juppy10/HV_BMS/Documents/Testing.txt

HV BMS Testing
- Thermals:
    - Power supply
    - Balance circuit

- isoSPI performance:
   - Measure trace impedance

- thermistor measurement calibration
