juppy10/HV_BMS/Hardware/BMS_Slave/Project Outputs for BMS Slave V0.1/W339323ASF8 working gerber file/W339323ASF8 working gerber file/Transcode Report.txt

   ---- Transcoding 'D:\Will\Documents\GitHub\HV_BMS\Hardware\BMS_Slave\Project Outputs for BMS Slave V0.1\W339323ASF8 working gerber file\W339323ASF8 working gerber file\bl' ----   Thu Apr  7 17:14:59 2022

D10   --> D100
D11   --> D101
D12   --> D102
-----------------------------------------------------------------

   ---- Transcoding 'D:\Will\Documents\GitHub\HV_BMS\Hardware\BMS_Slave\Project Outputs for BMS Slave V0.1\W339323ASF8 working gerber file\W339323ASF8 working gerber file\bs' ----   Thu Apr  7 17:14:59 2022

D10   --> D103
D11   --> D104
D12   --> D105
D13   --> D106
D14   --> D107
D15   --> D108
D16   --> D109
D17   --> D110
-----------------------------------------------------------------

   ---- Transcoding 'D:\Will\Documents\GitHub\HV_BMS\Hardware\BMS_Slave\Project Outputs for BMS Slave V0.1\W339323ASF8 working gerber file\W339323ASF8 working gerber file\drl' ----   Thu Apr  7 17:14:59 2022

D10   --> D111
D11   --> D112
-----------------------------------------------------------------

   ---- Transcoding 'D:\Will\Documents\GitHub\HV_BMS\Hardware\BMS_Slave\Project Outputs for BMS Slave V0.1\W339323ASF8 working gerber file\W339323ASF8 working gerber file\ko' ----   Thu Apr  7 17:14:59 2022

D10   --> D113
D11   --> D114
-----------------------------------------------------------------

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
D29   --> D189
D30   --> D190
D31   --> D191
D32   --> D192
D33   --> D193
D34   --> D194
D35   --> D195
D36   --> D196
D37   --> D197
D38   --> D198
D39   --> D199
D40   --> D200
D41   --> D201
D42   --> D202
D43   --> D203
-----------------------------------------------------------------
