juppy10/HV_BMS/Documents/8S BMS LHS.png

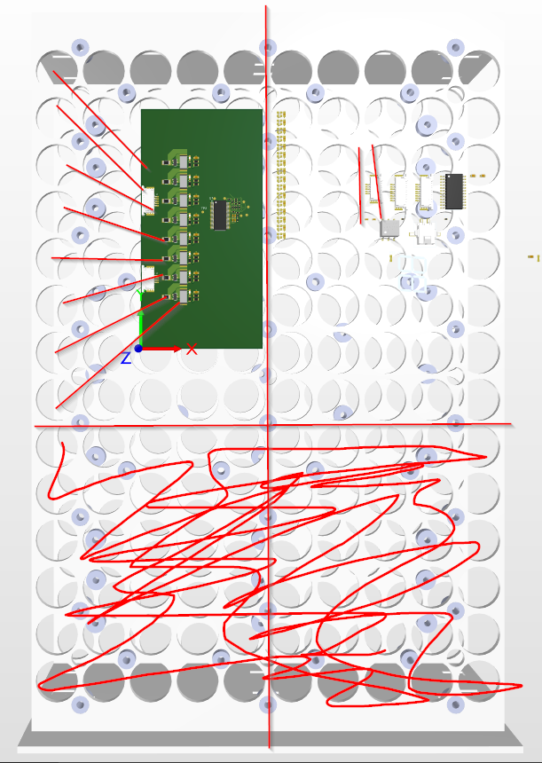
Documents/8S BMS LHS.png
