juppy10/HV_BMS/Documents/12S BMS.png

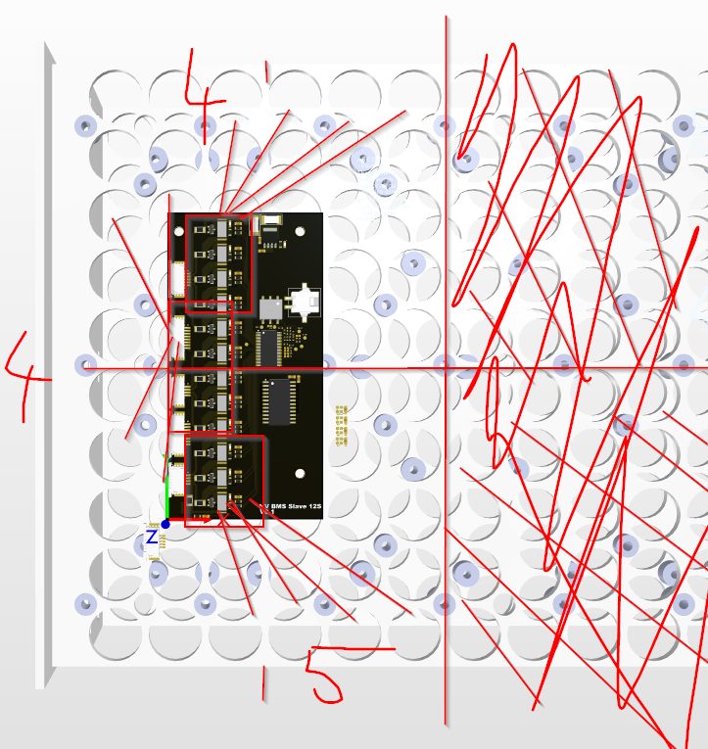
Documents/12S BMS.png
