juppy10/HV_BMS/Logging/2022-03-11 11_49_47-Logging – main.py.png

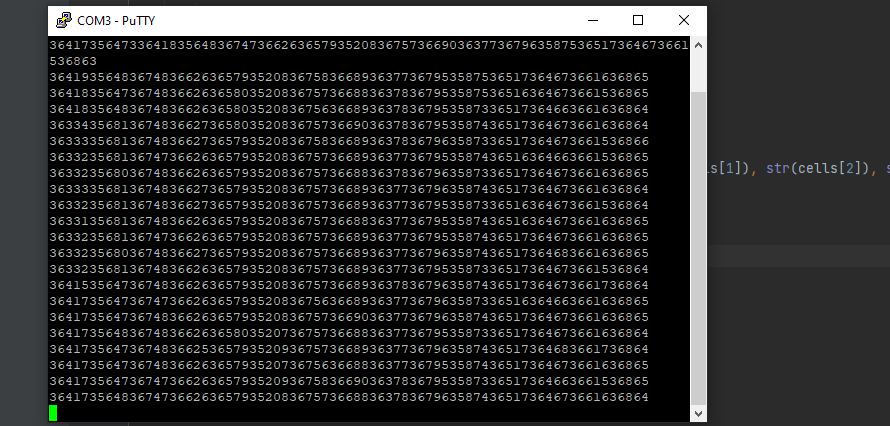
Logging/2022-03-11 11_49_47-Logging – main.py.png
