juppy10/HV_BMS/Bill of Materials - BMS Slave V0.1(Manufacture) - For AT&M.xlsx

Designator | Description | Footprint | Quantity | Value | Fitted | Mouser No | Mfr. No
C1, C11_Temperature Sensing 8S LHS, C11_Temperature Sensing 8S RHS, C14, C21, C28 | Multilayer Ceramic Capacitors MLCC - SMD/SMT .1UF 100V 10% 0402 | C_0402 | 6 | 100nF | Fitted | 81-GRM155R62A104KE4D | GRM155R62A104KE14D
C2, C5, C6, C12_Temperature Sensing 8S LHS, C12_Temperature Sensing 8S RHS, C15, C18, C19, C22, C25, C26, C29 | Multilayer Ceramic Capacitors MLCC - SMD/SMT 0402 16VDC 1uF 10% X5R | C_0402 | 12 | 1uF | Fitted | 963-EMK105BJ105KV-F | EMK105BJ105KV-F
C3, C4, C16, C17, C23, C24 | Multilayer Ceramic Capacitors MLCC - SMD/SMT .1UF 100V 10% 0402 | C_0402 | 0 | 100nF | Not Fitted | 81-GRM155R62A104KE4D | GRM155R62A104KE14D
C7, C8_Balance Circuit 8L1, C8_Balance Circuit 8L2, C8_Balance Circuit 8L3, C8_Balance Circuit 8L4, C8_Balance Circuit 8L5, C8_Balance Circuit 8L6, C8_Balance Circuit 8L7, C8_Balance Circuit 8L8, C8_Balance Circuit 8R1, C8_Balance Circuit 8R2, C8_Balance Circuit 8R3, C8_Balance Circuit 8R4, C8_Balance Circuit 8R5, C8_Balance Circuit 8R6, C8_Balance Circuit 8R7, C8_Balance Circuit 8R8, C8_Balance Circuit 121, C8_Balance Circuit 122, C8_Balance Circuit 123, C8_Balance Circuit 124, C8_Balance Circuit 125, C8_Balance Circuit 126, C8_Balance Circuit 127, C8_Balance Circuit 128, C8_Balance Circuit 129, C8_Balance Circuit 1210, C8_Balance Circuit 1211, C8_Balance Circuit 1212, C10_IsoSPI 8S LHS, C10_IsoSPI 8S RHS, C10_IsoSPI 12S, C13_NTC Sense 8S1, C13_NTC Sense 8S2, C13_NTC Sense 8S3, C13_NTC Sense 8S4, C13_NTC Sense 8S5, C13_NTC Sense 8S6, C13_NTC Sense 8S7, C13_NTC Sense 8S8, C13_NTC Sense 8S9, C13_NTC Sense 8S10, C13_NTC Sense 8S11, C13_NTC Sense 8S12, C13_NTC Sense 8S13, C13_NTC Sense 8S14, C13_NTC Sense 8S15, C13_NTC Sense 8S16, C13_NTC Sense 8S17, C13_NTC Sense 8S18, C13_NTC Sense 8S19, C13_NTC Sense 8S20, C13_NTC Sense 8S21, C13_NTC Sense 8S22, C13_NTC Sense 8S23, C13_NTC Sense 8S24, C13_NTC Sense 8S25, C13_NTC Sense 8S26, C13_NTC Sense 8S27, C13_NTC Sense 8S28, C13_NTC Sense 8S29, C13_NTC Sense 8S30, C13_NTC Sense 8S31, C13_NTC Sense 8S32, C13_NTC Sense 12S1, C13_NTC Sense 12S2, C13_NTC Sense 12S3, C13_NTC Sense 12S4, C13_NTC Sense 12S5, C13_NTC Sense 12S6, C13_NTC Sense 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 | Multilayer Ceramic Capacitors MLCC - SMD/SMT 0402 100V 0.01uF X7S 10% T: 0.5mm | C_0402 | 78 | 10nF | Fitted | 810-C1005X7S2A103K | C1005X7S2A103K050BB
C9_IsoSPI 8S LHS, C9_IsoSPI 8S RHS, C9_IsoSPI 12S | Multilayer Ceramic Capacitors MLCC - SMD/SMT WCAP-CSGP 15pF 0402 5% 16V MLCC | C_0402 | 3 | 15pF | Fitted | 710-885012005026 | 885012005026
D1, D3, D4 | Standard LEDs - SMD WL-SMCD SMD MonoChip 0603 Super Red 645nm | LED (0603) | 3 |  | Fitted | 710-150060SS55040 | 150060SS55040
D2_Balance Circuit 8L1, D2_Balance Circuit 8L2, D2_Balance Circuit 8L3, D2_Balance Circuit 8L4, D2_Balance Circuit 8L5, D2_Balance Circuit 8L6, D2_Balance Circuit 8L7, D2_Balance Circuit 8L8, D2_Balance Circuit 8R1, D2_Balance Circuit 8R2, D2_Balance Circuit 8R3, D2_Balance Circuit 8R4, D2_Balance Circuit 8R5, D2_Balance Circuit 8R6, D2_Balance Circuit 8R7, D2_Balance Circuit 8R8, D2_Balance Circuit 121, D2_Balance Circuit 122, D2_Balance Circuit 123, D2_Balance Circuit 124, D2_Balance Circuit 125, D2_Balance Circuit 126, D2_Balance Circuit 127, D2_Balance Circuit 128, D2_Balance Circuit 129, D2_Balance Circuit 1210, D2_Balance Circuit 1211, D2_Balance Circuit 1212 | Standard LEDs - SMD WL-SMCD SMD Mono SMD 0603 Blue 465nm | LED (0603) | 28 |  | Fitted | 710-150060BS55040 | 150060BS55040
F1, F2_Balance Circuit 8L1, F2_Balance Circuit 8L2, F2_Balance Circuit 8L3, F2_Balance Circuit 8L4, F2_Balance Circuit 8L5, F2_Balance Circuit 8L6, F2_Balance Circuit 8L7, F2_Balance Circuit 8L8, F2_Balance Circuit 8R1, F2_Balance Circuit 8R2, F2_Balance Circuit 8R3, F2_Balance Circuit 8R4, F2_Balance Circuit 8R5, F2_Balance Circuit 8R6, F2_Balance Circuit 8R7, F2_Balance Circuit 8R8, F2_Balance Circuit 121, F2_Balance Circuit 122, F2_Balance Circuit 123, F2_Balance Circuit 124, F2_Balance Circuit 125, F2_Balance Circuit 126, F2_Balance Circuit 127, F2_Balance Circuit 128, F2_Balance Circuit 129, F2_Balance Circuit 1210, F2_Balance Circuit 1211, F2_Balance Circuit 1212, F3, F4 | Surface Mount Fuses 63V .5A VFA Slimline | 0466.500NR | 31 |  | Fitted | 576-0466.500NR | 0466.500NR
J1, J2, J7, J8, J9, J10, J11, J12 | FFC & FPC Connectors 7P 1MM FPC Horz Top Cont. Assy | 84953-7 | 8 |  | Fitted | 571-84953-7 | 84953-7
J3 | Pin & Socket Connectors HDR ASSY 2 POS R/A SINGLE ROW TIN | TE_2-1445057-2 | 1 |  | Fitted | 571-2-1445057-2 | 2-1445057-2
J4_Temperature Sensing 8S LHS, J4_Temperature Sensing 8S RHS | FFC & FPC Connectors 1MM CONT ASSY 10P | 1-84953-0 | 2 |  | Fitted | 571-1-84953-0 | 1-84953-0
J5_Temperature Sensing 8S LHS, J5_Temperature Sensing 8S RHS | FFC & FPC Connectors 1MM CONT ASSY 8P HORIZONTAL TOP FPC | 84953-8 | 2 |  | Fitted | 571-84953-8 | 84953-8
Q1, Q3, Q4 | Bipolar Transistors - BJT NPN High Power BipolarTransistor | LFPAK56 (SOT669) | 3 |  | Fitted | 771-PHPT60603NY | PHPT60603NYX
Q2_Balance Circuit 8L1, Q2_Balance Circuit 8L2, Q2_Balance Circuit 8L3, Q2_Balance Circuit 8L4, Q2_Balance Circuit 8L5, Q2_Balance Circuit 8L6, Q2_Balance Circuit 8L7, Q2_Balance Circuit 8L8, Q2_Balance Circuit 8R1, Q2_Balance Circuit 8R2, Q2_Balance Circuit 8R3, Q2_Balance Circuit 8R4, Q2_Balance Circuit 8R5, Q2_Balance Circuit 8R6, Q2_Balance Circuit 8R7, Q2_Balance Circuit 8R8, Q2_Balance Circuit 121, Q2_Balance Circuit 122, Q2_Balance Circuit 123, Q2_Balance Circuit 124, Q2_Balance Circuit 125, Q2_Balance Circuit 126, Q2_Balance Circuit 127, Q2_Balance Circuit 128, Q2_Balance Circuit 129, Q2_Balance Circuit 1210, Q2_Balance Circuit 1211, Q2_Balance Circuit 1212 | MOSFET 20V P-channel Trench MOSFET | SOT95P230X110-3N | 28 |  | Fitted | 771-PMV65XPER | PMV65XPER
R1, R3, R27, R29, R45, R47 | Current Sense Resistors - SMD CHIP RESISTOR Low Value | R_2010 | 6 | 100 | Fitted | 652-CRM2010FX1000ELF | CRM2010-FX-1000ELF
R2, R28, R46 | Thick Film Resistors - SMD 1 MOhms 62.5mW 0402 5% | R_0402 | 3 | 1M | Fitted | 603-RC0402JR-071ML | RC0402JR-071ML
R4, R22_Balance Circuit 8L1, R22_Balance Circuit 8L2, R22_Balance Circuit 8L3, R22_Balance Circuit 8L4, R22_Balance Circuit 8L5, R22_Balance Circuit 8L6, R22_Balance Circuit 8L7, R22_Balance Circuit 8L8, R22_Balance Circuit 8R1, R22_Balance Circuit 8R2, R22_Balance Circuit 8R3, R22_Balance Circuit 8R4, R22_Balance Circuit 8R5, R22_Balance Circuit 8R6, R22_Balance Circuit 8R7, R22_Balance Circuit 8R8, R22_Balance Circuit 121, R22_Balance Circuit 122, R22_Balance Circuit 123, R22_Balance Circuit 124, R22_Balance Circuit 125, R22_Balance Circuit 126, R22_Balance Circuit 127, R22_Balance Circuit 128, R22_Balance Circuit 129, R22_Balance Circuit 1210, R22_Balance Circuit 1211, R22_Balance Circuit 1212, R30, R48 | Thick Film Resistors - SMD 1 kOhms 62.5mW 0402 1% | R_0402 | 31 | 1k | Fitted | 603-RC0402FR-071KL | RC0402FR-071KL
R5, R18, R31, R44, R49, R62 | Thick Film Resistors - SMD Zero Ohm 5% | R_0402 | 6 | 0 | Fitted | 652-CR0402-J/-000GLF | CR0402-J/-000GLF
R6, R10, R11, R12, R13, R14, R15, R16, R17, R32, R36, R37, R38, R39, R40, R41, R42, R43, R50, R54, R55, R56, R57, R58, R59, R60, R61 | Thick Film Resistors - SMD Zero Ohm 5% | R_0402 | 0 | 0 | Not Fitted | 652-CR0402-J/-000GLF | CR0402-J/-000GLF
R7, R33, R51 | Thick Film Resistors - SMD 1.21K OHM 1% | R_0402 | 3 | 1.21k | Fitted | 652-CR0402FX-1211GLF | CR0402-FX-1211GLF
R8, R34, R52 | Thick Film Resistors - SMD 2.8 kOhms 100 mW 0603 1% | R_0402 | 3 | 2.8k | Fitted | 603-RC0603FR-072K8L | RC0603FR-072K8L
R9, R19_Balance Circuit 8L1, R19_Balance Circuit 8L2, R19_Balance Circuit 8L3, R19_Balance Circuit 8L4, R19_Balance Circuit 8L5, R19_Balance Circuit 8L6, R19_Balance Circuit 8L7, R19_Balance Circuit 8L8, R19_Balance Circuit 8R1, R19_Balance Circuit 8R2, R19_Balance Circuit 8R3, R19_Balance Circuit 8R4, R19_Balance Circuit 8R5, R19_Balance Circuit 8R6, R19_Balance Circuit 8R7, R19_Balance Circuit 8R8, R19_Balance Circuit 121, R19_Balance Circuit 122, R19_Balance Circuit 123, R19_Balance Circuit 124, R19_Balance Circuit 125, R19_Balance Circuit 126, R19_Balance Circuit 127, R19_Balance Circuit 128, R19_Balance Circuit 129, R19_Balance Circuit 1210, R19_Balance Circuit 1211, R19_Balance Circuit 1212, R26_NTC Sense 8S1, R26_NTC Sense 8S2, R26_NTC Sense 8S3, R26_NTC Sense 8S4, R26_NTC Sense 8S5, R26_NTC Sense 8S6, R26_NTC Sense 8S7, R26_NTC Sense 8S8, R26_NTC Sense 8S9, R26_NTC Sense 8S10, R26_NTC Sense 8S11, R26_NTC Sense 8S12, R26_NTC Sense 8S13, R26_NTC Sense 8S14, R26_NTC Sense 8S15, R26_NTC Sense 8S16, R26_NTC Sense 8S17, R26_NTC Sense 8S18, R26_NTC Sense 8S19, R26_NTC Sense 8S20, R26_NTC Sense 8S21, R26_NTC Sense 8S22, R26_NTC Sense 8S23, R26_NTC Sense 8S24, R26_NTC Sense 8S25, R26_NTC Sense 8S26, R26_NTC Sense 8S27, R26_NTC Sense 8S28, R26_NTC Sense 8S29, R26_NTC Sense 8S30, R26_NTC Sense 8S31, R26_NTC Sense 8S32, R26_NTC Sense 12S1, R26_NTC Sense 12S2, R26_NTC Sense 12S3, R26_NTC Sense 12S4, R26_NTC Sense 12S5, R26_NTC Sense 12S6, R26_NTC Sense 12S7, R26_NTC Sense 12S8, 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 | Thick Film Resistors - SMD 100 Ohms 62.5mW 0402 1% | R_0402 | 76 | 100 | Fitted | 603-RC0402FR-07100RL | RC0402FR-07100RL
R20_Balance Circuit 8L1, R20_Balance Circuit 8L2, R20_Balance Circuit 8L3, R20_Balance Circuit 8L4, R20_Balance Circuit 8L5, R20_Balance Circuit 8L6, R20_Balance Circuit 8L7, R20_Balance Circuit 8L8, R20_Balance Circuit 8R1, R20_Balance Circuit 8R2, R20_Balance Circuit 8R3, R20_Balance Circuit 8R4, R20_Balance Circuit 8R5, R20_Balance Circuit 8R6, R20_Balance Circuit 8R7, R20_Balance Circuit 8R8, R20_Balance Circuit 121, R20_Balance Circuit 122, R20_Balance Circuit 123, R20_Balance Circuit 124, R20_Balance Circuit 125, R20_Balance Circuit 126, R20_Balance Circuit 127, R20_Balance Circuit 128, R20_Balance Circuit 129, R20_Balance Circuit 1210, R20_Balance Circuit 1211, R20_Balance Circuit 1212 | Thick Film Resistors - SMD 3.3 kOhms 62.5 mW 0402 1% AEC-Q200 | R_0402 | 28 | 3.3k | Fitted | 603-AC0402FR-073K3L | AC0402FR-073K3L
R21_Balance Circuit 8L1, R21_Balance Circuit 8L2, R21_Balance Circuit 8L3, R21_Balance Circuit 8L4, R21_Balance Circuit 8L5, R21_Balance Circuit 8L6, R21_Balance Circuit 8L7, R21_Balance Circuit 8L8, R21_Balance Circuit 8R1, R21_Balance Circuit 8R2, R21_Balance Circuit 8R3, R21_Balance Circuit 8R4, R21_Balance Circuit 8R5, R21_Balance Circuit 8R6, R21_Balance Circuit 8R7, R21_Balance Circuit 8R8, R21_Balance Circuit 121, R21_Balance Circuit 122, R21_Balance Circuit 123, R21_Balance Circuit 124, R21_Balance Circuit 125, R21_Balance Circuit 126, R21_Balance Circuit 127, R21_Balance Circuit 128, R21_Balance Circuit 129, R21_Balance Circuit 1210, R21_Balance Circuit 1211, R21_Balance Circuit 1212 | Current Sense Resistors - SMD 2watts 5% 22ohms 200 PPM 2512 | R_2512 | 28 | 21 | Fitted | 652-CRM2512-JW220ELF | CRM2512-JW-220ELF
R23_IsoSPI 8S LHS, R23_IsoSPI 8S RHS, R23_IsoSPI 12S, R64_IsoSPI 8S LHS, R64_IsoSPI 8S RHS, R64_IsoSPI 12S | Thick Film Resistors - SMD 22 Ohms 62.5 mW 0402 5% | R_0402 | 6 | 22 | Fitted | 603-RC0402JR-1322RL | RC0402JR-1322RL
R24_IsoSPI 8S LHS, R24_IsoSPI 8S RHS, R24_IsoSPI 12S | Thick Film Resistors - SMD 1/16watt 402ohms 1% Commercial Use | R_0402 | 3 | 402 | Fitted | 71-CRCW0402402RFKEDC | CRCW0402402RFKEDC
R25_NTC Sense 8S1, R25_NTC Sense 8S2, R25_NTC Sense 8S3, R25_NTC Sense 8S4, R25_NTC Sense 8S5, R25_NTC Sense 8S6, R25_NTC Sense 8S7, R25_NTC Sense 8S8, R25_NTC Sense 8S9, R25_NTC Sense 8S10, R25_NTC Sense 8S11, R25_NTC Sense 8S12, R25_NTC Sense 8S13, R25_NTC Sense 8S14, R25_NTC Sense 8S15, R25_NTC Sense 8S16, R25_NTC Sense 8S17, R25_NTC Sense 8S18, R25_NTC Sense 8S19, R25_NTC Sense 8S20, R25_NTC Sense 8S21, R25_NTC Sense 8S22, R25_NTC Sense 8S23, R25_NTC Sense 8S24, R25_NTC Sense 8S25, R25_NTC Sense 8S26, R25_NTC Sense 8S27, R25_NTC Sense 8S28, R25_NTC Sense 8S29, R25_NTC Sense 8S30, R25_NTC Sense 8S31, R25_NTC Sense 8S32, R25_NTC Sense 12S1, R25_NTC Sense 12S2, R25_NTC Sense 12S3, R25_NTC Sense 12S4, R25_NTC Sense 12S5, R25_NTC Sense 12S6, R25_NTC Sense 12S7, R25_NTC Sense 12S8, R25_NTC Sense 12S9, R25_NTC Sense 12S10, R25_NTC Sense 12S11, R25_NTC Sense 12S12 | Thick Film Resistors - SMD 10 kOhms 62.5 mW 0402 1% | R_0402 | 44 | 10k | Fitted | 603-RC0402FR-1310KL | RC0402FR-1310KL
R63 | Thick Film Resistors - SMD 1/10watt 51ohms 5% | R_0402 | 1 | 51 | Not Fitted | 71-CRCW060351R0JNEB | CRCW060351R0JNEB
T1_IsoSPI 8S LHS, T1_IsoSPI 8S RHS, T1_IsoSPI 12S | Audio Transformers / Signal Transformers BMS xformer 1-Ch 1000V AECQ +125 C | SM91502ALE | 3 |  | Fitted | 652-SM91502ALE | SM91502ALE
U1, U3, U4 |  | SSOP50P780X200-48N | 3 |  | Not Fitted |  | LTC6811-2
U2_Temperature Sensing 8S LHS, U2_Temperature Sensing 8S RHS, U5 | Multiplexer Switch ICs Hi-Spd CMOS 16Ch Anl Mltplxr/Demltplxr | SOIC127P1030X265-24N | 3 |  | Fitted | 595-CD74HC4067M96 | CD74HC4067M96
