juppy10/HV_BMS/Hardware/Accumulator Management System/Accumulator_MGMT_Sys-BOM.xlsx

BMS Master (AMS) V0.1 BOM
Part Number | Description | Designator | Footprint | Quantity
06035C103KAT4A | Capacitor | C1, C2 | C_0603 | 2
C0603C104K3RAC7013 | Capacitor | C3, C4, C5, C6, C7, C8, C9, C11, C13, C14, C16, C17, C28, C29, C32, C34, C35, C37, C38, C39, C40, C42_Vbat-3V31, C42_Vbat-3V32, C42_Vbat-3V33, C43_Latch Circuit1, C43_Latch Circuit2, C43_Latch Circuit3, C43_Latch Circuit4, C44_Latch Circuit1, C44_Latch Circuit2, C44_Latch Circuit3, C44_Latch Circuit4, C48 | C_0603 | 33
CL10A475KP8NNNL | Capacitor | C10 | C_0603 | 1
GCM1555C1H120FA16D | Capacitor | C12, C15 | 0402 | 2
CL10A105KP8NNNL | Capacitor | C18, C46 | C_0603 | 2
CL10A225KP8NNNC | Capacitor | C19, C36, C45, C47, C49 | C_0603 | 5
C0603C104K3RAC7013 | Capacitor | C20, C21, C22, C23, C24, C25, C26, C27, C30 | CAP0603 | 9
C0603C104K3RAC7013 | Capacitor | C31, C33 | 0402 | 2
885012206074 | Capacitor | C41_Vbat-3V31, C41_Vbat-3V32, C41_Vbat-3V33 | C_0603 | 3
150060BS55040 | LED BLUE DIFFUSED 0603 SMD | D1 | LED (0603) | 1
1N4148 | DIODE GEN PURP 100V 300MA SOD123 | D2, D7_Latch Circuit1, D7_Latch Circuit2, D7_Latch Circuit3, D7_Latch Circuit4 | 425 | 5
150060SS55040 | LED RED DIFFUSED 0603 SMD | D3, D8_Latch Circuit1, D8_Latch Circuit2, D8_Latch Circuit3, D8_Latch Circuit4 | LED (0603) | 5
SZNUP3105LT3G | TVS DIODE 32V 66V SOT23-3 | D4, D5 | FP-318-08-MFG | 2
150060GS55040 | LED GREEN DIFFUSED 0603 SMD | D6_Vbat-3V31, D6_Vbat-3V32, D6_Vbat-3V33 | LED (0603) | 3
74LVC1G373DBVRE4 | Integrated Circuit | IC1_Latch Circuit1, IC1_Latch Circuit2, IC1_Latch Circuit3, IC1_Latch Circuit4 | SN74LVC1G373 | 4
3-794632-2 | Micro MATE-N-LOK, Rectangular Power Connectors, Header, Plug, Wire-to-Board, 2 Position | J1 | 3-794632-2 | 1
UX60SC-MB-5ST(80) | Mini-B Connector, SMT Mount Receptacle Meeting Requirement of USB 2.0 Standard, 5 V, 1 A, -30 to 75 degC, 5-Pin SMD, RoHS, Tape and Reel | J2 | HIRO-UX60SC-MB-5ST(80)_V | 1
3-794632-4 | Conn Power HDR 4 POS 3mm Solder ST Thru-Hole 4 Terminal 1 Port Box/Tray | J3, J4, J5 | 3-794632-4 | 3
PCN-112D3MHZ | Relay | K1_Latch Circuit1, K1_Latch Circuit2, K1_Latch Circuit3, K1_Latch Circuit4 | PCN-112D3MHZ | 4
4-794632-0 | Connector | P3, P5 | SHDR10W82P300_2X5_1586X686X944P | 2
4-794632-4 | Micro MATE-N-LOK, Rectangular Power Connectors, Header, Plug, Wire-to-Board, 14 Position | P69 | 4-794632-4 | 1
BSS138BK,215 | N-Channel Trench MOSFET, 60 V, 0.36 A, -55 to 150 degC, 3-Pin SOT23, Tape and Reel | Q1, Q2_Latch Circuit1, Q2_Latch Circuit2, Q2_Latch Circuit3, Q2_Latch Circuit4, Q3_Latch Circuit1, Q3_Latch Circuit2, Q3_Latch Circuit3, Q3_Latch Circuit4, Q4_Latch Circuit1, Q4_Latch Circuit2, Q4_Latch Circuit3, Q4_Latch Circuit4 | NXP-SOT23_N | 13
CRCW060351R0JNEA | Resistor | R1, R2 | R-0603 | 2
RC0603FR-072K8L | Resistor | R3 | R-0603 | 1
AC0603FR-071K21L | Resistor | R4 | R-0603 | 1
AC0603JR-100RL | Resistor | R5, R6, R41 | R-0603 | 3
CR0603AFX-5101EAS | Resistor | R7, R9, R11, R13 | R-0603 | 4
CR0603AFX-1001ELF | Resistor | R8, R10, R12, R14, R18, R50_Vbat-3V31, R50_Vbat-3V32, R50_Vbat-3V33, R55_Latch Circuit1, R55_Latch Circuit2, R55_Latch Circuit3, R55_Latch Circuit4 | R-0603 | 12
RC0603FR-1310KL | Resistor | R15, R16, R29, R31, R32, R33, R34, R35, R36, R37, R38, R42, R43, R44, R49, R51_Latch Circuit1, R51_Latch Circuit2, R51_Latch Circuit3, R51_Latch Circuit4, R53_Latch Circuit1, R53_Latch Circuit2, R53_Latch Circuit3, R53_Latch Circuit4, R54_Latch Circuit1, R54_Latch Circuit2, R54_Latch Circuit3, R54_Latch Circuit4 | R-0603 | 27
RN73C1J7K15BTDF | Resistor | R19 | RESC1608X55N | 1
RC0603FR-1310KL | Resistor | R20, R21, R22, R23, R26 | RESC1608X55N | 5
CR0603AFX-5101EAS | Resistor | R24 | RESC1608X55N | 1
CRCW0603-220K-E3 | Resistor | R25 | RESC1608X55N | 1
CRCW060336K5FKEAC | Resistor | R27 | RESC1608X55N | 1
RC0603FR-071K78L | Resistor | R28 | R-0603 | 1
CR0603-FX-4220ELF | Resistor | R30 | R-0603 | 1
CRT0402-DY-1001GLF | Resistor | R39, R40 | R_0402 | 2
CRCW080560R4FKEA | Resistor | R45, R46, R47, R48 | R-0603 | 4
RC0805JR-07510RL | Resistor | R52_Latch Circuit1, R52_Latch Circuit2, R52_Latch Circuit3, R52_Latch Circuit4 | R_0805 | 4
CRCW2512649RFKEG | Resistor | R56_Latch Circuit1, R56_Latch Circuit2, R56_Latch Circuit3, R56_Latch Circuit4 | RESC6332X06N | 4
Resistor | Resistor | R57 | R-0603 | 1
SM91502ALE | BMS XFORMER 1-CH 1000V AECQ +125 | T1 | SM91502ALE | 1
LTC6820HMS#PBF | IC COMM INTERFACE ISOSPI 16MSOP | U1 | MSOP-16_MS | 1
USBLC6-2SC6 | TVS DIODE 5.25V 17V SOT23-6 | U2 | USBLC6-2SC6 | 1
STM32F446RE | 32 Bit Microcontroller, High Performance, ARM Cortex-M4, 180 MHz, 256 KB, 128 KB, 64, LQFP | U3 | QFP50P1200X1200X160-64N | 1
SN65LVDT2DBVT | IC RECEIVER 0/1 SOT23-5 | U4 | FP-DBV0005A-MFG | 1
MCP6542-I/SN | Push-Pull Output Sub-Microamp Comparator, 8-Pin SOIC, Industrial Temperature | U5 | SOIC-SN8_N | 1
SN74LVC1G08MDBVREP | Integrated Circuit | U6 | SOT95P280X145-5N | 1
NC7SZ00M5X | NAND GATE | U7 | SOT95P280X125-5N | 1
NC7S32M5X | OR GATE | U8, U17_Latch Circuit1, U17_Latch Circuit2, U17_Latch Circuit3, U17_Latch Circuit4 | SOT95P275X110-5N | 5
MAX810STRG | Integrated Circuit | U9 | SOT96P237X111-3N | 1
TLC3704QDRG4Q1 | IC VOLT COMPARATOR QUAD 14-SOIC | U10 | SOIC127P600X175-14N | 1
SN74HC7032D | Quadruple Positive-OR Gates With Schmitt-Trigger Inputs, D0014A, TUBE | U11 | D0014A_L | 1
LT1461ACS8-3 | Integrated Circuit | U12 | SO-8_S | 1
ADC122S625CIMM/NOPB | Analog to Digital Converters - ADC Dual 50kSPS-200kSPS 12B ADC | U13 | TSSOP50P490X110-10N | 1
SN65HVD233D | 3.3V CAN Transceiver with Standby Mode, Loop-back, 6 mA, -40 to 125 degC, 8-pin SOIC (D), Green (RoHS & no Sb/Br) | U14, U15 | D0008A_N | 2
ZSR330GTA | Standard Regulator Pos 3.3V 0.2A 4-Pin(3+Tab) SOT-223 T/R | U16_Vbat-3V31, U16_Vbat-3V32, U16_Vbat-3V33 | ZSR330GTA | 3
BD33C0AHFP-CTR | LDO Voltage Regulators 35V RESIS 1A LDO REGULATOR | U18 | HRP5 | 1
CX2016DB26000D0FLJCC | Resistor | Y1 | CX2016DB26000D0FLJCC | 1
