juppy10/HV_BMS/Hardware/Accumulator Management System/AMS BOM.xlsx

Sheet: Chad Mouser
Designation | Part Number | Desciption | Amount | Supplier | Notes | Link
U1 | LD2981CU50TR | 5V 100mA voltage regulator | 1 | STM |  | https://au.mouser.com/ProductDetail/STMicroelectronics/LD2981CU50TR/
U2 | ADM3054 | Isolated CAN Bus | 1 | Analog Device |  | https://au.mouser.com/ProductDetail/Analog-Devices/ADM3054WBRWZ-RL7/?qs=hpwIUhX6lWyxOIONWK5kPg%3D%3D
U3 | EC4A02HS | Isolated 12V power Supply | 1 | Cincon |  | https://au.mouser.com/ProductDetail/Cincon/EC4A02HS-E/
U4 | LDS3985M33R | 3.3V 300mA voltage regulator | 1 | STM |  | https://au.mouser.com/ProductDetail/STMicroelectronics/LDS3985M33R/?qs=DcAdhm6iCnom47SfkNYeVw%3D%3D
U5 | STM32F105R8T6 | Micro Controller Boi | 1 | STM | On Order RIP | STM32F105R8T6 STMicroelectronics | Mouser Australia (https://au.mouser.com/ProductDetail/STMicroelectronics/STM32F105R8T6/?qs=1XJIe8X6XT24MwoK4mjh%2Fg%3D%3D)
U6 | SN65HVD233D | CAN Bus | 1 | Texas Instr | Expected 8/2/21 | https://au.mouser.com/ProductDetail/Texas-Instruments/SN65HVD233D/?qs=QViXGNcIEAs7Wm0sxTzQdQ%3D%3D
U7 | SN65LVDT2 | Low Voltage Differential Signal Receiver | 1 | Texas Instr |  | https://au.mouser.com/ProductDetail/Texas-Instruments/SN65LVDT2DBVR/
U8 | MCP6542-I/SN | Op-Amp | 1 | Microchip Tech |  | https://au.mouser.com/ProductDetail/Microchip-Technology/MCP6542-I-SN/?qs=wPbeaPfwU9%2FerIyOzLws1A%3D%3D
U9 | NC7S02M5X | NOR gate | 1 | ON Semicon |  | https://au.mouser.com/ProductDetail/ON-Semiconductor-Fairchild/NC7S02M5X/
U10 | NC7SZ00M5X | NAND Gate | 1 | ON Semicon |  | https://au.mouser.com/ProductDetail/ON-Semiconductor-Fairchild/NC7SZ00M5X/
U11/U12 | NC7S32M5X | OR Gate | 2 | ON Semicon |  | https://au.mouser.com/ProductDetail/ON-Semiconductor-Fairchild/NC7S32M5X/
U13 | SN74LVC32ADR | 4 Channel 2 Input OR Gate | 1 | Texas Instr |  | https://au.mouser.com/ProductDetail/Texas-Instruments/SN74LVC32ADR/?qs=NLW4NjXEBS7KFLqI%2FYoHOA%3D%3D
U19 | SN74HC7032D | 4 Channel 2 Input OR Gate w/ Schmitt | 1 | Texas Instr |  | https://au.mouser.com/ProductDetail/Texas-Instruments/SN74HC7032D/?qs=0le1rQK8zxqllE59uuKGIA%3D%3D
U14/U15 | CD74HC75M96 | Latching Boi | 2 | Texas Instr |  | https://au.mouser.com/ProductDetail/Texas-Instruments/CD74HC75M96/?qs=xFfolx0DHx0kPXrLnxAsXQ%3D%3D
U16 | SN74HCS21QDRQ1 | 4 Channel 2 Input AND Gate | 1 | Texas Instr |  | https://au.mouser.com/ProductDetail/Texas-Instruments/SN74HCS21QDRQ1/
U17 | MAX810STRG | Voltage Supervisor | 1 | ON Semicon |  | https://au.mouser.com/ProductDetail/ON-Semiconductor/MAX810STRG/?qs=3JMERSakeboivPwVvtOnqA%3D%3D
U18 | TLC3704QDRG4Q1 | 4 Channel Comparithor | 1 | Texas Instr |  | https://au.mouser.com/ProductDetail/Texas-Instruments/TLC3704QDRG4Q1/?qs=pZC5fsuWujGhd9C3ekhqyg%3D%3D
C1 | C0603C105K3PACTU | 1uF | 2 | Kemet |  | https://au.mouser.com/ProductDetail/KEMET/C0603C105K3PACTU/?qs=STjISULpmtalQKXy67%252B4Cg%3D%3D
C2 | GRM188R61E475KE11D | 4.7uF | 3 | Murata |  | https://au.mouser.com/ProductDetail/Murata-Electronics/GRM188R61E475KE11D/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
C4 | GRM188R71E474KA12J | 0.47uF | 3 | Murata |  | https://au.mouser.com/ProductDetail/Murata-Electronics/GRM188R71E474KA12J/?qs=F8tACvfZmvjUv2vuW4F4kA%3D%3D
C7 | C0603C104K3RAC7081 | 0.1uF | 21 | Kemet |  | https://au.mouser.com/ProductDetail/KEMET/C0603C104K3RAC7081/
C12 | C0603C150K5RAC7867 | 15pF | 2 | Kemet |  | https://au.mouser.com/ProductDetail/KEMET/C0603C150K5RAC7867/?qs=u16ybLDytRYyS%252BK6zP9D6g%3D%3D
R1 | CRCW080560R4FKEA | 60.4R | 4 | Vishay |  | https://au.mouser.com/ProductDetail/Vishay-Dale/CRCW080560R4FKEA/?qs=EhwKGB4UJfmgIuuxZMLDtw%3D%3D
R3 | CRCW0805680RFKEA | 680R | 3 | Vishay |  | https://au.mouser.com/ProductDetail/Vishay-Dale/CRCW0805680RFKEA/?qs=QtIOgScU7%252BuxOLKfMWa%2F2g%3D%3D
R4 | CRCW060310K0FKEA | 10K | 8 | Vishay |  | https://au.mouser.com/ProductDetail/Vishay-Dale/CRCW060310K0FKEA/?qs=pAO1Z172M84BVnhDjtnsoQ%3D%3D
R10 | CRCW06033K24FKEA | 3.24K | 1 | Vishay |  | https://au.mouser.com/ProductDetail/Vishay-Dale/CRCW06033K24FKEA/?qs=N2XN0KY4UWXLwGUF6QHgWQ%3D%3D
R14 | CRCW0603220KFKEA | 220k | 1 | Vishay |  | https://au.mouser.com/ProductDetail/Vishay-Dale/CRCW0603220KFKEA/?qs=pVi9qluBdEGy7pbAV1jqkQ%3D%3D
R15 | CRCW060336K5FKEA | 36.5K | 2 | Vishay |  | https://au.mouser.com/ProductDetail/Vishay-Dale/CRCW060336K5FKEA/?qs=Q5Ogy3HFkM1EBinAZLgMDQ%3D%3D
R17 | CRCW06038K06FKEA | 8.06k | 2 | Vishay |  | https://au.mouser.com/ProductDetail/Vishay-Dale/CRCW06038K06FKEA/?qs=MdlGoGBrZVkh0qPQeABdqA%3D%3D
R18 | CRCW06031K91FKEA | 1.91k | 2 | Vishay |  | https://au.mouser.com/ProductDetail/Vishay-Dale/CRCW06031K91FKEA/
R23 | CRCW2512649RFKEG | 649R | 8 | Vishay |  | https://au.mouser.com/ProductDetail/Vishay-Dale/CRCW2512649RFKEG/?qs=WpL82mpZNv%2FAFRgdjHDmGQ%3D%3D
R25 | CRCW1206191RFKEA | 191R | 1 | Vishay |  | https://au.mouser.com/ProductDetail/Vishay-Dale/CRCW1206191RFKEA/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
R33 | CRCW08051K58FKEA | 1.58k | 4 | Vishay |  | https://au.mouser.com/ProductDetail/Vishay-Dale/CRCW08051K58FKEA/
P1 | 2-1445093-6 | 6 Pin Connector | 1 | TE Con |  | https://au.mouser.com/ProductDetail/TE-Connectivity-AMP/2-1445093-6/
P2 | 4-794632-0 | 10 Pin Connector | 3 | TE Con |  | https://au.mouser.com/ProductDetail/TE-Connectivity-AMP/4-794632-0/
P5 | FTSH-105-01-F-DV-K | Debug Port | 1 | SamTec |  | https://au.mouser.com/ProductDetail/Samtec/FTSH-105-01-F-DV-K/?qs=iT52DjcXudtFjikTq7rIdg%3D%3D
D1 | ESDCAN03-2BWY | ESDCAN03-2BWY | 2 | STM |  | https://au.mouser.com/ProductDetail/STMicroelectronics/ESDCAN03-2BWY/
D2 | 150080GS75000 | Green LED | 2 | Wurth |  | https://au.mouser.com/ProductDetail/Wurth-Elektronik/150080GS75000/
D3 | 150080RS75000 | Red LED | 1 | Wurth |  | https://au.mouser.com/ProductDetail/Wurth-Elektronik/150080RS75000/
D6 | 150120SS75000 | RED LED | 4 | Wurth |  | https://au.mouser.com/ProductDetail/Wurth-Elektronik/150120SS75000/
D7 | 1N4148W-7-F | Fast Switching Diode | 1 | Diodes Inc |  | 1N4148W-7-F Diodes Incorporated | Mouser Australia (https://au.mouser.com/ProductDetail/Diodes-Incorporated/1N4148W-7-F/?qs=LHX0FizJzg7Ae9ZM8LTAWw%3D%3D)
F1 | 0461.500ER | 600V 500mA Fuse | 2 | LittelFuse |  | https://au.mouser.com/ProductDetail/Littelfuse/0461500ER/?qs=vco6xy%252BeH1osMhpXurJZ9g%3D%3D
Q1 | BC848W,135 | NPN Transistor | 1 | Nexperia |  | https://au.mouser.com/ProductDetail/Nexperia/BC848W135/?qs=me8TqzrmIYUHpZxYr7f48w%3D%3D
Q4 | BSS138BK215 | N-CH Mosfet | 5 | Nexperia |  | https://au.mouser.com/ProductDetail/Nexperia/BSS138BK215/?qs=A1cBxND5mHIu7uZeHkM5Xw%3D%3D
Y1 | FA-128 16.0000MF10Z-W | Crystal Ball | 1 | Epson Timing |  | https://au.mouser.com/ProductDetail/Epson-Timing/FA-128-160000MF10Z-W?qs=f9yNj16SXrLg1f6cZ0OOTg%3D%3D

Sheet: Virgin Digikey
Designation | Part Number | Desciption | Amount | Supplier | Notes | Link
U1 | LD2981CU50TR | 5V 100mA voltage regulator | 1 | STM |  | https://www.digikey.com.au/product-detail/en/stmicroelectronics/LD2981CU50TR/497-3484-1-ND/669304
U2 | ADM3054 | Isolated CAN Bus | 1 | Analog Device |  | https://www.digikey.com.au/product-detail/en/analog-devices-inc/ADM3054WBRWZ-RL7/ADM3054WBRWZ-RL7CT-ND/5957828
U3 | EC4A02HS | Isolated 12V power Supply | 1 | Cincon |  | https://www.digikey.com.au/product-detail/en/cincon-electronics-co-ltd/EC4A02H-E/2034-1686-ND/9682939
U4 | LDS3985M33R | 3.3V 300mA voltage regulator | 1 | STM |  | https://www.digikey.com.au/product-detail/en/stmicroelectronics/LDS3985M33R/497-4257-1-ND/725540
U5 | STM32F105R8T6 | Micro Controller Boi | 1 | STM | Not in Stocc | https://www.digikey.com.au/product-detail/en/stmicroelectronics/STM32F105R8T6TR/497-18765-1-ND/9958426
U6 | SN65HVD233D | CAN Bus | 1 | Texas Instr | Not in Stocc | https://www.digikey.com.au/product-detail/en/texas-instruments/SN65HVD233DRG4/296-52700-1-ND/9860236
U7 | SN65LVDT2 | Low Voltage Differential Signal Receiver | 1 | Texas Instr |  | https://www.digikey.com.au/product-detail/en/texas-instruments/SN65LVDT2DBVR/296-6896-1-ND/371534
U8 | MCP6542-I/SN | Op-Amp | 1 | Microchip Tech |  | https://www.digikey.com.au/products/en?keywords=MCP6542-I%2FSN
U9 | NC7S02M5X | NOR gate | 1 | ON Semicon |  | https://www.digikey.com.au/product-detail/en/on-semiconductor/NC7S02M5X/NC7S02M5XCT-ND/673379
U10 | NC7SZ00M5X | NAND Gate | 1 | ON Semicon |  | https://www.digikey.com.au/product-detail/en/on-semiconductor/NC7SZ00M5X/NC7SZ00M5XCT-ND/673385
U11/U12 | NC7S32M5X | OR Gate | 2 | ON Semicon |  | https://www.digikey.com.au/product-detail/en/on-semiconductor/NC7SZ00M5X/NC7SZ00M5XCT-ND/673385
U13 | SN74LVC32ADR | 4 Channel 2 Input OR Gate | 1 | Texas Instr |  | https://www.digikey.com.au/product-detail/en/texas-instruments/SN74LVC32ADR/296-1235-1-ND/276503
U19 | SN74HC7032D | 4 Channel 2 Input OR Gate w/ Schmitt | 1 | Texas Instr |  | https://www.digikey.com.au/product-detail/en/texas-instruments/SN74HC7032D/296-8367-5-ND/376839
U14/U15 | CD74HC75M96 | Latching Boi | 2 | Texas Instr |  | https://www.digikey.com.au/product-detail/en/texas-instruments/CD74HC75M96/296-CD74HC75M96CT-ND/12318959
U16 | SN74HCS21QDRQ1 | 4 Channel 2 Input AND Gate | 1 | Texas Instr |  | https://www.digikey.com.au/product-detail/en/texas-instruments/SN74HCS21QDRQ1/296-SN74HCS21QDRQ1CT-ND/12165762
U17 | MAX810STRG | Voltage Supervisor | 1 | ON Semicon |  | https://www.digikey.com.au/product-detail/en/on-semiconductor/MAX810STRG/MAX810STRGOSCT-ND/2120693
U18 | TLC3704QDRG4Q1 | 4 Channel Comparithor | 1 | Texas Instr |  | https://www.digikey.com.au/product-detail/en/texas-instruments/TLC3704QDRQ1/296-17830-1-ND/724177
C1 | C0603C105K3PACTU | 1uF | 1 | Kemet |  | https://www.digikey.com.au/product-detail/en/kemet/C0603C105K3PACTU/399-7846-1-ND/3471569
C2 | GRM188R61E475KE11D | 4.7uF | 3 | Murata |  | https://www.digikey.com.au/product-detail/en/murata-electronics/GRM188R61E475KE11D/490-7203-1-ND/3900450
C4 | GRM188R71E474KA12J | 0.47uF | 3 | Murata |  | https://www.digikey.com.au/product-detail/en/murata-electronics/GRM188R71E474KA12J/490-6432-1-ND/3845629
C7 | C0603C104K3RAC7081 | 0.1uF | 21 | Kemet |  | https://www.digikey.com.au/product-detail/en/kemet/C0603C104K3RAC7081/399-C0603C104K3RAC7081DKR-ND/12702046
C12 | C0603C150K5RAC7867 | 15pF | 2 | Kemet |  | https://www.digikey.com.au/product-detail/en/kemet/C0603C150K5RAC7867/399-20391-1-ND/9924995
R1 | CRCW080560R4FKEA | 60.4R | 4 | Vishay |  | https://www.digikey.com.au/product-detail/en/vishay-dale/CRCW080560R4FKEA/541-60-4CCT-ND/1180644
R3 | CRCW0805680RFKEA | 680R | 3 | Vishay |  | https://www.digikey.com.au/product-detail/en/vishay-dale/CRCW0805680RFKEAC/541-CRCW0805680RFKEACCT-ND/12744776
R4 | CRCW060310K0FKEA | 10K | 8 | Vishay |  | https://www.digikey.com.au/product-detail/en/vishay-dale/CRCW060310K0FKEA/541-10-0KHCT-ND/1179924
R10 | CRCW06033K24FKEA | 3.24K | 1 | Vishay |  | https://www.digikey.com.au/product-detail/en/vishay-dale/CRCW06033K24FKEA/541-3-24KHCT-ND/1179865
R14 | CRCW0603220KFKEA | 220k | 1 | Vishay |  | https://www.digikey.com.au/product-detail/en/vishay-dale/CRCW0603220KFKEA/541-220KHCT-ND/1180074
R15 | CRCW060336K5FKEA | 36.5K | 2 | Vishay |  | https://www.digikey.com.au/product-detail/en/vishay-dale/CRCW060336K5FKEAHP/541-CRCW060336K5FKEAHPCT-ND/12342462
R17 | CRCW06038K06FKEA | 8.06k | 2 | Vishay |  | https://www.digikey.com.au/product-detail/en/vishay-dale/CRCW06038K06FKEAC/541-5582-1-ND/9461351
R18 | CRCW06031K91FKEA | 1.91k | 2 | Vishay |  | https://www.digikey.com.au/product-detail/en/vishay-dale/CRCW06031K91FKEA/541-1-91KHCT-ND/1179839
R23 | CRCW2512649RFKEG | 649R | 8 | Vishay |  | https://www.digikey.com.au/product-detail/en/vishay-dale/CRCW2512649RFKEG/541-649AFCT-ND/1178745
R25 | CRCW1206191RFKEA | 191R | 1 | Vishay |  | https://www.digikey.com.au/product-detail/en/vishay-dale/CRCW1206191RFKEA/541-191FCT-ND/1181676
R33 | CRCW08051K58FKEA | 1.58k | 4 | Vishay |  | https://www.digikey.com.au/product-detail/en/vishay-dale/CRCW08051K58FKEA/541-1-58KCCT-ND/1180803
P1 | 2-1445093-6 | 6 Pin Connector | 1 | TE Con |  | https://www.digikey.com.au/products/en?keywords=2-1445093-6
P2 | 4-794632-0 | 10 Pin Connector | 3 | TE Con |  | https://www.digikey.com.au/products/en?keywords=4-794632-0
P5 | FTSH-105-01-F-DV-K | Debug Port | 1 | SamTec |  | https://www.digikey.com.au/product-detail/en/samtec-inc/FTSH-105-01-F-DV-K/SAM8796-ND/2649974
D1 | ESDCAN03-2BWY | ESDCAN03-2BWY | 2 | STM |  | https://www.digikey.com.au/product-detail/en/stmicroelectronics/ESDCAN03-2BWY/497-15846-1-ND/5305256
D2 | 150080GS75000 | Green LED | 2 | Wurth |  | https://www.digikey.com.au/product-detail/en/w%C3%BCrth-elektronik/150080GS75000/732-4983-1-ND/4489913
D3 | 150080RS75000 | Red LED | 1 | Wurth |  | https://www.digikey.com.au/product-detail/en/w%C3%BCrth-elektronik/150080RS75000/732-4984-1-ND/4489916
D6 | 150120SS75000 | RED LED | 4 | Wurth |  | https://www.digikey.com.au/product-detail/en/w%C3%BCrth-elektronik/150120SS75000/732-4992-1-ND/4489940
D7 | 1N4148W-7-F | Fast Switching Diode | 1 | Diodes Inc |  | https://www.digikey.com.au/product-detail/en/diodes-incorporated/1N4148W-7-F/1N4148W-FDICT-ND/815280
F1 | 0461.500ER | 600V 500mA Fuse | 2 | LittelFuse |  | https://www.digikey.com.au/product-detail/en/littelfuse-inc/0461-500ER/F1449CT-ND/388175
Q1 | BC848W,135 | NPN Transistor | 1 | Nexperia |  | https://www.digikey.com.au/products/en?keywords=BC848W%2C135
Q4 | BSS138BK215 | N-CH Mosfet | 5 | Nexperia |  | https://www.digikey.com.au/product-detail/en/nexperia-usa-inc/BSS138BK-215/1727-1141-1-ND/4162470
Y1 | FA-128 16.0000MF10Z-W | Crystal Ball | 1 | Epson Timing |  | https://www.digikey.com.au/products/en?keywords=FA-128%2016.0000MF10Z-W

Sheet: Donkey RS
Designation | Part Number | Desciption | Amount | Supplier | Notes | Link
U1 | LD2981CU50TR | 5V 100mA voltage regulator | 1 | STM |  | https://au.rs-online.com/web/p/low-dropout-voltage-regulators/6868849/
U2 | ADM3054 | Isolated CAN Bus | 1 | Analog Device |  | https://au.rs-online.com/web/p/can-interface-ics/7968984/
U3 | EC4A02HS | Isolated 12V power Supply | 1 | Cincon |  | Does Not Exist
U4 | LDS3985M33R | 3.3V 300mA voltage regulator | 1 | STM |  | LDS3985M33R | STMicroelectronics LDS3985M33R, LDO Regulator, 300mA, 3.3 V 5-Pin, SOT-23 | RS Components (rs-online.com) (https://au.rs-online.com/web/p/low-dropout-voltage-regulators/8805323/)
U5 | STM32F105R8T6 | Micro Controller Boi | 1 | STM | Back order until 8Feb | STM32F105R8T6 | STMicroelectronics STM32F105R8T6, 32bit ARM Cortex M3 Microcontroller, STM32F, 72MHz, 64 kB Flash, 64-Pin LQFP | RS Components (rs-online.com) (https://au.rs-online.com/web/p/microcontrollers/7249687/)
U6 | SN65HVD233D | CAN Bus | 1 | Texas Instr |  | SN65HVD233D | Texas Instruments SN65HVD233D, CAN Transceiver 1Mbps ISO 11898, 8-Pin SOIC | RS Components (rs-online.com) (https://au.rs-online.com/web/p/can-interface-ics/0526896/)
U7 | SN65LVDT2 | Low Voltage Differential Signal Receiver | 1 | Texas Instr |  | SN65LVDT2DBVR | Texas Instruments SN65LVDT2DBVR, LVDS Transceiver, 5-Pin SOT-23 | RS Components (rs-online.com) (https://au.rs-online.com/web/p/lvds-interface-ics/6608265/)
U8 | MCP6542-I/SN | Op-Amp | 1 | Microchip Tech |  | MCP6542-I/SN | MCP6542-I/SN Microchip, Dual Comparator, Push-Pull O/P, 1.6 → 5.5 V 8-Pin SOIC | RS Components (rs-online.com) (https://au.rs-online.com/web/p/comparators/0402954/)
U9 | NC7S02M5X | NOR gate | 1 | ON Semicon |  | NC7S02M5X | ON Semiconductor NC7S02M5X 2-Input NOR Logic Gate, 5-Pin SOT-23 | RS Components (rs-online.com) (https://au.rs-online.com/web/p/logic-gates/6709750/)
U10 | NC7SZ00M5X | NAND Gate | 1 | ON Semicon |  | NC7SZ00M5X | ON Semiconductor NC7SZ00M5X 2-Input NAND Logic Gate, 5-Pin SOT-23 | RS Components (rs-online.com) (https://au.rs-online.com/web/p/logic-gates/7390127/)
U11/U12 | NC7S32M5X | OR Gate | 2 | ON Semicon |  | NC7S32M5X | ON Semiconductor NC7S32M5X 2-Input OR Logic Gate, 5-Pin SOT-23 | RS Components (rs-online.com) (https://au.rs-online.com/web/p/logic-gates/6709772/)
U13 | SN74LVC32ADR | 4 Channel 2 Input OR Gate | 1 | Texas Instr |  | SN74LVC32ADR | Texas Instruments SN74LVC32ADR, Quad 2-Input OR Logic Gate, 14-Pin SOIC | RS Components (rs-online.com) (https://au.rs-online.com/web/p/logic-gates/6628994/)
U19 | SN74HC7032D | 4 Channel 2 Input OR Gate w/ Schmitt | 1 | Texas Instr |  | SN74HC7032D | Texas Instruments SN74HC7032D, Quad 2-Input OR Schmitt Trigger Logic Gate, 14-Pin SOIC | RS Components (rs-online.com) (https://au.rs-online.com/web/p/logic-gates/6632212/)
U14/U15 | CD74HC75M96 | Latching Boi | 2 | Texas Instr |  | CD74HC74M96 | Texas Instruments CD74HC74M96 Dual D Type Flip Flop IC, 2 → 6 V, 14-Pin SOIC | RS Components (rs-online.com) (https://au.rs-online.com/web/p/flip-flop-ics/6627193/)
U16 | SN74HCS21QDRQ1 | 4 Channel 2 Input AND Gate | 1 | Texas Instr |  | SN74HC21D | Texas Instruments SN74HC21D, Dual 4-Input AND Logic Gate, 14-Pin SOIC | RS Components (rs-online.com) (https://au.rs-online.com/web/p/logic-gates/6632013/)
U17 | MAX810STRG | Voltage Supervisor | 1 | ON Semicon |  | Does Not Exist
U18 | TLC3704QDRG4Q1 | 4 Channel Comparithor | 1 | Texas Instr |  | TLC3704IDR | TLC3704IDR Texas Instruments, Quad Comparator, Push-Pull O/P, 2.7μs 5 V 14-Pin SOIC | RS Components (rs-online.com) (https://au.rs-online.com/web/p/comparators/6612680/)
C1 | C0603C105K3PACTU | 1uF | 2 | Kemet |  | https://au.rs-online.com/web/p/mlccs-multilayer-ceramic-capacitors/6911133
C2 | GRM188R61E475KE11D | 4.7uF | 3 | Murata |  | https://au.rs-online.com/web/cp/1449031,8151386,8151386P/?pst=GRM188R61E475KE11D&sra=p
C4 | GCM188R71E474KA64D | 0.47uF | 3 | Murata |  | https://au.rs-online.com/web/p/mlccs-multilayer-ceramic-capacitors/7234985
C7 | C0603C104K3RAC7081 | 0.1uF | 21 | Kemet |  | https://au.rs-online.com/web/p/mlccs-multilayer-ceramic-capacitors/1372797
C12 | C0603C150J5GACTU | 15pF | 2 | Kemet |  | https://au.rs-online.com/web/p/mlccs-multilayer-ceramic-capacitors/0147421/
R1 | CRCW080560R4FKEA | 60.4R | 4 | Vishay |  | https://au.rs-online.com/web/p/surface-mount-fixed-resistors/6791597
R3 | CRCW0805680RFKEA | 680R | 3 | Vishay |  | https://au.rs-online.com/web/p/surface-mount-fixed-resistors/6791614
R4 | CRCW060310K0FKEAHP | 10K | 8 | Vishay |  | https://au.rs-online.com/web/p/surface-mount-fixed-resistors/8206742
R10 | CRCW06033K24FKEA | 3.24K | 1 | Vishay |  | CRCW06033K24FKEA | Vishay 3.24kΩ, 0603 (1608M) Thick Film SMD Resistor ±1% 0.1W - CRCW06033K24FKEA | RS Components (rs-online.com) (https://au.rs-online.com/web/p/surface-mount-fixed-resistors/6790302)
R14 | CRCW0603220KFKEA | 220k | 1 | Vishay |  | https://au.rs-online.com/web/p/surface-mount-fixed-resistors/6789986
R15 | CRCW060336K5FKEA | 36.5K | 2 | Vishay |  | https://au.rs-online.com/web/p/surface-mount-fixed-resistors/6790260
R17 | CRCW06038K06FKEA | 8.06k | 2 | Vishay |  | https://au.rs-online.com/web/p/surface-mount-fixed-resistors/6790740
R18 | ERA3AEB1911V | 1.91k | 2 | Panasonic |  | https://au.rs-online.com/web/p/surface-mount-fixed-resistors/7087515
R23 | CRCW2512680RFKEG | 649R | 8 | Vishay | 680R | https://au.rs-online.com/web/p/surface-mount-fixed-resistors/6792459/
R25 | CRCW1206196RFKEA | 191R | 1 | Vishay |  | CRCW1206196RFKEA | Vishay 196Ω, 1206 (3216M) Thick Film SMD Resistor ±1% 0.25W - CRCW1206196RFKEA | RS Components (rs-online.com) (https://au.rs-online.com/web/p/surface-mount-fixed-resistors/6791847/)
R33 | CPF0805B1K58E1 | 1.58k | 4 | TE Connectivity |  | https://au.rs-online.com/web/p/surface-mount-fixed-resistors/1231691
P1 | 2-1445093-6 | 6 Pin Connector | 1 | TE Con |  | Does Not Exist
P2 | 4-794632-0 | 10 Pin Connector | 3 | TE Con |  | Does Not Exist
P5 | FTSH-105-01-F-DV-K | Debug Port | 1 | SamTec |  | FTSH-105-01-F-DV-K | Samtec, FTSH, 10 Way, 2 Row, Straight Pin Header | RS Components (rs-online.com) (https://au.rs-online.com/web/p/pcb-headers/1592372/)
D1 | ESDCAN03-2BWY | ESDCAN03-2BWY | 2 | STM |  | ESDCAN03-2BWY | STMicroelectronics ESDCAN03-2BWY, Dual-Element Bi-Directional TVS Diode, 250W, 3-Pin SOT-323 | RS Components (rs-online.com) (https://au.rs-online.com/web/p/tvs-diodes/1241110/)
D2 | 150080GS75000 | Green LED | 2 | Wurth |  | 150080GS75000 | 3.2 V Green LED 2012 (0805) SMD, Wurth Elektronik WL-SMCW 150080GS75000 | RS Components (rs-online.com) (https://au.rs-online.com/web/p/leds/8154221/)
D3 | 150080RS75000 | Red LED | 1 | Wurth |  | 150080RS75000 | 2 V Red LED 2012 (0805) SMD, Wurth Elektronik WL-SMCW 150080RS75000 | RS Components (rs-online.com) (https://au.rs-online.com/web/p/leds/8154225/)
D6 | 150120SS75000 | RED LED | 4 | Wurth |  | 150120AS75000 | 2 V Amber LED 3216 (1206) SMD, Wurth Elektronik WL-SMCW 150120AS75000 | RS Components (rs-online.com) (https://au.rs-online.com/web/p/leds/8154240/)
D7 | 1N4148W-7-F | Fast Switching Diode | 1 | Diodes Inc |  | 1N4148W-7-F | Diodes Inc Switching Diode, 300mA 100V, 2-Pin SOD-123 1N4148W-7-F | RS Components (rs-online.com) (https://au.rs-online.com/web/p/switching-diodes/7384728/)
F1 | 0461.500ER | 600V 500mA Fuse | 2 | LittelFuse |  | 0461.500ER | Littelfuse 500mA Non-Resettable Surface Mount Fuse, 600V | RS Components (rs-online.com) (https://au.rs-online.com/web/p/non-resettable-surface-mount-fuses/7382970/)
Q1 | BC848W,135 | NPN Transistor | 1 | Nexperia |  | BC848W | Nexperia BC848W NPN Transistor, 100 mA, 30 V, 3-Pin SOT-323 | RS Components (rs-online.com) (https://au.rs-online.com/web/p/bipolar-transistors/8167726/)
Q4 | BSS138BK215 | N-CH Mosfet | 5 | Nexperia |  | BSS138BK,215 | N-Channel MOSFET, 360 mA, 60 V, 3-Pin SOT-23 Nexperia BSS138BK,215 | RS Components (rs-online.com) (https://au.rs-online.com/web/p/mosfets/7920894/)
Y1 | FA-128 16.0000MF10Z-W | Crystal Ball | 1 | Epson Timing |  | Does Not Exist
