juppy10/HV_BMS/Hardware/BMS_Slave/Project Outputs for BMS Slave V0.1/BOM/BOM/Bill of Materials-BMS Slave V0.1(Manufacture) - Thesis.xlsx

BMS SLAVE V0.1 BOM
Part Number | Description | Quantity | Footprint | Designator
GRM155R62A104KE14D | Capacitor | 6 | C_0402 | C1, C11, C14, C21, C28
EMK105BJ105KV-F | Capacitor | 12 | C_0402 | C2, C5, C6, C12, C15, C18, C19, C22, C25, C26, C29
GRM155R62A104KE14D | Capacitor | 0 | C_0402 | C3, C4, C16, C17, C23, C24
C1005X7S2A103M050BB | Capacitor | 78 | C_0402 | C7, C8, C10, C13, C20, C27
885012005026 | Capacitor | 3 | C_0402 | C9
150060SS55040 | LED RED DIFFUSED 0603 SMD | 3 | LED (0603) | D1, D3, D4
150060BS55040 | LED BLUE DIFFUSED 0603 SMD | 28 | LED (0603) | D2
0466.500NR | Fuse, Surface Mount, 500 mA, 63 VDC, Very Fast Acting, 1206 | 31 | 0466.500NR | F1, F2, F3, F4
84953-7 | FPC Connectors, Flex-to-Board, 7 Position | 8 | 84953-7 | J1, J2, J7, J8, J9, J10, J11, J12
2-1445057-2 | CONN HEADER 3MM 2POS R/A TIN SMD | 1 | TE_2-1445057-2 | J3
84953-9 | FPC Connectors, Flex-to-Board, 9 Position | 4 | 84953-9 | J4, J5
PHPT60603NYX | 60V, 3 A NPN high power bipolar transistor | 3 | LFPAK56 (SOT669) | Q1, Q3, Q4
NX2301PVL | MOSFET 20V P-Channel 2A | 28 | SOT95P230X110-3N | Q2
CRM2010-FX-1000ELF | Resistor | 6 | R_2010 | R1, R3, R27, R29, R45, R47
RC0402JR-071ML | Resistor | 3 | R_0402 | R2, R28, R46
RC0402FR-071KL | Resistor | 31 | R_0402 | R4, R22, R30, R48
CR0402-J/-000GLF | Resistor | 6 | R_0402 | R5, R18, R31, R44, R49, R62
CR0402-J/-000GLF | Resistor | 0 | R_0402 | R6, R10, R11, R12, R13, R14, R15, R16, R17, R32, R36, R37, R38, R39, R40, R41, R42, R43, R50, R54, R55, R56, R57, R58, R59, R60, R61
CR0402-FX-1211GLF | Resistor | 3 | R_0402 | R7, R33, R51
RC0603FR-072K8L | Resistor | 3 | R_0402 | R8, R34, R52
RC0402FR-07100RL | Resistor | 75 | R_0402 | R9, R19, R26, R35, R53
AC0402FR-073K3L | Resistor | 28 | R_0402 | R20
CRM2512-JW-220ELF | Resistor | 28 | R_2512 | R21
SR0402JR-0722RL | Resistor | 6 | R_0402 | R23, R64
CRCW0402402RFKEDC | Resistor | 3 | R_0402 | R24
RC0402FR-1310KL | Resistor | 44 | R_0402 | R25
CRCW060351R0JNEA | Resistor | 1 | R_0402 | R63
SM91502ALE | BMS XFORMER 1-CH 1000V AECQ +125 | 3 | SM91502ALE | T1
LTC6811-2 | 12 Channel Multicell Battery Monitor | 3 | SSOP50P780X200-48N | U1, U3, U4
CD74HC4067M96 | 16-Channel Analog Multiplexer/Demultiplexer | 3 | SOIC127P1030X265-24N | U2, U5
