juppy10/HV_BMS/Documents/Balance Circuit placement.xlsx

Sheet: Sheet1
Dy | 7.7 | X1 (mm) | Y1 (mm) | Height (mm) | Locked | Designator | Show Designator | Component Comment | Show Comment | Lock Strings | Component Type | Footprint | Channel Offset | Rotation
Dx | 0 | 28.463 | 12.475 | 0 | FALSE | R6_BC1 | FALSE | RT0603DRE07583RL | FALSE | FALSE | Standard | R-0603 | 7 | 360
 |  | 34.775 | 15.383 | 0 | FALSE | R5_BC1 | FALSE | CRCW251221R0FKEGHP | FALSE | FALSE | Standard | R_2512 | 6 | 180
 |  | 41.275 | 14.575 | 0 | FALSE | R4_BC1 | FALSE | Resistor | FALSE | FALSE | Standard | R-0603 | 5 | 360
 |  | 41.275 | 16.35 | 0 | FALSE | R3_BC1 | FALSE | Resistor | FALSE | FALSE | Standard | R-0603 | 4 | 360
 |  | 38.425 | 15.475 | 0 | FALSE | Q1_BC1 | FALSE | NX2301P,215 | FALSE | FALSE | Standard | FP-SOT23-MFG | 3 | 270
 |  | 33.787 | 12.475 | 0 | FALSE | D1_BC1 | FALSE | 150060BS55040 | FALSE | FALSE | Standard | LED (0603) | 1 | 360
 |  | 46.025 | 16.35 | 0 | FALSE | C5_BC1 | FALSE | C | FALSE | FALSE | Standard | C_0603 | 0 | 180
 |  | X1 (mm) | Y1 (mm) | Height (mm) | Locked | Designator | Show Designator | Component Comment | Show Comment | Lock Strings | Component Type | Footprint | Channel Offset | Rotation
 |  | 28.463 | 20.175 |  |  | R6 |  |  |  |  |  |  |  | 360
 |  | 34.775 | 23.083 |  |  | R5 |  |  |  |  |  |  |  | 180
 |  | 41.275 | 22.275 |  |  | R4 |  |  |  |  |  |  |  | 360
 |  | 41.275 | 24.05 |  |  | R3 |  |  |  |  |  |  |  | 360
 |  | 38.425 | 23.175 |  |  | Q1 |  |  |  |  |  |  |  | 270
 |  | 33.787 | 20.175 |  |  | D1 |  |  |  |  |  |  |  | 360
 |  | 46.025 | 24.05 |  |  | C5 |  |  |  |  |  |  |  | 180

Sheet: Balance Circuit
X1 (mm) | Y1 (mm) | Height (mm) | Locked | Designator | Show Designator | Component Comment | Show Comment | Lock Strings | Component Type | Footprint | Channel Offset | Rotation |  | ODD
26.9 | 82.3 |  |  | R6_BC14 | FALSE |  |  |  |  |  |  | 270 | R6_BC14 | X1 (mm) | Y1 (mm) | Height (mm) | Locked | Designator | Show Designator | Component Comment | Show Comment | Lock Strings | Component Type | Footprint | Channel Offset | Rotation
26.9 | 76.9 |  |  | R6_BC13 | FALSE |  |  |  |  |  |  | 270 | R6_BC13 | 26.9 | 12.1 | 0 | FALSE | R6_BC1 | FALSE | RT0603DRE07583RL | FALSE | FALSE | Standard | R-0603 | 7 | 270
26.9 | 71.5 |  |  | R6_BC12 | FALSE |  |  |  |  |  |  | 270 | R6_BC12 | 34.775 | 11.183 | 0 | FALSE | R5_BC1 | FALSE | CRCW251221R0FKEGHP | FALSE | FALSE | Standard | R_2512 | 6 | 180
26.9 | 66.1 |  |  | R6_BC11 | FALSE |  |  |  |  |  |  | 270 | R6_BC11 | 41.275 | 10.375 | 0 | FALSE | R4_BC1 | FALSE | Resistor | FALSE | FALSE | Standard | R-0603 | 5 | 360
26.9 | 60.7 |  |  | R6_BC10 | FALSE |  |  |  |  |  |  | 270 | R6_BC10 | 41.275 | 12.15 | 0 | FALSE | R3_BC1 | FALSE | Resistor | FALSE | FALSE | Standard | R-0603 | 4 | 360
26.9 | 55.3 |  |  | R6_BC9 | FALSE |  |  |  |  |  |  | 270 | R6_BC9 | 38.425 | 11.275 | 0 | FALSE | Q1_BC1 | FALSE | NX2301P,215 | FALSE | FALSE | Standard | FP-SOT23-MFG | 3 | 270
26.9 | 49.9 |  |  | R6_BC8 | FALSE |  |  |  |  |  |  | 270 | R6_BC8 | 24.8 | 11 | 0 | FALSE | D1_BC1 | FALSE | 150060BS55040 | FALSE | FALSE | Standard | LED (0603) | 1 | 270
26.9 | 44.5 |  |  | R6_BC7 | FALSE |  |  |  |  |  |  | 270 | R6_BC7 | 46.025 | 12.15 | 0 | FALSE | C5_BC1 | FALSE | C | FALSE | FALSE | Standard | C_0603 | 0 | 180
26.9 | 39.1 |  |  | R6_BC6 | FALSE |  |  |  |  |  |  | 270 | R6_BC6
26.9 | 33.7 |  |  | R6_BC5 | FALSE |  |  |  |  |  |  | 270 | R6_BC4 | EVEN
26.9 | 28.3 |  |  | R6_BC4 | FALSE |  |  |  |  |  |  | 270 | R6_BC3 | X1 (mm) | Y1 (mm) | Height (mm) | Locked | Designator | Show Designator | Component Comment | Show Comment | Lock Strings | Component Type | Footprint | Channel Offset | Rotation
26.9 | 22.9 |  |  | R6_BC3 | FALSE |  |  |  |  |  |  | 270 | R6_BC2 | 24.913 | 69.075 | 0 | FALSE | R6_BC1 | FALSE | RT0603DRE07583RL | FALSE | FALSE | Standard | R-0603 | 7 | 360
26.9 | 17.5 |  |  | R6_BC2 | FALSE |  |  |  |  |  |  | 270 | R6_BC1 | 31.225 | 71.983 | 0 | FALSE | R5_BC1 | FALSE | CRCW251221R0FKEGHP | FALSE | FALSE | Standard | R_2512 | 6 | 180
26.9 | 12.1 |  |  | R6_BC1 | FALSE |  |  |  |  |  |  | 270 | R5_BC14 | 37.725 | 71.175 | 0 | FALSE | R4_BC1 | FALSE | Resistor | FALSE | FALSE | Standard | R-0603 | 5 | 360
34.775 | 81.383 |  |  | R5_BC14 | FALSE |  |  |  |  |  |  | 180 | R5_BC13 | 37.725 | 72.95 | 0 | FALSE | R3_BC1 | FALSE | Resistor | FALSE | FALSE | Standard | R-0603 | 4 | 360
34.775 | 75.983 |  |  | R5_BC13 | FALSE |  |  |  |  |  |  | 180 | R5_BC12 | 34.875 | 72.075 | 0 | FALSE | Q1_BC1 | FALSE | NX2301P,215 | FALSE | FALSE | Standard | FP-SOT23-MFG | 3 | 270
34.775 | 70.583 |  |  | R5_BC12 | FALSE |  |  |  |  |  |  | 180 | R5_BC11 | 30.237 | 69.075 | 0 | FALSE | D1_BC1 | FALSE | 150060BS55040 | FALSE | FALSE | Standard | LED (0603) | 1 | 360
34.775 | 65.183 |  |  | R5_BC11 | FALSE |  |  |  |  |  |  | 180 | R5_BC10 | 42.475 | 72.95 | 0 | FALSE | C5_BC1 | FALSE | C | FALSE | FALSE | Standard | C_0603 | 0 | 180
34.775 | 59.783 |  |  | R5_BC10 | FALSE |  |  |  |  |  |  | 180 | R5_BC9
34.775 | 54.383 |  |  | R5_BC9 | FALSE |  |  |  |  |  |  | 180 | R5_BC8
34.775 | 48.983 |  |  | R5_BC8 | FALSE |  |  |  |  |  |  | 180 | R5_BC7 | Dy | 5.4
34.775 | 43.583 |  |  | R5_BC7 | FALSE |  |  |  |  |  |  | 180 | R5_BC6 | Dx | 0
34.775 | 38.183 |  |  | R5_BC6 | FALSE |  |  |  |  |  |  | 180 | R5_BC4
34.775 | 32.783 |  |  | R5_BC5 | FALSE |  |  |  |  |  |  | 180 | R5_BC3
34.775 | 27.383 |  |  | R5_BC4 | FALSE |  |  |  |  |  |  | 180 | R5_BC2
34.775 | 21.983 |  |  | R5_BC3 | FALSE |  |  |  |  |  |  | 180 | R5_BC1
34.775 | 16.583 |  |  | R5_BC2 | FALSE |  |  |  |  |  |  | 180 | R4_BC14 |  |  |  |  |  |  |  |  |  |  | 26.9 | 12.1 | 0 | FALSE | R6_BC2 | FALSE | RT0603DRE07583RL | FALSE | FALSE | Standard | R-0603 | 7 | 270
34.775 | 11.183 |  |  | R5_BC1 | FALSE |  |  |  |  |  |  | 180 | R4_BC13 |  |  |  |  |  |  |  |  |  |  | 34.775 | 11.183 | 0 | FALSE | R5_BC2 | FALSE | CRCW251221R0FKEGHP | FALSE | FALSE | Standard | R_2512 | 6 | 180
41.275 | 80.575 |  |  | R4_BC14 | FALSE |  |  |  |  |  |  | 360 | R4_BC12 |  |  |  |  |  |  |  |  |  |  | 41.275 | 10.375 | 0 | FALSE | R4_BC2 | FALSE | Resistor | FALSE | FALSE | Standard | R-0603 | 5 | 360
41.275 | 75.175 |  |  | R4_BC13 | FALSE |  |  |  |  |  |  | 360 | R4_BC11 |  |  |  |  |  |  |  |  |  |  | 41.275 | 12.15 | 0 | FALSE | R3_BC2 | FALSE | Resistor | FALSE | FALSE | Standard | R-0603 | 4 | 360
41.275 | 69.775 |  |  | R4_BC12 | FALSE |  |  |  |  |  |  | 360 | R4_BC10 |  |  |  |  |  |  |  |  |  |  | 38.425 | 11.275 | 0 | FALSE | Q1_BC2 | FALSE | NX2301P,215 | FALSE | FALSE | Standard | FP-SOT23-MFG | 3 | 270
41.275 | 64.375 |  |  | R4_BC11 | FALSE |  |  |  |  |  |  | 360 | R4_BC9 |  |  |  |  |  |  |  |  |  |  | 24.8 | 11 | 0 | FALSE | D1_BC2 | FALSE | 150060BS55040 | FALSE | FALSE | Standard | LED (0603) | 1 | 270
41.275 | 58.975 |  |  | R4_BC10 | FALSE |  |  |  |  |  |  | 360 | R4_BC8 |  |  |  |  |  |  |  |  |  |  | 46.025 | 12.15 | 0 | FALSE | C5_BC2 | FALSE | C | FALSE | FALSE | Standard | C_0603 | 0 | 180
41.275 | 53.575 |  |  | R4_BC9 | FALSE |  |  |  |  |  |  | 360 | R4_BC7
41.275 | 48.175 |  |  | R4_BC8 | FALSE |  |  |  |  |  |  | 360 | R4_BC6
41.275 | 42.775 |  |  | R4_BC7 | FALSE |  |  |  |  |  |  | 360 | R4_BC4
41.275 | 37.375 |  |  | R4_BC6 | FALSE |  |  |  |  |  |  | 360 | R4_BC3
41.275 | 31.975 |  |  | R4_BC5 | FALSE |  |  |  |  |  |  | 360 | R4_BC2
41.275 | 26.575 |  |  | R4_BC4 | FALSE |  |  |  |  |  |  | 360 | R4_BC1
41.275 | 21.175 |  |  | R4_BC3 | FALSE |  |  |  |  |  |  | 360 | R3_BC14
41.275 | 15.775 |  |  | R4_BC2 | FALSE |  |  |  |  |  |  | 360 | R3_BC13
41.275 | 10.375 |  |  | R4_BC1 | FALSE |  |  |  |  |  |  | 360 | R3_BC12
41.275 | 82.35 |  |  | R3_BC14 | FALSE |  |  |  |  |  |  | 360 | R3_BC11
41.275 | 76.95 |  |  | R3_BC13 | FALSE |  |  |  |  |  |  | 360 | R3_BC10
41.275 | 71.55 |  |  | R3_BC12 | FALSE |  |  |  |  |  |  | 360 | R3_BC9
41.275 | 66.15 |  |  | R3_BC11 | FALSE |  |  |  |  |  |  | 360 | R3_BC8
41.275 | 60.75 |  |  | R3_BC10 | FALSE |  |  |  |  |  |  | 360 | R3_BC7
41.275 | 55.35 |  |  | R3_BC9 | FALSE |  |  |  |  |  |  | 360 | R3_BC6
41.275 | 49.95 |  |  | R3_BC8 | FALSE |  |  |  |  |  |  | 360 | R3_BC4
41.275 | 44.55 |  |  | R3_BC7 | FALSE |  |  |  |  |  |  | 360 | R3_BC3
41.275 | 39.15 |  |  | R3_BC6 | FALSE |  |  |  |  |  |  | 360 | R3_BC2
41.275 | 33.75 |  |  | R3_BC5 | FALSE |  |  |  |  |  |  | 360 | R3_BC1
41.275 | 28.35 |  |  | R3_BC4 | FALSE |  |  |  |  |  |  | 360 | Q1_BC14
41.275 | 22.95 |  |  | R3_BC3 | FALSE |  |  |  |  |  |  | 360 | Q1_BC13
41.275 | 17.55 |  |  | R3_BC2 | FALSE |  |  |  |  |  |  | 360 | Q1_BC12
41.275 | 12.15 |  |  | R3_BC1 | FALSE |  |  |  |  |  |  | 360 | Q1_BC11
38.425 | 81.475 |  |  | Q1_BC14 | FALSE |  |  |  |  |  |  | 270 | Q1_BC10
38.425 | 76.075 |  |  | Q1_BC13 | FALSE |  |  |  |  |  |  | 270 | Q1_BC9
38.425 | 70.675 |  |  | Q1_BC12 | FALSE |  |  |  |  |  |  | 270 | Q1_BC8
38.425 | 65.275 |  |  | Q1_BC11 | FALSE |  |  |  |  |  |  | 270 | Q1_BC7
38.425 | 59.875 |  |  | Q1_BC10 | FALSE |  |  |  |  |  |  | 270 | Q1_BC6
38.425 | 54.475 |  |  | Q1_BC9 | FALSE |  |  |  |  |  |  | 270 | Q1_BC4
38.425 | 49.075 |  |  | Q1_BC8 | FALSE |  |  |  |  |  |  | 270 | Q1_BC3
38.425 | 43.675 |  |  | Q1_BC7 | FALSE |  |  |  |  |  |  | 270 | Q1_BC2
38.425 | 38.275 |  |  | Q1_BC6 | FALSE |  |  |  |  |  |  | 270 | Q1_BC1
38.425 | 32.875 |  |  | Q1_BC5 | FALSE |  |  |  |  |  |  | 270
38.425 | 27.475 |  |  | Q1_BC4 | FALSE |  |  |  |  |  |  | 270
38.425 | 22.075 |  |  | Q1_BC3 | FALSE |  |  |  |  |  |  | 270
38.425 | 16.675 |  |  | Q1_BC2 | FALSE |  |  |  |  |  |  | 270
38.425 | 11.275 |  |  | Q1_BC1 | FALSE |  |  |  |  |  |  | 270
24.8 | 81.2 |  |  | D1_BC14 | FALSE |  |  |  |  |  |  | 270
24.8 | 75.8 |  |  | D1_BC13 | FALSE |  |  |  |  |  |  | 270 | D1_BC14
24.8 | 70.4 |  |  | D1_BC12 | FALSE |  |  |  |  |  |  | 270 | D1_BC13
24.8 | 65 |  |  | D1_BC11 | FALSE |  |  |  |  |  |  | 270 | D1_BC12
24.8 | 59.6 |  |  | D1_BC10 | FALSE |  |  |  |  |  |  | 270 | D1_BC11
24.8 | 54.2 |  |  | D1_BC9 | FALSE |  |  |  |  |  |  | 270 | D1_BC10
24.8 | 48.8 |  |  | D1_BC8 | FALSE |  |  |  |  |  |  | 270 | D1_BC9
24.8 | 43.4 |  |  | D1_BC7 | FALSE |  |  |  |  |  |  | 270 | D1_BC8
24.8 | 38 |  |  | D1_BC6 | FALSE |  |  |  |  |  |  | 270 | D1_BC7
24.8 | 32.6 |  |  | D1_BC5 | FALSE |  |  |  |  |  |  | 270 | D1_BC6
24.8 | 27.2 |  |  | D1_BC4 | FALSE |  |  |  |  |  |  | 270 | D1_BC4
24.8 | 21.8 |  |  | D1_BC3 | FALSE |  |  |  |  |  |  | 270 | D1_BC3
24.8 | 16.4 |  |  | D1_BC2 | FALSE |  |  |  |  |  |  | 270 | D1_BC2
24.8 | 11 |  |  | D1_BC1 | FALSE |  |  |  |  |  |  | 270 | D1_BC1
46.025 | 82.35 |  |  | C5_BC14 | FALSE |  |  |  |  |  |  | 180 | C5_BC14
46.025 | 76.95 |  |  | C5_BC13 | FALSE |  |  |  |  |  |  | 180 | C5_BC13
46.025 | 71.55 |  |  | C5_BC12 | FALSE |  |  |  |  |  |  | 180 | C5_BC12
46.025 | 66.15 |  |  | C5_BC11 | FALSE |  |  |  |  |  |  | 180 | C5_BC11
46.025 | 60.75 |  |  | C5_BC10 | FALSE |  |  |  |  |  |  | 180 | C5_BC10
46.025 | 55.35 |  |  | C5_BC9 | FALSE |  |  |  |  |  |  | 180 | C5_BC9
46.025 | 49.95 |  |  | C5_BC8 | FALSE |  |  |  |  |  |  | 180 | C5_BC8
46.025 | 44.55 |  |  | C5_BC7 | FALSE |  |  |  |  |  |  | 180 | C5_BC7
46.025 | 39.15 |  |  | C5_BC6 | FALSE |  |  |  |  |  |  | 180 | C5_BC6
46.025 | 33.75 |  |  | C5_BC5 | FALSE |  |  |  |  |  |  | 180 | C5_BC4
46.025 | 28.35 |  |  | C5_BC4 | FALSE |  |  |  |  |  |  | 180 | C5_BC3
46.025 | 22.95 |  |  | C5_BC3 | FALSE |  |  |  |  |  |  | 180 | C5_BC2
46.025 | 17.55 |  |  | C5_BC2 | FALSE |  |  |  |  |  |  | 180 | C5_BC1
46.025 | 12.15 |  |  | C5_BC1 | FALSE |  |  |  |  |  |  | 180

Sheet: AFE
X1 (mm) | Y1 (mm) | Height (mm) | Locked | Designator | Show Designator | Component Comment | Show Comment | Lock Strings | Component Type | Footprint | Channel Offset | Rotation | X1 (mm) | Y1 (mm) | Height (mil) | Locked | Designator | Show Designator | Component Comment | Show Comment | Lock Strings | Component Type | Footprint | Channel Offset | Rotation
14.375 | 173.325 |  |  | C22_AFE1 | FALSE |  |  |  |  |  |  | 360 | 14.375 | 173.325 | 0 | FALSE | C22_AFE1 | FALSE | C | FALSE | FALSE | Standard | C_0603 | 0 | 270
14.375 | 170.075 |  |  | C22_AFE2 | FALSE |  |  |  |  |  |  | 360 | 11.4 | 173.325 | 0 | FALSE | R21_AFE1 | FALSE | CRT0603-BY-1002EST | FALSE | FALSE | Standard | R-0603 | 1 | 360
14.375 | 166.825 |  |  | C22_AFE3 | FALSE |  |  |  |  |  |  | 360 | 11.4 | 171.75 | 0 | FALSE | R22_AFE1 | FALSE | Resistor | FALSE | FALSE | Standard | R-0603 | 2 | 360
14.375 | 163.575 |  |  | C22_AFE4 | FALSE |  |  |  |  |  |  | 360
14.375 | 160.325 |  |  | C22_AFE5 | FALSE |  |  |  |  |  |  | 360
14.375 | 157.075 |  |  | C22_AFE6 | FALSE |  |  |  |  |  |  | 360 | Dx | 0
14.375 | 153.825 |  |  | C22_AFE7 | FALSE |  |  |  |  |  |  | 360 | Dy | -3.25
14.375 | 150.575 |  |  | C22_AFE8 | FALSE |  |  |  |  |  |  | 360
14.375 | 147.325 |  |  | C22_AFE9 | FALSE |  |  |  |  |  |  | 360
14.375 | 144.075 |  |  | C22_AFE10 | FALSE |  |  |  |  |  |  | 360
14.375 | 140.825 |  |  | C22_AFE11 | FALSE |  |  |  |  |  |  | 360
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
11.4 | 103.5 |  |  | R22_AFE22 | FALSE |  |  |  |  |  |  | 270
11.4 | 100.25 |  |  | R22_AFE23 | FALSE |  |  |  |  |  |  | 270
11.4 | 97 |  |  | R22_AFE24 | FALSE |  |  |  |  |  |  | 270
11.4 | 93.75 |  |  | R22_AFE25 | FALSE |  |  |  |  |  |  | 270
11.4 | 90.5 |  |  | R22_AFE26 | FALSE |  |  |  |  |  |  | 270
11.4 | 87.25 |  |  | R22_AFE27 | FALSE |  |  |  |  |  |  | 270
11.4 | 84 |  |  | R22_AFE28 | FALSE |  |  |  |  |  |  | 270

Sheet: AFEV2
 | X1 (mm) | Y1 (mm) | Height (mm) | Locked | Designator | Show Designator | Component Comment | Show Comment | Lock Strings | Component Type | Footprint | Channel Offset | Rotation | X1 (mm) | Y1 (mm) | Height (mil) | Locked | Designator | Show Designator | Component Comment | Show Comment | Lock Strings | Component Type | Footprint | Channel Offset | Rotation
1 | 9.25 | 188 |  |  | C22_AFE1 | FALSE |  |  |  |  |  |  | 360 | 9.25 | 188 | 0 | FALSE | C22_AFE1 | FALSE | C | FALSE | FALSE | Standard | C_0603 | 0 | 270
2 | 14.375 | 185.9125 |  |  | C22_AFE2 | FALSE |  |  |  |  |  |  | 360 | 6.275 | 188 | 0 | FALSE | R21_AFE1 | FALSE | CRT0603-BY-1002EST | FALSE | FALSE | Standard | R-0603 | 1 | 360
3 | 9.25 | 183.825 |  |  | C22_AFE3 | FALSE |  |  |  |  |  |  | 360 | 6.275 | 186.425 | 0 | FALSE | R22_AFE1 | FALSE | Resistor | FALSE | FALSE | Standard | R-0603 | 2 | 360
4 | 14.375 | 181.7375 |  |  | C22_AFE4 | FALSE |  |  |  |  |  |  | 360
5 | 9.25 | 179.65 |  |  | C22_AFE5 | FALSE |  |  |  |  |  |  | 360
6 | 14.375 | 177.5625 |  |  | C22_AFE6 | FALSE |  |  |  |  |  |  | 360 | Dx | 5.125
7 | 9.25 | 175.475 |  |  | C22_AFE7 | FALSE |  |  |  |  |  |  | 360 | Dy1 | -2.0875
8 | 14.375 | 173.3875 |  |  | C22_AFE8
9 | 9.25 | 171.3 |  |  | C22_AFE9
10 | 14.375 | 169.2125 |  |  | C22_AFE10 |  |  |  |  |  |  |  |  | -4.175
 | 9.25 | 167.125 |  |  | C22_AFE11
 | 14.375 | 165.0375 |  |  | C22_AFE12
 | 9.25 | 162.95 |  |  | C22_AFE13
 | 14.375 | 160.8625 |  |  | C22_AFE14
 | 9.25 | 158.775 |  |  | C22_AFE15
 | 14.375 | 156.6875 |  |  | C22_AFE16
 | 9.25 | 154.6 |  |  | C22_AFE17
 | 14.375 | 152.5125 |  |  | C22_AFE18
 | 9.25 | 150.425 |  |  | C22_AFE19
 | 14.375 | 148.3375 |  |  | C22_AFE20
 | 9.25 | 146.25 |  |  | C22_AFE21
 | 14.375 | 144.1625 |  |  | C22_AFE22
 | 9.25 | 142.075 |  |  | C22_AFE23
 | 14.375 | 139.9875 |  |  | C22_AFE24
 | 9.25 | 137.9 |  |  | C22_AFE25
 | 14.375 | 135.8125 |  |  | C22_AFE26
 | 9.25 | 133.725 |  |  | C22_AFE27
 | 14.375 | 131.6375 |  |  | C22_AFE28
 | 6.275 | 188 |  |  | R21_AFE1
 | 11.4 | 185.9125 |  |  | R21_AFE2
 | 6.275 | 183.825 |  |  | R21_AFE3
 | 11.4 | 181.7375 |  |  | R21_AFE4
 | 6.275 | 179.65 |  |  | R21_AFE5
 | 11.4 | 177.5625 |  |  | R21_AFE6
 | 6.275 | 175.475 |  |  | R21_AFE7
 | 11.4 | 173.3875 |  |  | R21_AFE8
 | 6.275 | 171.3 |  |  | R21_AFE9
 | 11.4 | 169.2125 |  |  | R21_AFE10
 | 6.275 | 167.125 |  |  | R21_AFE11
 | 11.4 | 165.0375 |  |  | R21_AFE12
 | 6.275 | 162.95 |  |  | R21_AFE13
 | 11.4 | 160.8625 |  |  | R21_AFE14
 | 6.275 | 158.775 |  |  | R21_AFE15
 | 11.4 | 156.6875 |  |  | R21_AFE16
 | 6.275 | 154.6 |  |  | R21_AFE17
 | 11.4 | 152.5125 |  |  | R21_AFE18
 | 6.275 | 150.425 |  |  | R21_AFE19
 | 11.4 | 148.3375 |  |  | R21_AFE20
 | 6.275 | 146.25 |  |  | R21_AFE21
 | 11.4 | 144.1625 |  |  | R21_AFE22
 | 6.275 | 142.075 |  |  | R21_AFE23
 | 11.4 | 139.9875 |  |  | R21_AFE24
 | 6.275 | 137.9 |  |  | R21_AFE25
 | 11.4 | 135.8125 |  |  | R21_AFE26
 | 6.275 | 133.725 |  |  | R21_AFE27
 | 11.4 | 131.6375 |  |  | R21_AFE28
 | 6.275 | 186.425 |  |  | R22_AFE1
 | 11.4 | 184.3375 |  |  | R22_AFE2
 | 6.275 | 182.25 |  |  | R22_AFE3
 | 11.4 | 180.1625 |  |  | R22_AFE4
 | 6.275 | 178.075 |  |  | R22_AFE5
 | 11.4 | 175.9875 |  |  | R22_AFE6
 | 6.275 | 173.9 |  |  | R22_AFE7
 | 11.4 | 171.8125 |  |  | R22_AFE8
 | 6.275 | 169.725 |  |  | R22_AFE9
 | 11.4 | 167.6375 |  |  | R22_AFE10
 | 6.275 | 165.55 |  |  | R22_AFE11
 | 11.4 | 163.4625 |  |  | R22_AFE12
 | 6.275 | 161.375 |  |  | R22_AFE13
 | 11.4 | 159.2875 |  |  | R22_AFE14
 | 6.275 | 157.2 |  |  | R22_AFE15
 | 11.4 | 155.1125 |  |  | R22_AFE16
 | 6.275 | 153.025 |  |  | R22_AFE17
 | 11.4 | 150.9375 |  |  | R22_AFE18
 | 6.275 | 148.85 |  |  | R22_AFE19
 | 11.4 | 146.7625 |  |  | R22_AFE20
 | 6.275 | 144.675 |  |  | R22_AFE21
 | 11.4 | 142.5875 |  |  | R22_AFE22
 | 6.275 | 140.5 |  |  | R22_AFE23
 | 11.4 | 138.4125 |  |  | R22_AFE24
 | 6.275 | 136.325 |  |  | R22_AFE25
 | 11.4 | 134.2375 |  |  | R22_AFE26
 | 6.275 | 132.15 |  |  | R22_AFE27
 | 11.4 | 130.0625 |  |  | R22_AFE28
