juppy10/HV_BMS/Hardware/BMS_Slave_12S V0.1/2022 PT Segment Internal Structure Assembly.STEP

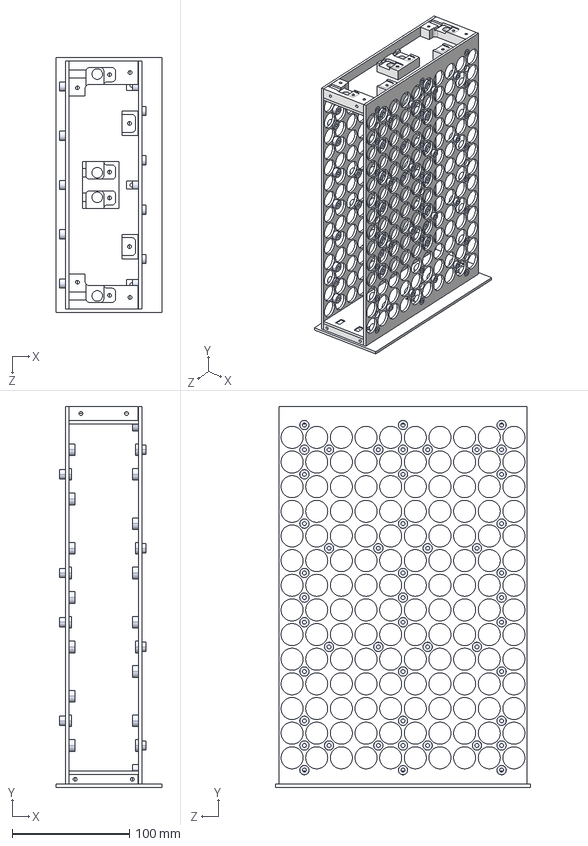
[picture p4: CAD file, 2022-01-12]
Hardware/BMS_Slave_12S V0.1/2022 PT Segment Internal Structure Assembly.STEP
90.0 x 324.6 x 217.6 mm
2022 PT Segment Structure Short_Internal
2022 PT Segment Claw Boss x 45
2022 PT Segment PCB Boss x 16
2022 PT Segment RHS Outer Wall Boss x 10
