juppy10/HV_BMS/Hardware/Accumulator Management System/3D objects/SOT-223-1.step

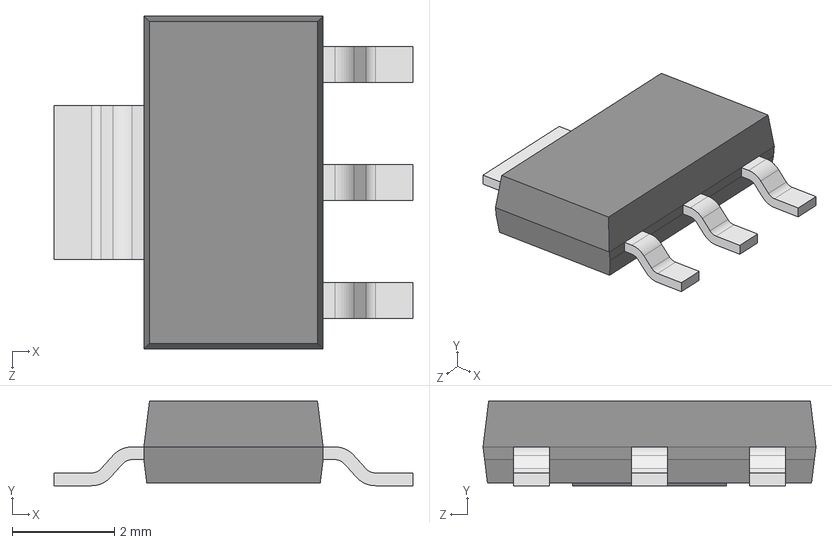
[picture p5: CAD file, 2021-11-24]
Hardware/Accumulator Management System/3D objects/SOT-223-1.step
7.00 x 1.65 x 6.50 mm
