juppy10/HV_BMS/Hardware/Accumulator Management System/PCB_Placeholder.step

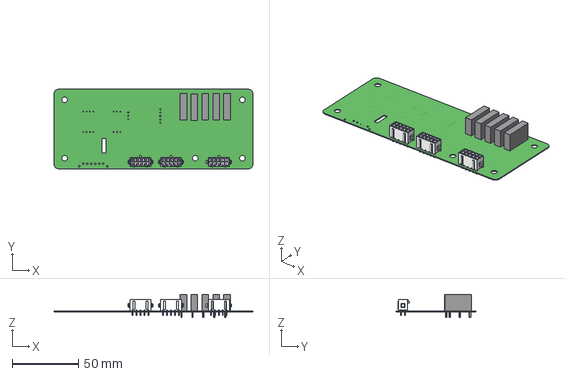
[picture p6: CAD file, 2021-11-14]
Hardware/Accumulator Management System/PCB_Placeholder.step
150.0 x 60.0 x 17.6 mm
