juppy10/HV_BMS/Hardware/BMS_Slave_12S V0.1/BMS_Slave V0.1.step

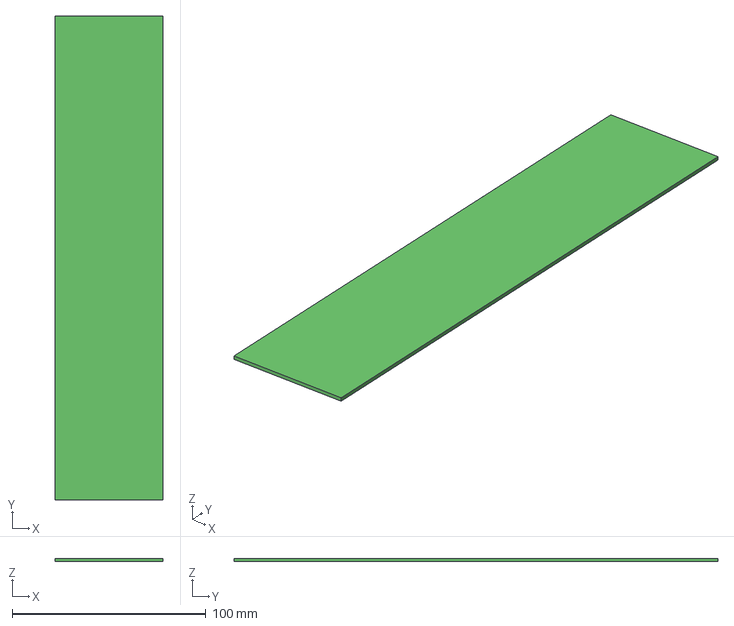
[picture p7: CAD file, 2022-01-19]
Hardware/BMS_Slave_12S V0.1/BMS_Slave V0.1.step
55.5 x 249.8 x 1.61 mm
