juppy10/HV_BMS/Hardware/PCB_Project/3D_Parts/User Library-LQFP64_Grid_0_5.STEP

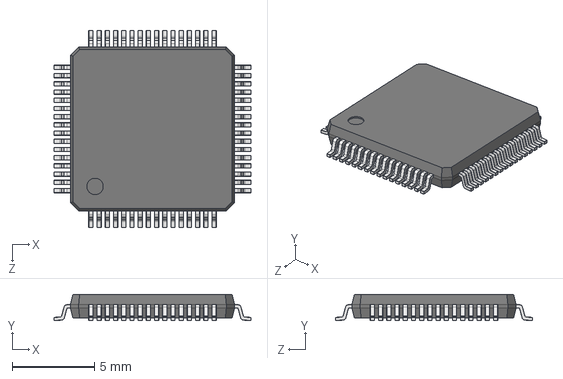
[picture p8: CAD file, 2021-06-29]
Hardware/PCB_Project/3D_Parts/User Library-LQFP64_Grid_0_5.STEP
12.0 x 1.60 x 12.0 mm
LQFP64_Koerper_2
LQFP_PIN_2 x 64
