juppy10/HV_BMS/Hardware/PCB_Project/3D_Parts/c-1-84952-3-a-3d.stp

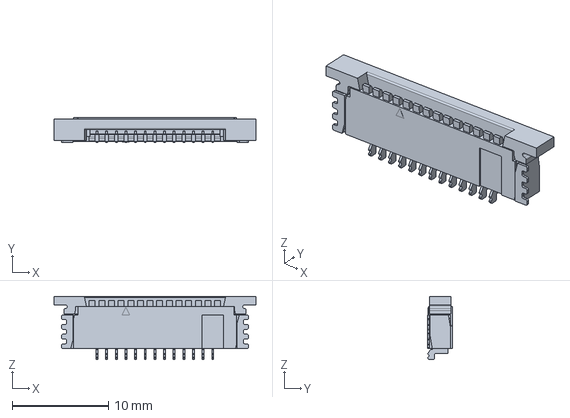
[picture p10: CAD file, 2021-06-29]
Hardware/PCB_Project/3D_Parts/c-1-84952-3-a-3d.stp
20.9 x 2.56 x 6.54 mm
