juppy10/HV_BMS/Hardware/PCB_Project/3D_Parts/User Library-SSOP16.step

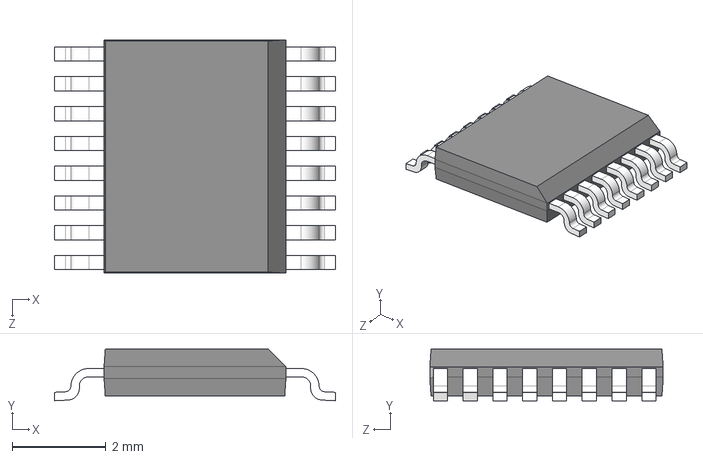
[picture p11: CAD file, 2021-06-29]
Hardware/PCB_Project/3D_Parts/User Library-SSOP16.step
5.99 x 1.10 x 4.98 mm
