juppy10/HV_BMS/Hardware/PCB_Project/3D_Parts/SM91501ALE.STEP

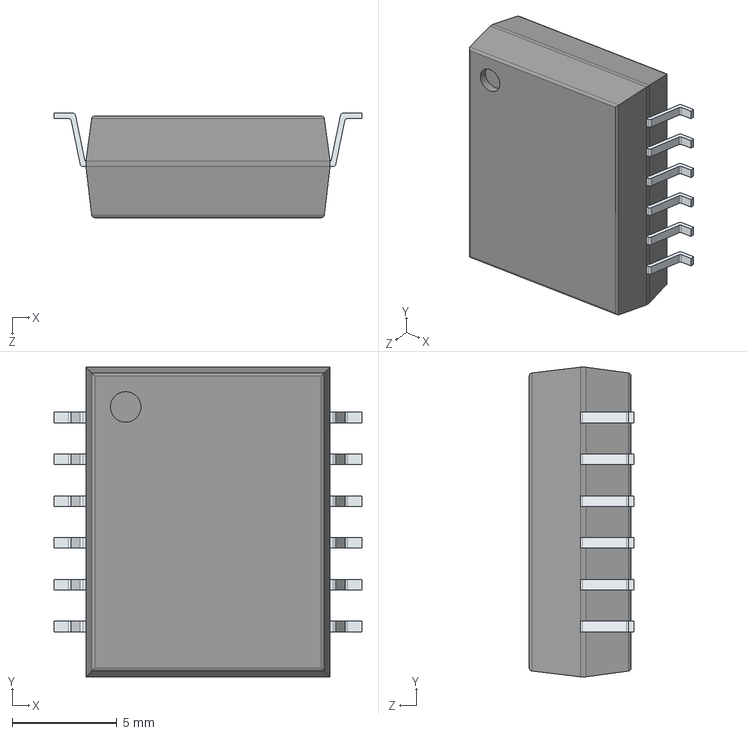
[picture p13: CAD file, 2021-06-30]
Hardware/PCB_Project/3D_Parts/SM91501ALE.STEP
14.7 x 14.8 x 5.00 mm
Body.stp
PinsArrayLR.stp
