juppy10/HV_BMS/Logging/UV-OV Fault test 2.xlsx

time (ms) | Cell 1 | Cell 2 | Cell 3 | Cell 4 | Cell 5 | Cell 6 | Cell 7 | Cell 8 | UV\OV Fault | time (ms) | Cell 1 | Cell 2 | Cell 3 | Cell 4 | Cell 5 | Cell 6 | Cell 7 | Cell 8 | UV\OV Fault
0 | 35317 | 36113 | 35897 | 35489 | 34758 | 35199 | 34999 | 34829 | 0 | 0 | 3531.7 | 3611.3 | 3589.7 | 3548.9 | 3475.8 | 3519.9 | 3499.9 | 3482.9 | 0
0.1 | 35316 | 36114 | 35898 | 35490 | 34756 | 35199 | 34999 | 34831 | 0 | 0.1 | 3531.6 | 3611.4 | 3589.8 | 3549 | 3475.6 | 3519.9 | 3499.9 | 3483.1 | 0
0.2 | 35316 | 36114 | 35897 | 35489 | 34757 | 35198 | 35001 | 34831 | 0 | 0.2 | 3531.6 | 3611.4 | 3589.7 | 3548.9 | 3475.7 | 3519.8 | 3500.1 | 3483.1 | 0
0.3 | 35317 | 36113 | 35896 | 35489 | 34758 | 35199 | 35000 | 34832 | 0 | 0.3 | 3531.7 | 3611.3 | 3589.6 | 3548.9 | 3475.8 | 3519.9 | 3500 | 3483.2 | 0
0.4 | 35317 | 36117 | 35899 | 35490 | 34756 | 35197 | 34996 | 34828 | 0 | 0.4 | 3531.7 | 3611.7 | 3589.9 | 3549 | 3475.6 | 3519.7 | 3499.6 | 3482.8 | 0
0.5 | 35315 | 36114 | 35898 | 35491 | 34759 | 35200 | 35001 | 34831 | 0 | 0.5 | 3531.5 | 3611.4 | 3589.8 | 3549.1 | 3475.9 | 3520 | 3500.1 | 3483.1 | 0
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
