juppy10/HV_BMS/Logging/Logs/Balance Testing/three balance.csv

both balance, time (ms) | Cell 1 | Cell 2 | Cell 3 |  | cell1 | cell2 | cell3
0 | 36258 | 35527 | 36652 | min | 36257 | 35526 | 36651
0.1 | 36258 | 35527 | 36653 | max | 36323 | 35555 | 36708
0.2 | 36259 | 35527 | 36652 | d | 66 | 29 | 57
0.3 | 36258 | 35528 | 36652
0.4 | 36257 | 35526 | 36651
0.5 | 36321 | 35553 | 36706
0.6 | 36322 | 35553 | 36706
0.7 | 36322 | 35554 | 36707
0.8 | 36322 | 35554 | 36706
0.9 | 36322 | 35553 | 36706
1 | 36322 | 35554 | 36706
1.1 | 36322 | 35555 | 36707
1.2 | 36323 | 35555 | 36708
1.3 | 36323 | 35554 | 36707
1.4 | 36322 | 35554 | 36707
1.5 | 36260 | 35528 | 36654
1.6 | 36258 | 35528 | 36652
1.7 | 36259 | 35528 | 36652
1.8 | 36257 | 35526 | 36652
1.9 | 36257 | 35527 | 36652
2 | 36258 | 35527 | 36651
2.1 | 36258 | 35527 | 36652
2.2 | 36257 | 35526 | 36652
2.3 | 36257 | 35526 | 36651
2.4 | 36257 | 35526 | 36651
2.5 | 36320 | 35552 | 36705
2.6 | 36321 | 35553 | 36706
2.7 | 36321 | 35553 | 36706
2.8 | 36322 | 35554 | 36707
2.9 | 36321 | 35553 | 36707
3 | 36322 | 35554 | 36707
3.1 | 36322 | 35553 | 36706
3.2 | 36322 | 35555 | 36706
3.3 | 36322 | 35554 | 36706
3.4 | 36322 | 35554 | 36707
3.5 | 36259 | 35528 | 36653
3.6 | 36258 | 35527 | 36652
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
