juppy10/HV_BMS/Logging/UV-OV Fault test.csv

time (ms) | Cell 1 | Cell 2 | Cell 3 | Cell 4 | Cell 5 | Cell 6 | Cell 7 | Cell 8 | UV\OV Fault
0 | 37318 | 38198 | 37946 | 37486 | 36678 | 37126 | 36918 | 36750 | 0
0.1 | 37317 | 38197 | 37944 | 37486 | 36679 | 37128 | 36920 | 36752 | 0
0.2 | 37318 | 38200 | 37945 | 37486 | 36676 | 37125 | 36917 | 36751 | 0
0.3 | 37317 | 38197 | 37944 | 37486 | 36676 | 37127 | 36919 | 36752 | 0
0.4 | 37318 | 38197 | 37944 | 37484 | 36676 | 37128 | 36919 | 36751 | 0
0.5 | 37320 | 38204 | 37949 | 37486 | 36673 | 37121 | 36913 | 36745 | 0
0.6 | 37318 | 38200 | 37946 | 37485 | 36673 | 37124 | 36916 | 36751 | 0
0.7 | 37317 | 38197 | 37943 | 37485 | 36677 | 37126 | 36918 | 36752 | 0
0.8 | 37318 | 38197 | 37944 | 37486 | 36677 | 37128 | 36920 | 36753 | 0
0.9 | 37318 | 38201 | 37948 | 37487 | 36674 | 37125 | 36916 | 36750 | 0
1 | 37317 | 38196 | 37944 | 37485 | 36676 | 37127 | 36920 | 36751 | 0
1.1 | 37318 | 38196 | 37943 | 37484 | 36675 | 37126 | 36919 | 36751 | 0
1.2 | 37317 | 38196 | 37944 | 37486 | 36678 | 37128 | 36920 | 36753 | 0
1.3 | 37319 | 38204 | 37948 | 37487 | 36672 | 37122 | 36915 | 36748 | 0
1.4 | 37317 | 38197 | 37944 | 37485 | 36677 | 37127 | 36919 | 36752 | 0
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
