juppy10/HV_BMS/Hardware/Accumulator Management System/Accumulator_MGMT_Sys.pdf

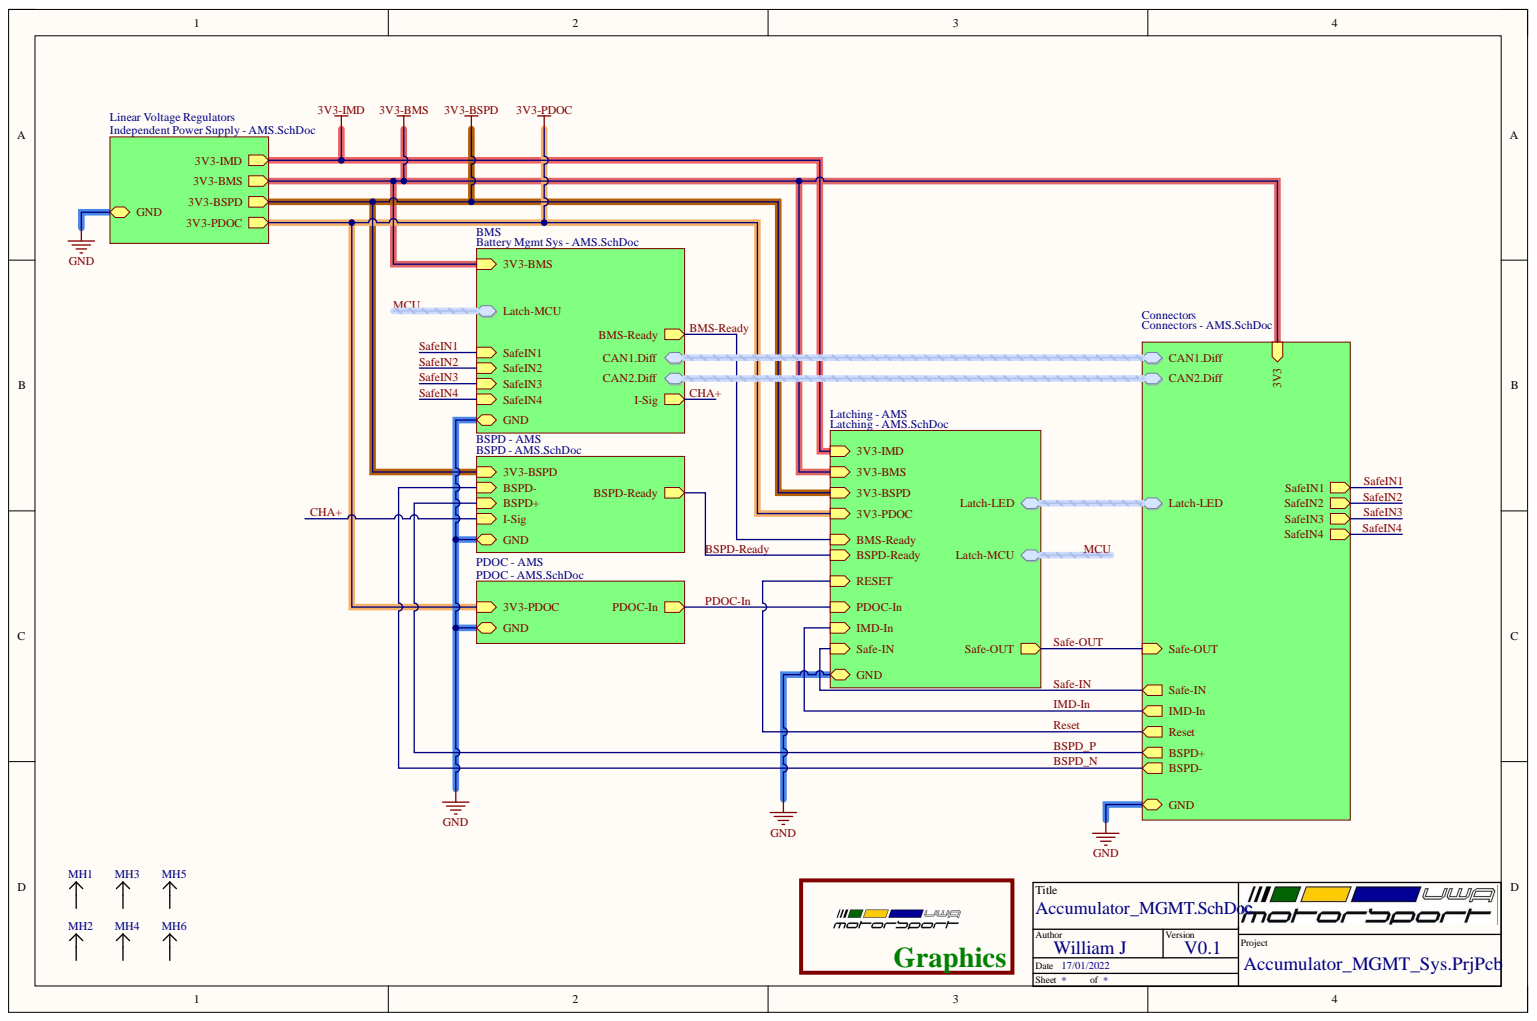
[picture p14: page 1]

AMS BSPD - AMS.Sch

BSPD -
BSPD-Read y BSPD +

Latch-MCU Latch-LED

G N D | IMD-I n

Safe-IN Safe-O U T | Safe-O U T

G N D | Safe-IN

Res et
BSPD _ P
BSPD _N

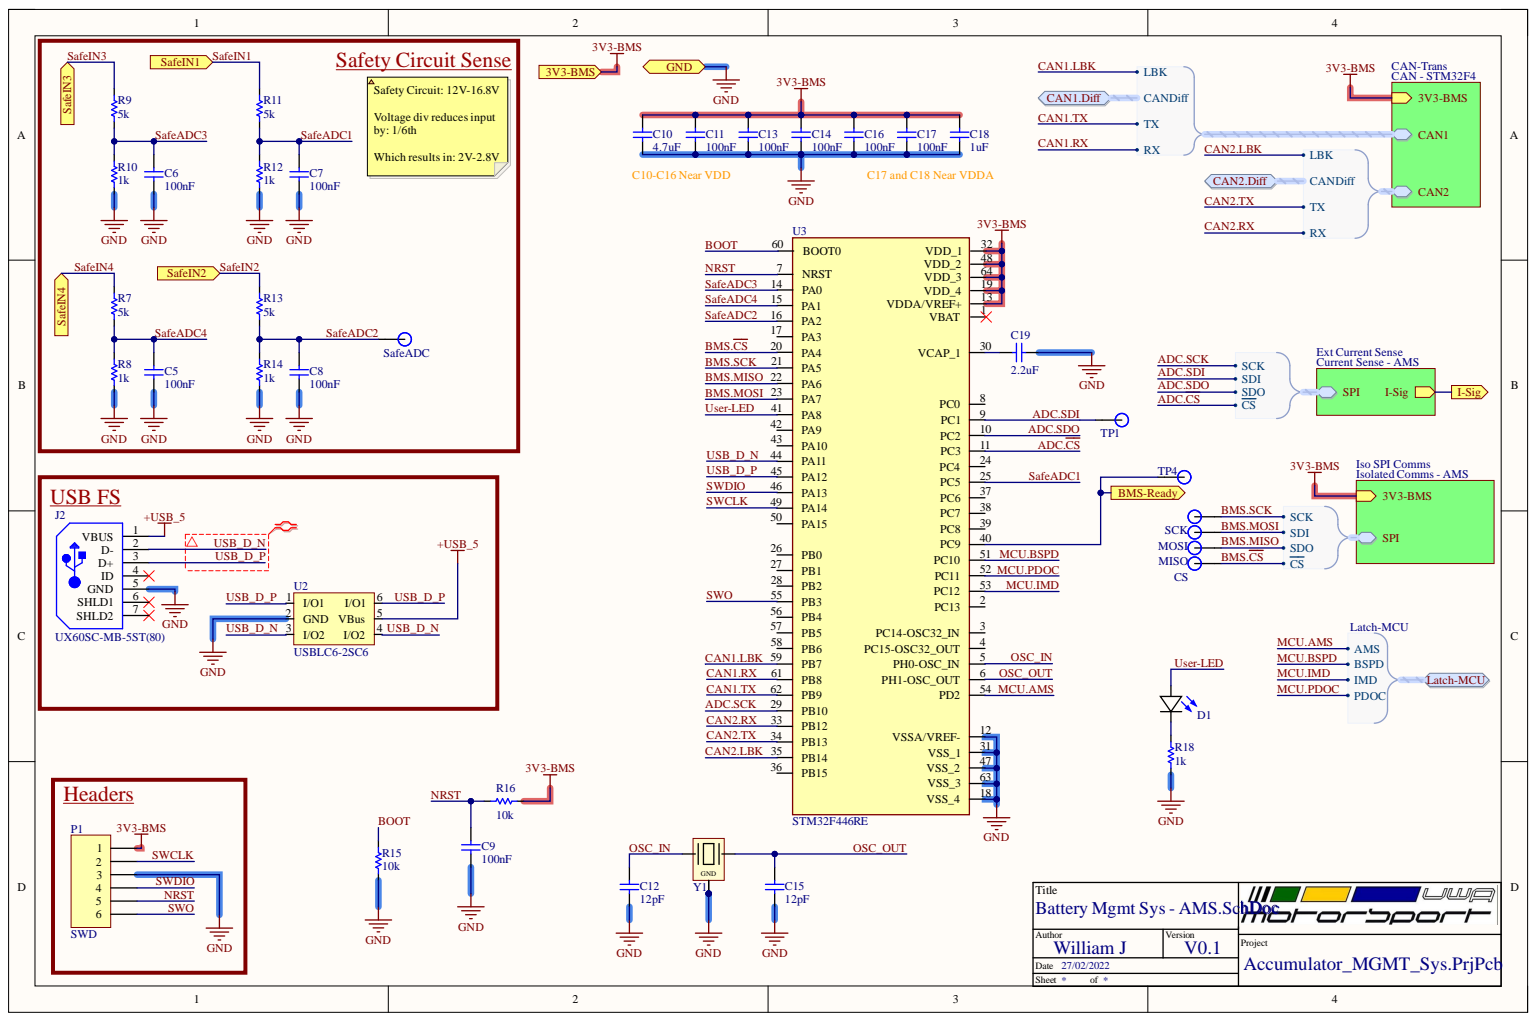
[picture p15: page 2]

o SPI Comms Isolated Comms-

2 | USB_ D _N
3 | USB_ D _P

5 | USB_ D _P

gmt Sys - AMS.SchDo

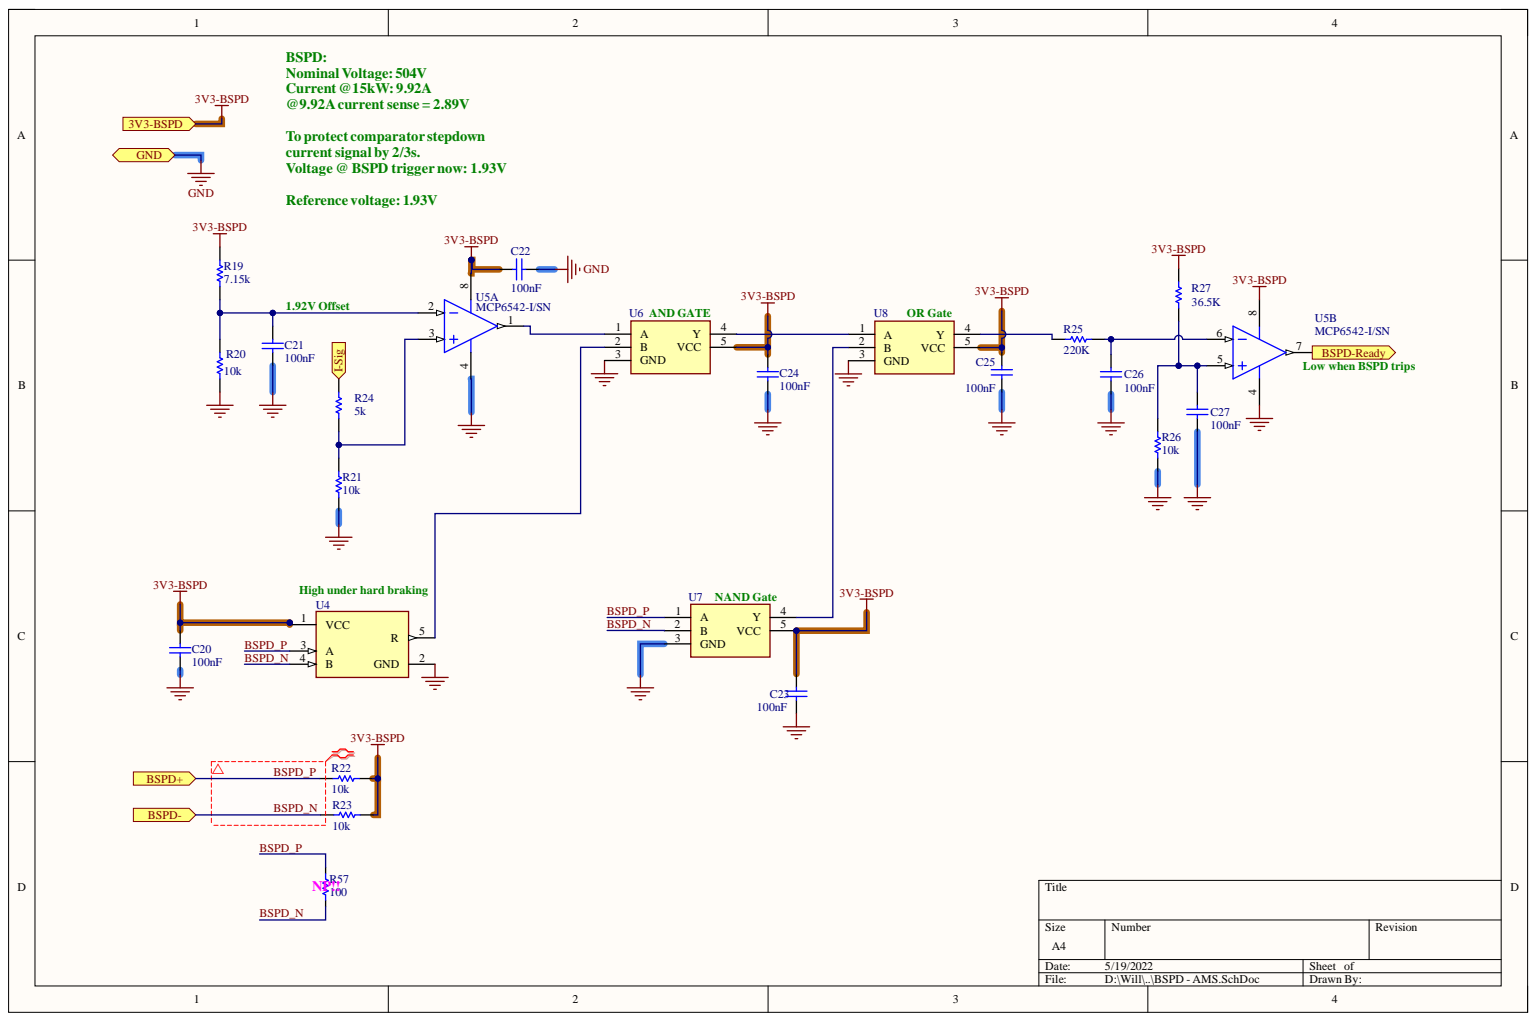
[picture p16: page 3]

To protect comparator stepdown
current signal by 2/3s.
Voltage @ BSPD trigger now: 1.93V

Low when BSPD trips 100nF

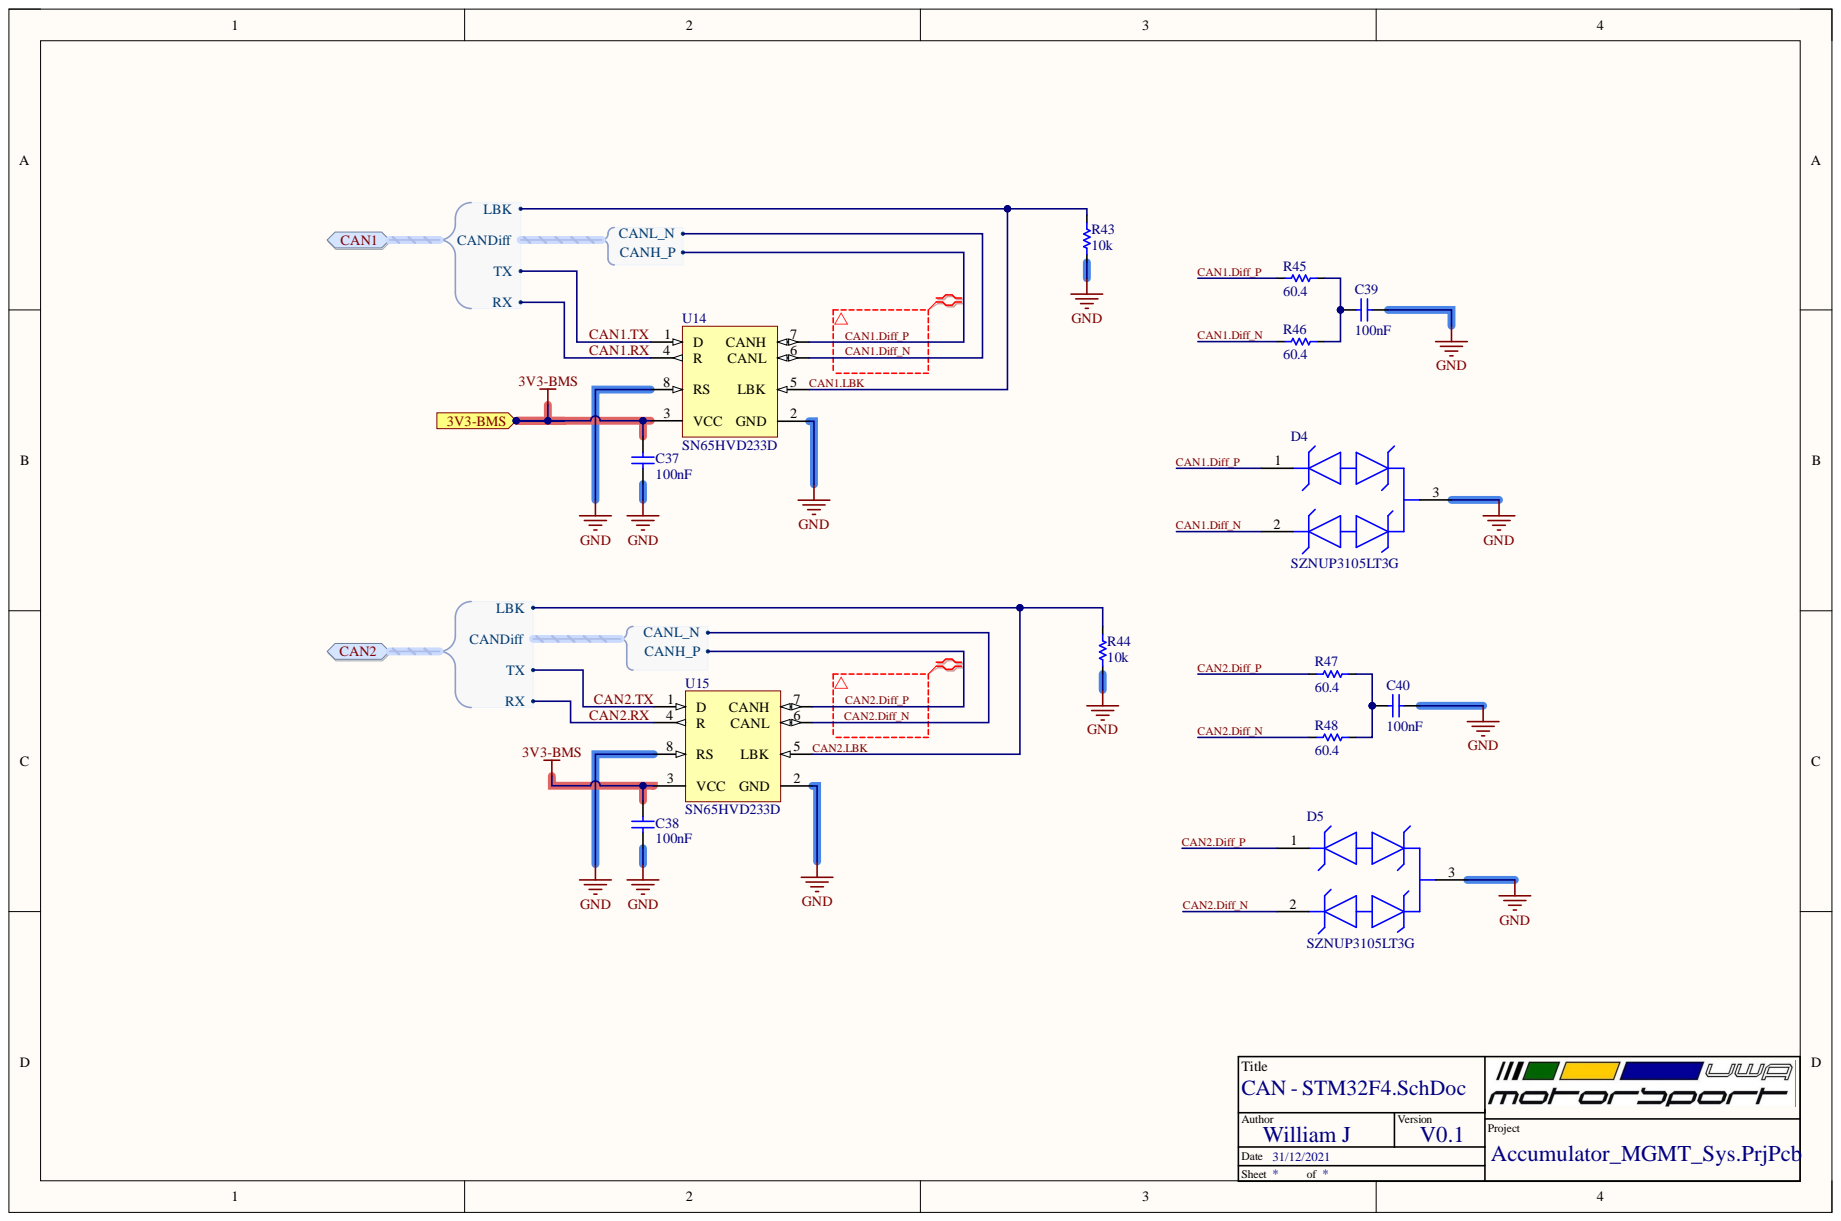
[picture p17: page 4]

3V3-BMS | RS 8

GND | 2 VCC 3

CAN2.RX | R 4 | CAN2.Diff_N

Title CAN - STM32F4.SchDoc

Author William J | Version

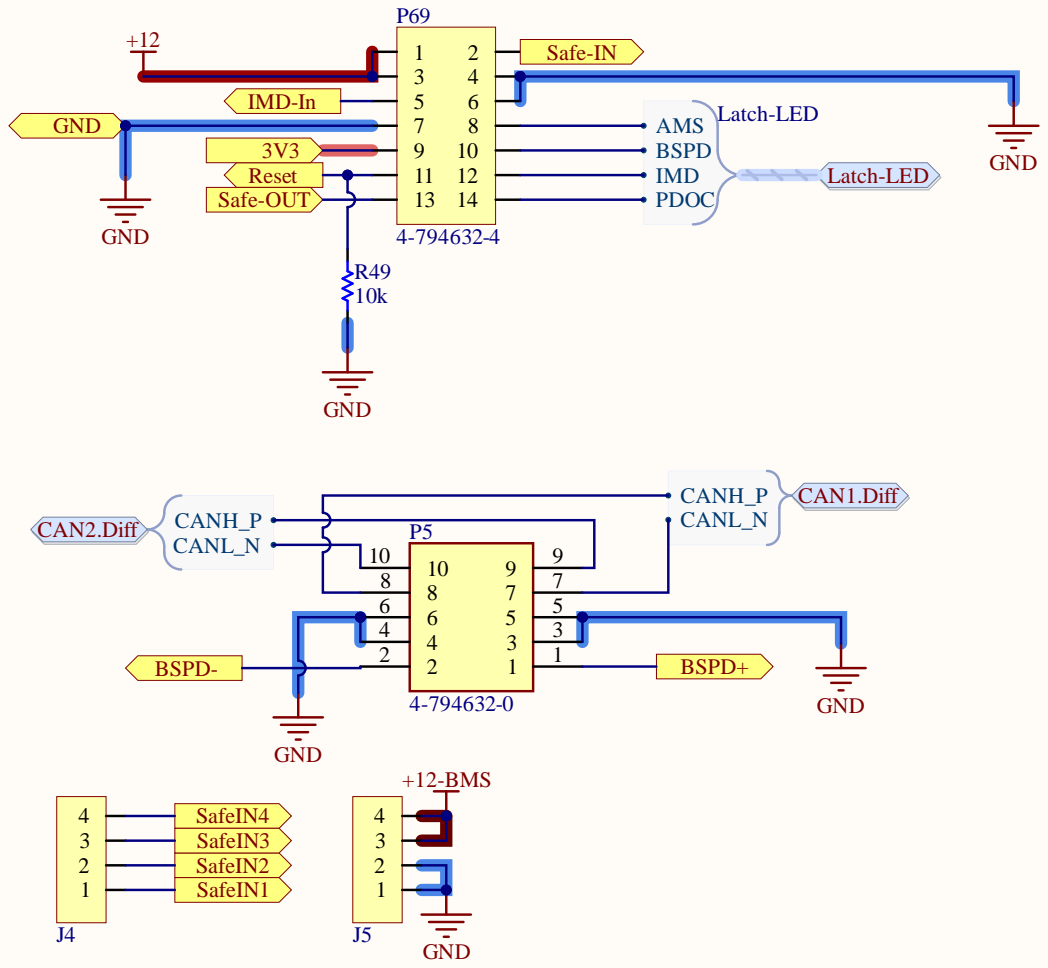
[picture p18: page 5]

Title Connectors - AMS.SchDoc

Author William J | Version

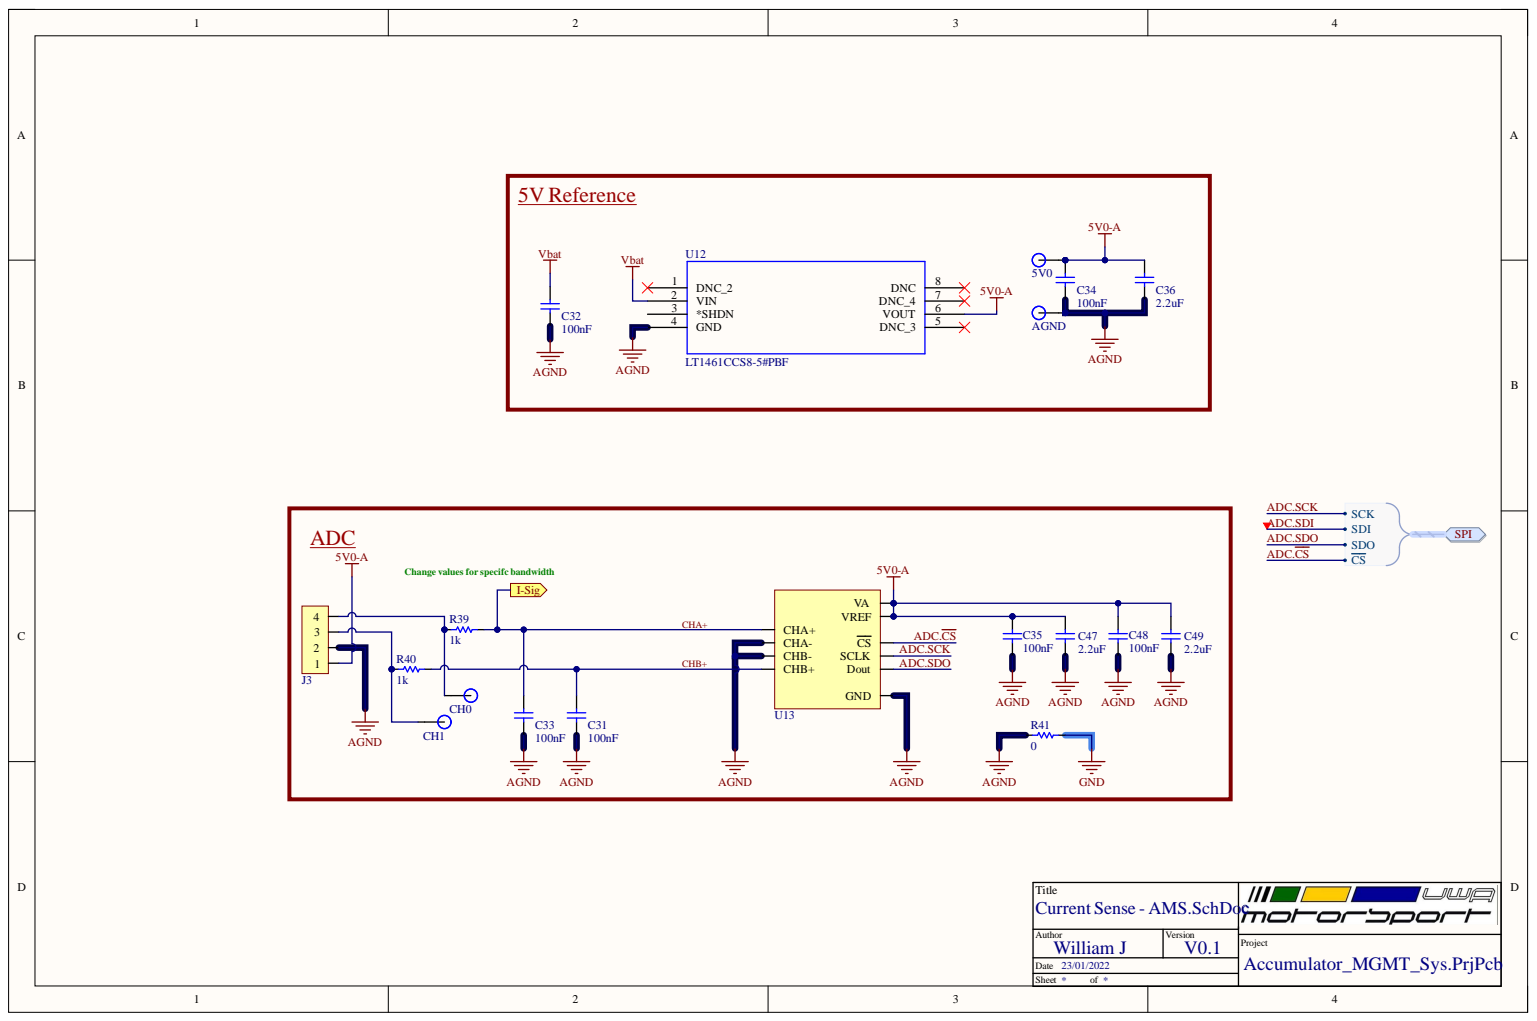
[picture p19: page 6]

Change values for specifc bandwidth

Title Current Sense - AMS.SchDoc

Author William J | Version

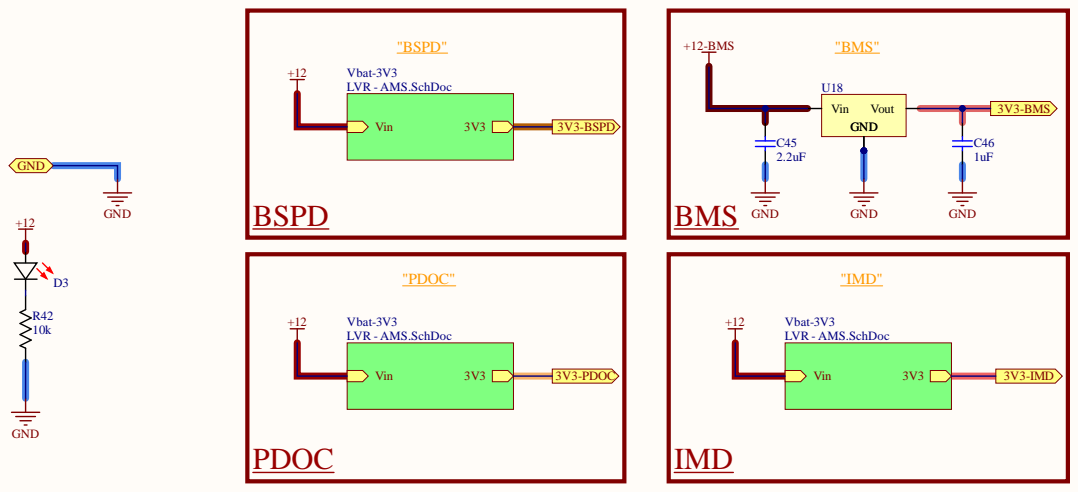
[picture p20: page 7]

T i tl e In depen dent Power Su p ply - AMS.SchDo | c

Autho r William J | Ve r s i o n

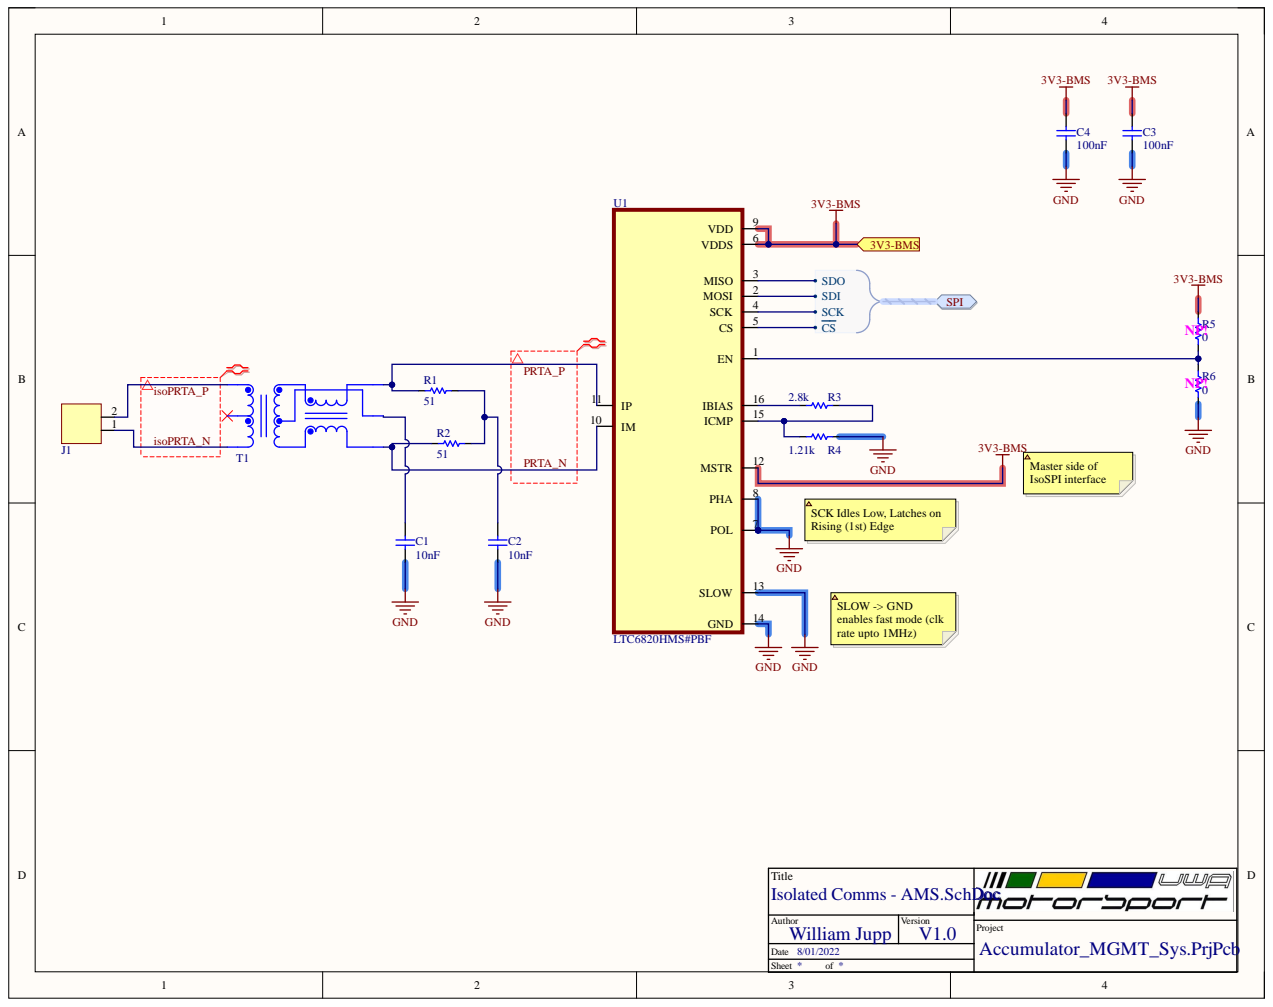
[picture p21: page 8]

PRTA_ P | 1

Title Isolated Comms - AMS.S chDoc

Autho r William Ju p p | Vers i o n V1 .

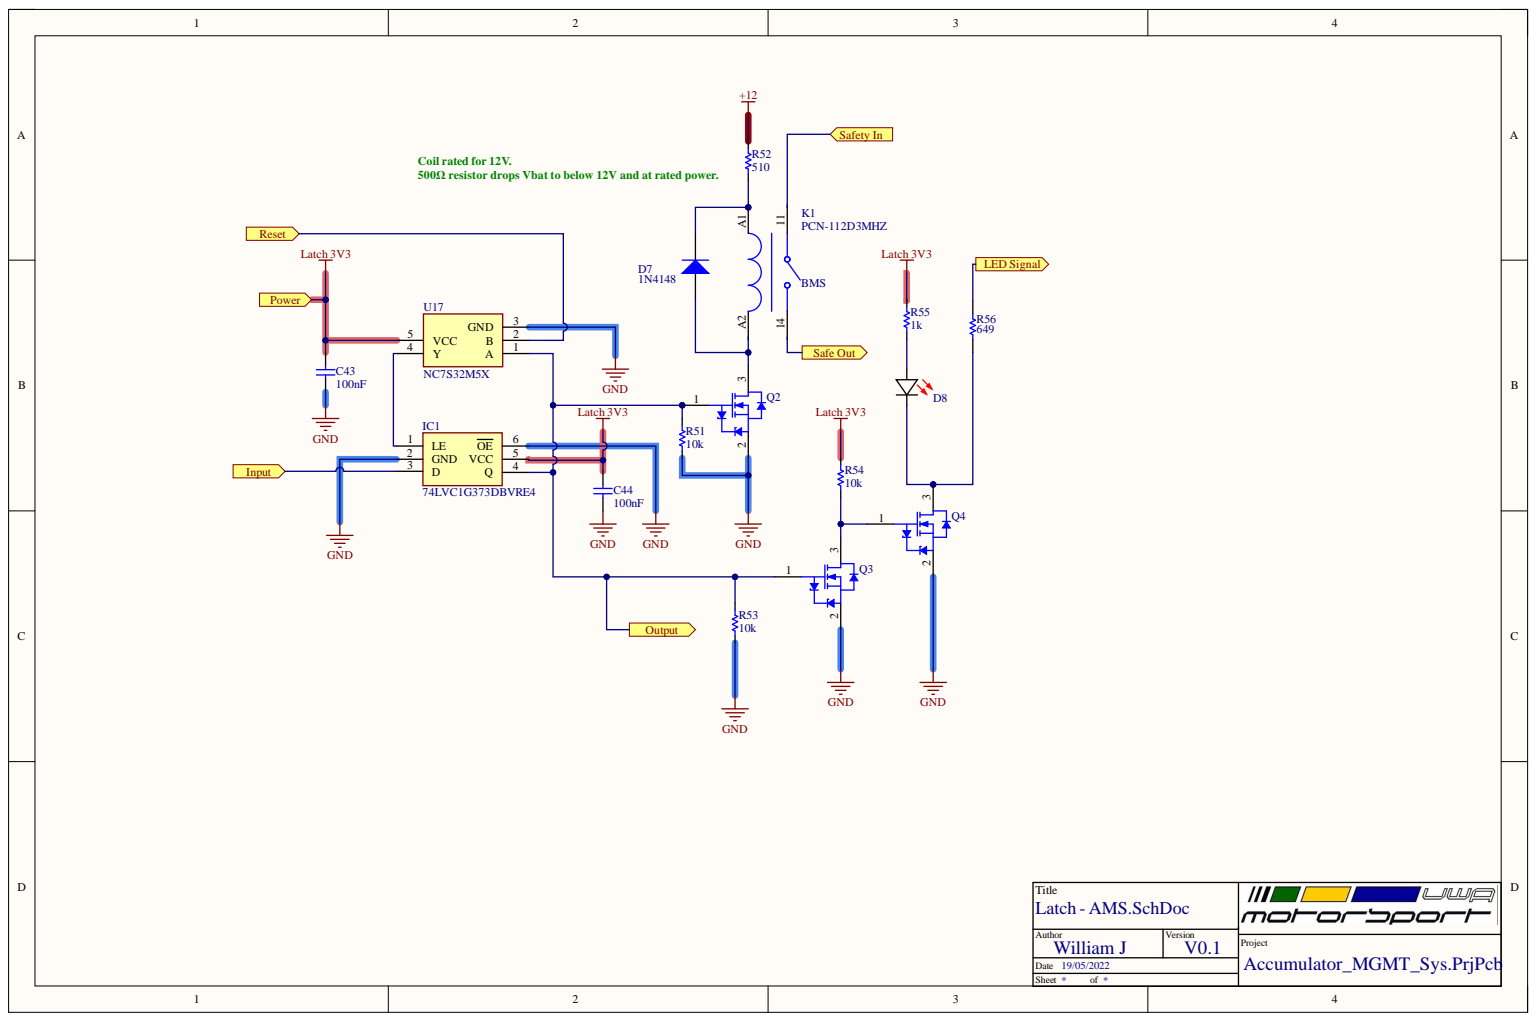
[picture p22: page 9]

Latch | 3 V 3

5 | G N D VCC B Y A | 2

T i tl e Latch - AMS.SchDo c

Autho r William J | Ve r s i o n

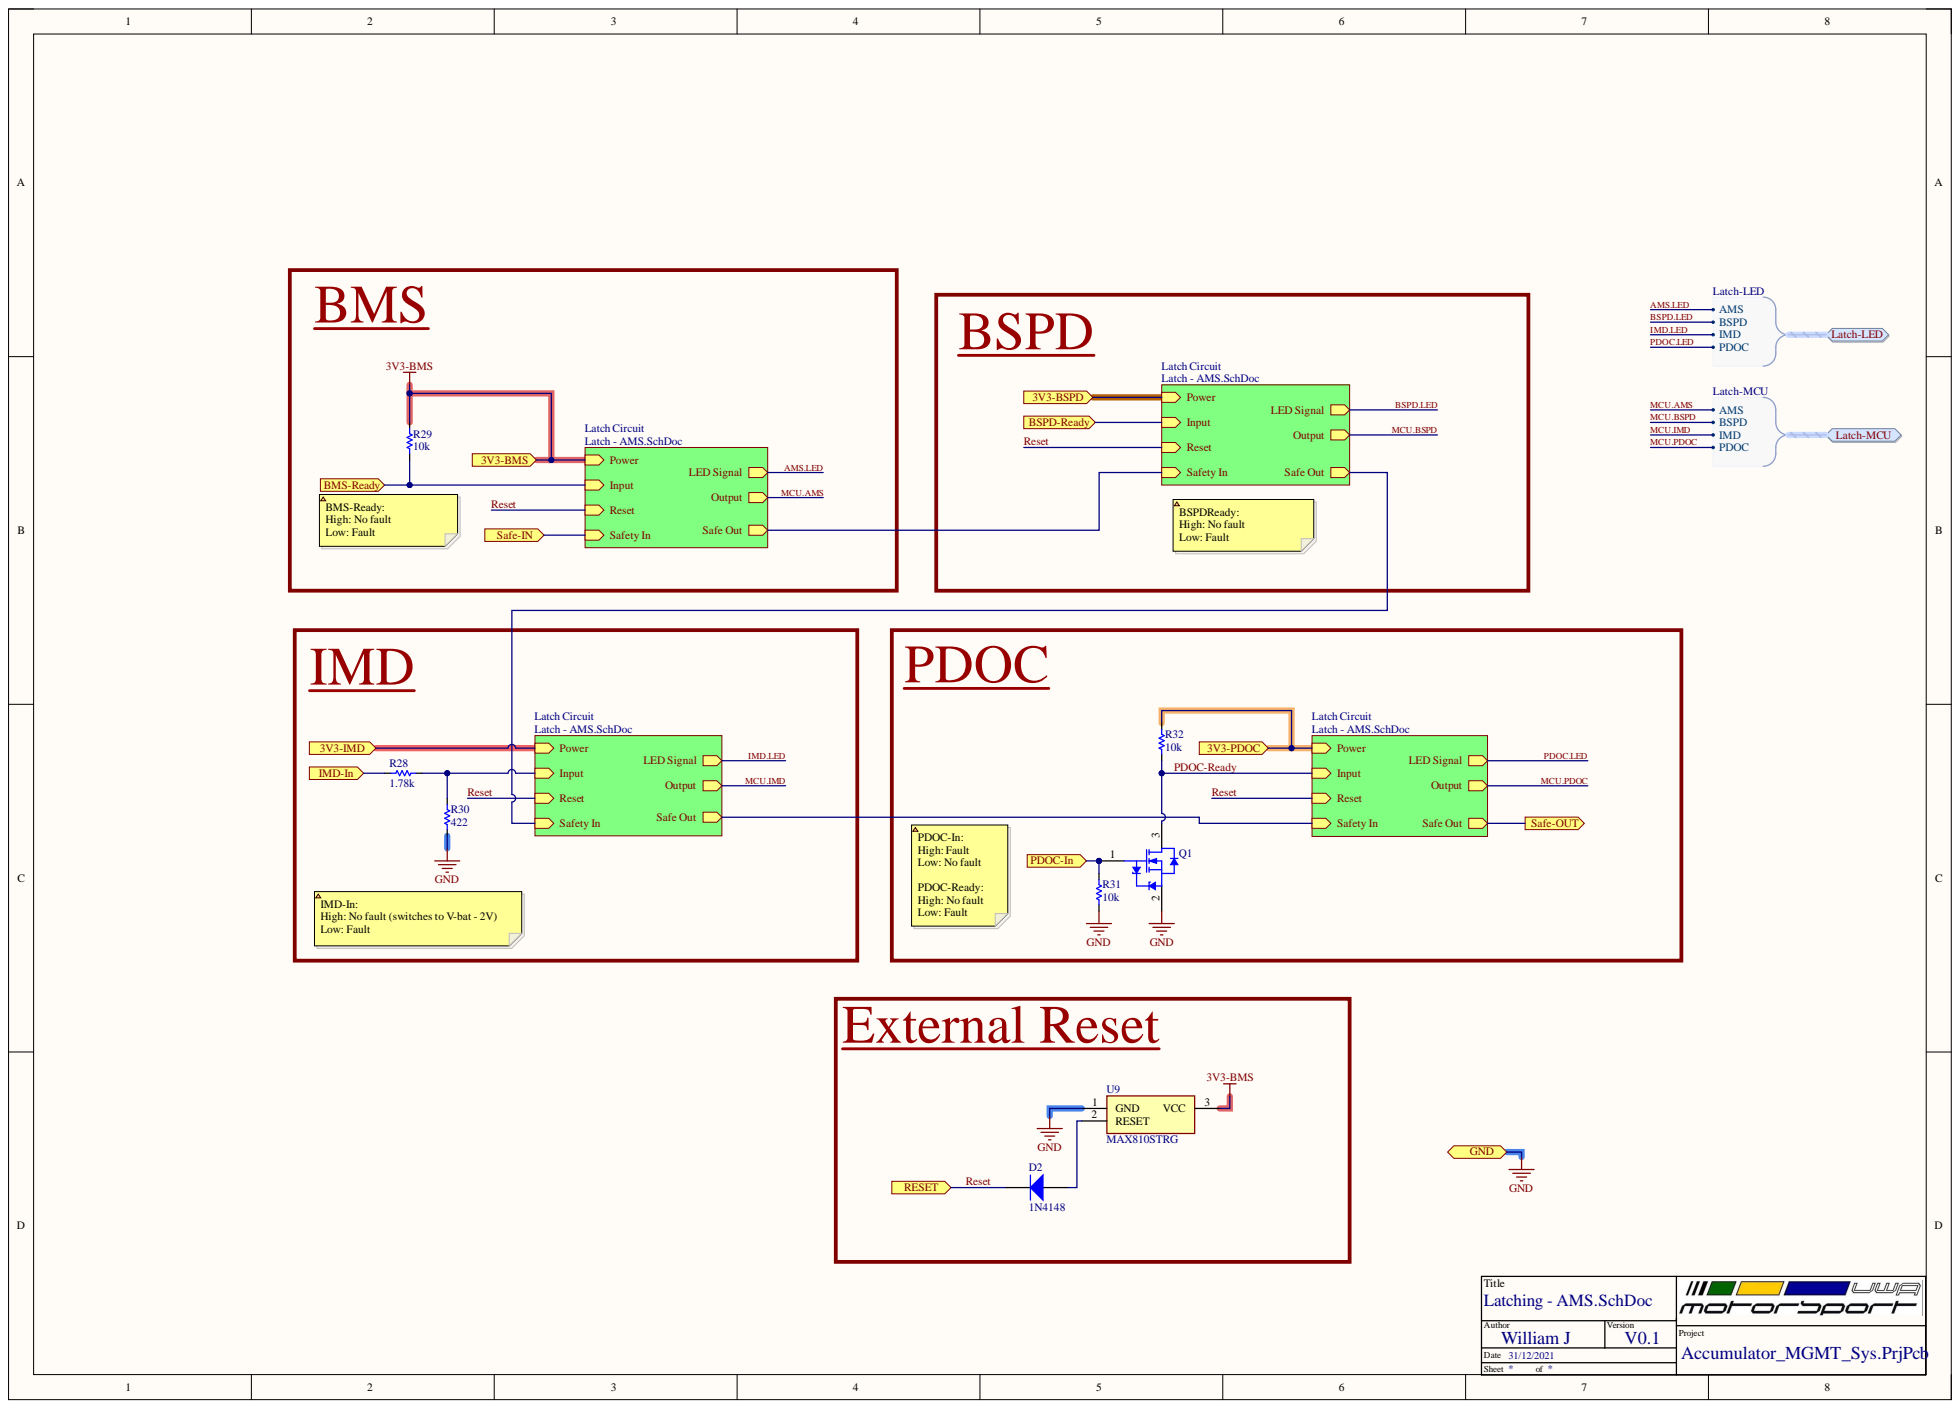
[picture p23: page 10]

IMD-In:
High: No fault (switches to V-bat - 2V)
Low: Fault

Title Latching - AMS.SchDoc

Author William J | Version | Project

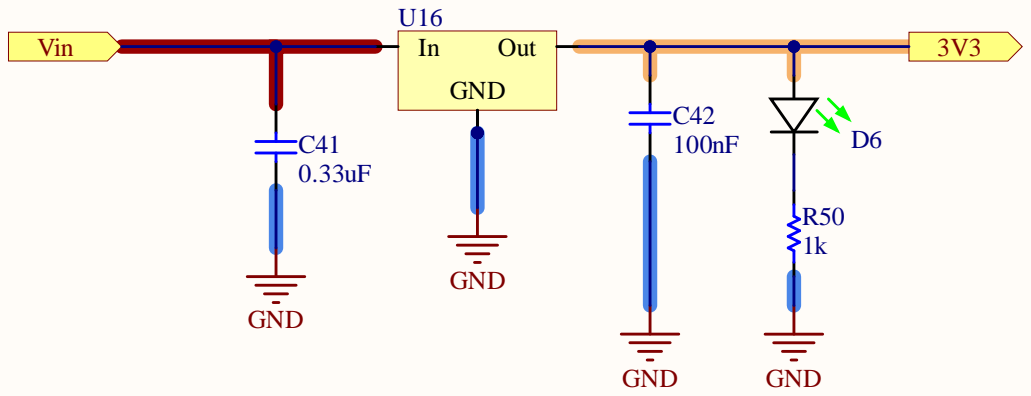
[picture p24: page 11]

T i tl e LVR - AMS.SchDo c

Autho r William J | Ve r s i o n

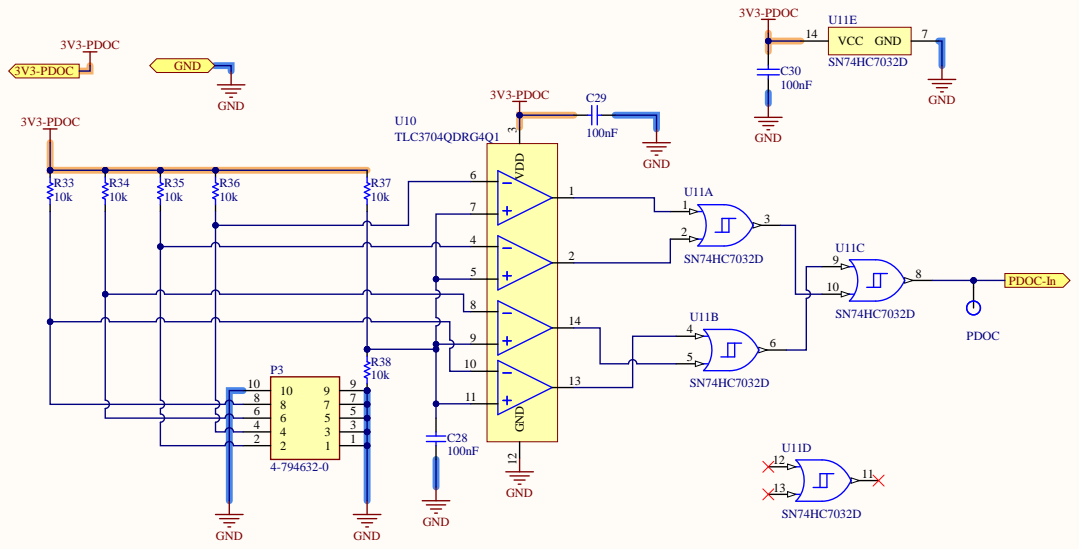
[picture p25: page 12]

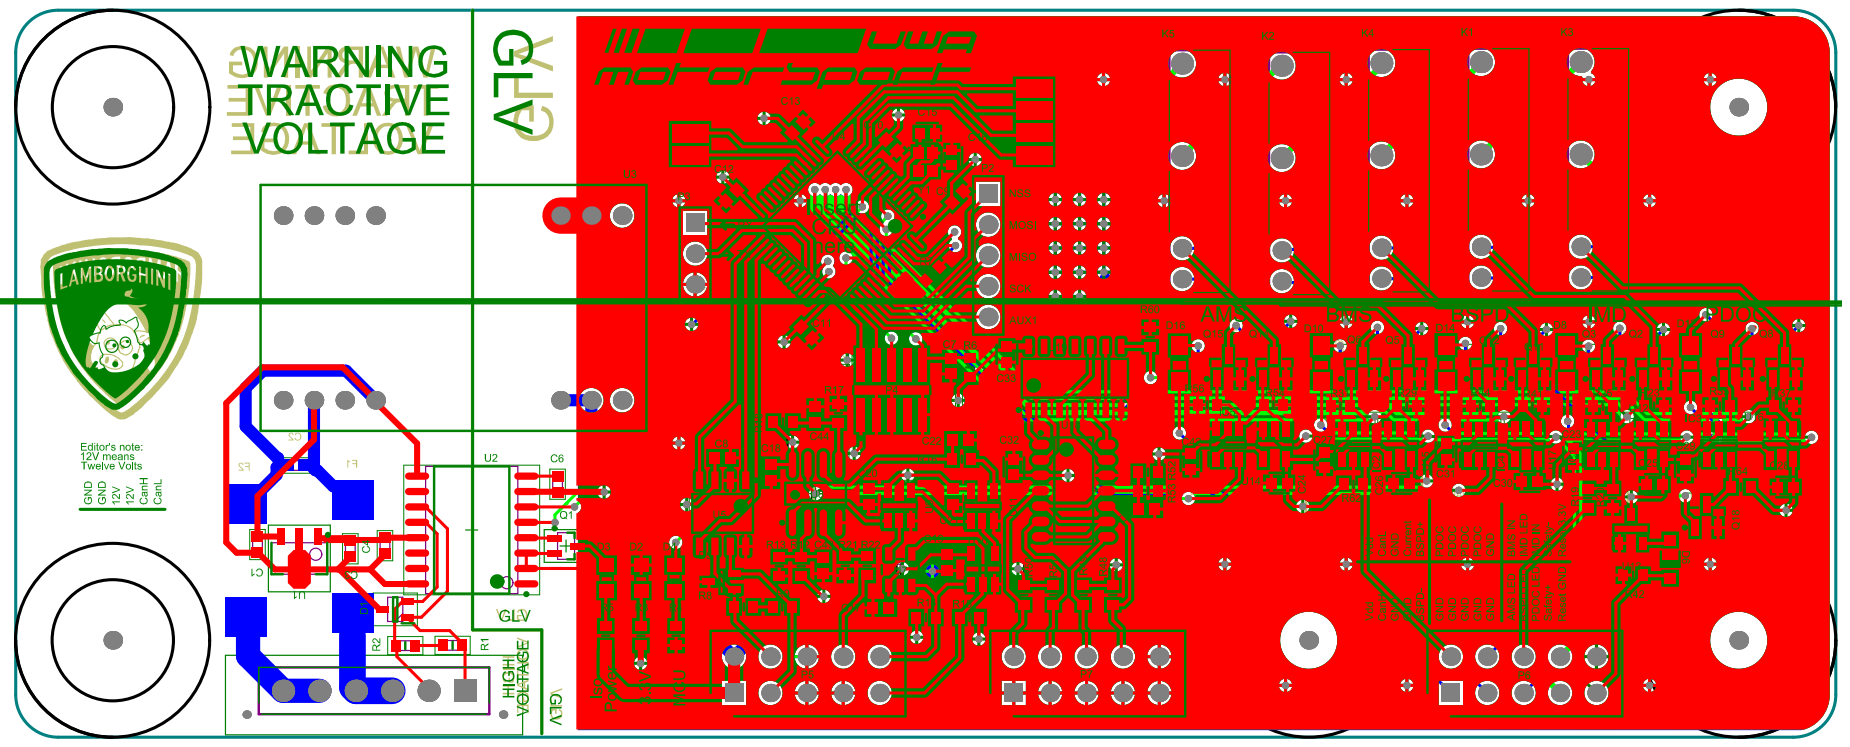
[picture p26: page 13]

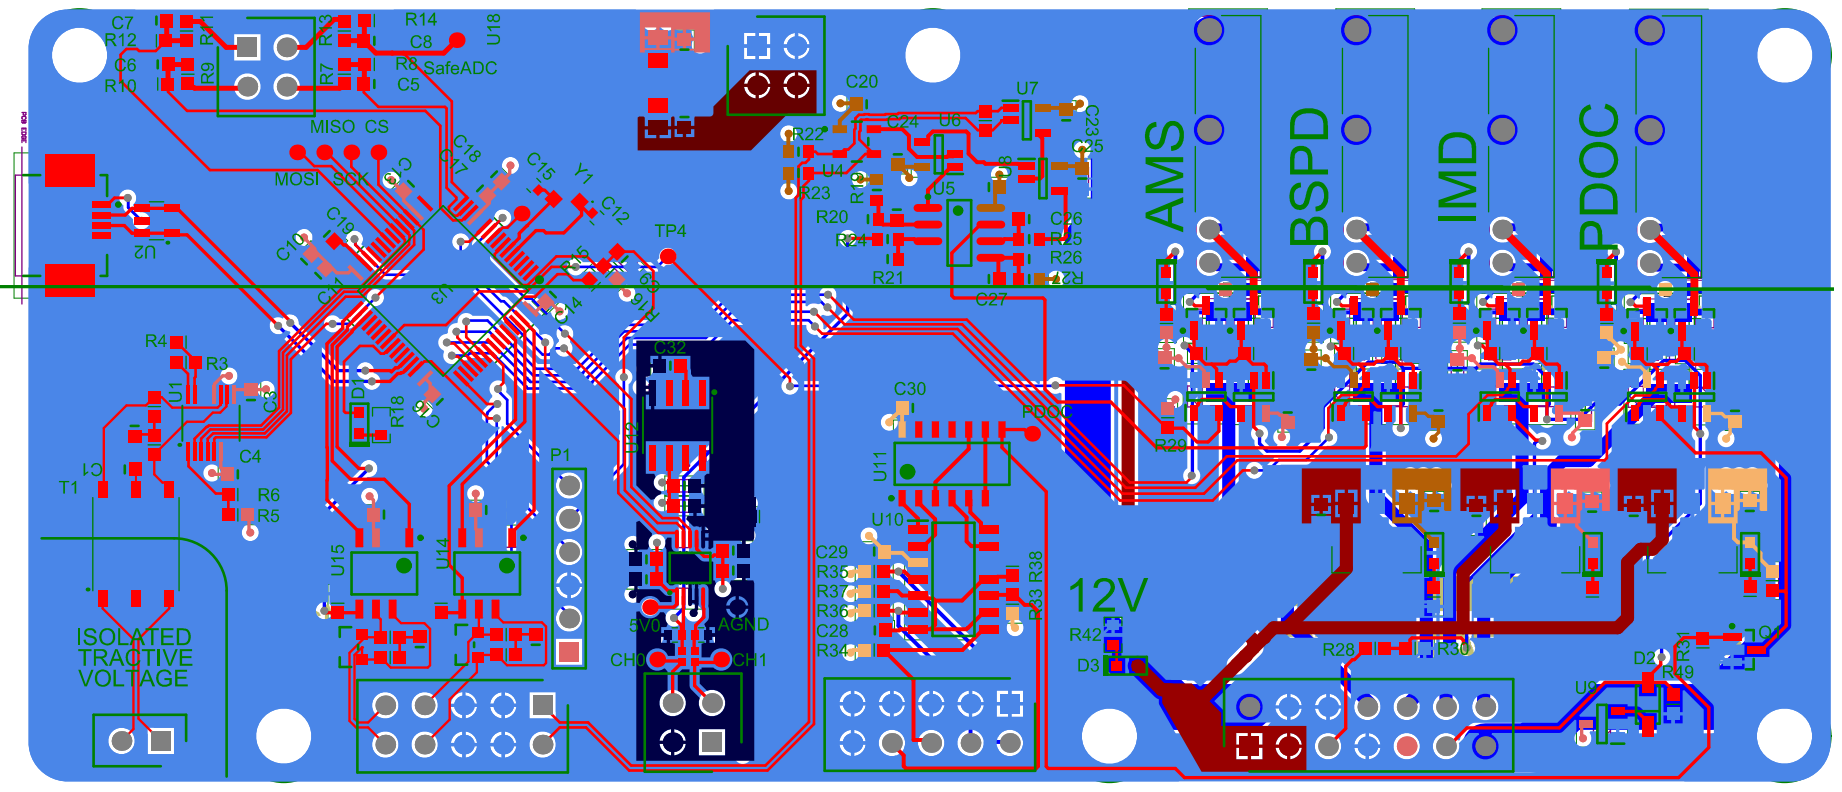
[picture p27: page 14]
