juppy10/HV_BMS/Hardware/PCB_Project/AFE.pdf

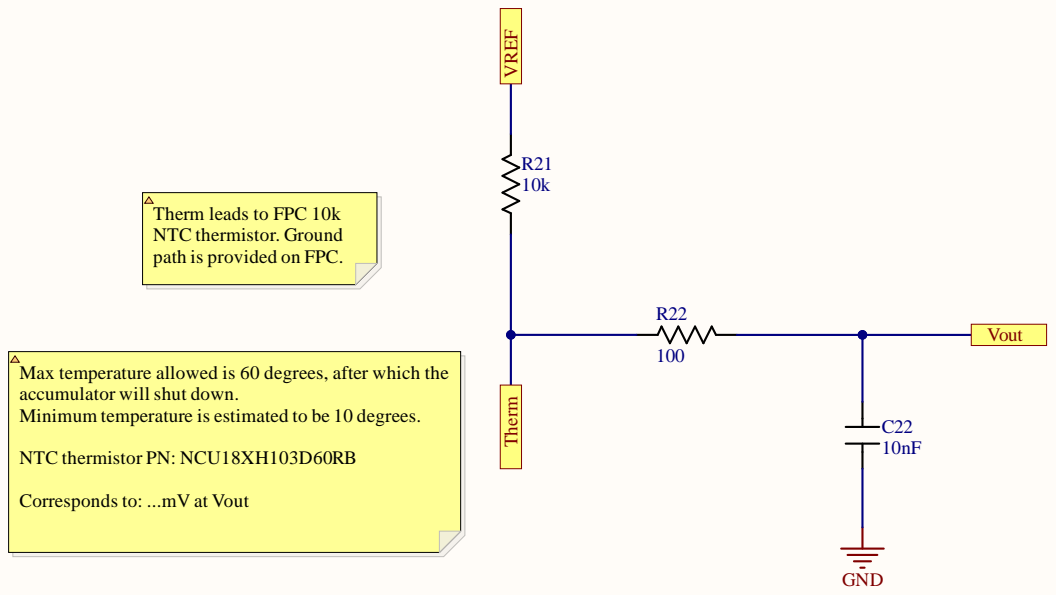
[picture p28: page 1]

Therm leads to FPC 10k
NTC thermistor. Ground
path is provided on FPC.

Max temperature allowed is 60 degrees, after which the
accumulator will shut down.
Minimum temperature is estimated to be 10 degrees.

Corresponds to: ...mV at Vout

Title AFE.SchDoc

Author William Jupp | Version
