juppy10/HV_BMS/Hardware/PCB_Project/Balance_Circuit.pdf

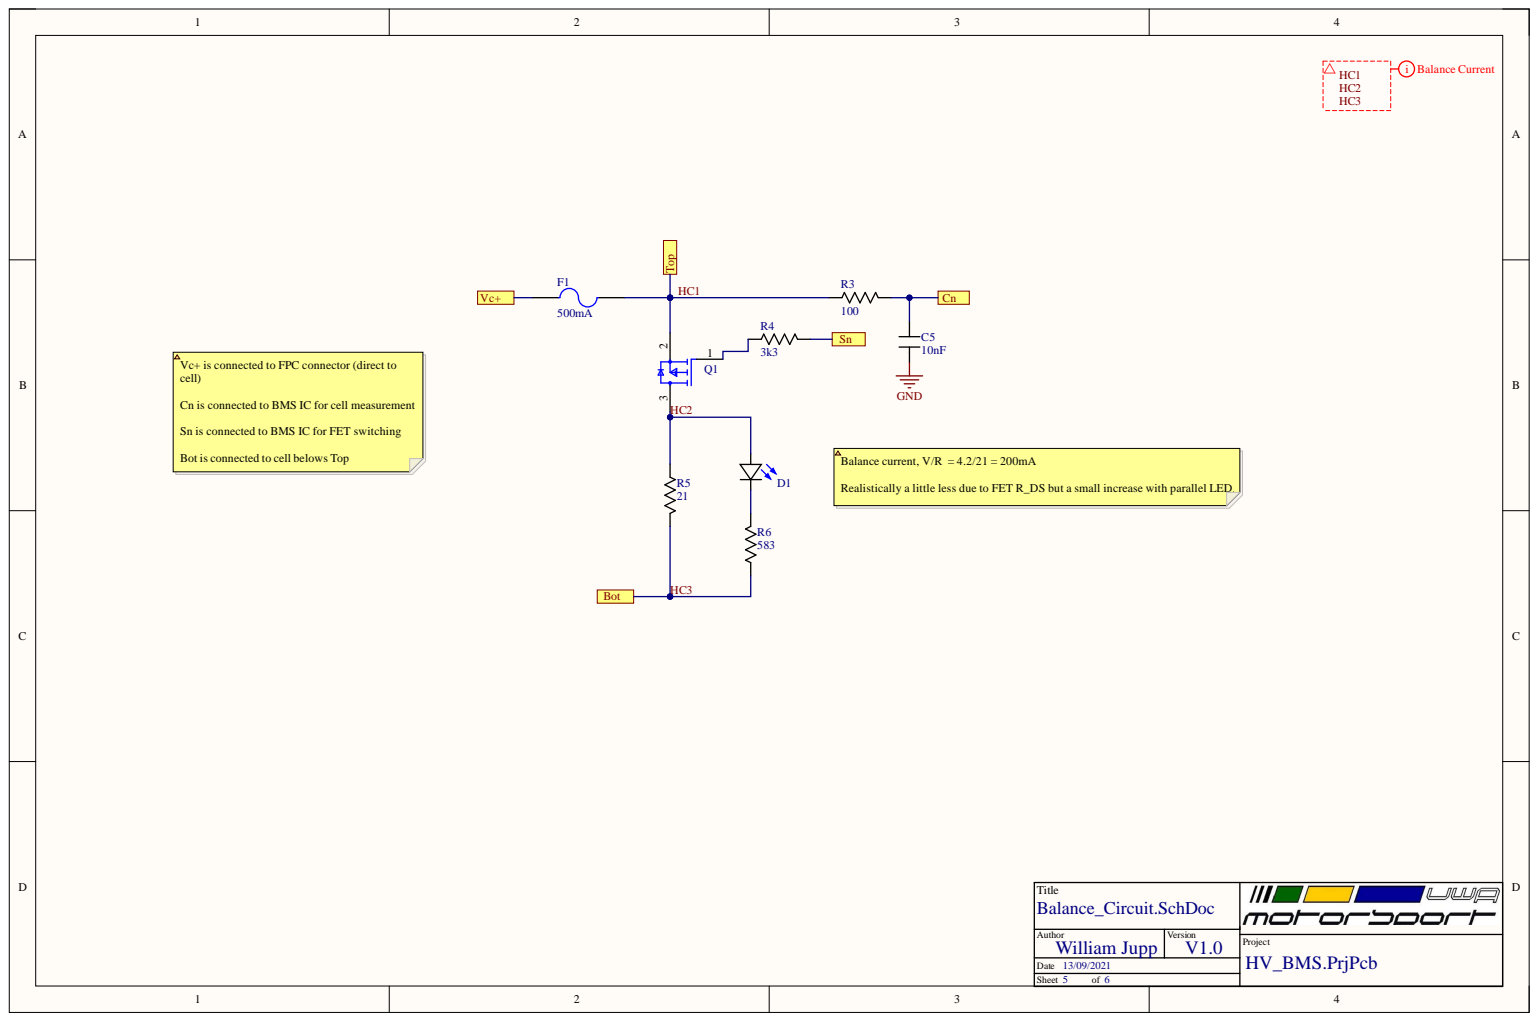
[picture p29: page 1]

Vc+ is connected to FPC connector (direct to
cell)

Cn is connected to BMS IC for cell measurement

Sn is connected to BMS IC for FET switching

Bot is connected to cell belows Top

Realistically a little less due to FET R_DS but a small increase with parallel LED.

Title Balance_Circuit.SchDoc

Author William Jupp | Version
