juppy10/HV_BMS/Hardware/PCB_Project/HV_BMS.pdf

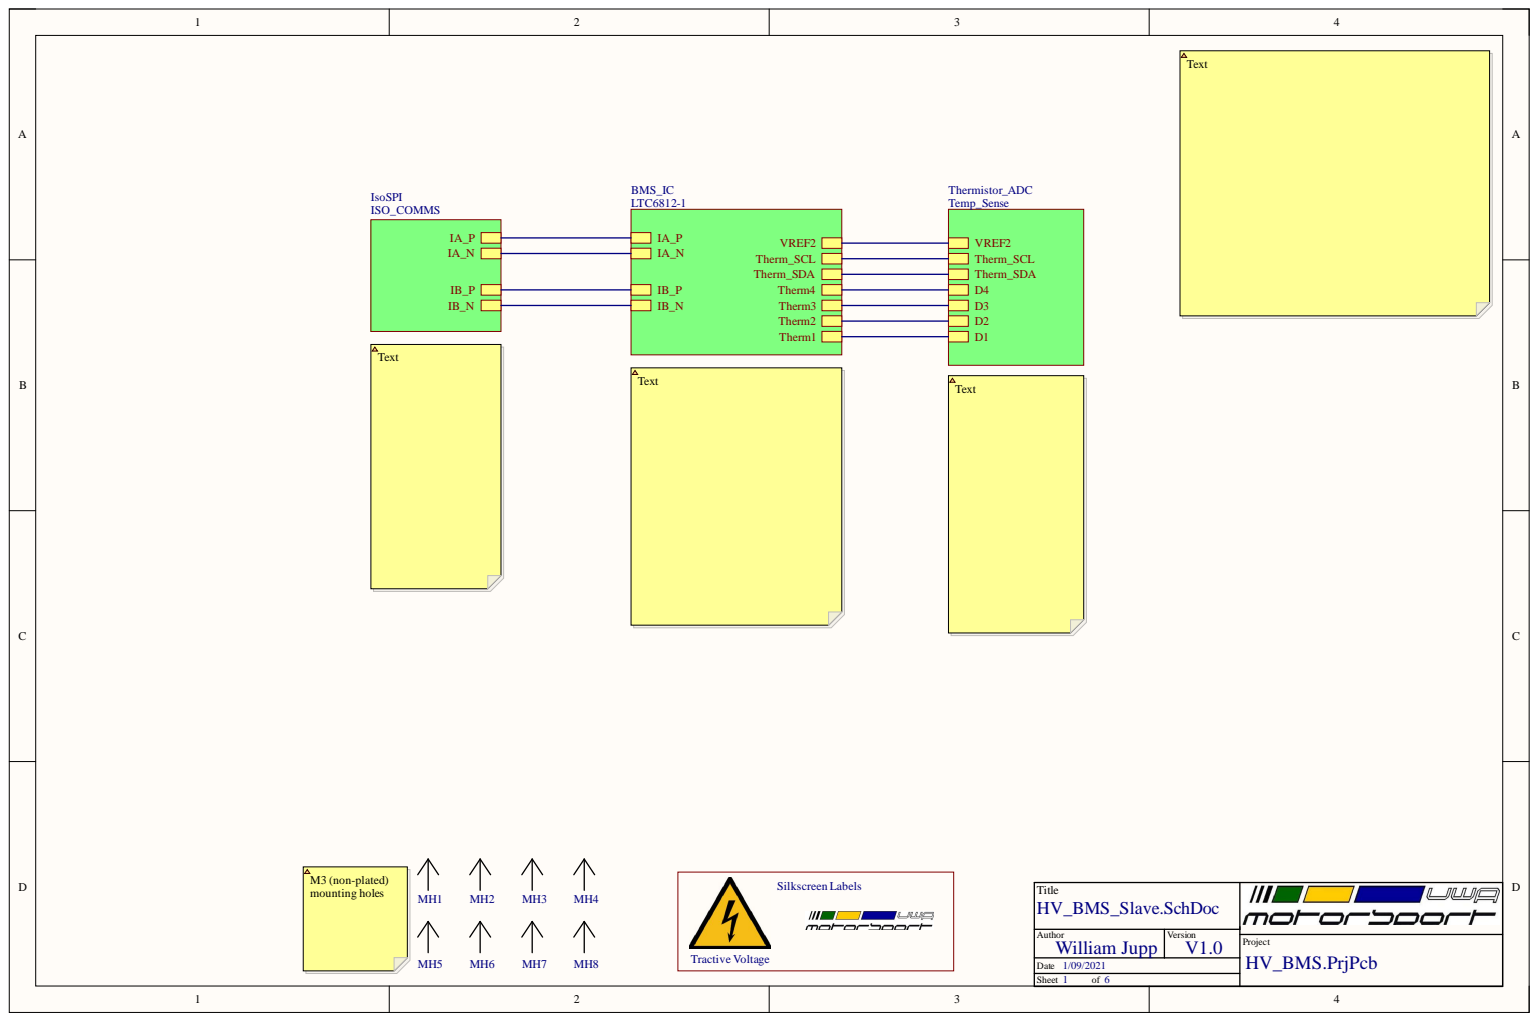
[picture p30: page 1]

T i tl e HV_BMS_Slave.S c h D o c

Author William Ju p p | Ve r s i o n

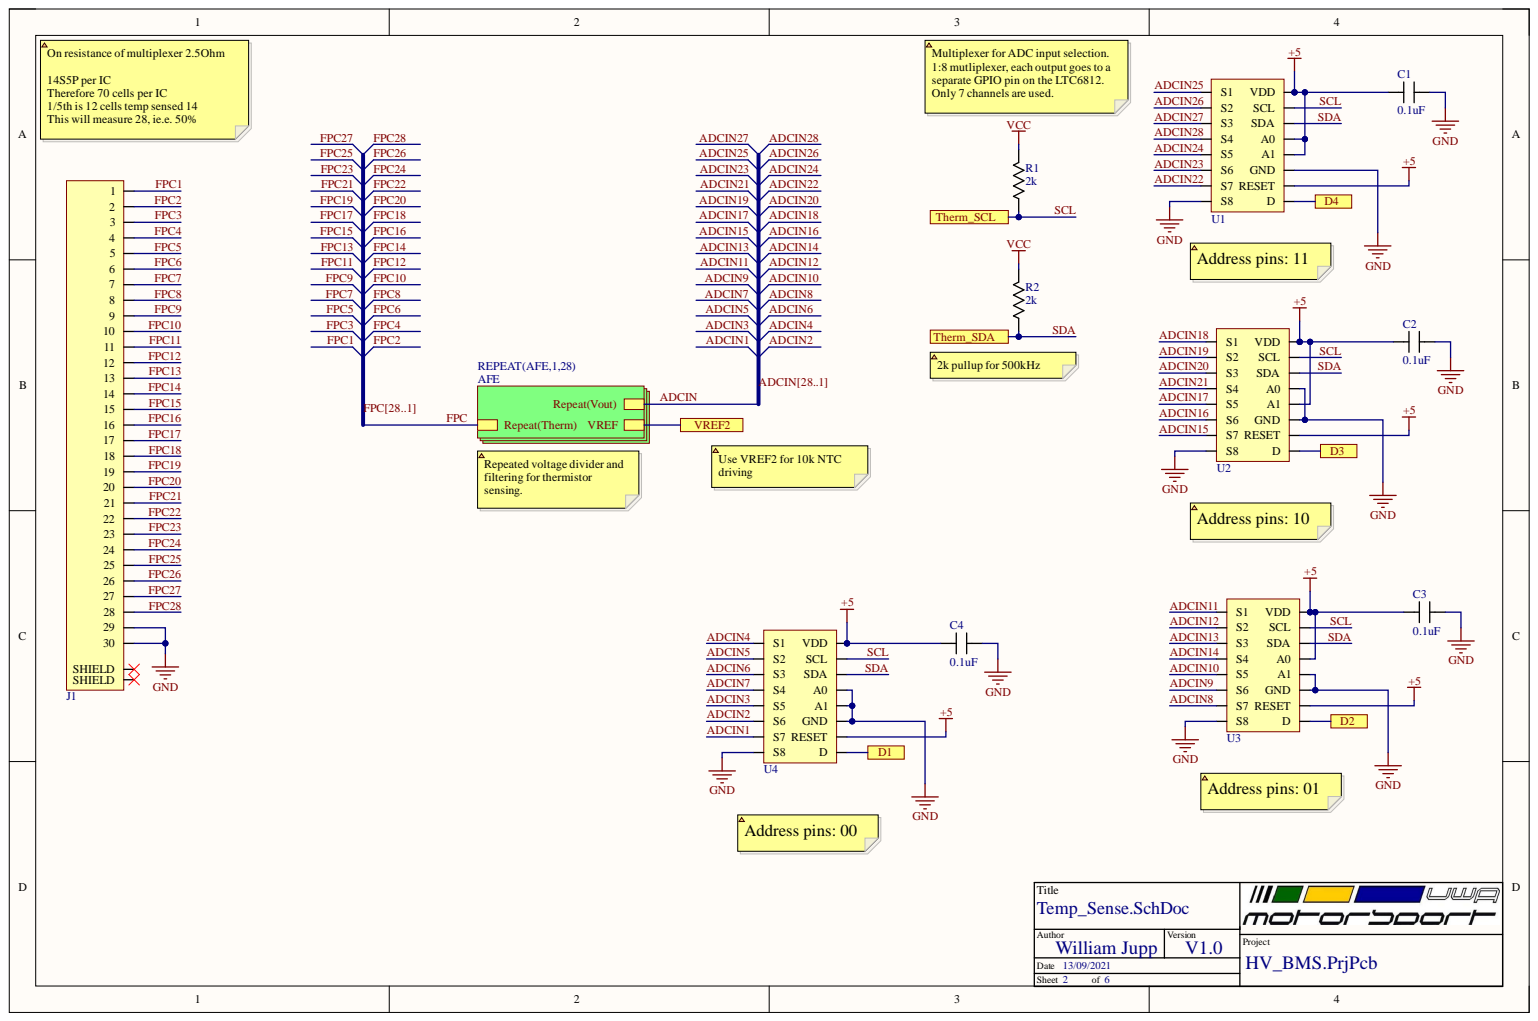
[picture p31: page 2]

DCIN
Address pins: 01 Address pins: 10 Address pins: 11

T i tl e Temp _Sense.Sc h D o c

Author William Ju p | Ve r s i o n

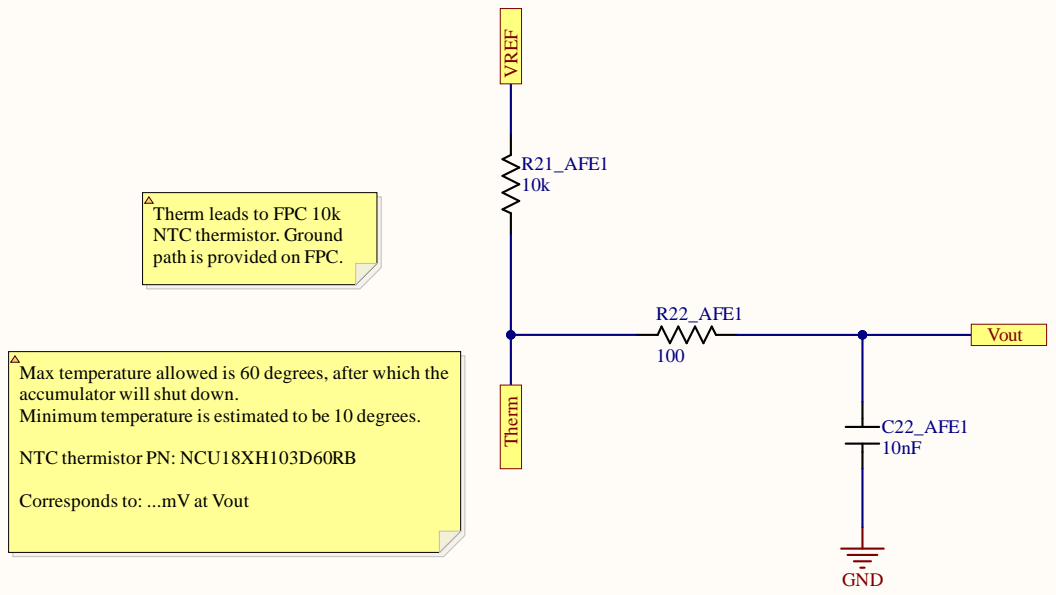
[picture p32: page 3]

T i tl e AFE.Sch D o c

Author William Ju p p | Ve r s i o n

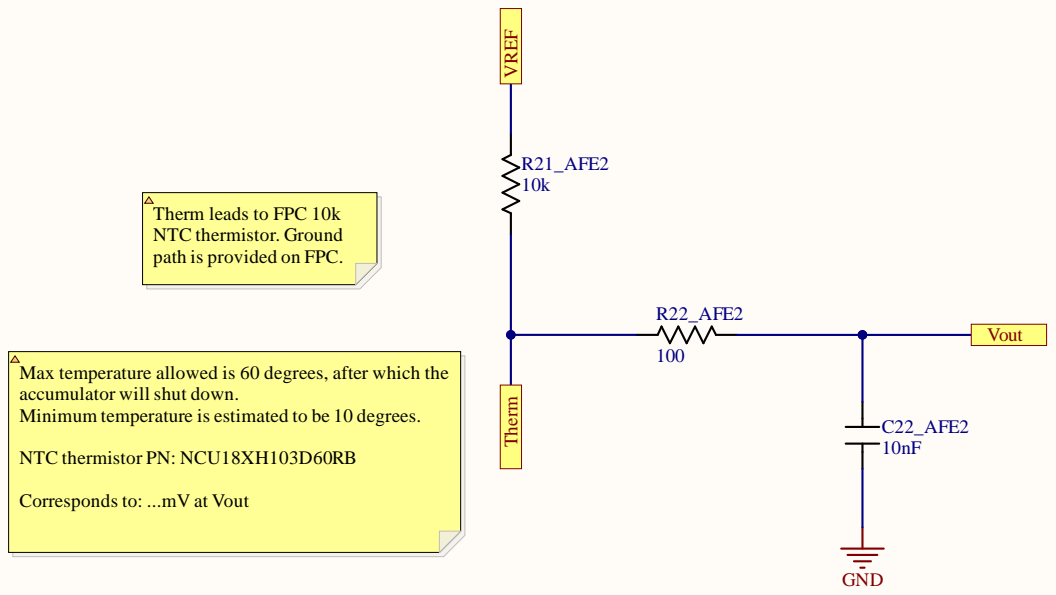
[picture p33: page 4]

T i tl e AFE.Sch D o c

Author William Ju p p | Ve r s i o n

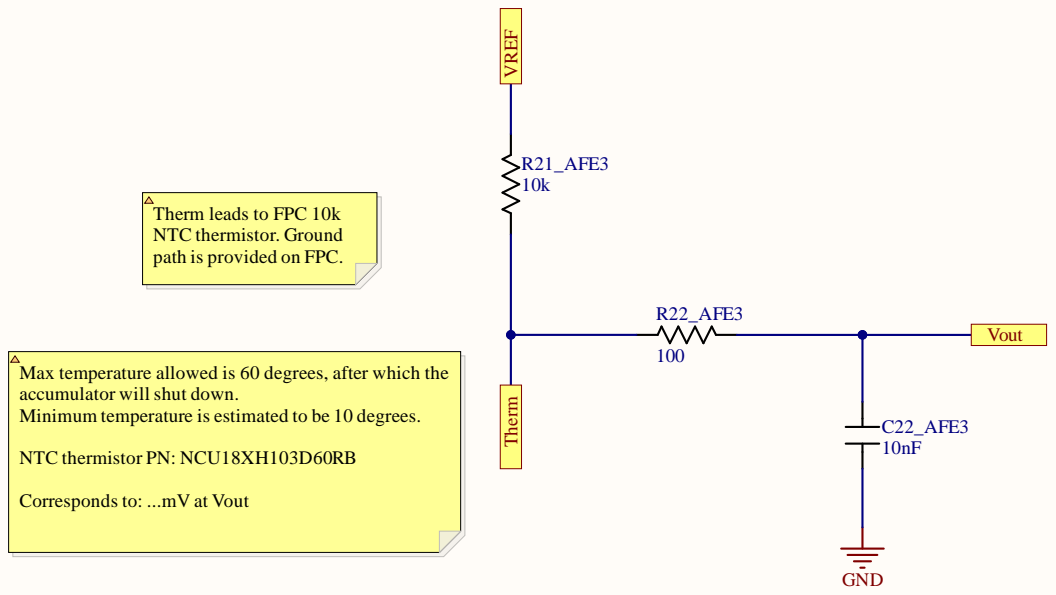
[picture p34: page 5]

T i tl e AFE.Sch D o c

Author William Ju p p | Ve r s i o n

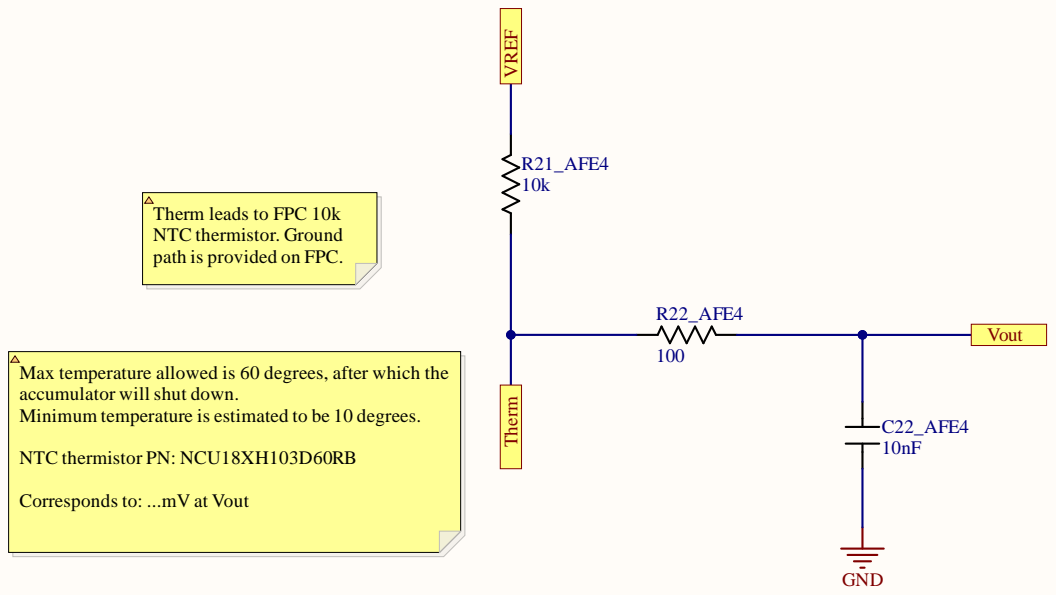
[picture p35: page 6]

T i tl e AFE.Sch D o c

Author William Ju p p | Ve r s i o n

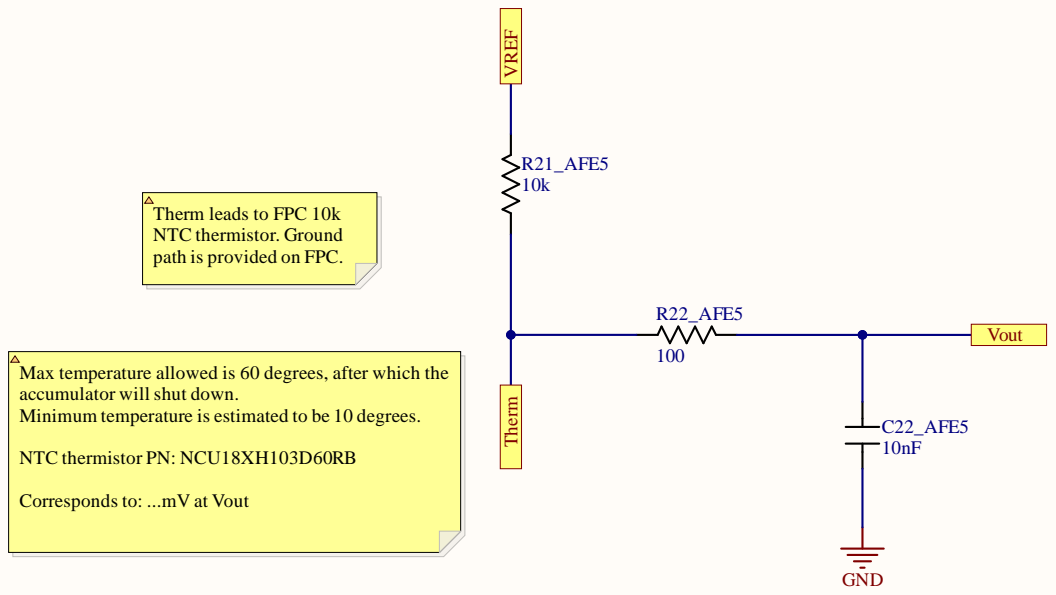
[picture p36: page 7]

T i tl e AFE.Sch D o c

Author William Ju p p | Ve r s i o n

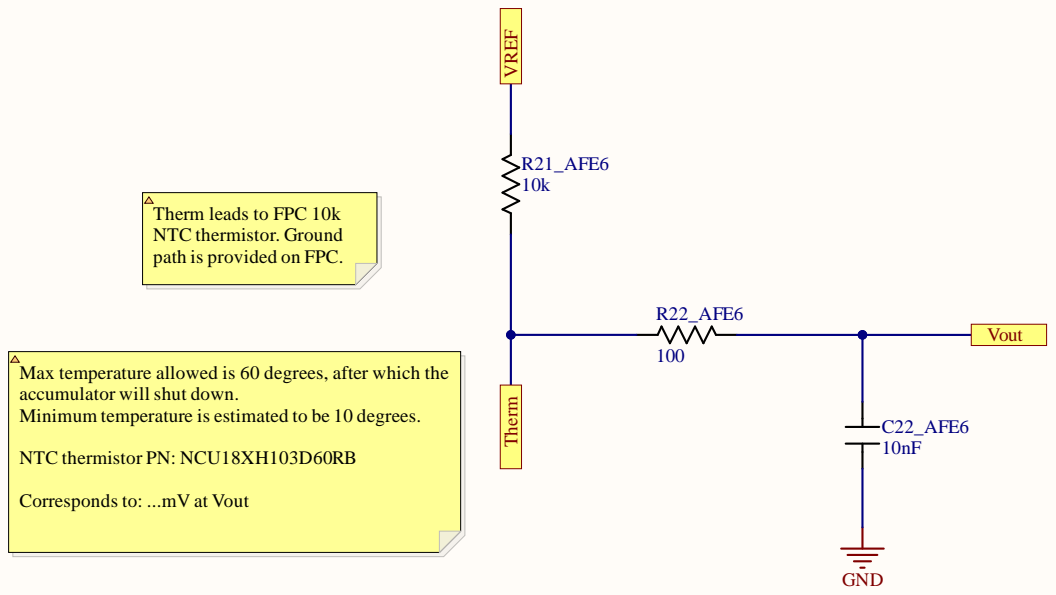
[picture p37: page 8]

T i tl e AFE.Sch D o c

Author William Ju p p | Ve r s i o n

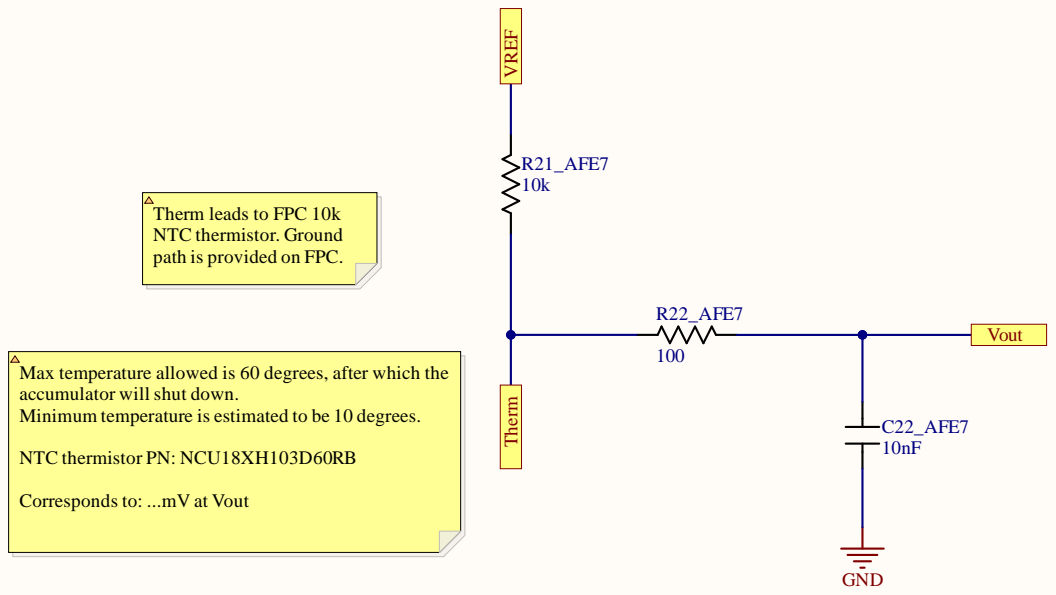
[picture p38: page 9]

T i tl e AFE.Sch D o c

Author William Ju p p | Ve r s i o n

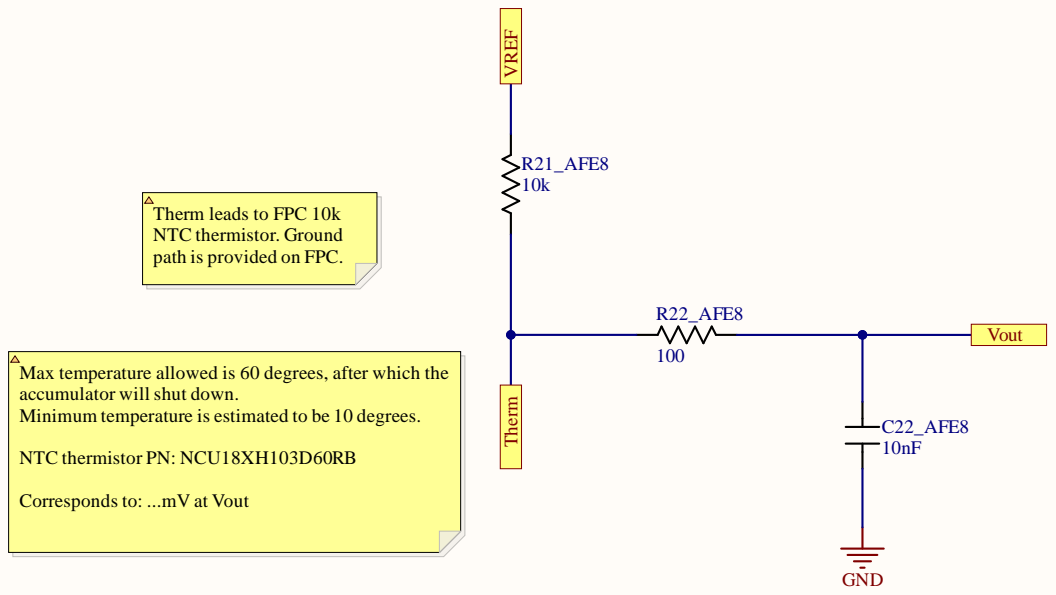
[picture p39: page 10]

T i tl e AFE.Sch D o c

Author William Ju p p | Ve r s i o n

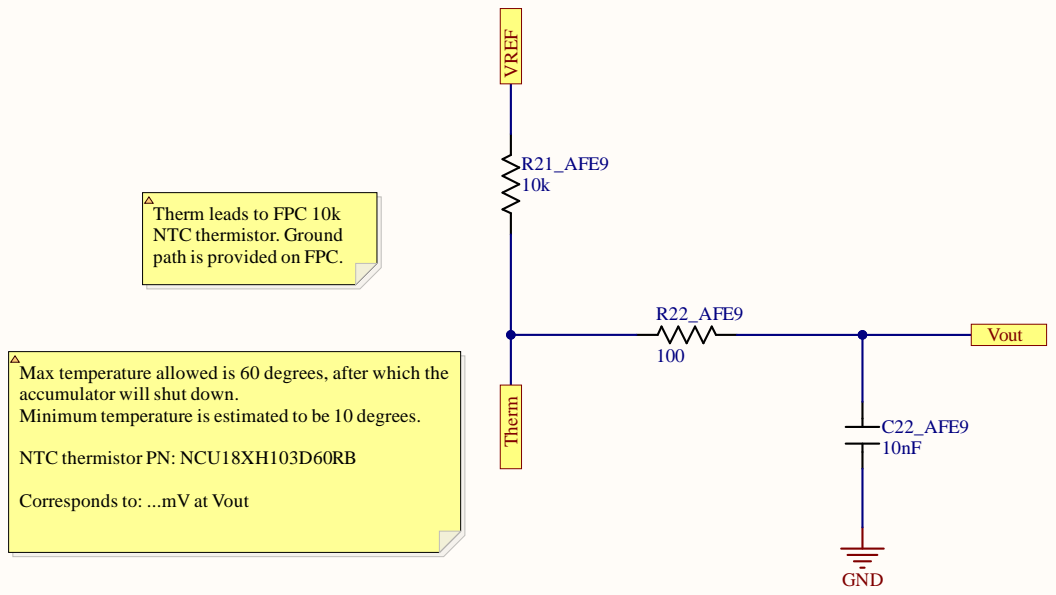
[picture p40: page 11]

T i tl e AFE.Sch D o c

Author William Ju p p | Ve r s i o n

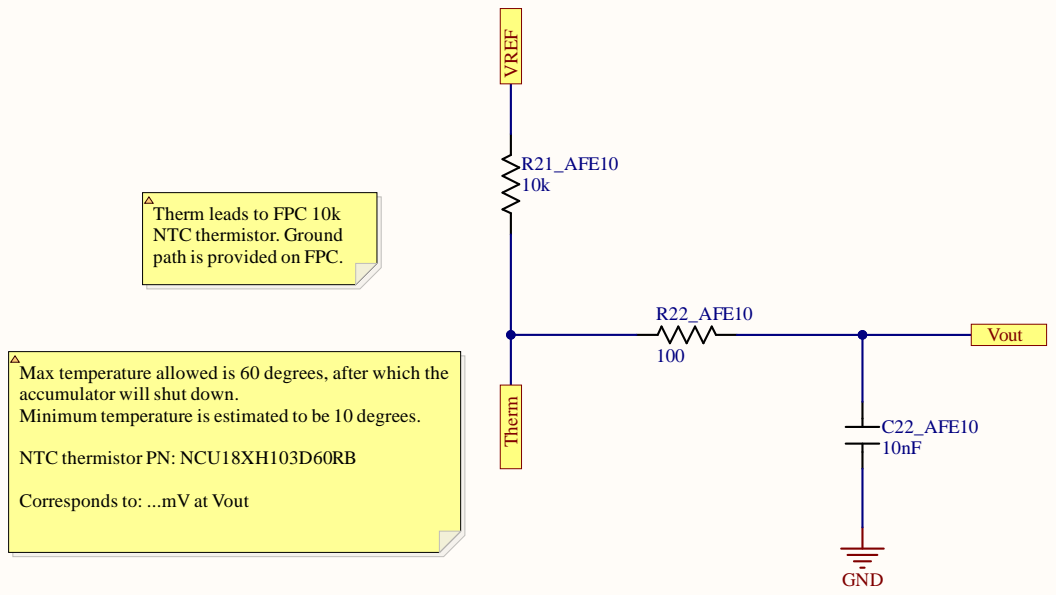
[picture p41: page 12]

T i tl e AFE.Sch D o c

Author William Ju p p | Ve r s i o n

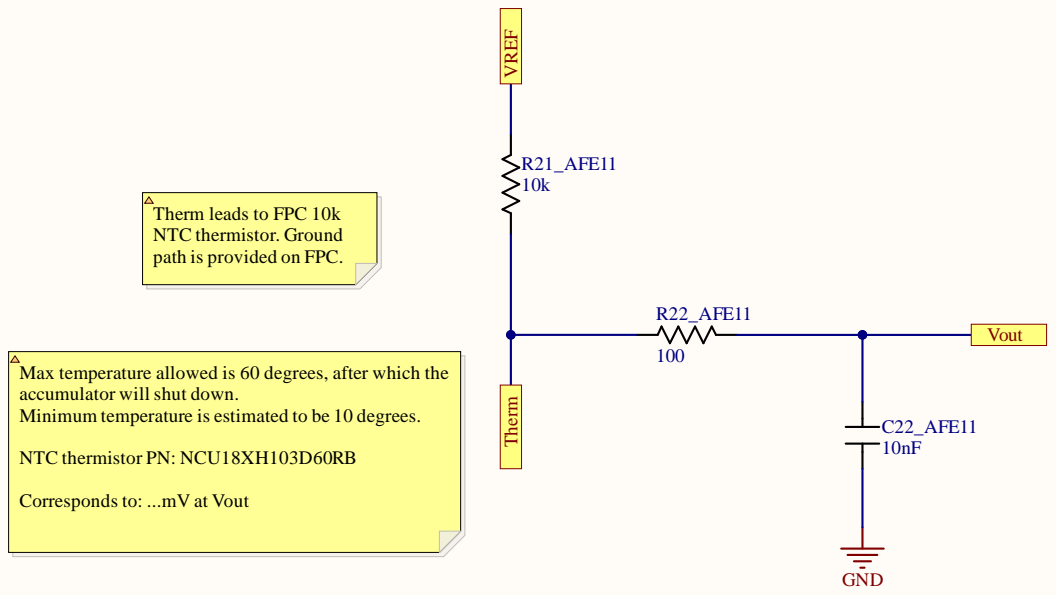
[picture p42: page 13]

T i tl e AFE.Sch D o c

Author William Ju p p | Ve r s i o n

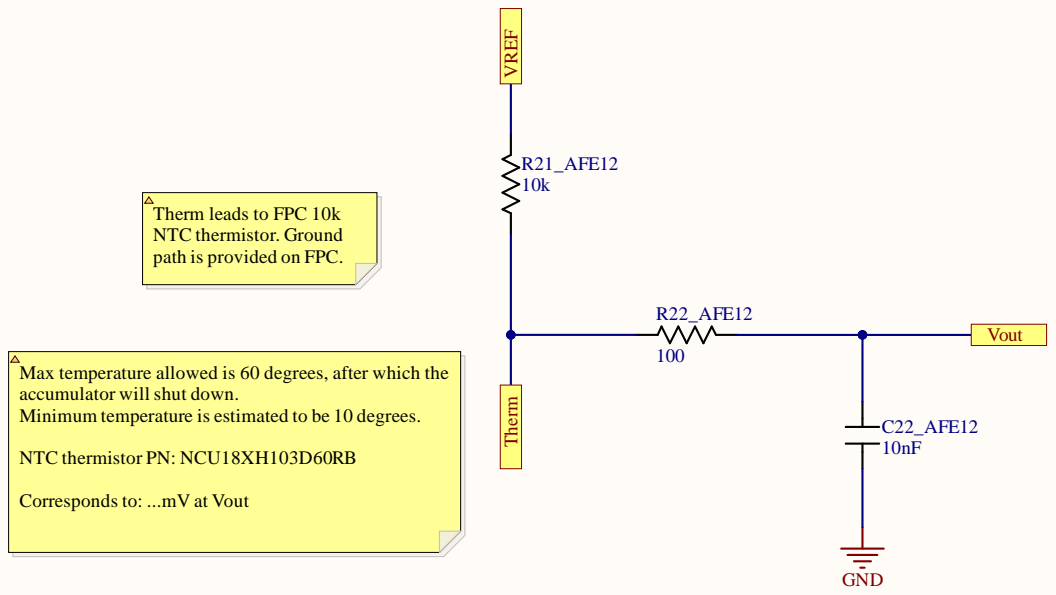
[picture p43: page 14]

T i tl e AFE.Sch D o c

Author William Ju p p | Ve r s i o n

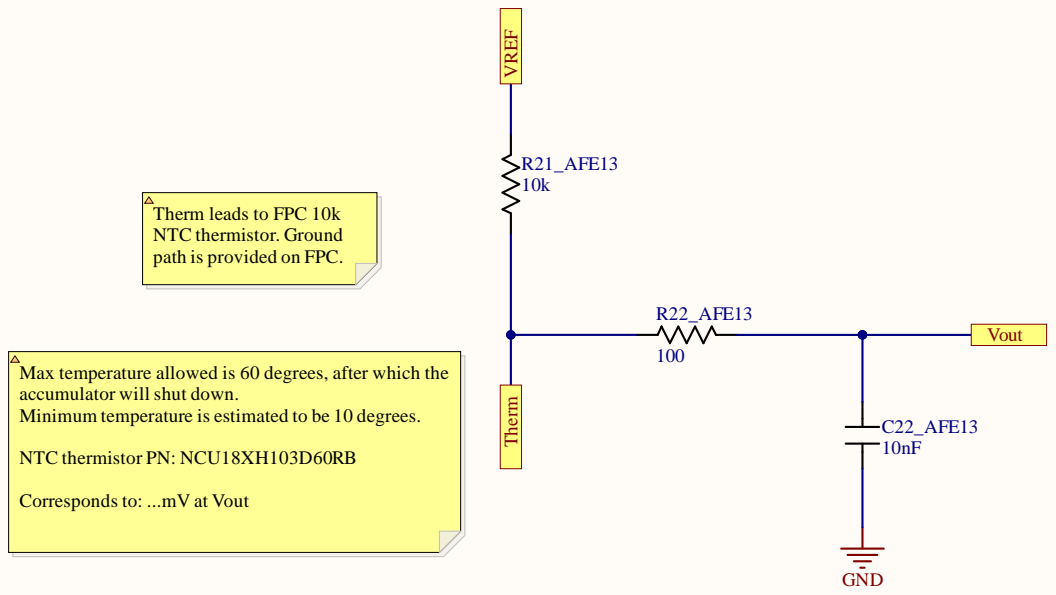
[picture p44: page 15]

T i tl e AFE.Sch D o c

Author William Ju p p | Ve r s i o n

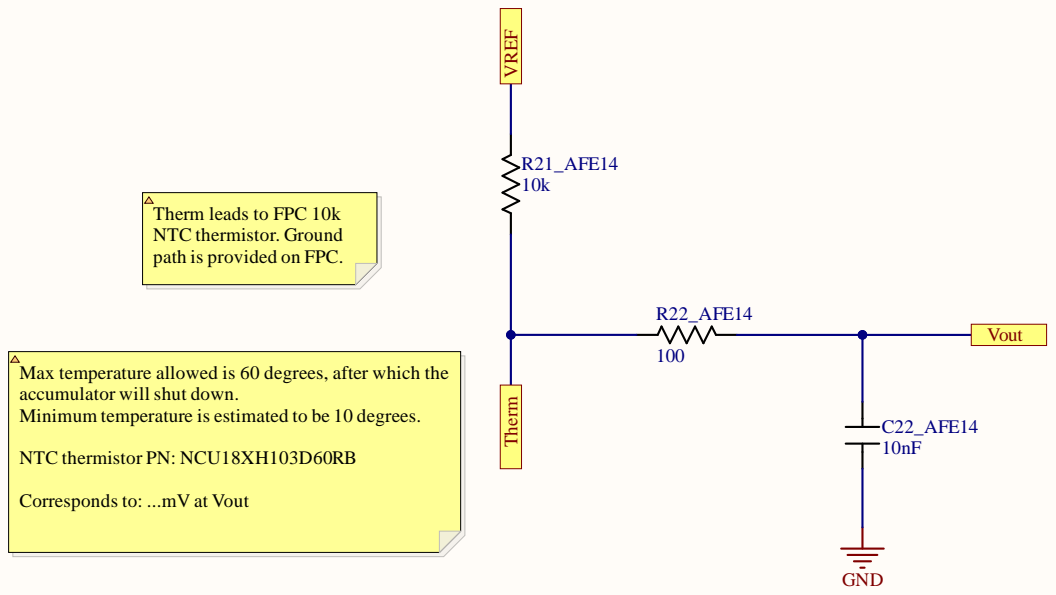
[picture p45: page 16]

T i tl e AFE.Sch D o c

Author William Ju p p | Ve r s i o n

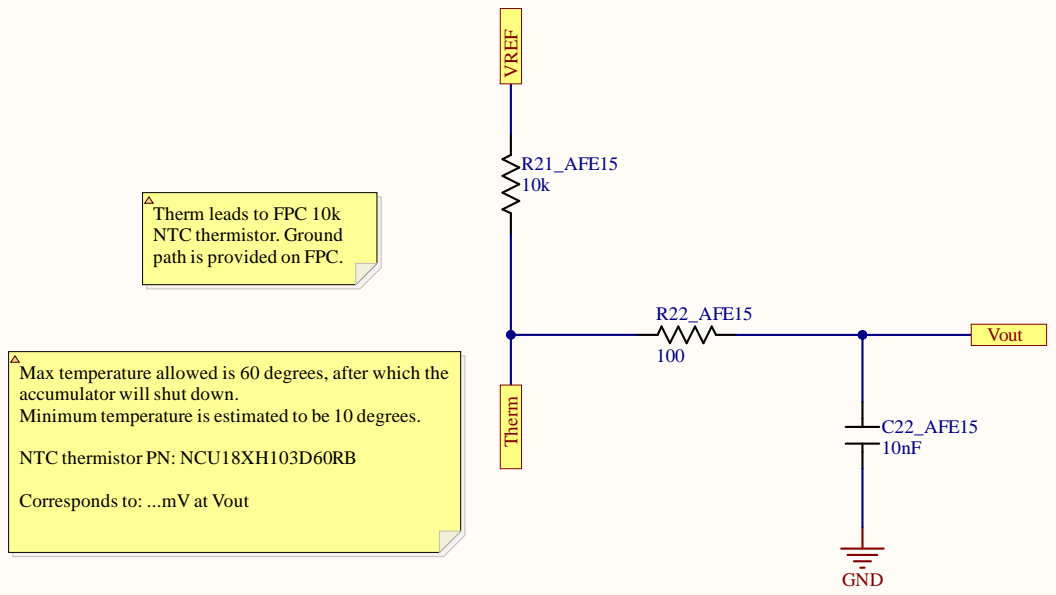
[picture p46: page 17]

T i tl e AFE.Sch D o c

Author William Ju p p | Ve r s i o n

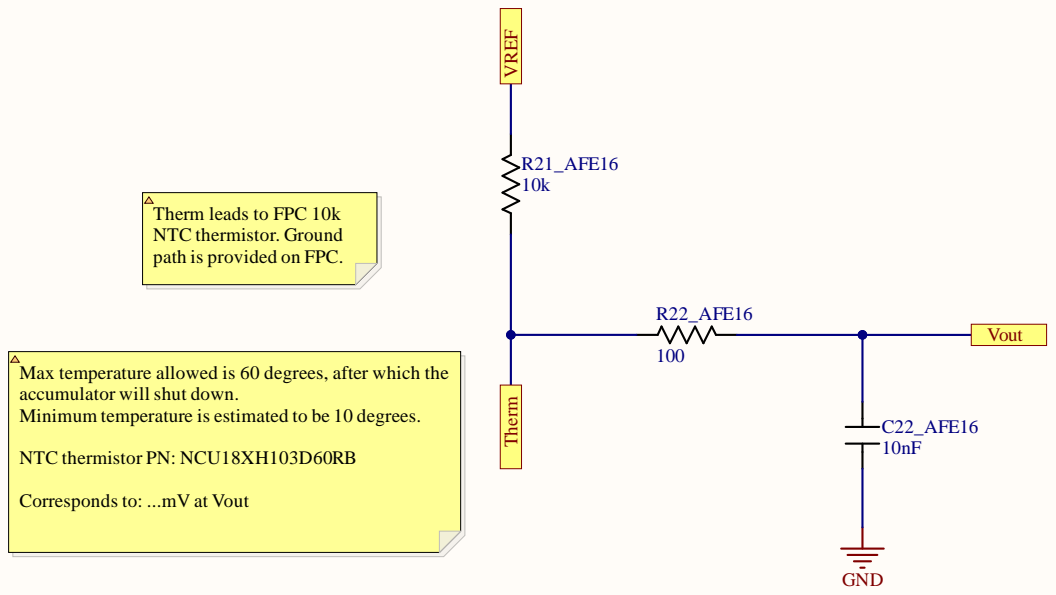
[picture p47: page 18]

T i tl e AFE.Sch D o c

Author William Ju p p | Ve r s i o n

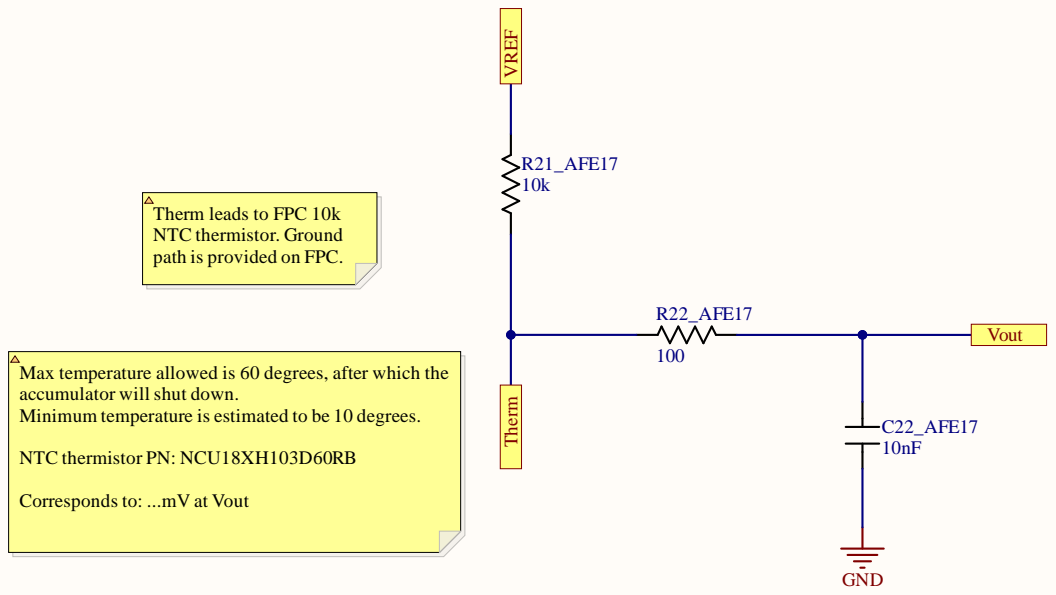
[picture p48: page 19]

T i tl e AFE.Sch D o c

Author William Ju p p | Ve r s i o n

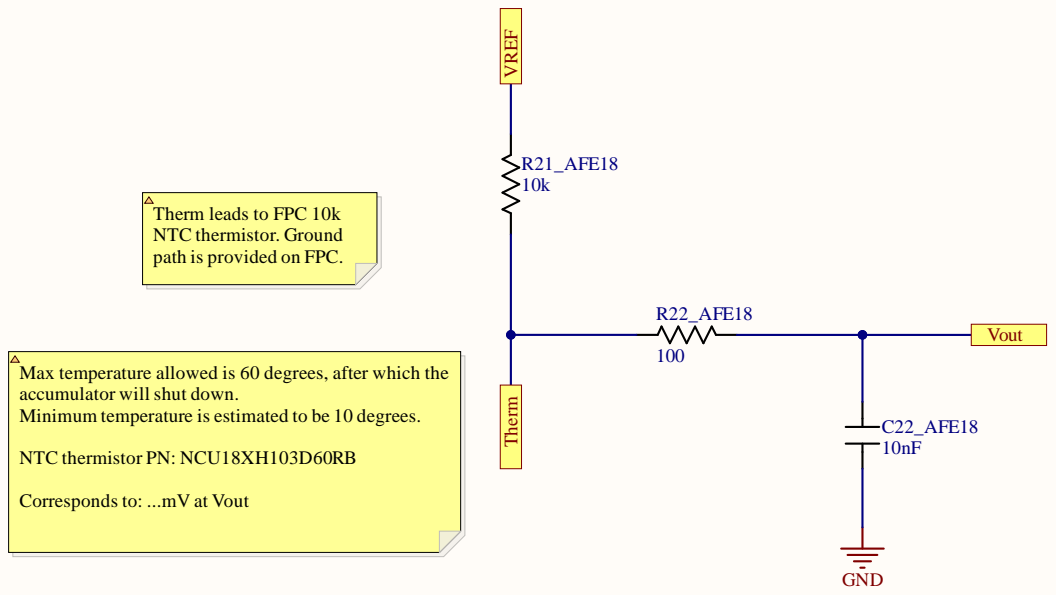
[picture p49: page 20]

T i tl e AFE.Sch D o c

Author William Ju p p | Ve r s i o n

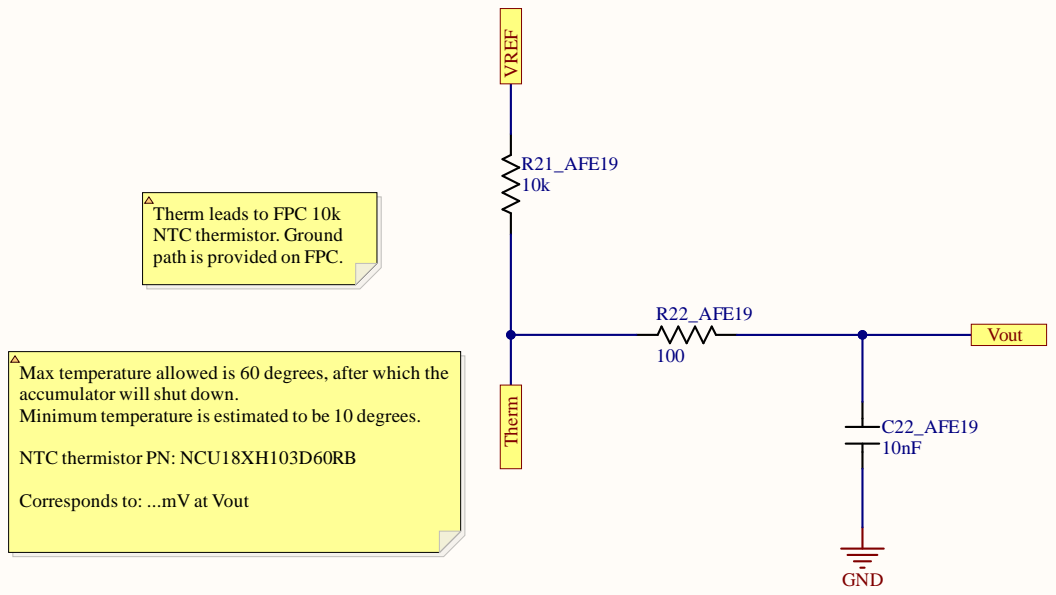
[picture p50: page 21]

T i tl e AFE.Sch D o c

Author William Ju p p | Ve r s i o n

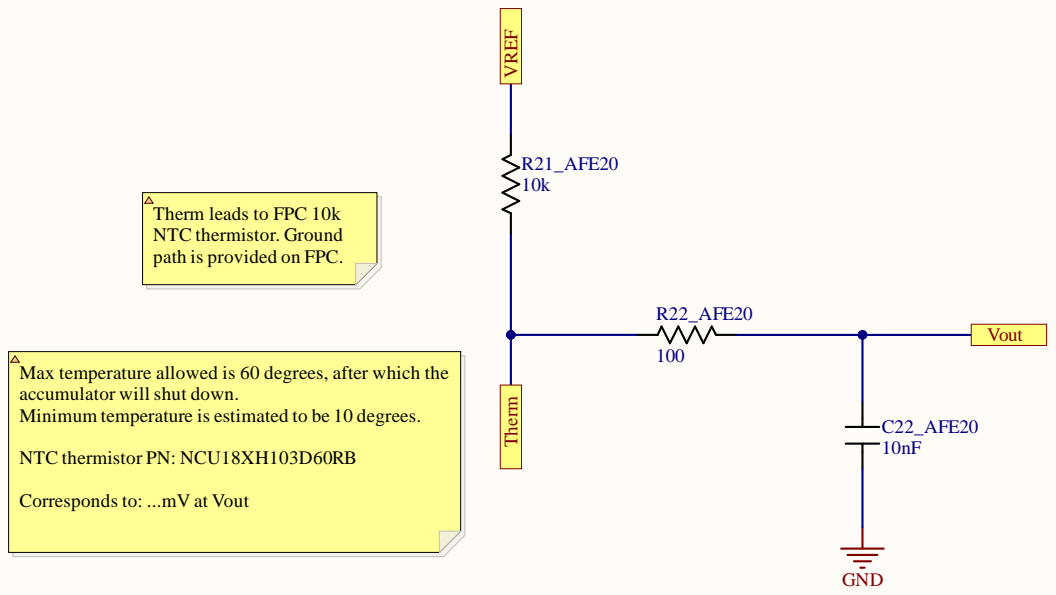
[picture p51: page 22]

T i tl e AFE.Sch D o c

Author William Ju p p | Ve r s i o n

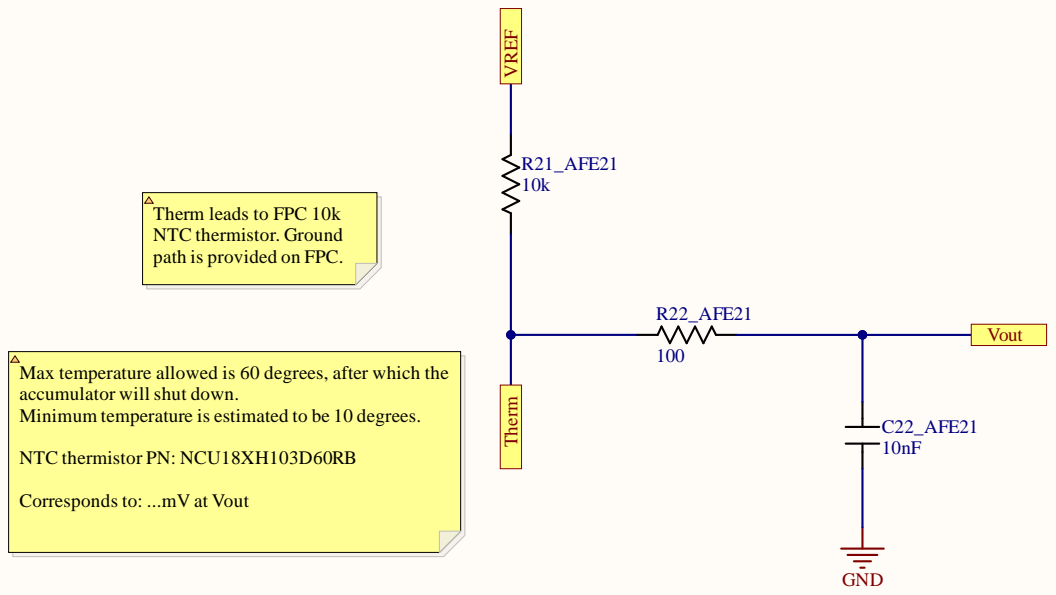
[picture p52: page 23]

T i tl e AFE.Sch D o c

Author William Ju p p | Ve r s i o n

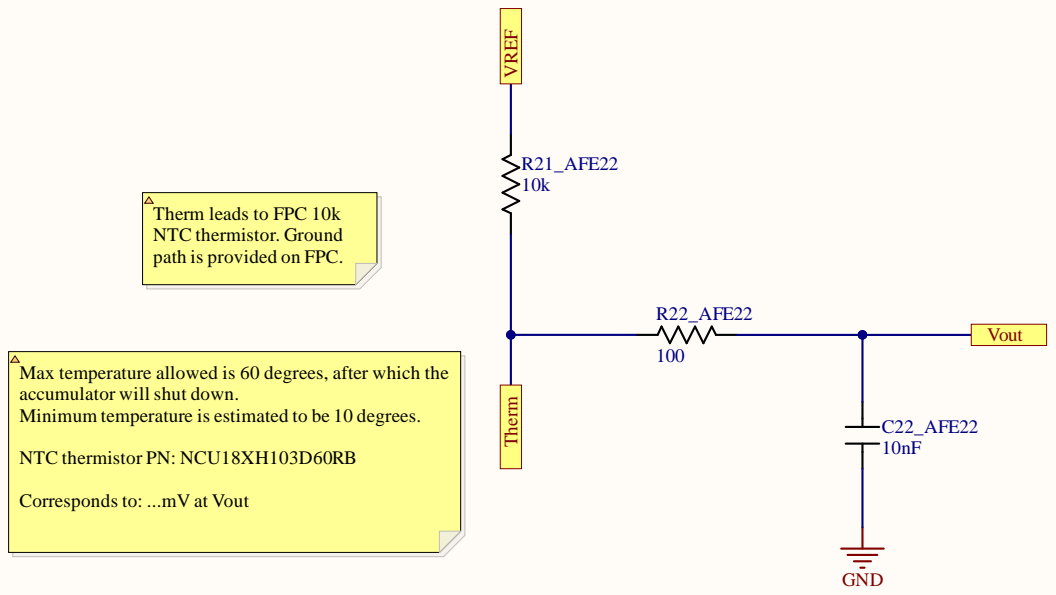
[picture p53: page 24]

T i tl e AFE.Sch D o c

Author William Ju p p | Ve r s i o n

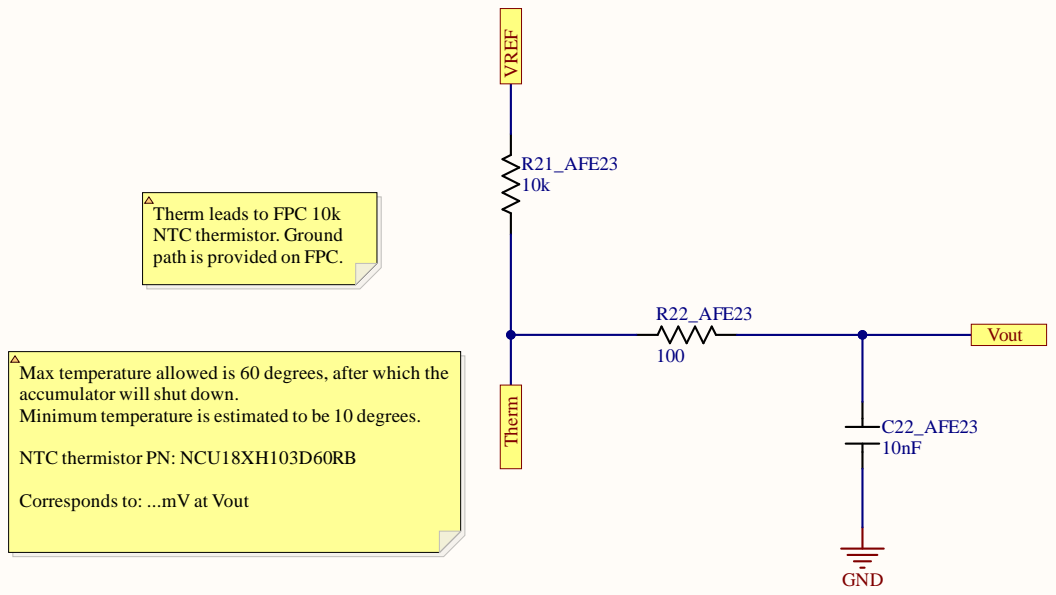
[picture p54: page 25]

T i tl e AFE.Sch D o c

Author William Ju p p | Ve r s i o n

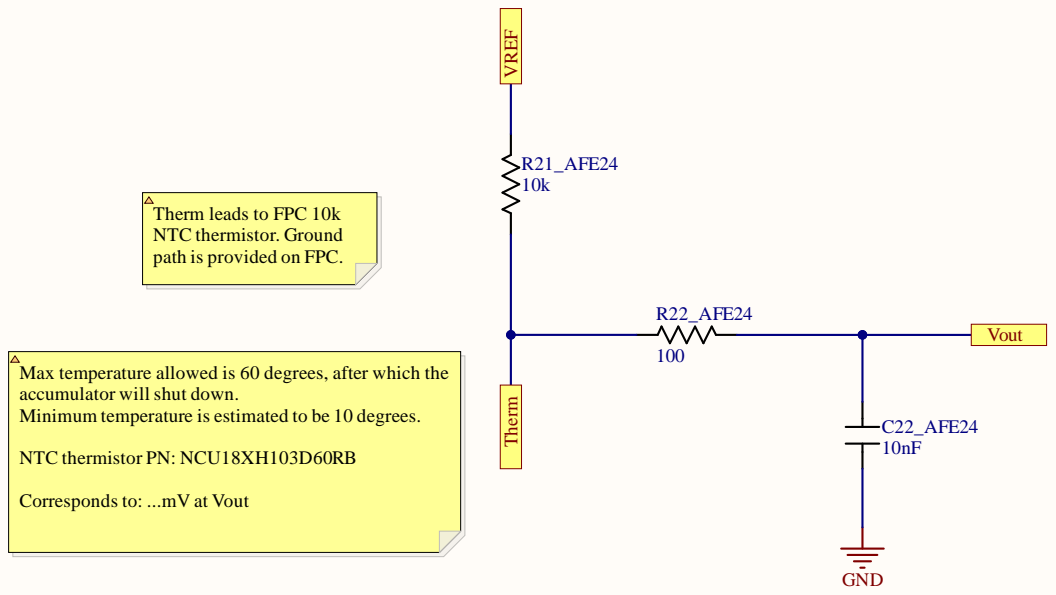
[picture p55: page 26]

T i tl e AFE.Sch D o c

Author William Ju p p | Ve r s i o n

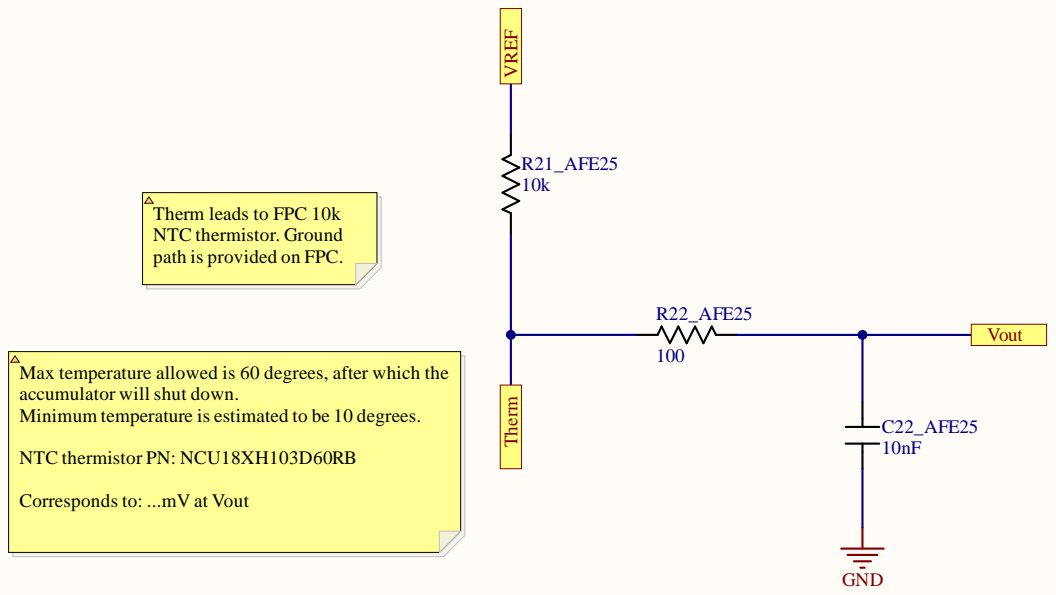
[picture p56: page 27]

T i tl e AFE.Sch D o c

Author William Ju p p | Ve r s i o n

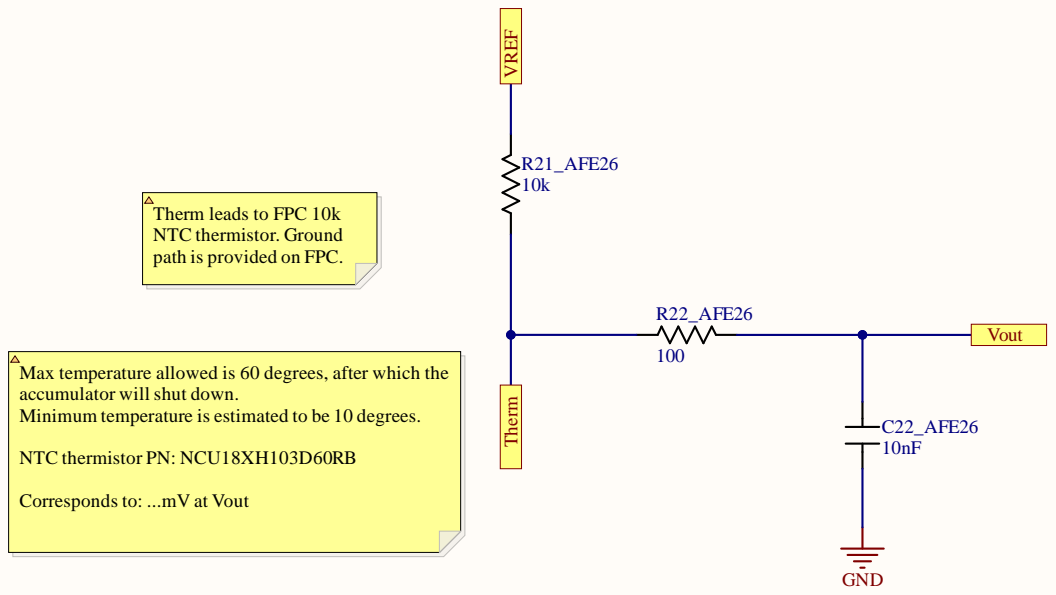
[picture p57: page 28]

T i tl e AFE.Sch D o c

Author William Ju p p | Ve r s i o n

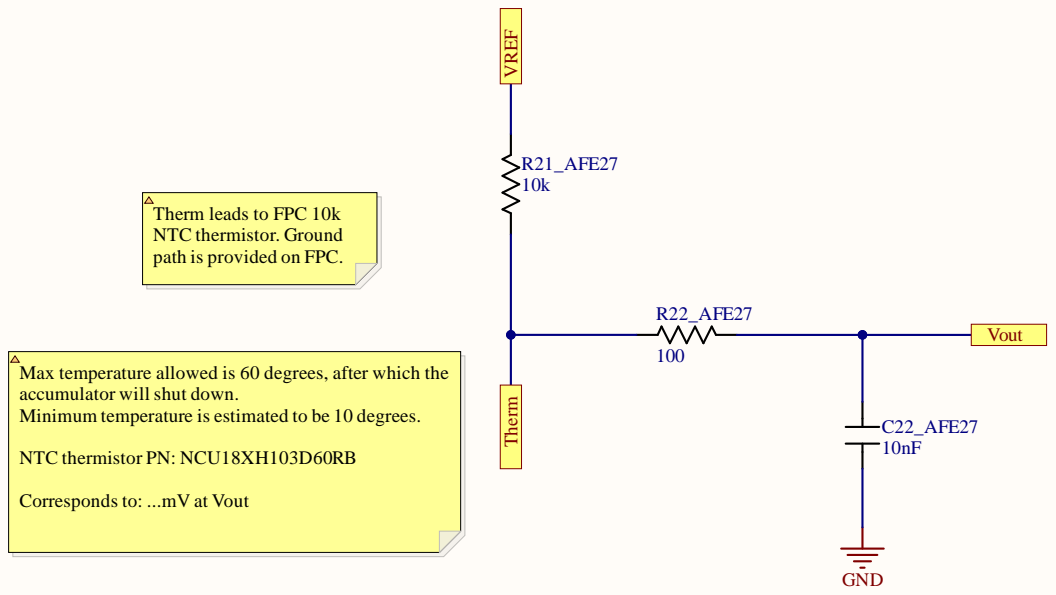
[picture p58: page 29]

T i tl e AFE.Sch D o c

Author William Ju p p | Ve r s i o n

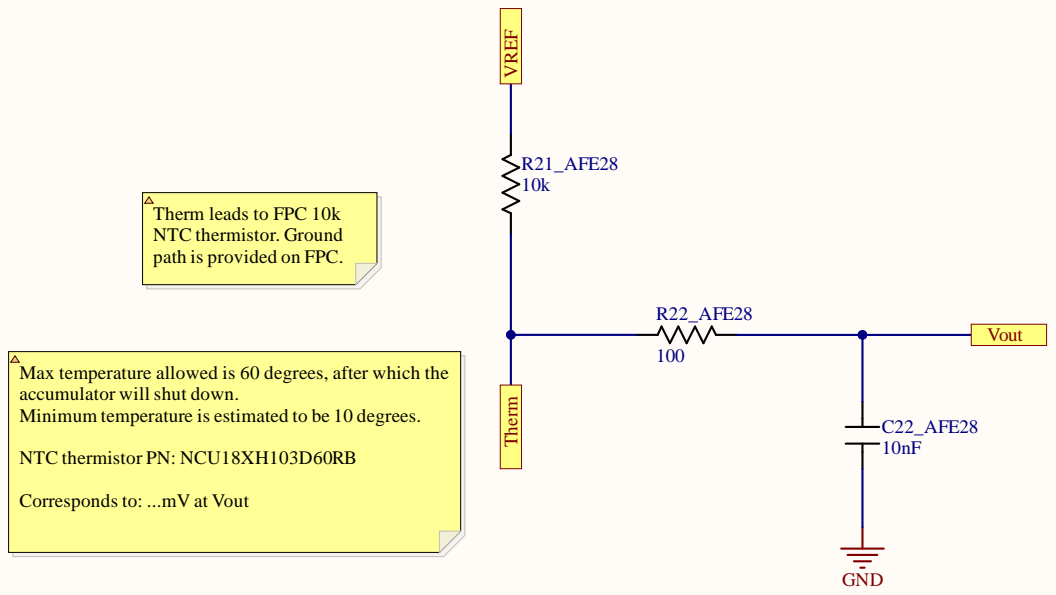
[picture p59: page 30]

T i tl e AFE.Sch D o c

Author William Ju p p | Ve r s i o n

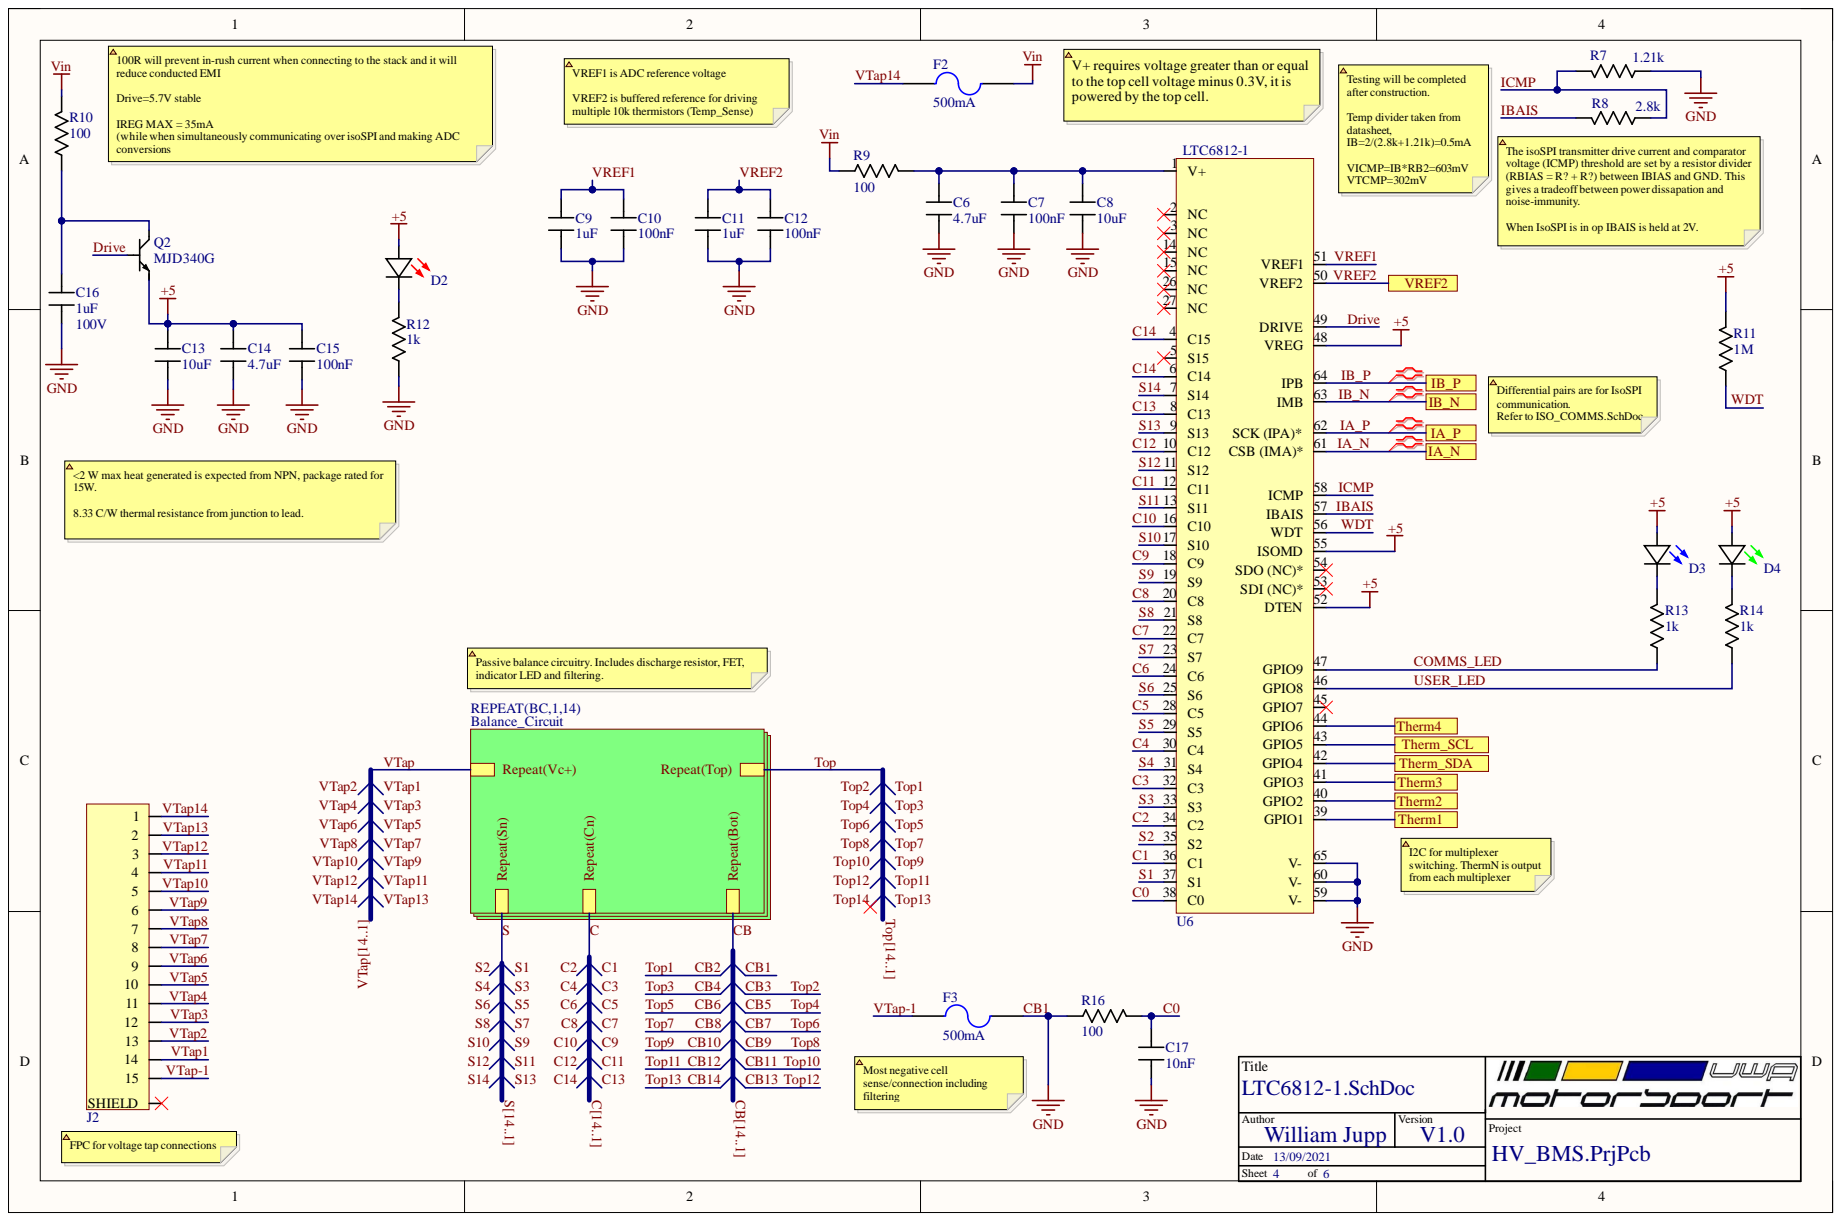
[picture p60: page 31]

from junction to le

Repeat(Sn) Repeat(Vc+

T i tl e LTC6 8 1 2-1.S c h D o c

Author William Ju p p | Ve r s i o n

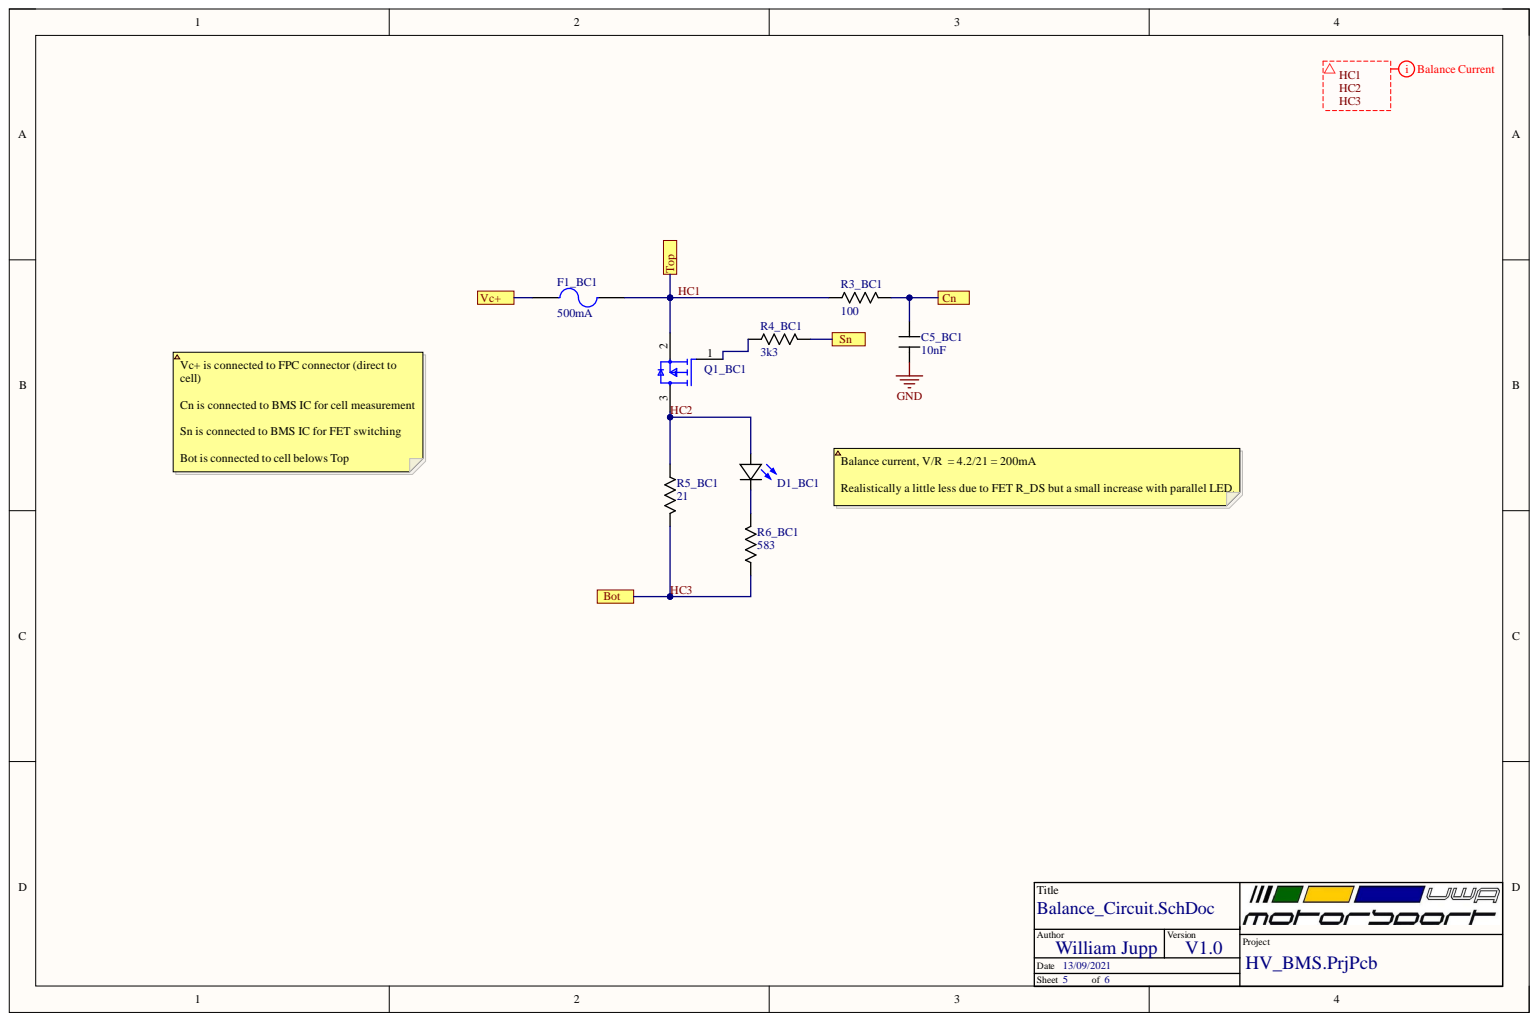
[picture p61: page 32]

Vc+ is connected to FPC connector (direct to
cell)

Cn is connected to BMS IC for cell measurement

Sn is connected to BMS IC for FET switching

Bot is connected to cell belows Top

Realistically a little less due to FET R_DS but a small increase with parallel LED.

Title Balance_Circuit.SchDoc

Author William Jupp | Version

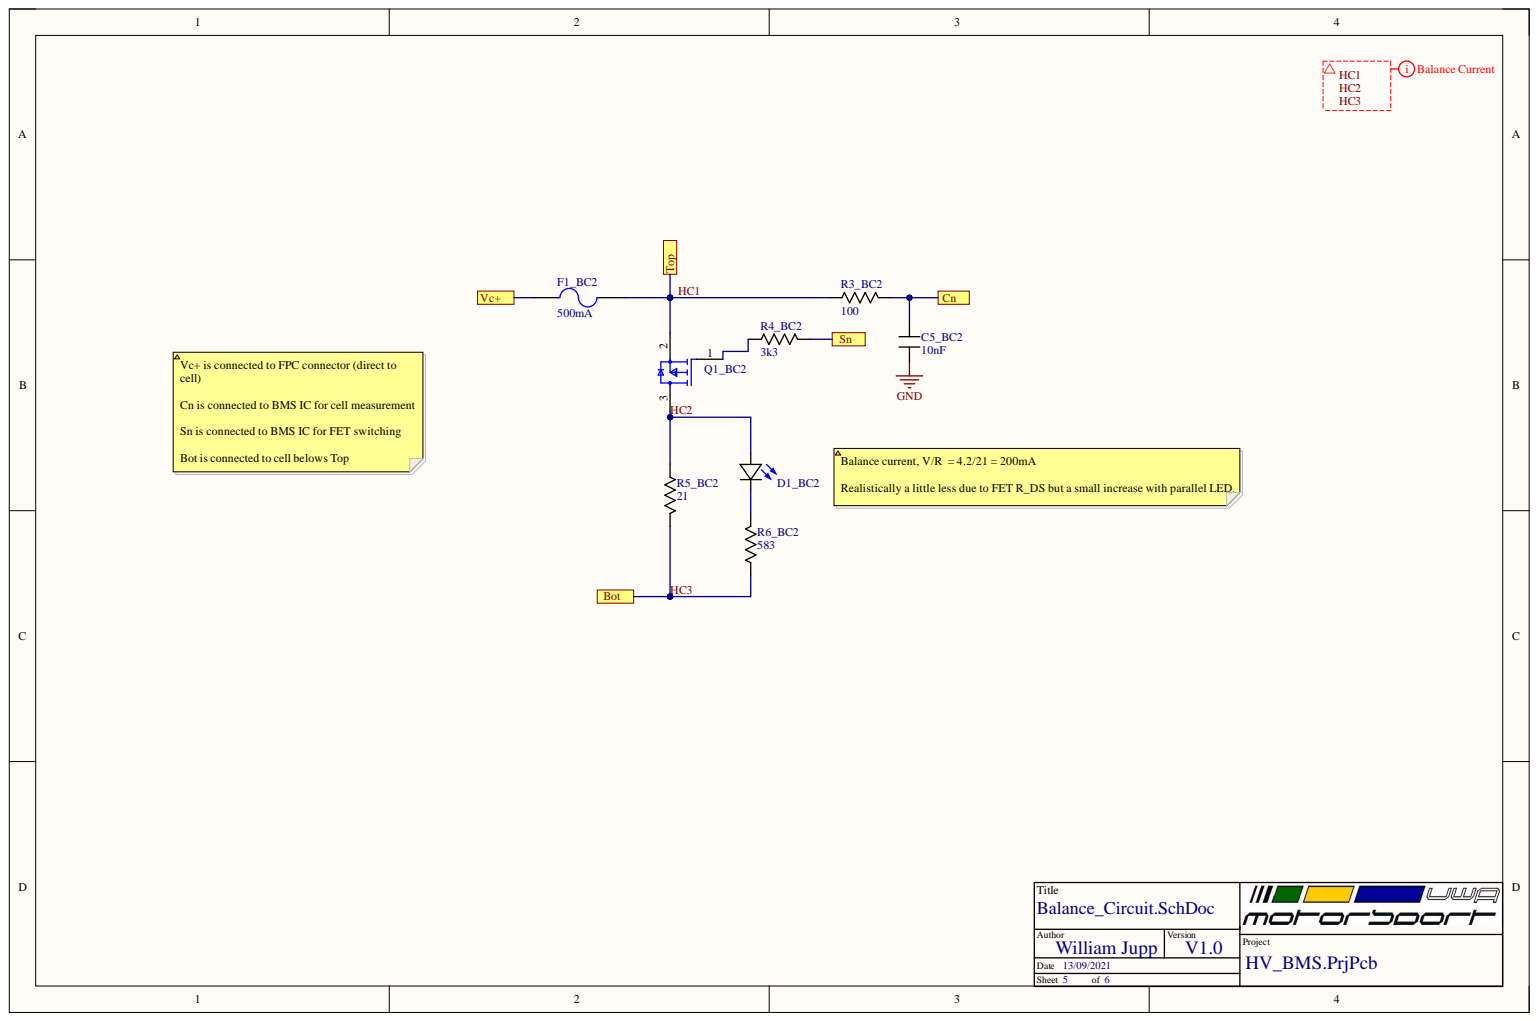
[picture p62: page 33]

Vc+ is connected to FPC connector (direct to
cell)

Cn is connected to BMS IC for cell measurement

Sn is connected to BMS IC for FET switching

Bot is connected to cell belows Top

Realistically a little less due to FET R_DS but a small increase with parallel LED.

Title Balance_Circuit.SchDoc

Author William Jupp | Version

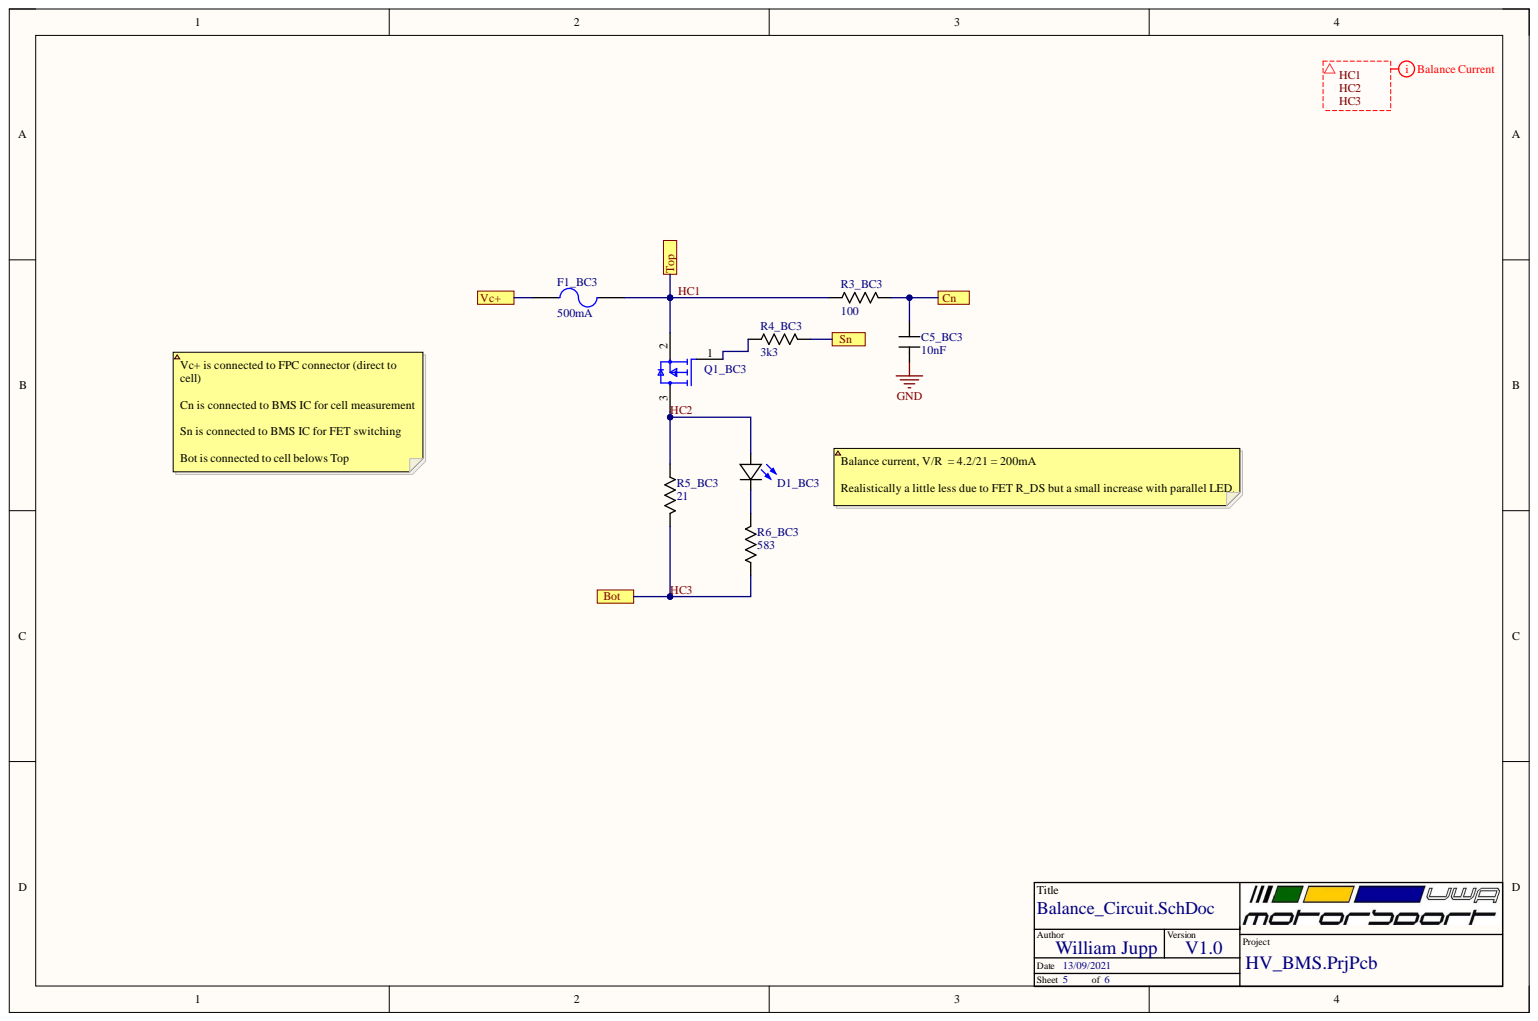
[picture p63: page 34]

Vc+ is connected to FPC connector (direct to
cell)

Cn is connected to BMS IC for cell measurement

Sn is connected to BMS IC for FET switching

Bot is connected to cell belows Top

Realistically a little less due to FET R_DS but a small increase with parallel LED.

Title Balance_Circuit.SchDoc

Author William Jupp | Version

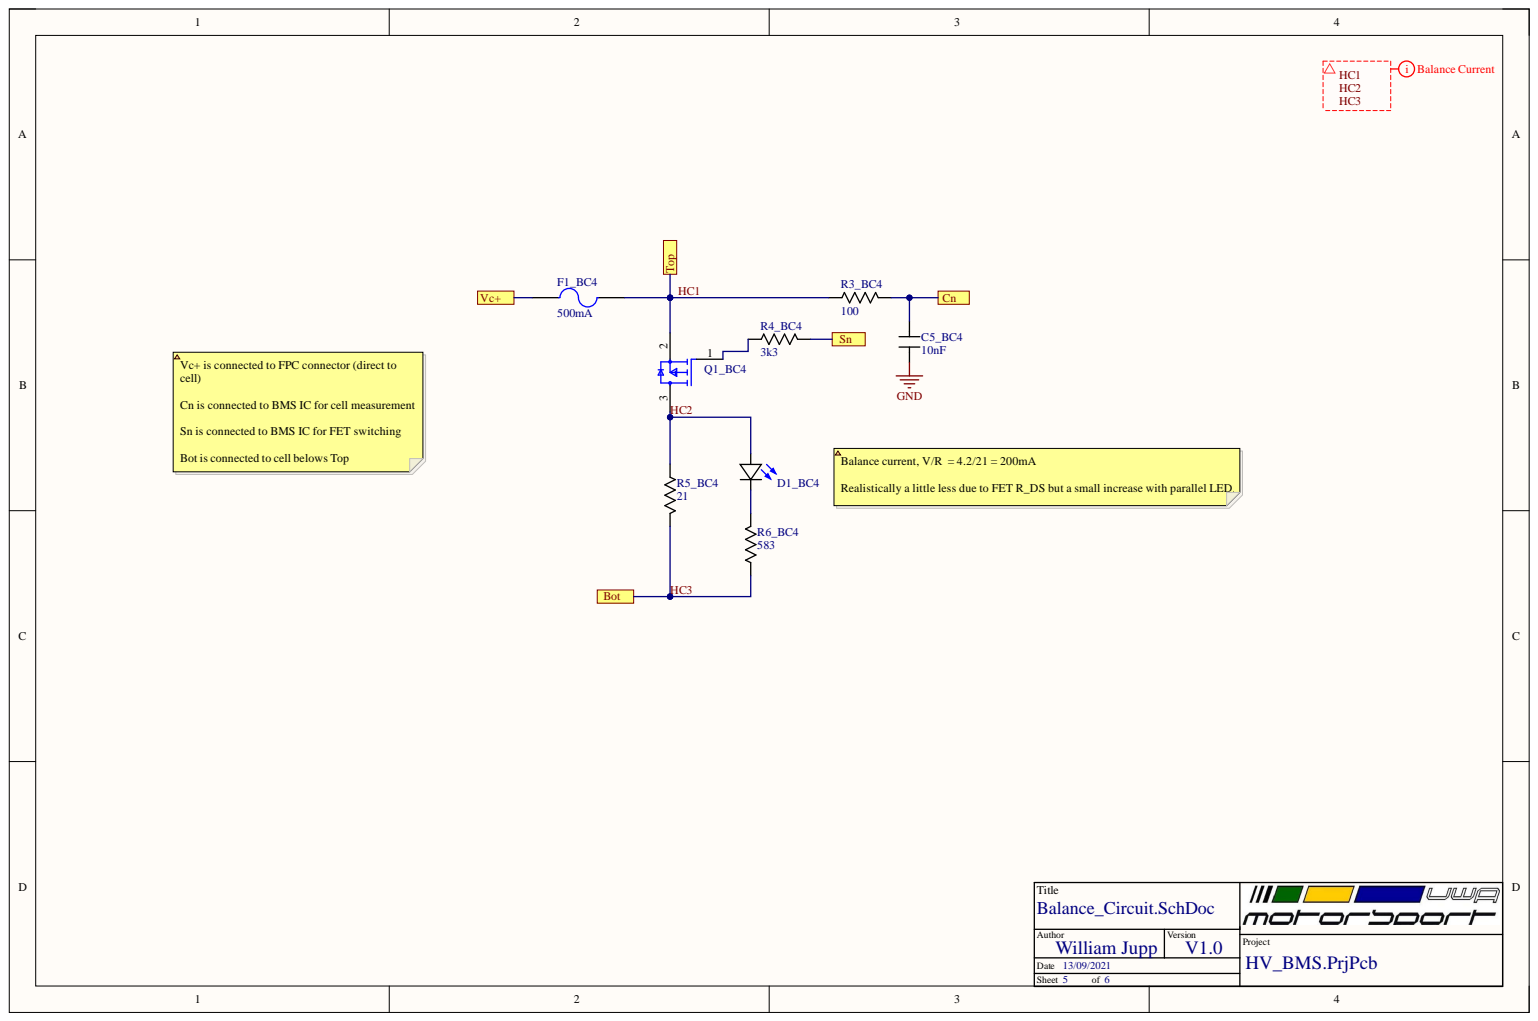
[picture p64: page 35]

Vc+ is connected to FPC connector (direct to
cell)

Cn is connected to BMS IC for cell measurement

Sn is connected to BMS IC for FET switching

Bot is connected to cell belows Top

Realistically a little less due to FET R_DS but a small increase with parallel LED.

Title Balance_Circuit.SchDoc

Author William Jupp | Version

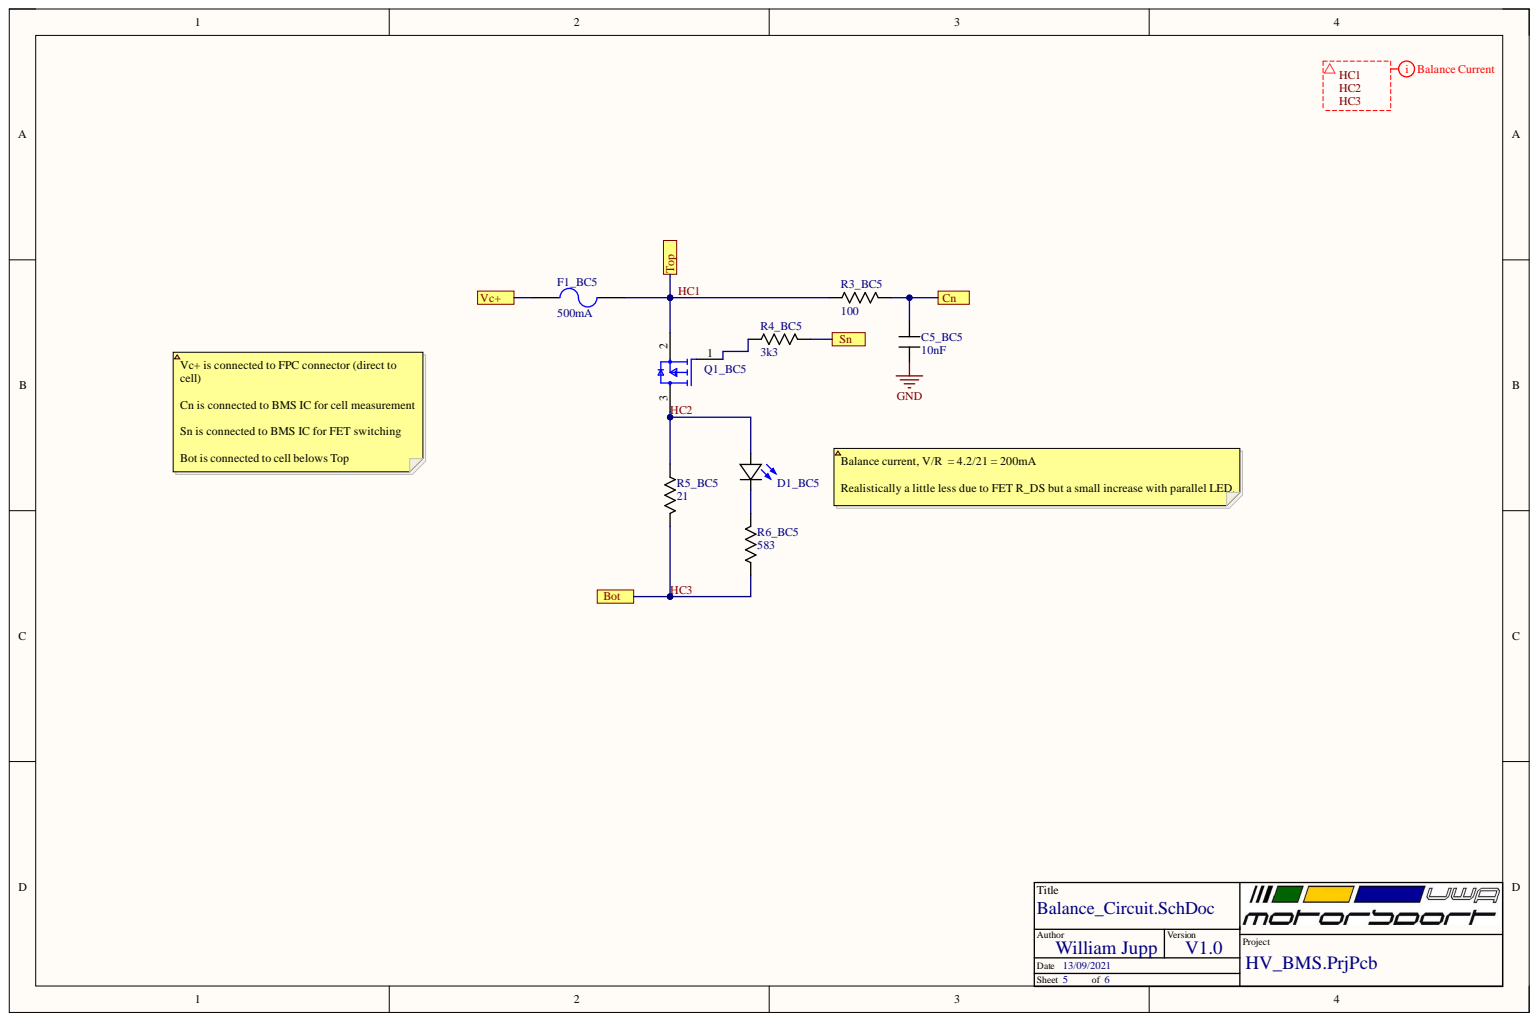
[picture p65: page 36]

Vc+ is connected to FPC connector (direct to
cell)

Cn is connected to BMS IC for cell measurement

Sn is connected to BMS IC for FET switching

Bot is connected to cell belows Top

Realistically a little less due to FET R_DS but a small increase with parallel LED.

Title Balance_Circuit.SchDoc

Author William Jupp | Version

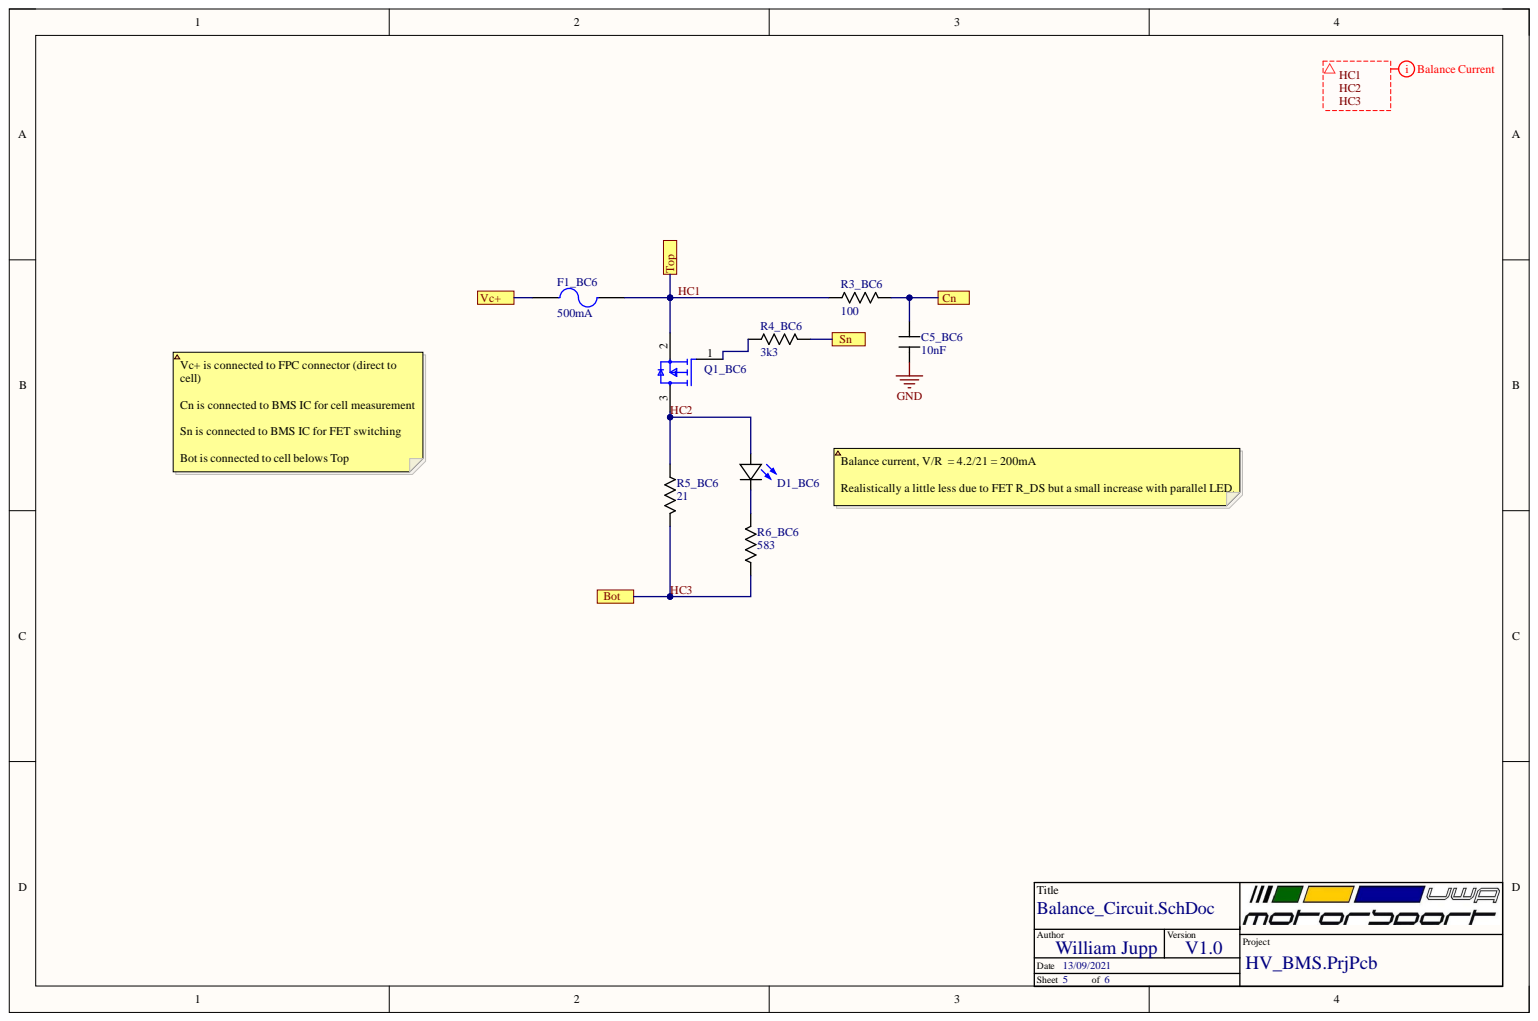
[picture p66: page 37]

Vc+ is connected to FPC connector (direct to
cell)

Cn is connected to BMS IC for cell measurement

Sn is connected to BMS IC for FET switching

Bot is connected to cell belows Top

Realistically a little less due to FET R_DS but a small increase with parallel LED.

Title Balance_Circuit.SchDoc

Author William Jupp | Version

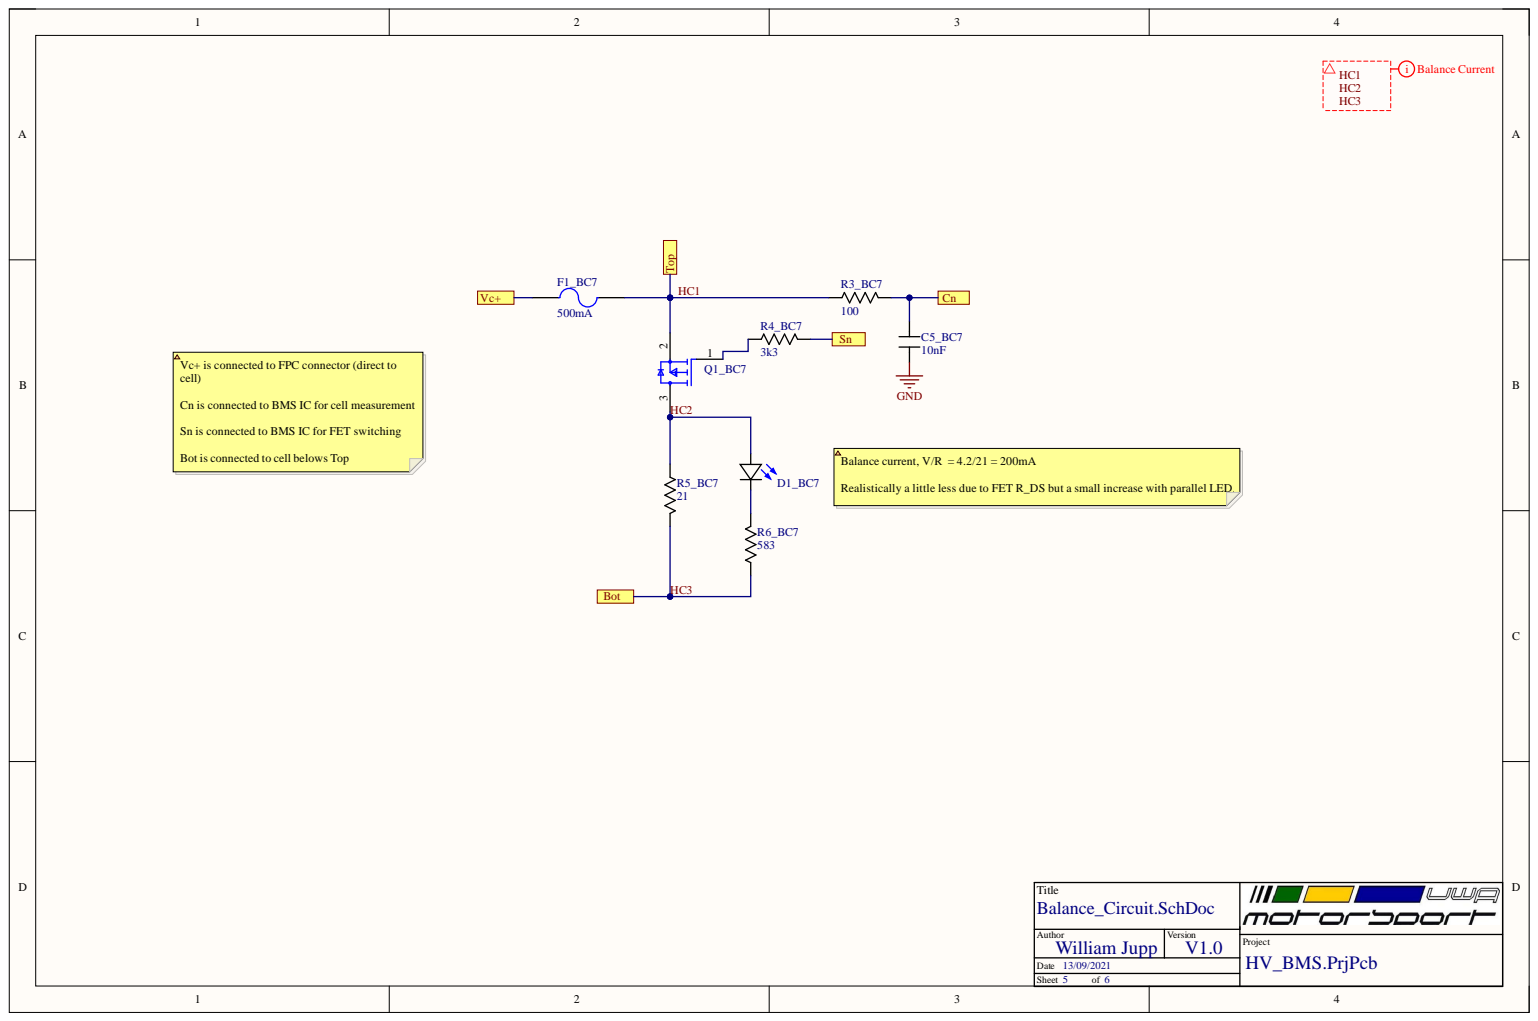
[picture p67: page 38]

Vc+ is connected to FPC connector (direct to
cell)

Cn is connected to BMS IC for cell measurement

Sn is connected to BMS IC for FET switching

Bot is connected to cell belows Top

Realistically a little less due to FET R_DS but a small increase with parallel LED.

Title Balance_Circuit.SchDoc

Author William Jupp | Version

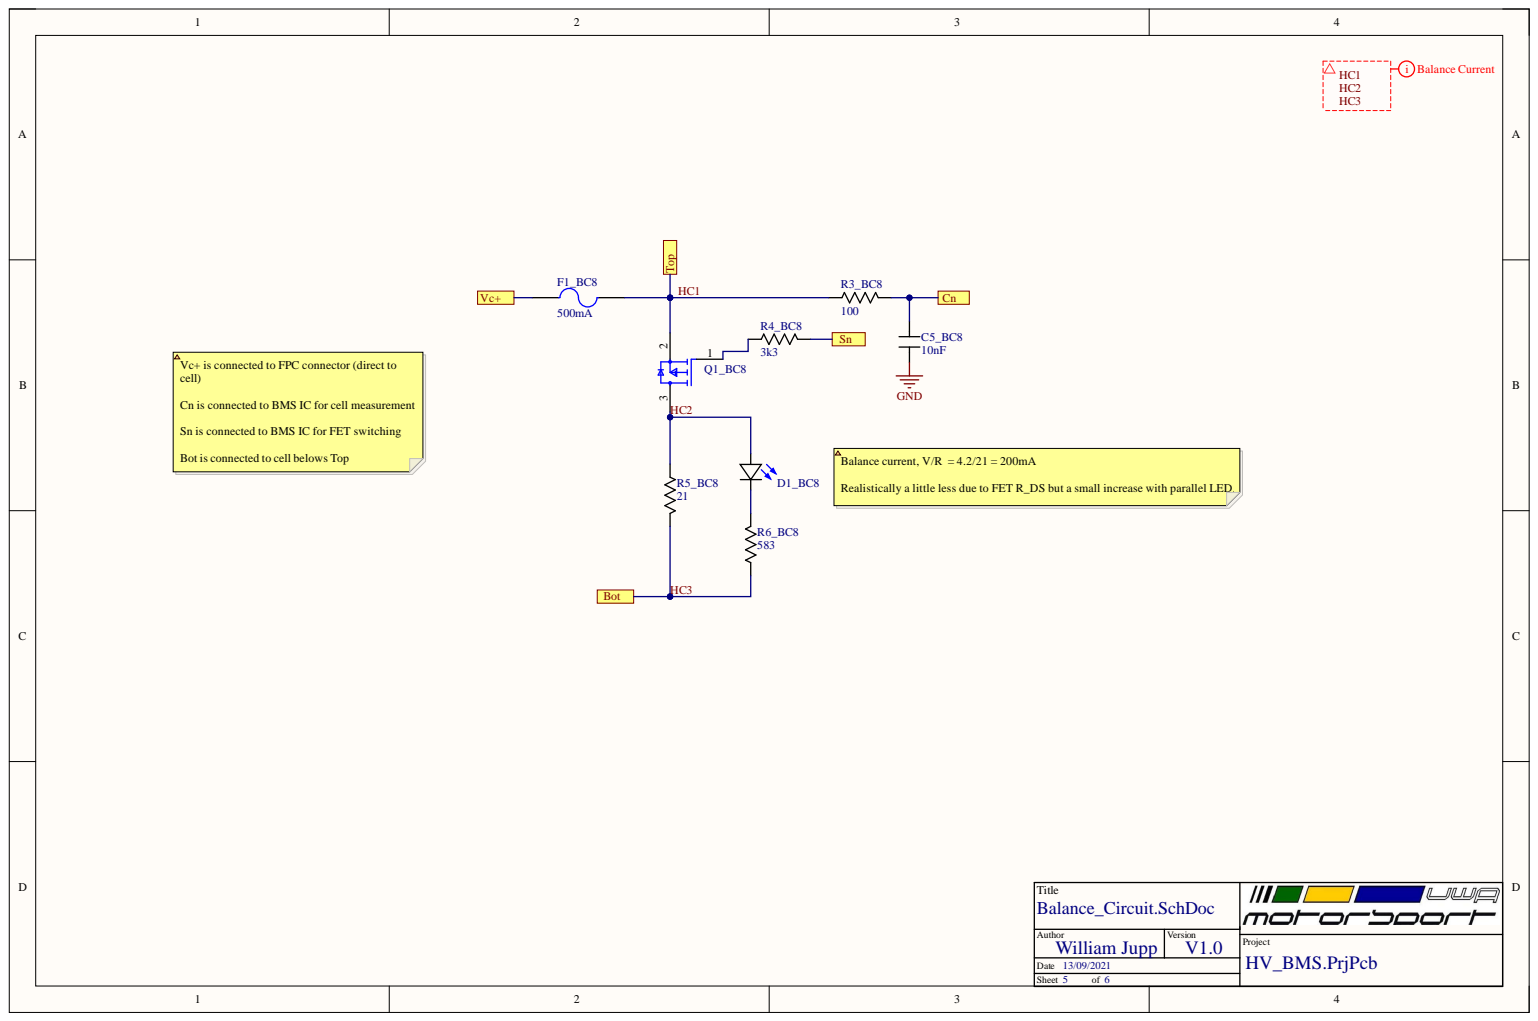
[picture p68: page 39]

Vc+ is connected to FPC connector (direct to
cell)

Cn is connected to BMS IC for cell measurement

Sn is connected to BMS IC for FET switching

Bot is connected to cell belows Top

Realistically a little less due to FET R_DS but a small increase with parallel LED.

Title Balance_Circuit.SchDoc

Author William Jupp | Version

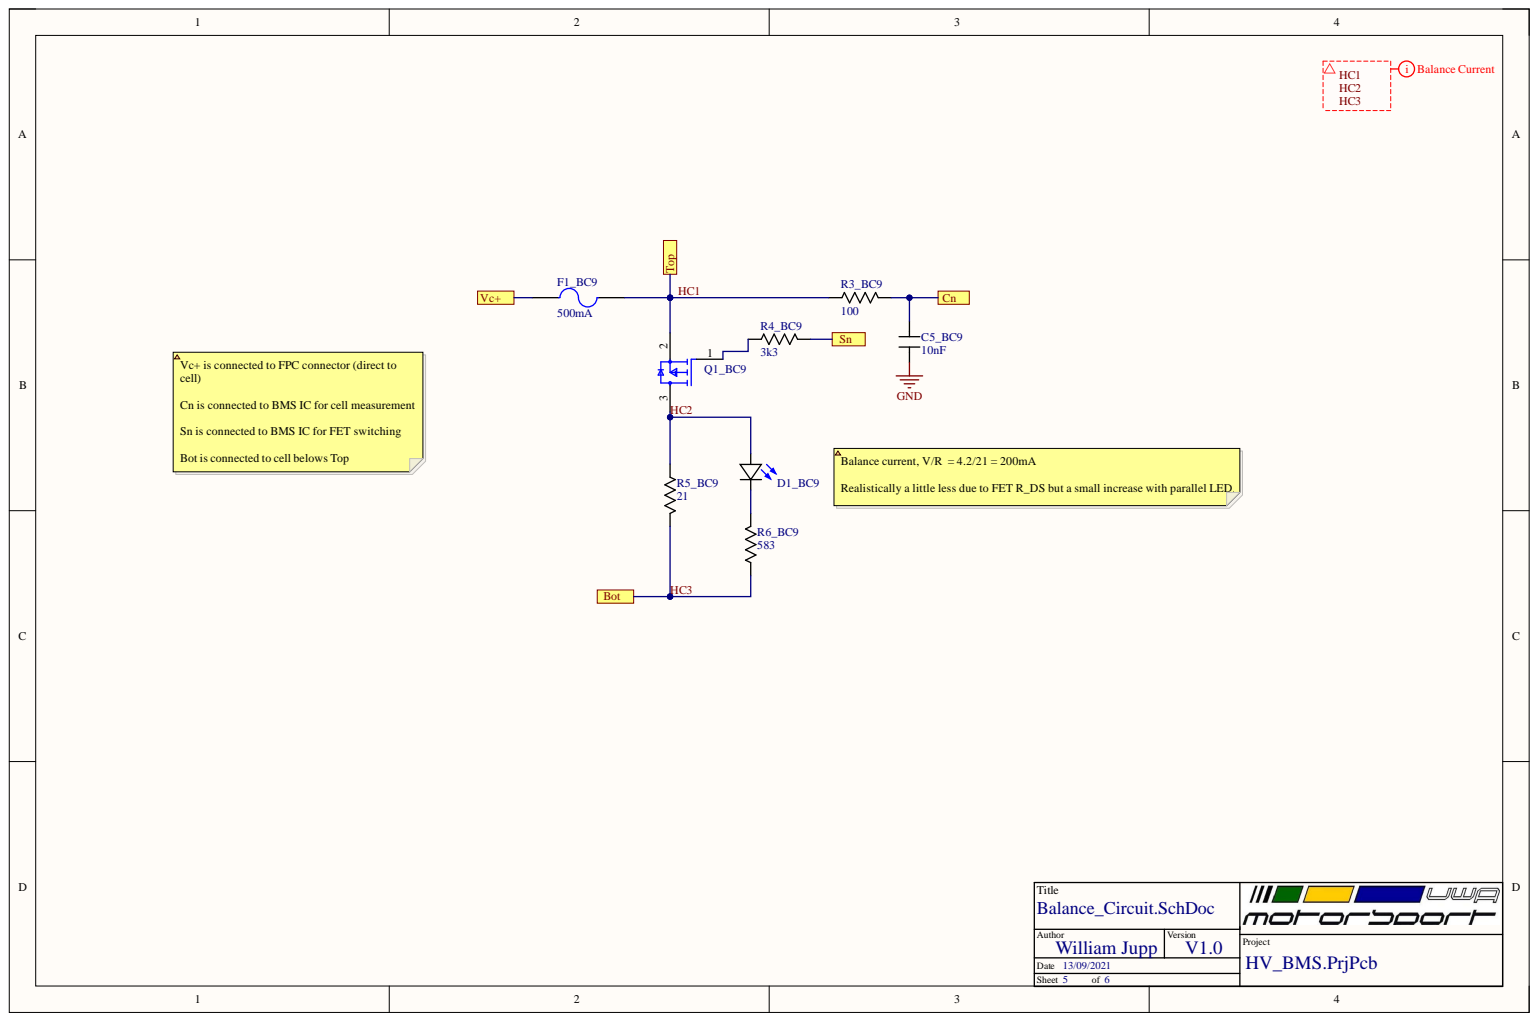
[picture p69: page 40]

Vc+ is connected to FPC connector (direct to
cell)

Cn is connected to BMS IC for cell measurement

Sn is connected to BMS IC for FET switching

Bot is connected to cell belows Top

Realistically a little less due to FET R_DS but a small increase with parallel LED.

Title Balance_Circuit.SchDoc

Author William Jupp | Version

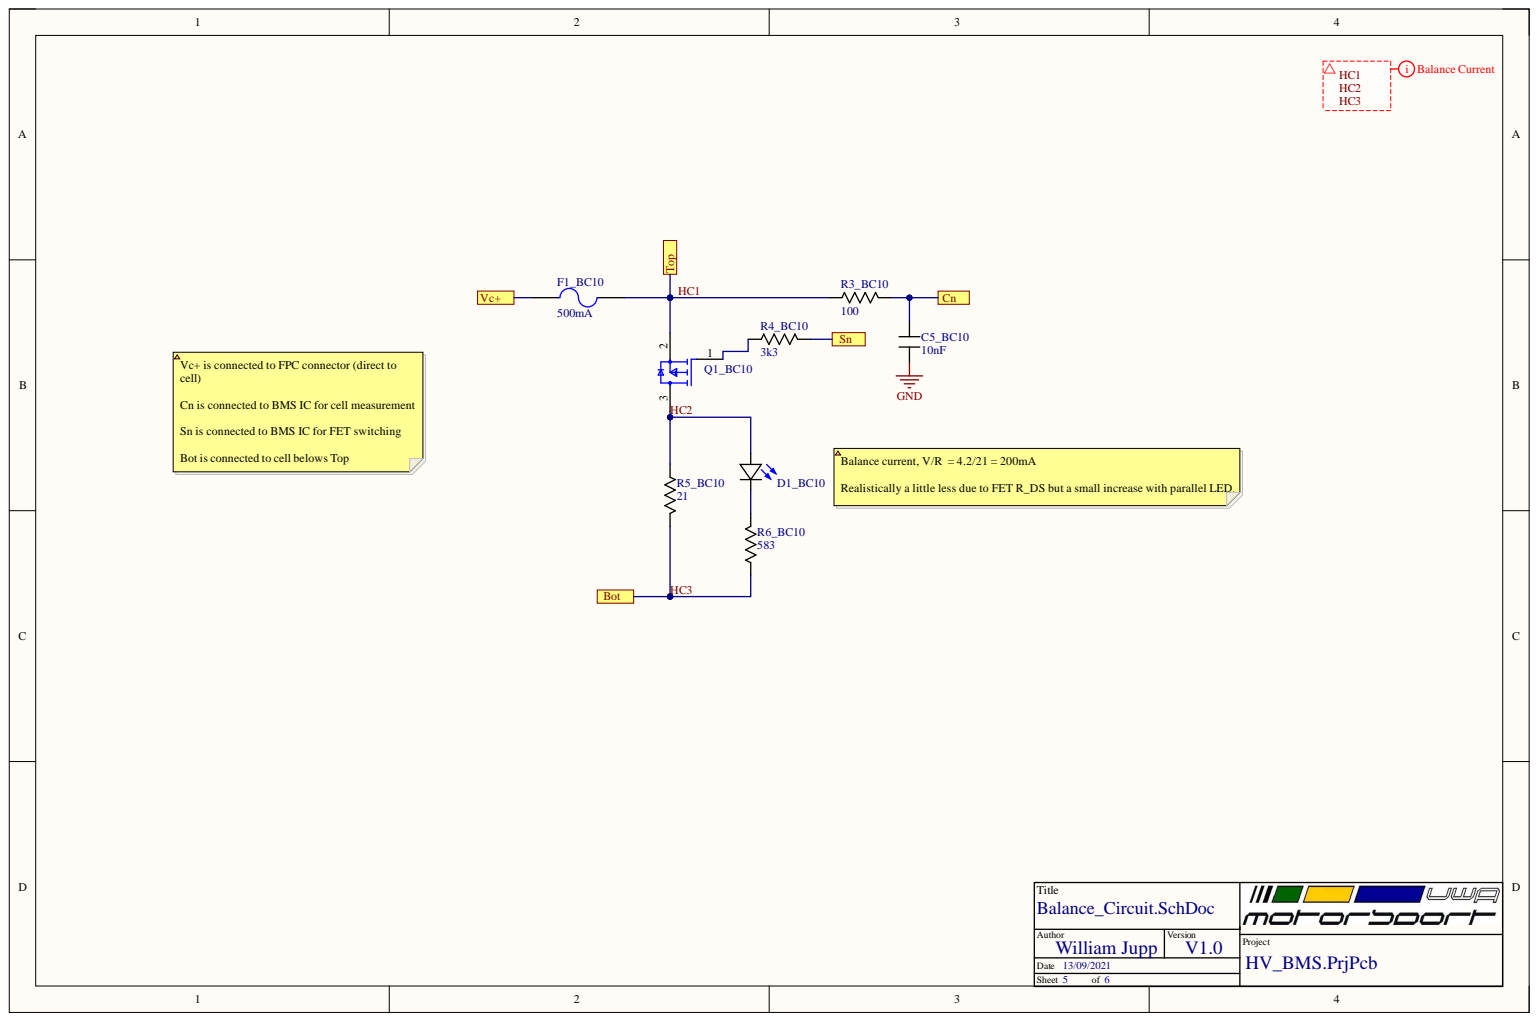
[picture p70: page 41]

Vc+ is connected to FPC connector (direct to
cell)

Cn is connected to BMS IC for cell measurement

Sn is connected to BMS IC for FET switching

Bot is connected to cell belows Top

Realistically a little less due to FET R_DS but a small increase with parallel LED.

Title Balance_Circuit.SchDoc

Author William Jupp | Version

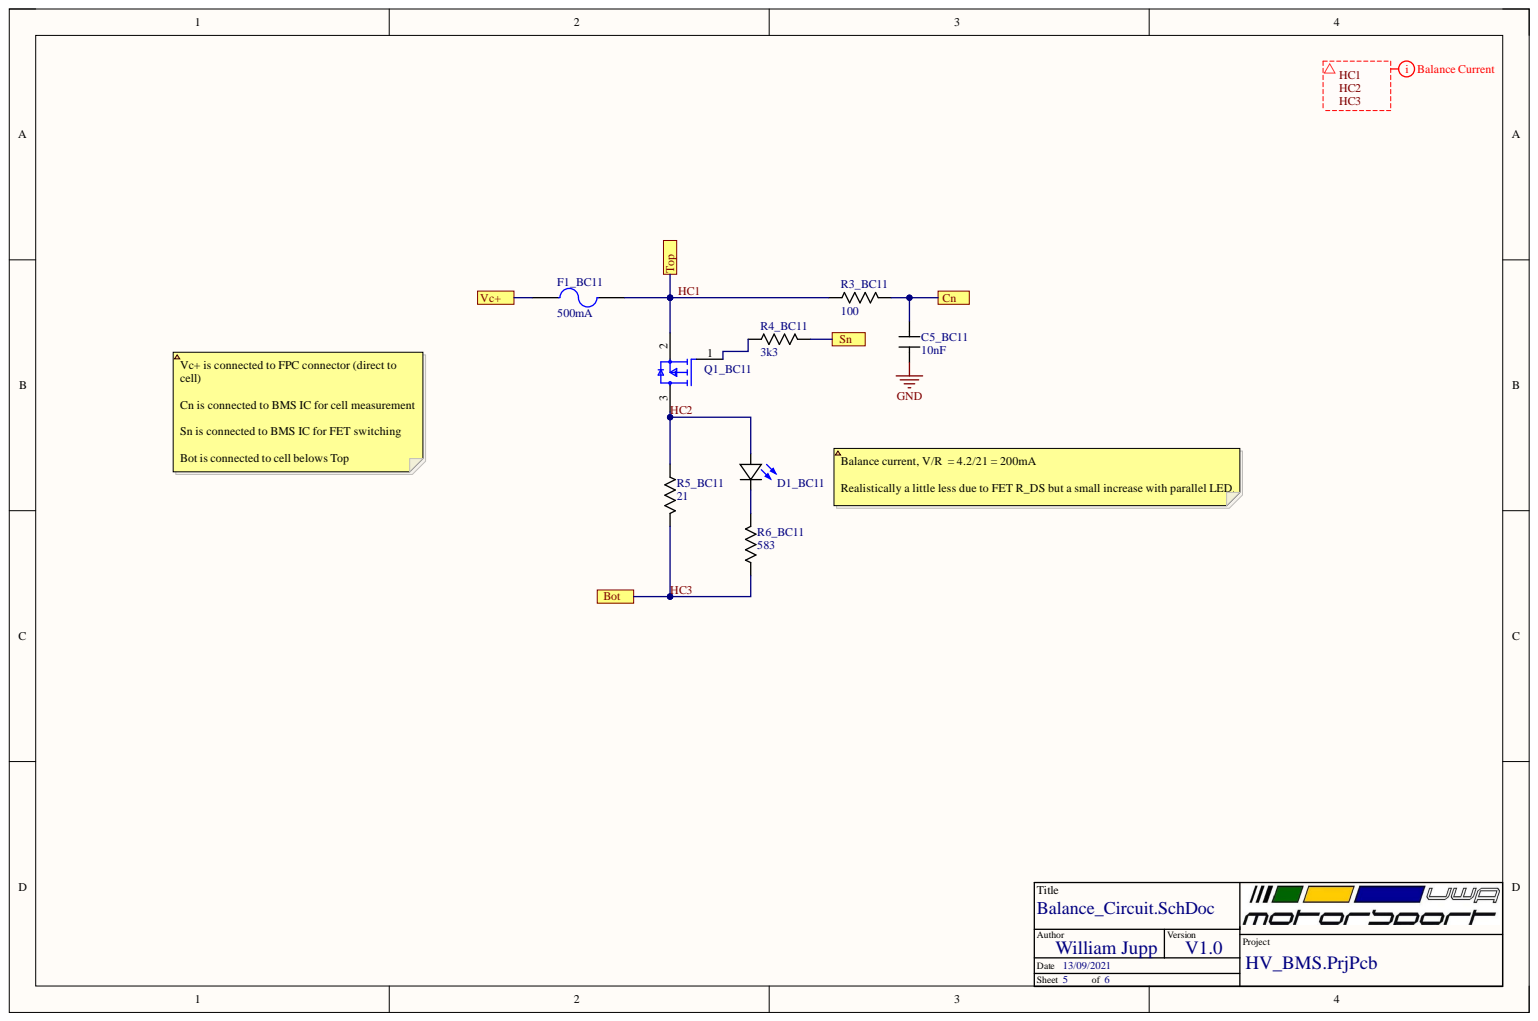
[picture p71: page 42]

Vc+ is connected to FPC connector (direct to
cell)

Cn is connected to BMS IC for cell measurement

Sn is connected to BMS IC for FET switching

Bot is connected to cell belows Top

Realistically a little less due to FET R_DS but a small increase with parallel LED.

Title Balance_Circuit.SchDoc

Author William Jupp | Version

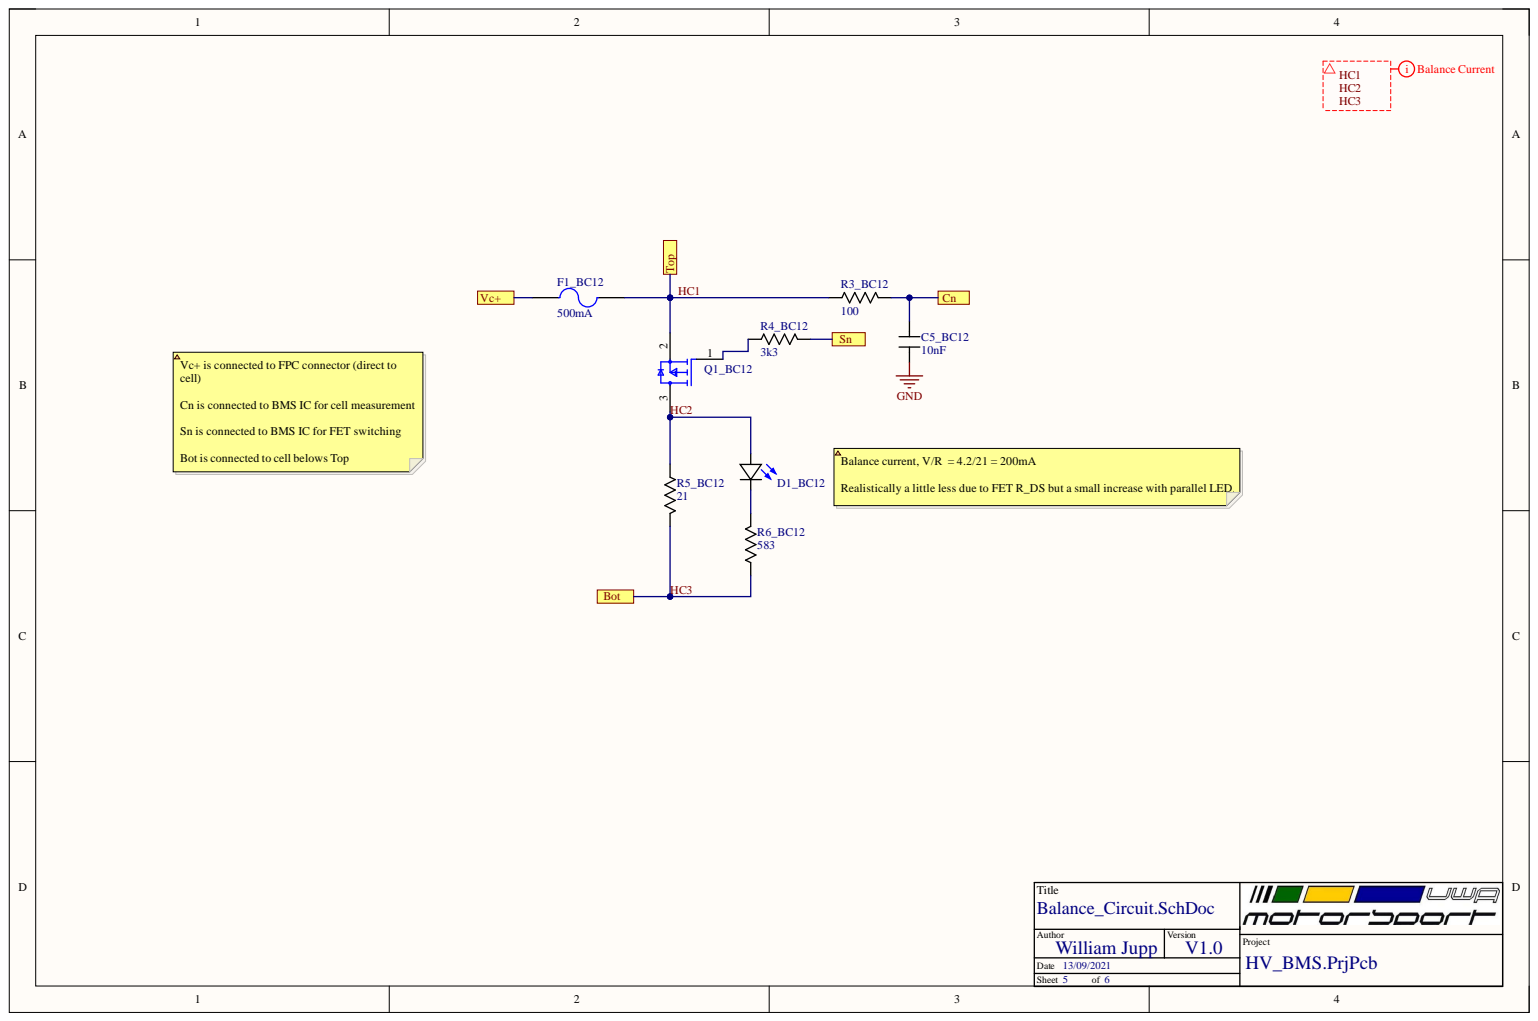
[picture p72: page 43]

Vc+ is connected to FPC connector (direct to
cell)

Cn is connected to BMS IC for cell measurement

Sn is connected to BMS IC for FET switching

Bot is connected to cell belows Top

Realistically a little less due to FET R_DS but a small increase with parallel LED.

Title Balance_Circuit.SchDoc

Author William Jupp | Version

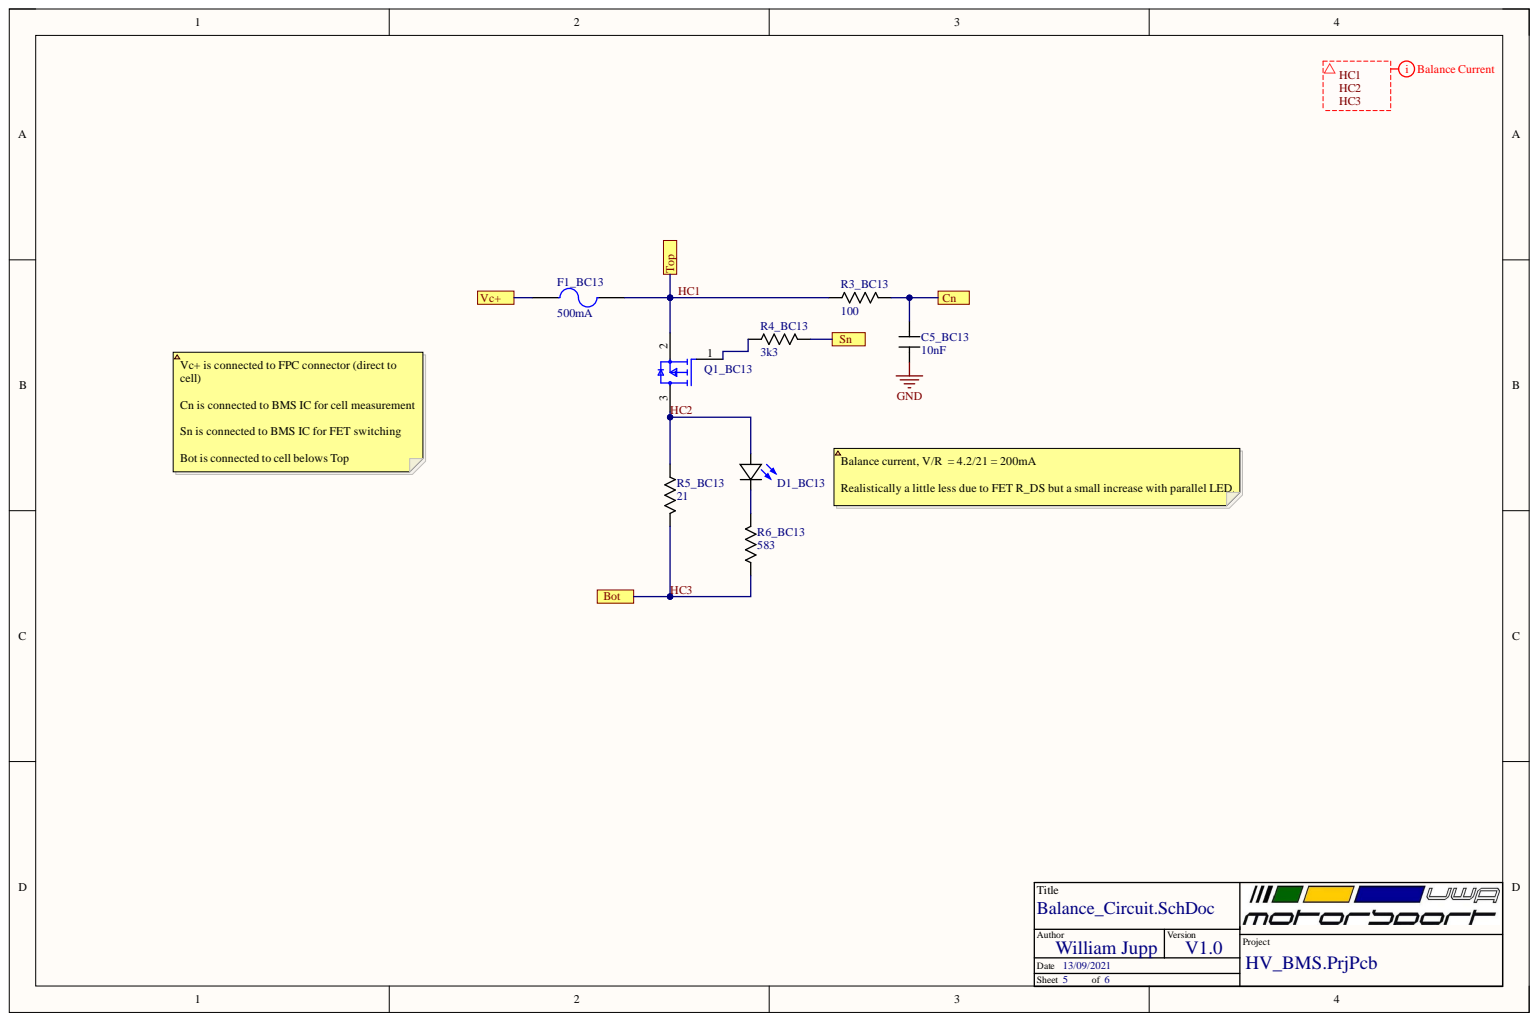
[picture p73: page 44]

Vc+ is connected to FPC connector (direct to
cell)

Cn is connected to BMS IC for cell measurement

Sn is connected to BMS IC for FET switching

Bot is connected to cell belows Top

Realistically a little less due to FET R_DS but a small increase with parallel LED.

Title Balance_Circuit.SchDoc

Author William Jupp | Version

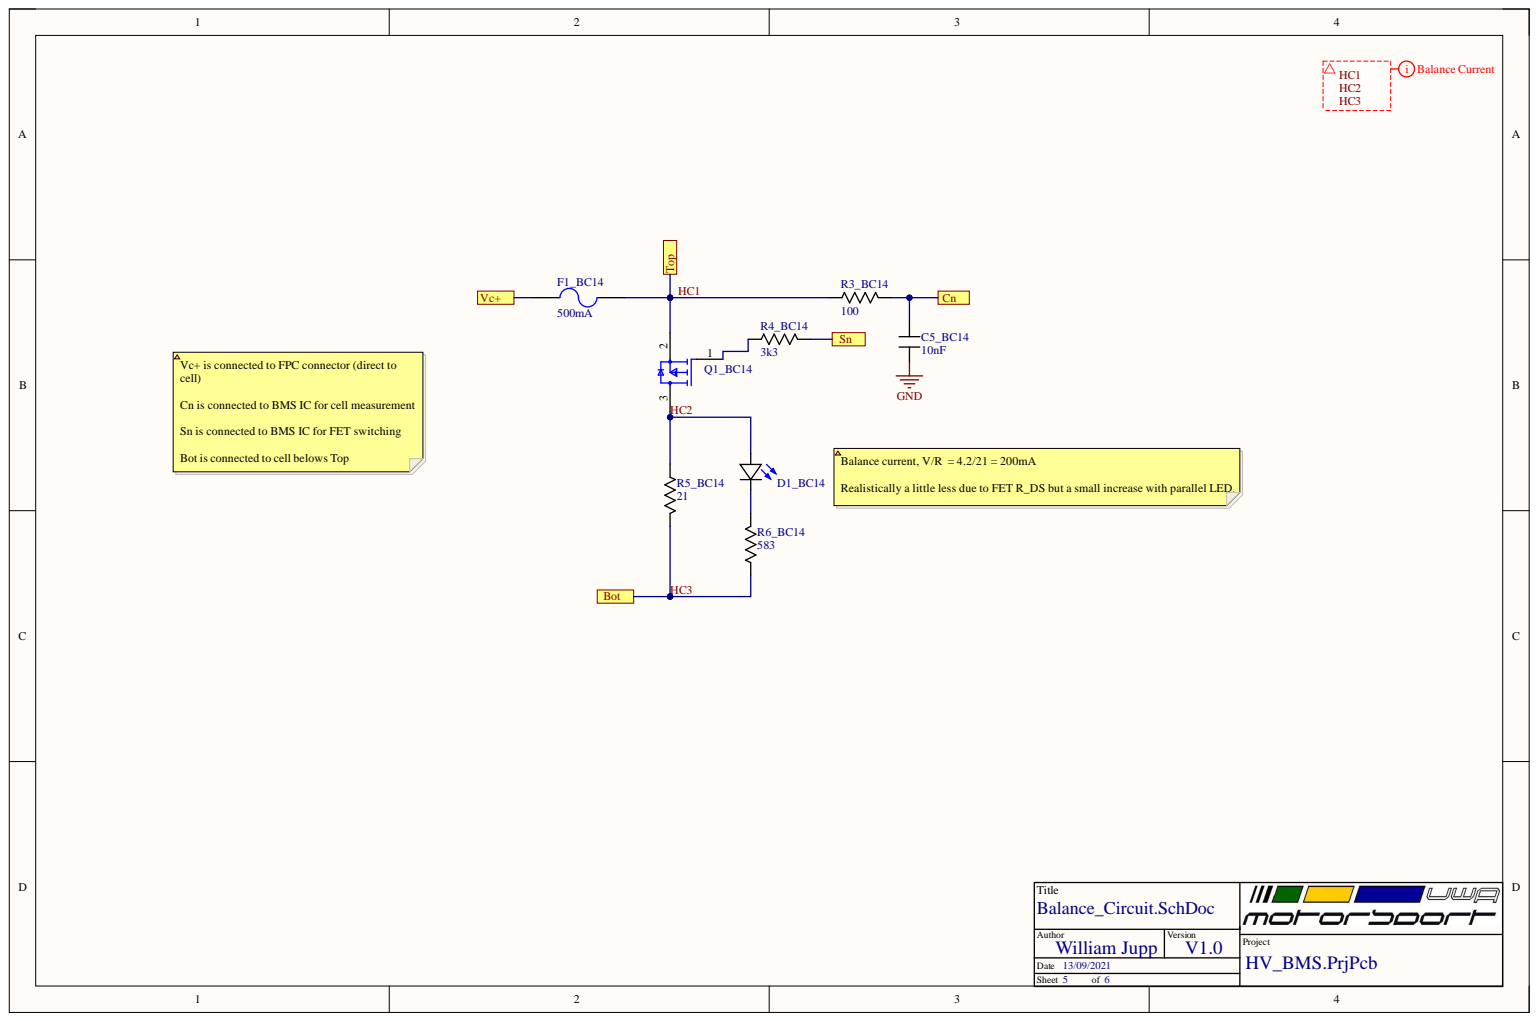
[picture p74: page 45]

Vc+ is connected to FPC connector (direct to
cell)

Cn is connected to BMS IC for cell measurement

Sn is connected to BMS IC for FET switching

Bot is connected to cell belows Top

Realistically a little less due to FET R_DS but a small increase with parallel LED.

Title Balance_Circuit.SchDoc

Author William Jupp | Version

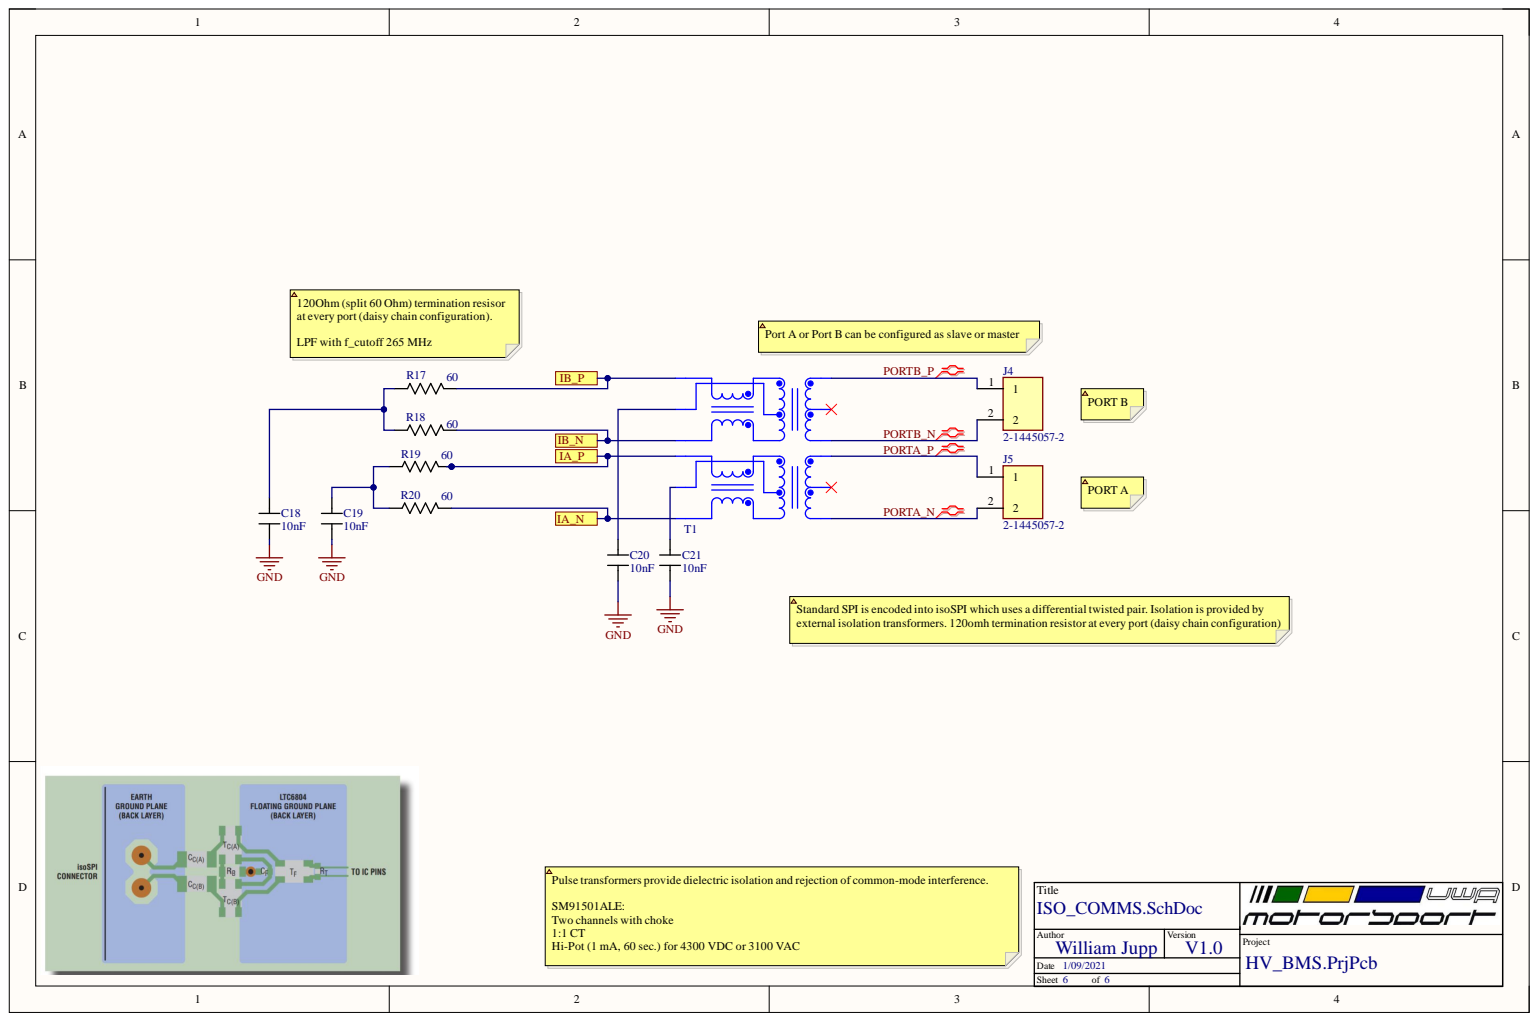
[picture p75: page 46]

T i tl e ISO_COM MS.Sc h D o c

Author William Ju p p | Ve r s i o n
