juppy10/HV_BMS/Hardware/BMS_Slave/Project Outputs for BMS Slave V0.1/BMS Slave V0.1.PDF

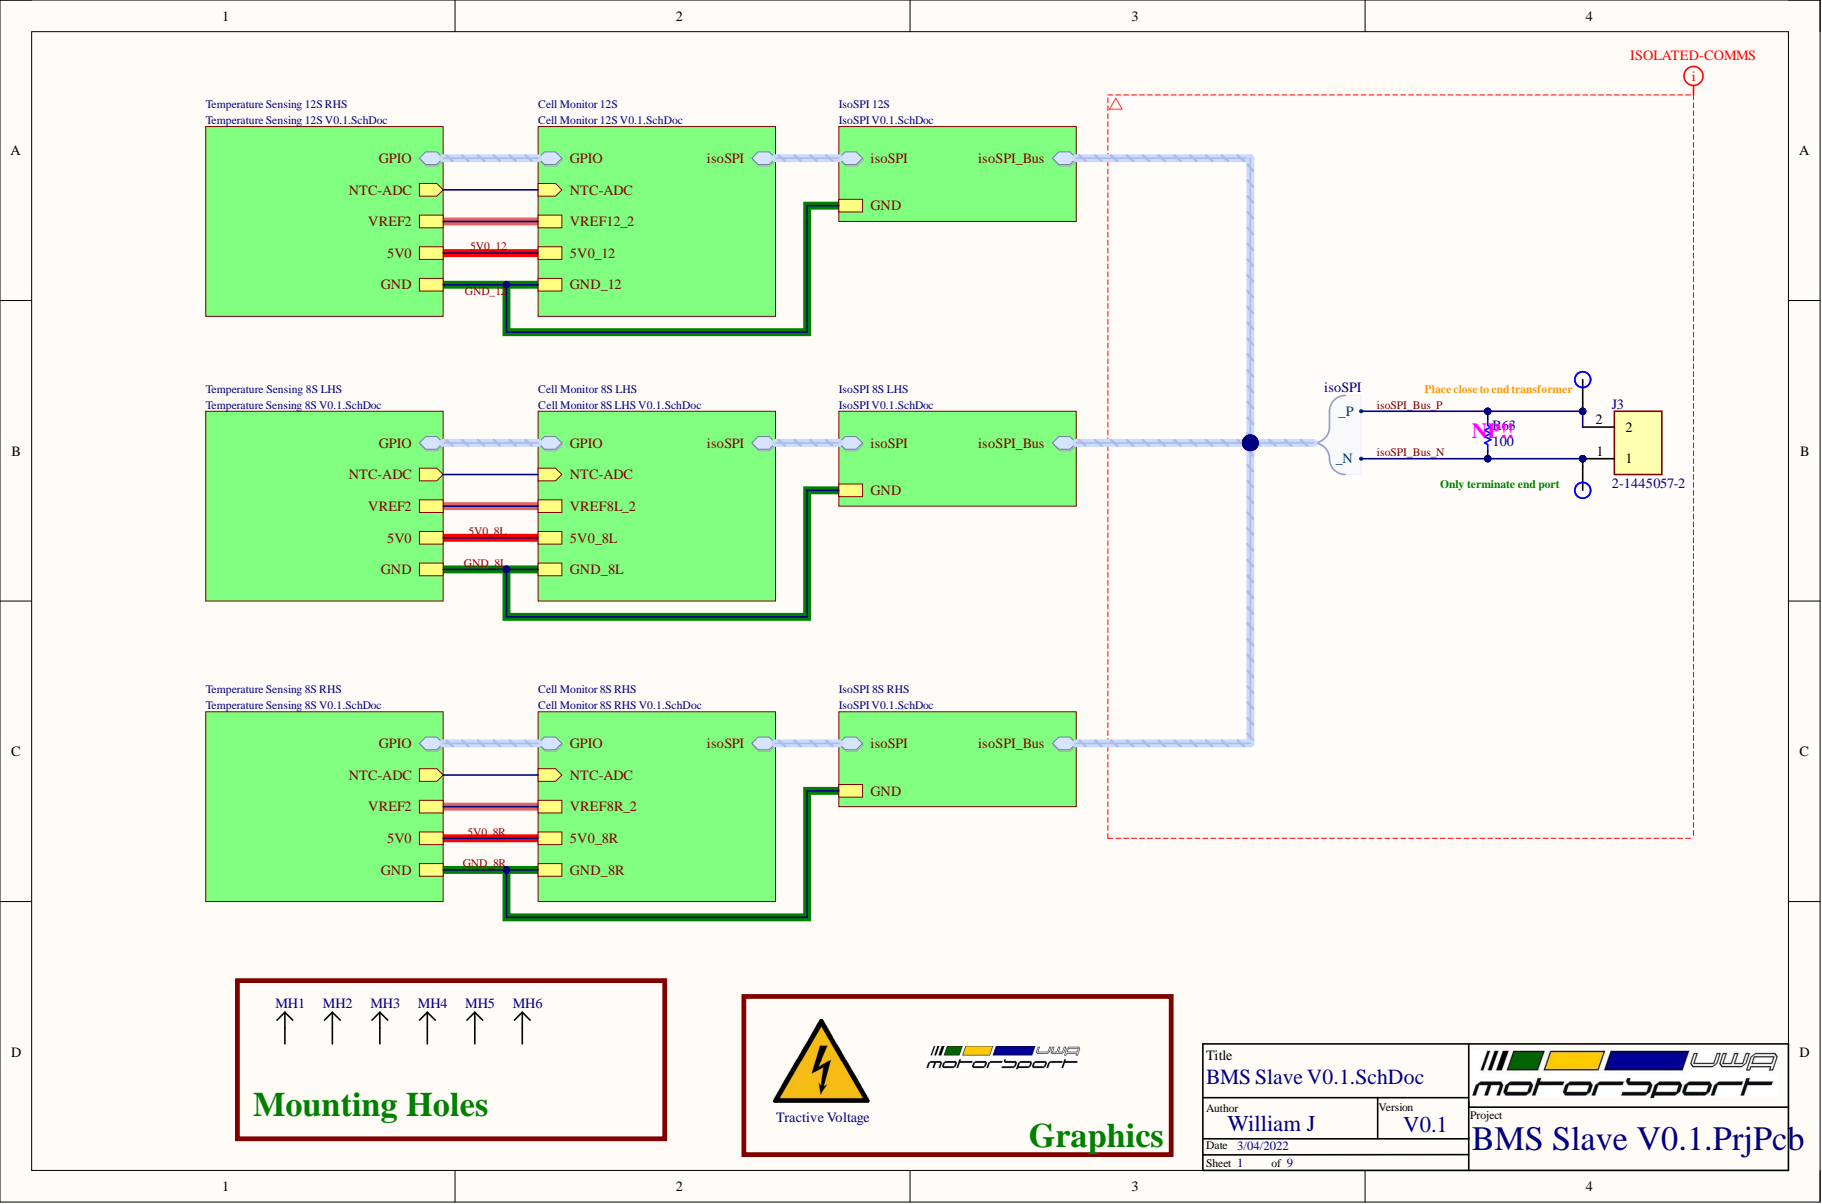
[picture p76: page 1]

Cell Monitor 8S LHS
Cell Monitor 8S LHS V0.1.SchDoc

Place close to end transformer

Only terminate end port

GND_8L

Cell Monitor 8S RHS
Cell Monitor 8S RHS V0.1.SchDoc

GND_8R

Title BMS Slave V0.1.SchDoc

Author | Version

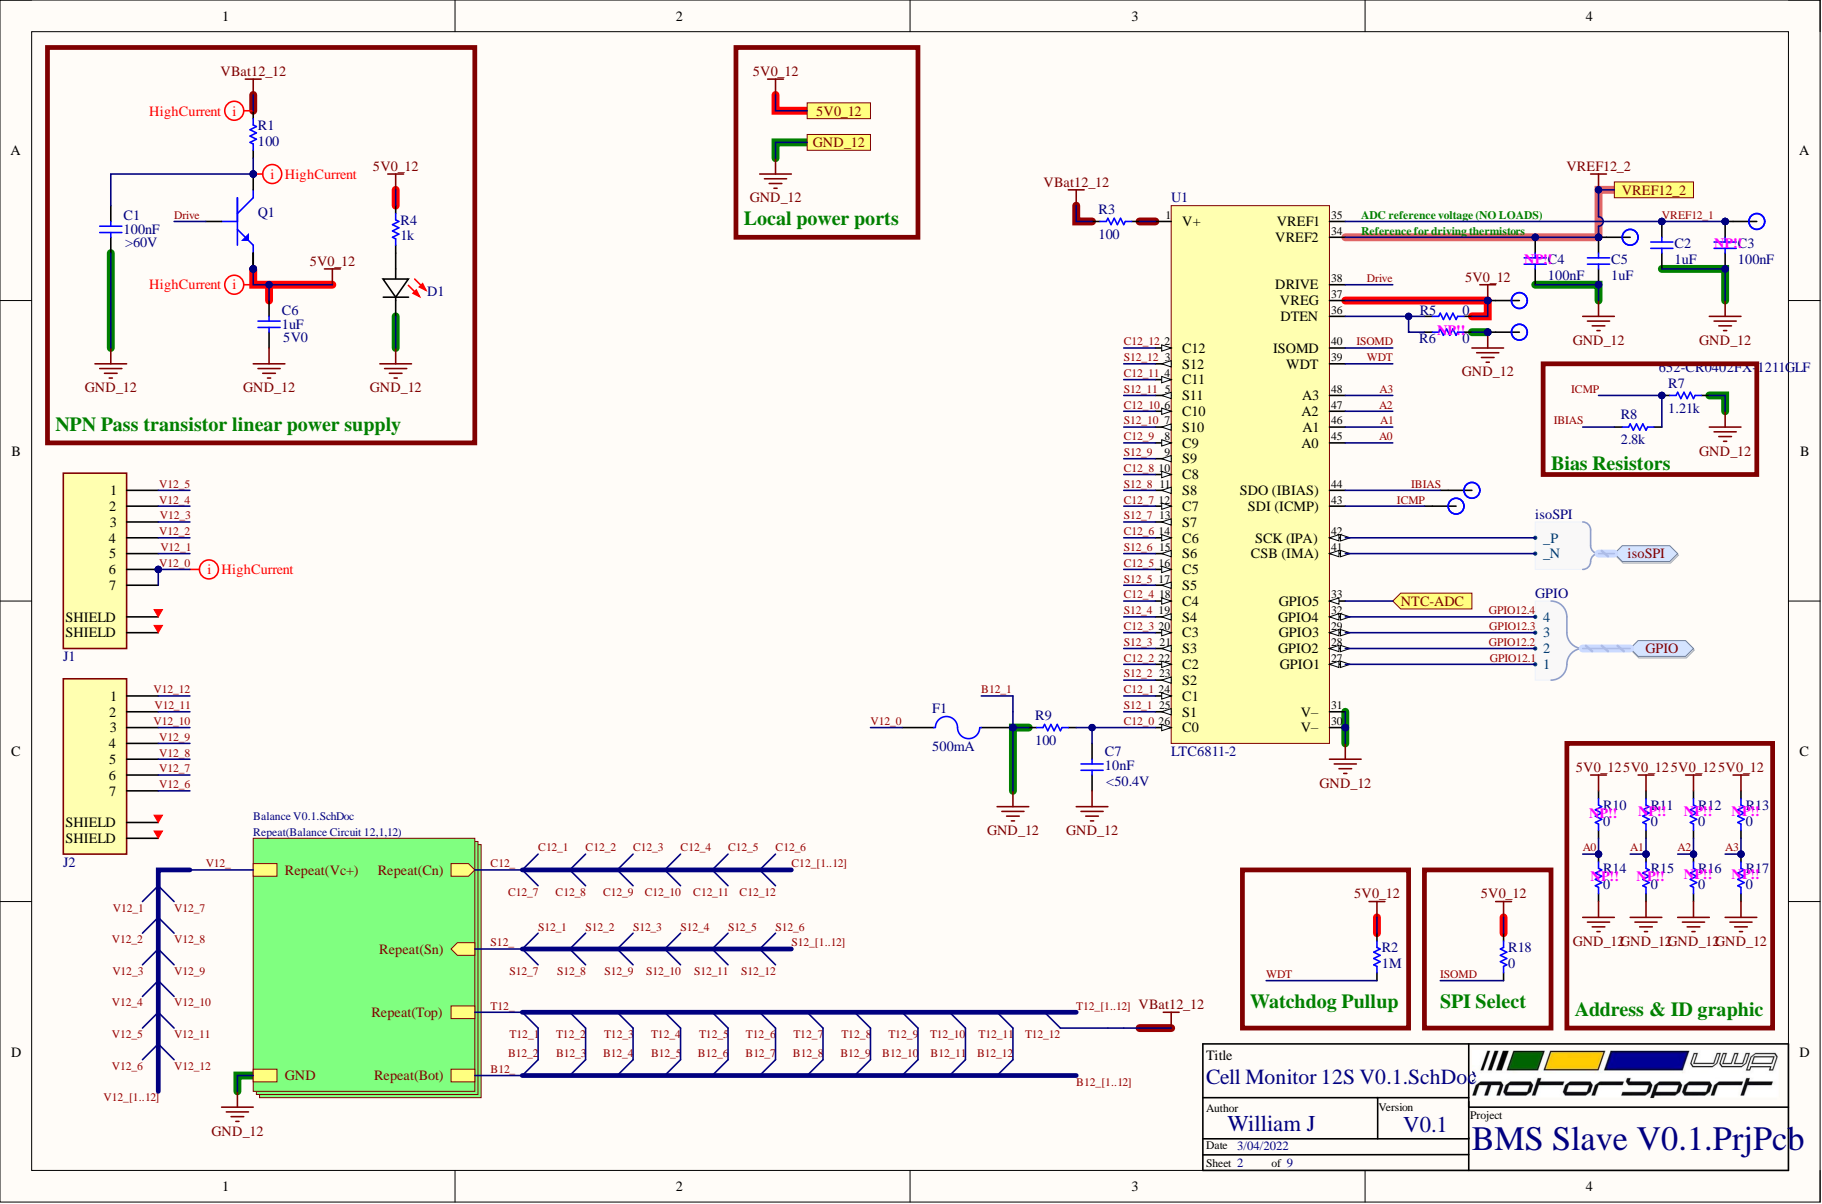
[picture p77: page 2]

ADC reference voltage (NO LOADS)
Reference for driving thermistors

NPN Pass transistor linear power supply

Title Cell Monitor 12S V0.1.SchDoc

William J

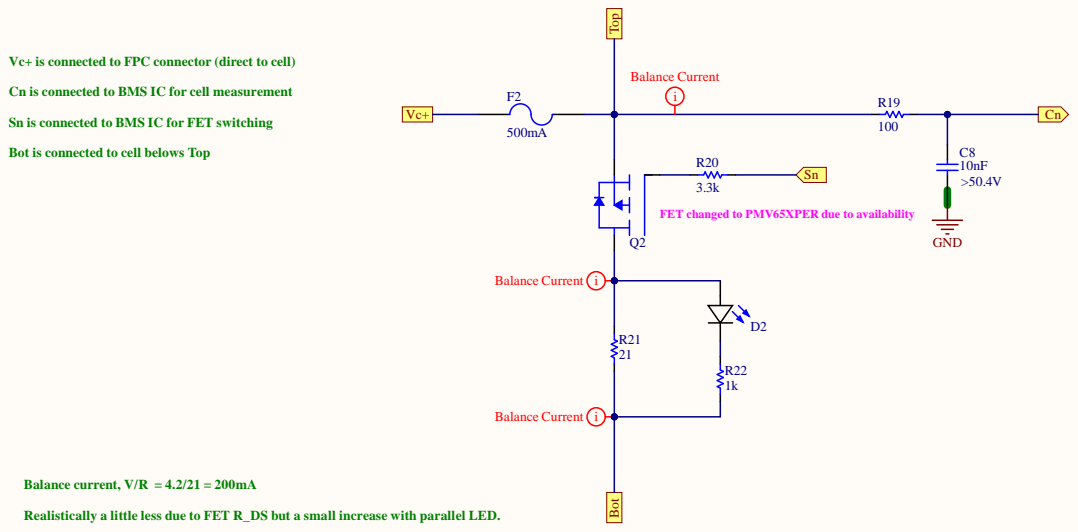
[picture p78: page 3]

Vc+ is connected to FPC connector (direct to cell)

Cn is connected to BMS IC for cell measurement

Sn is connected to BMS IC for FET switching

Bot is connected to cell belows Top

FET changed to PMV65XPER due to availability

Realistically a little less due to FET R_DS but a small increase with parallel LED.

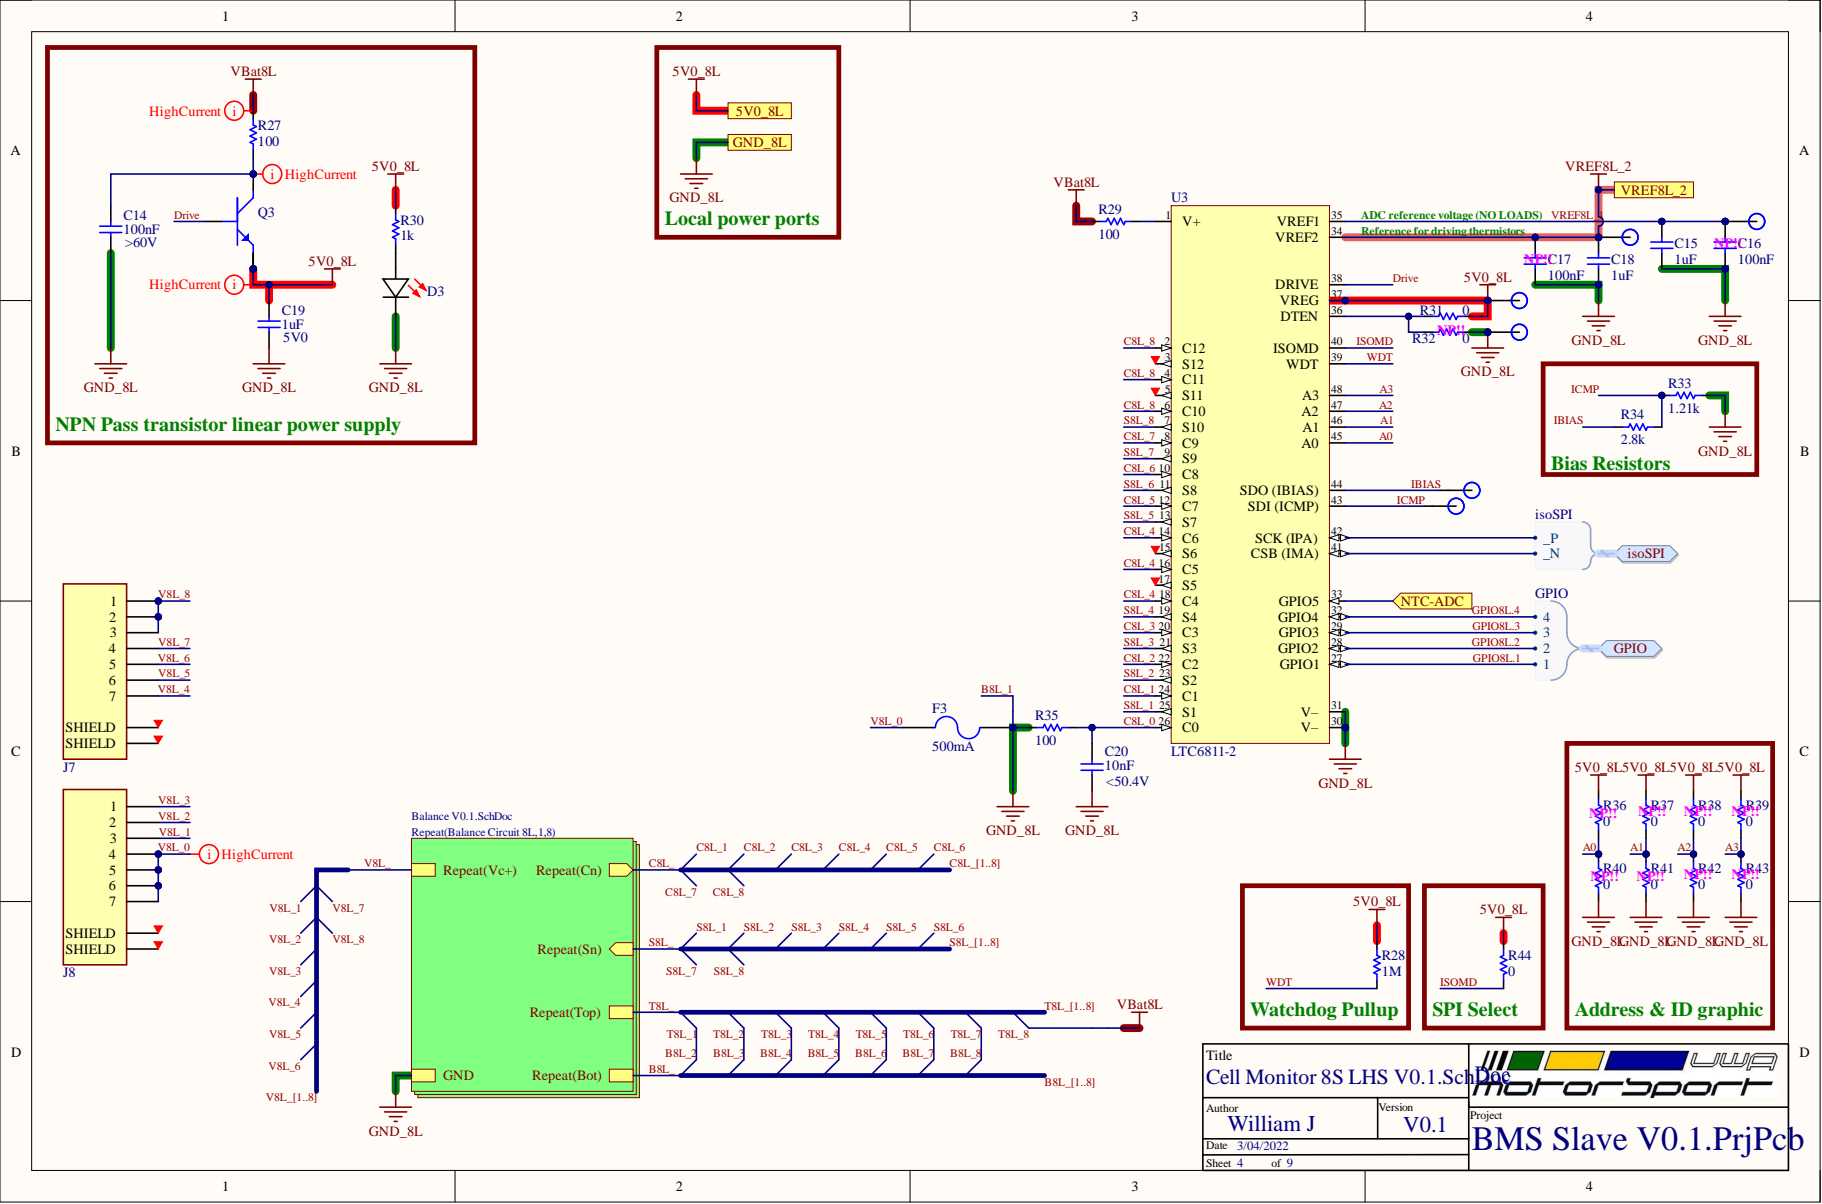
[picture p79: page 4]

T i tl e Cell M o nitor 8S LHS V0.1.SchDo | c

Autho r | Ve s o n V0 .

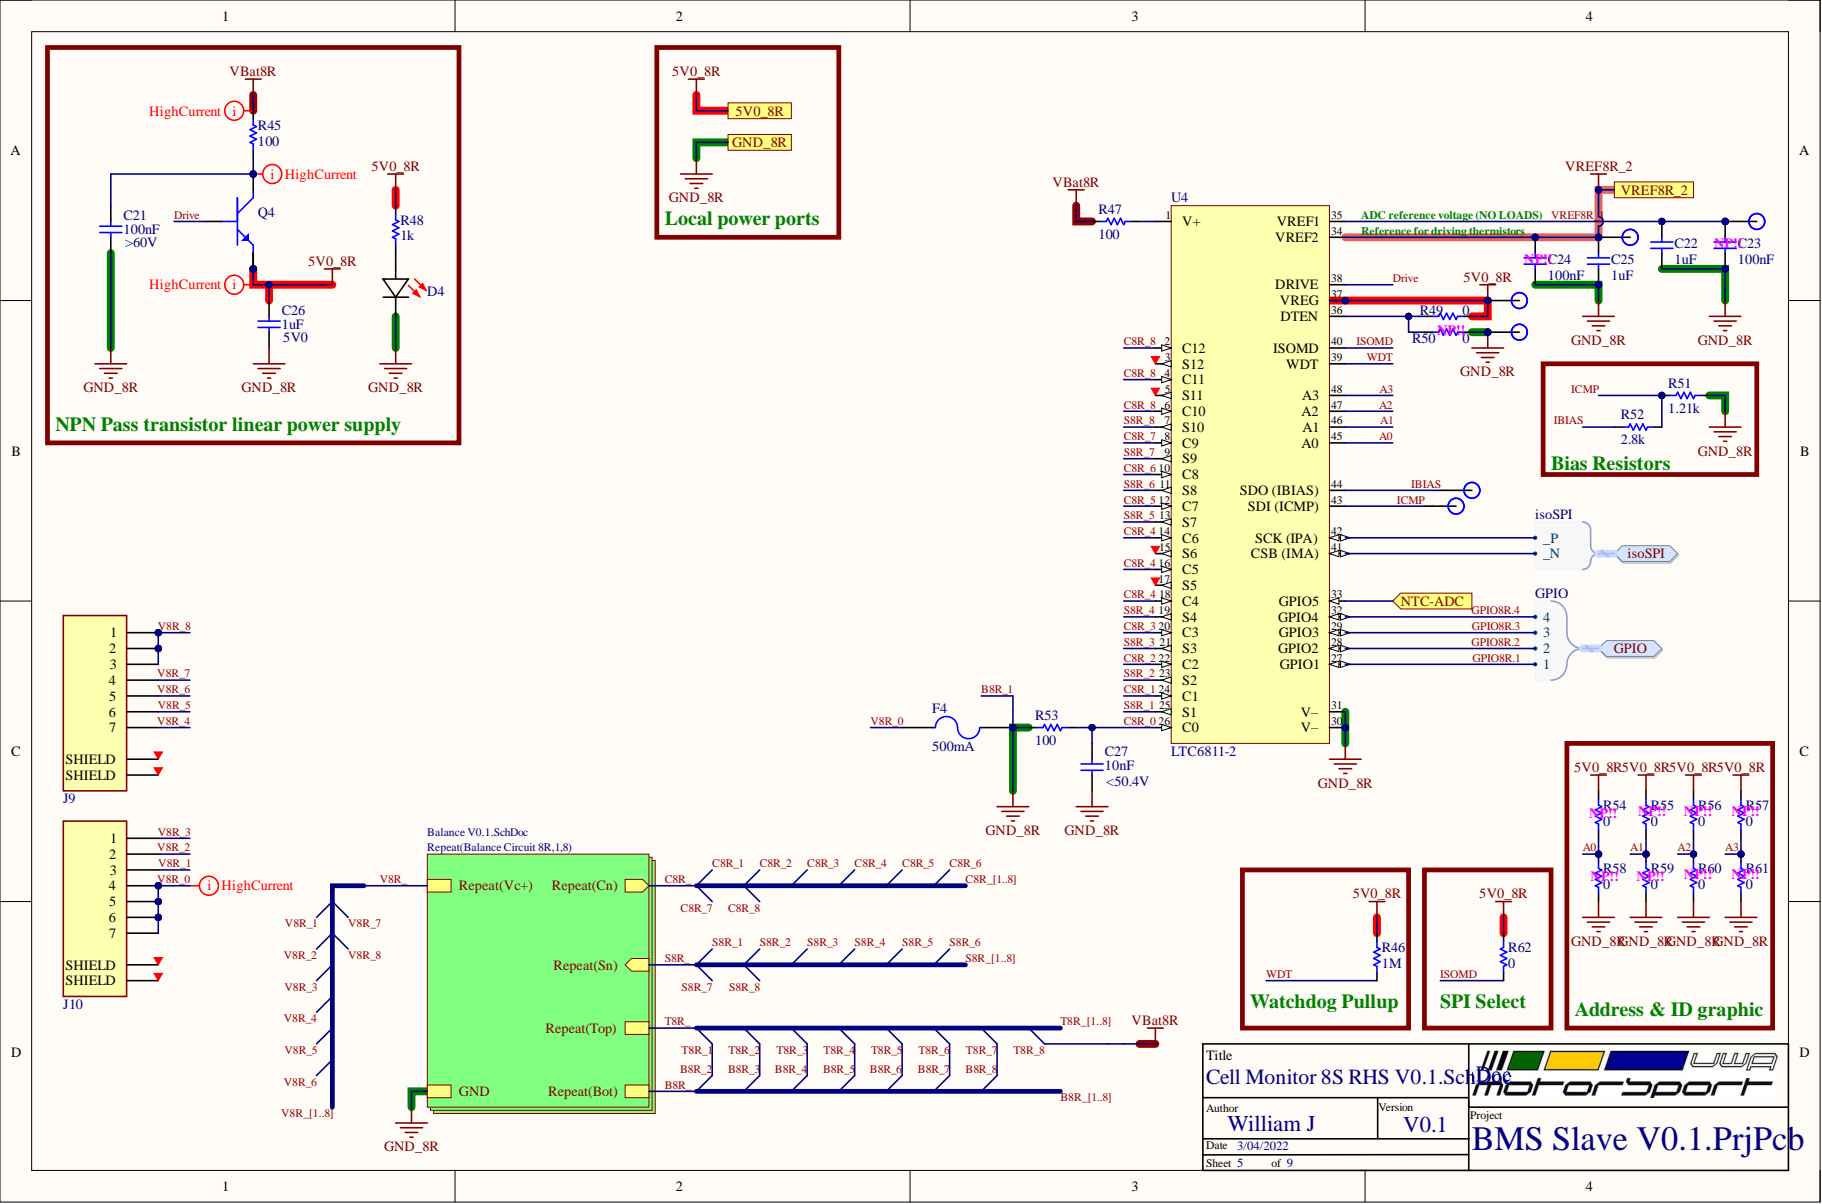
[picture p80: page 5]

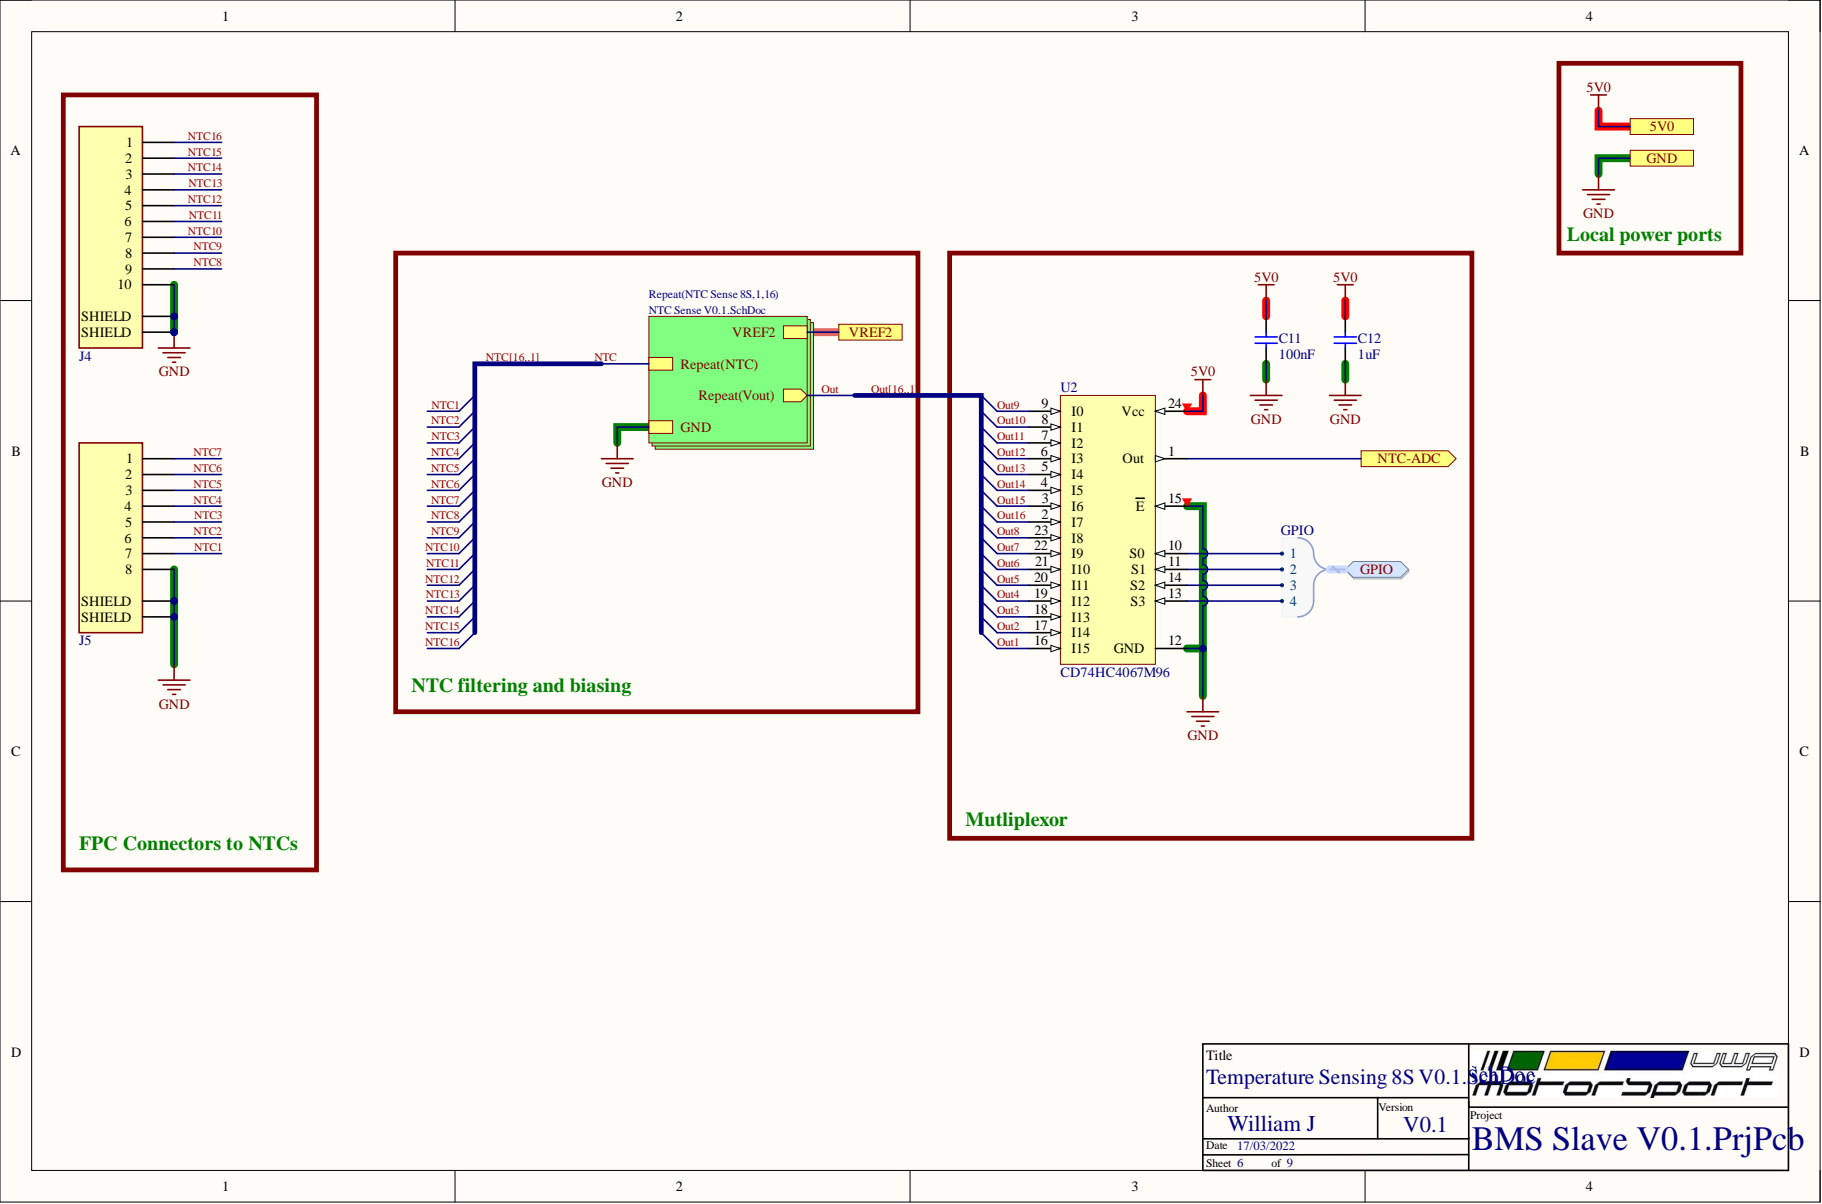
[picture p81: page 6]

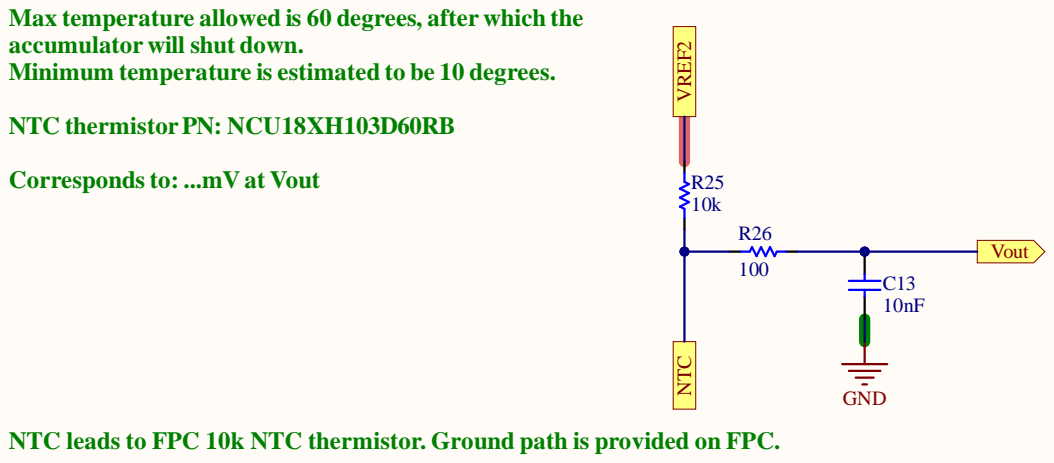
[picture p82: page 7]

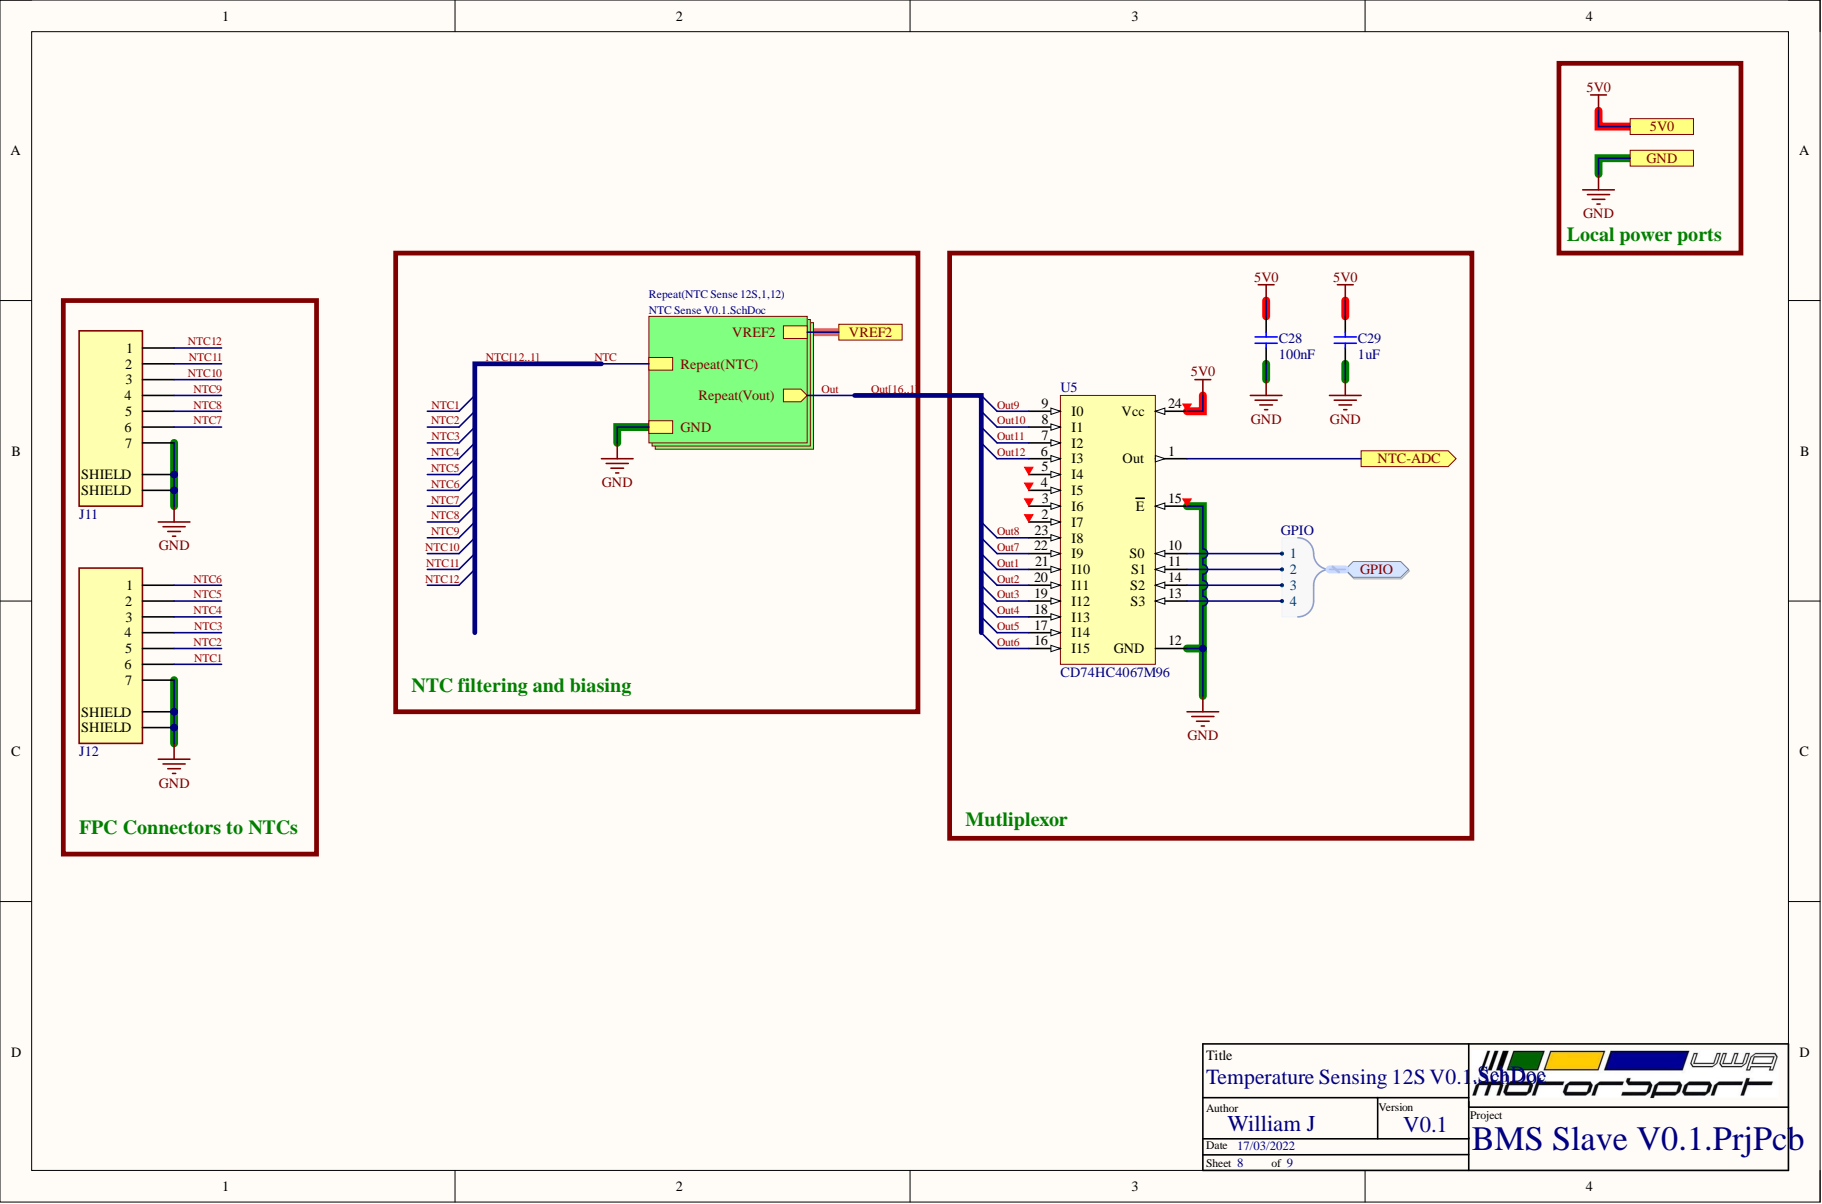
[picture p83: page 8]

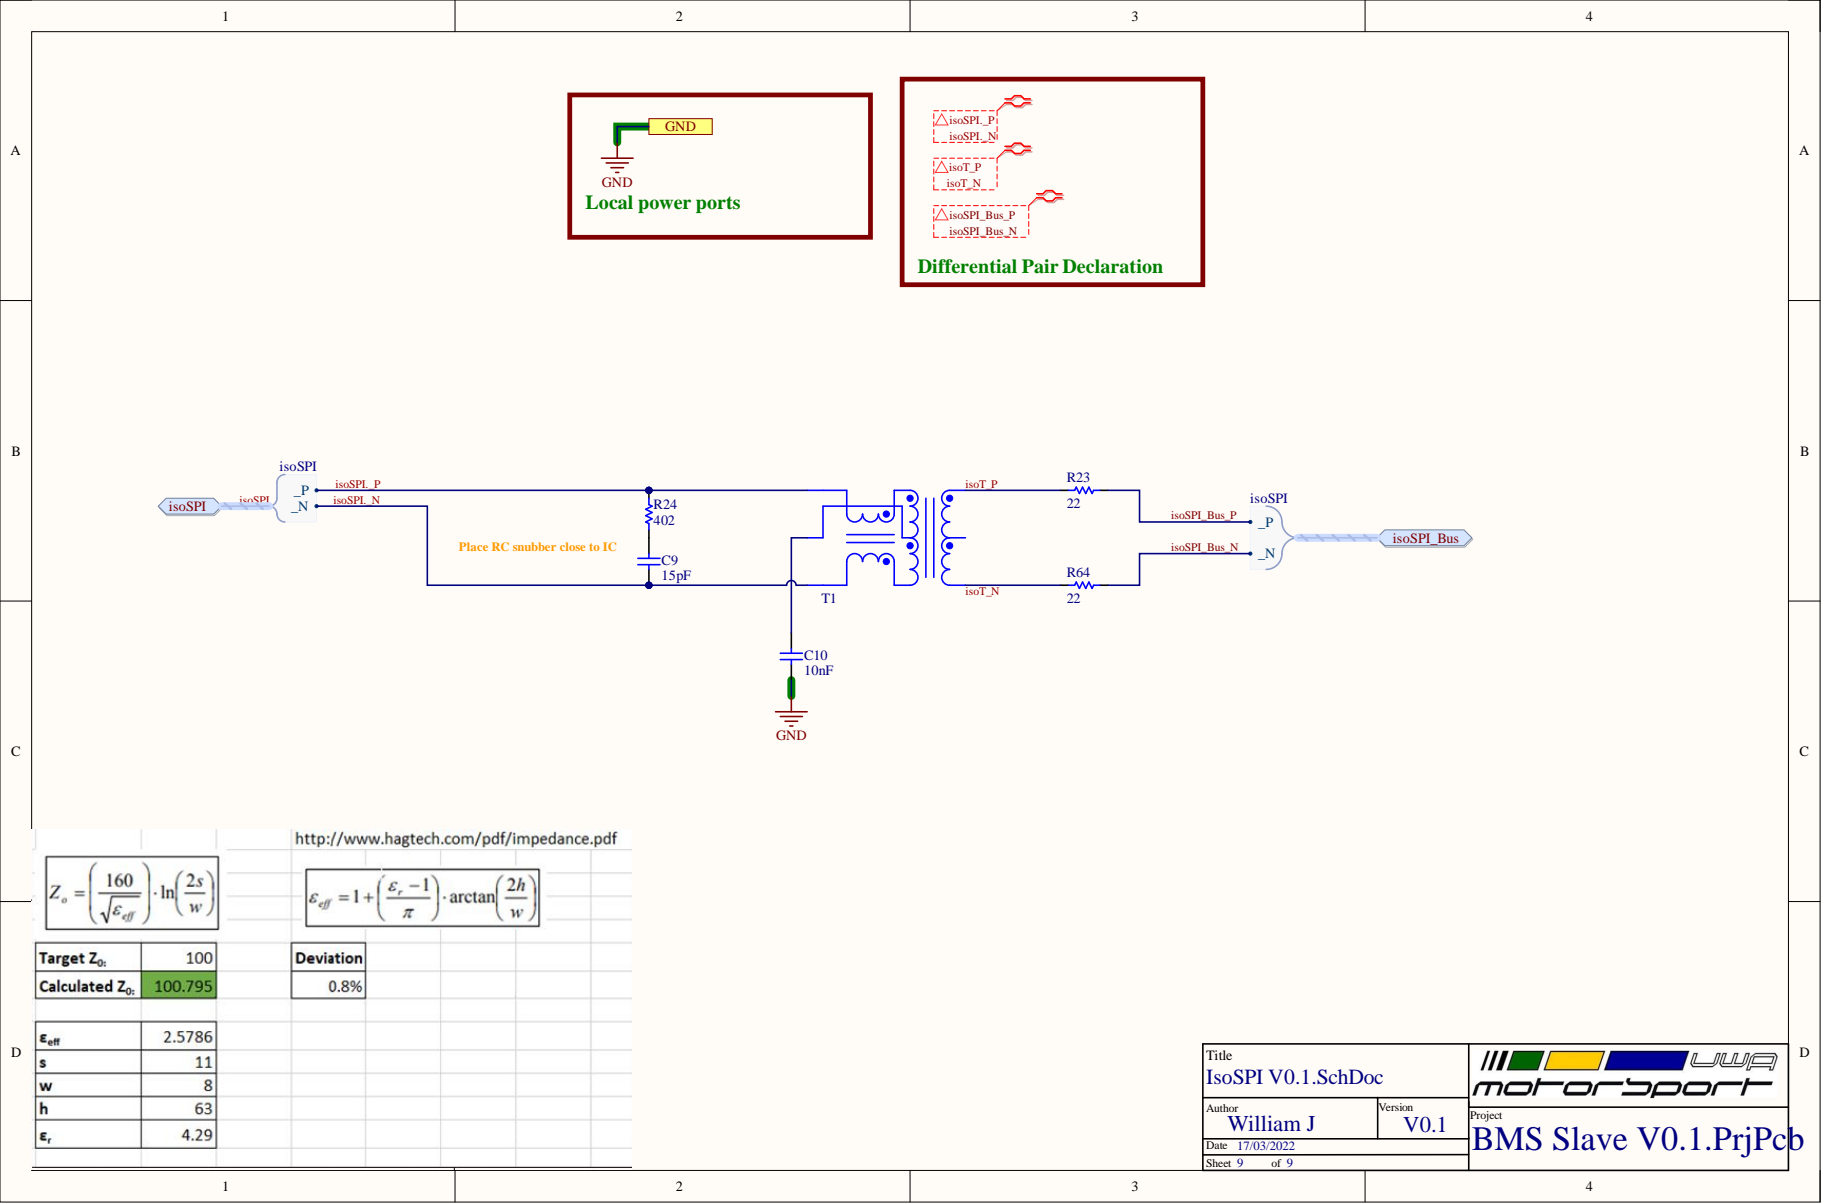
[picture p84: page 9]

C9 Place RC snubber close to IC

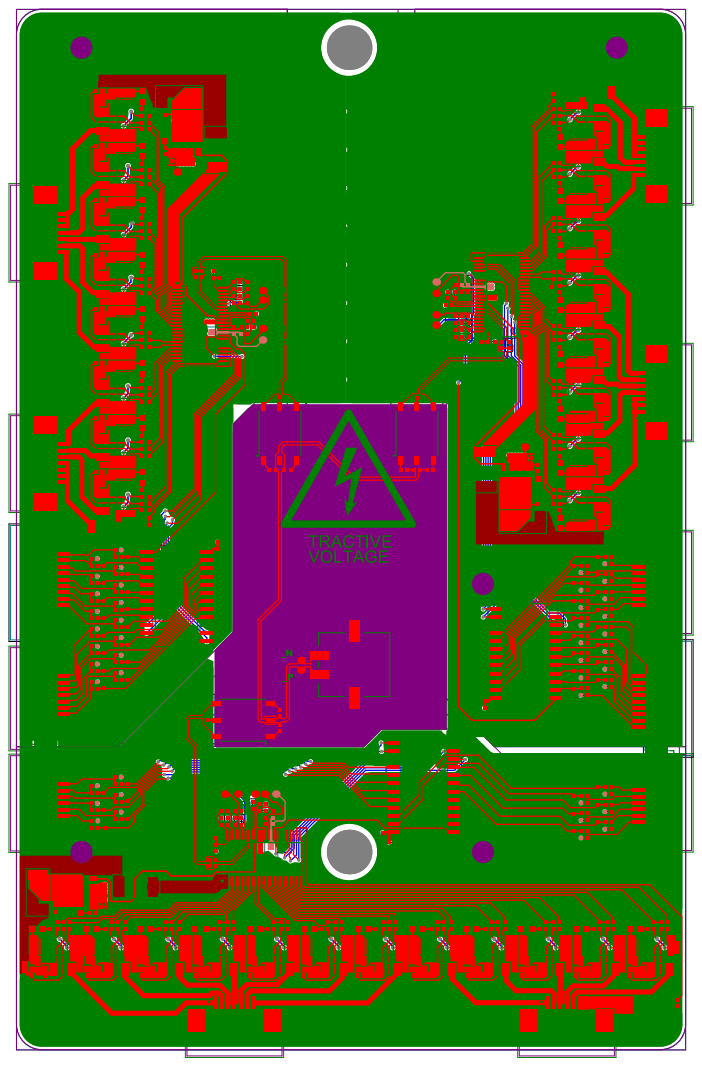
[picture p85: page 10]
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
