juppy10/HV_BMS/Hardware/Accumulator Management System/Project Outputs for Accumulator_MGMT_Sys/Schematics/Accumulator Management System.PDF

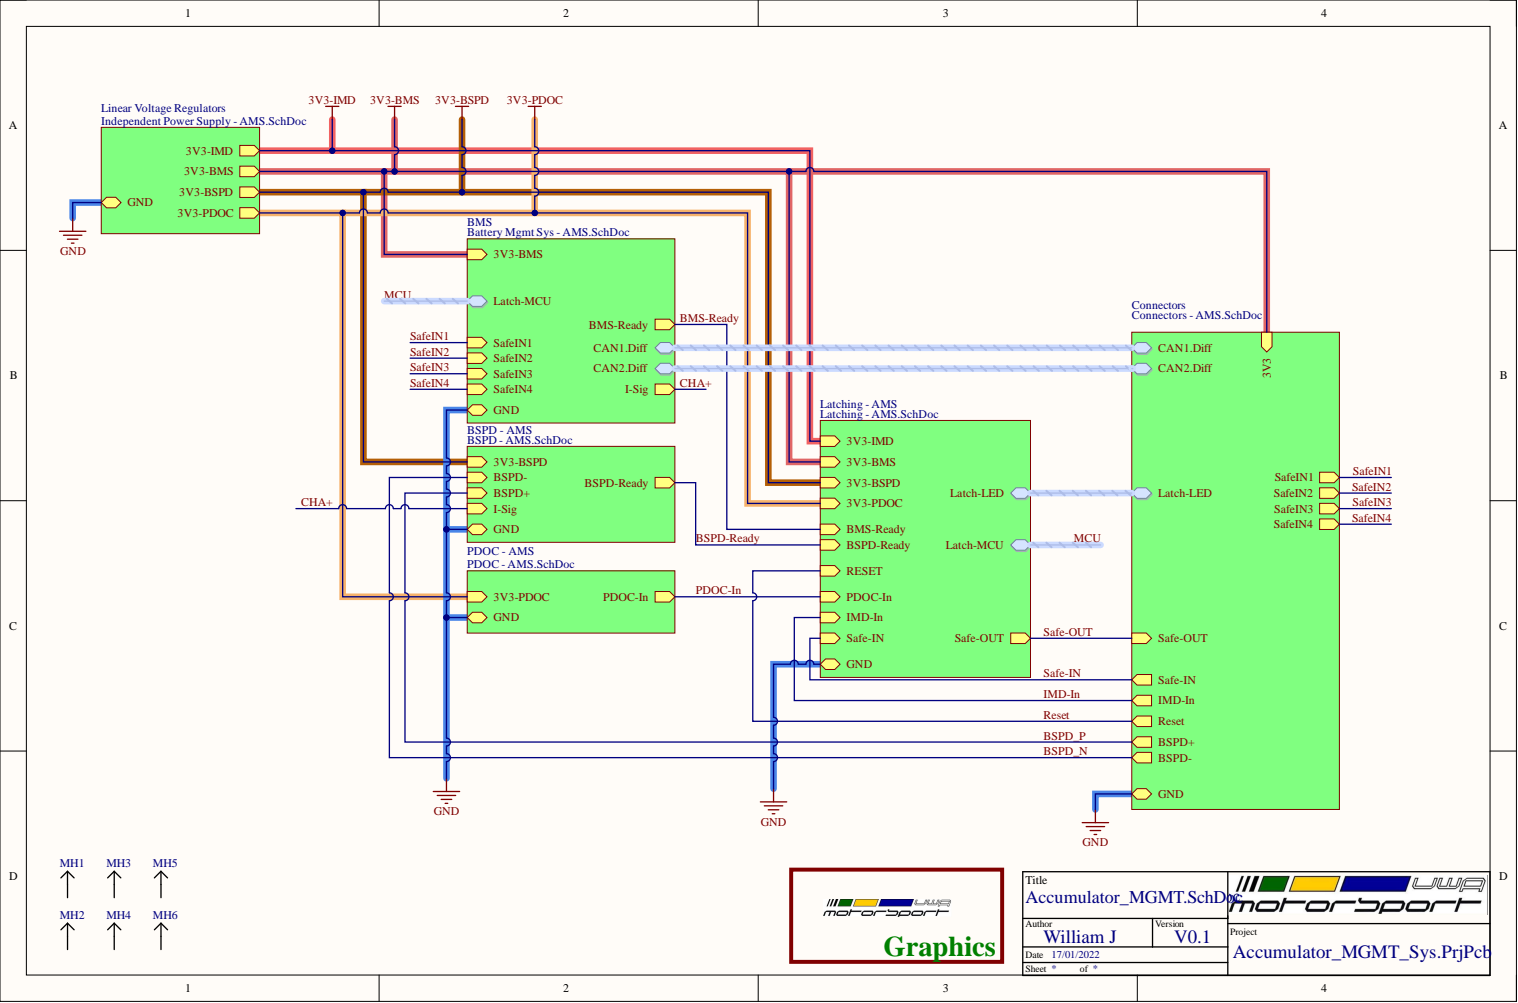
[picture p86: page 1]

AMS BSPD - AMS.Sch

BSPD -BSPD-Read y
BSPD +
I-Si g G N D

G N D | IMD-I n

Safe-IN Safe-O U T | Safe-O U T

G N D | Safe-IN

Res et

BSPD _P
BSPD _N

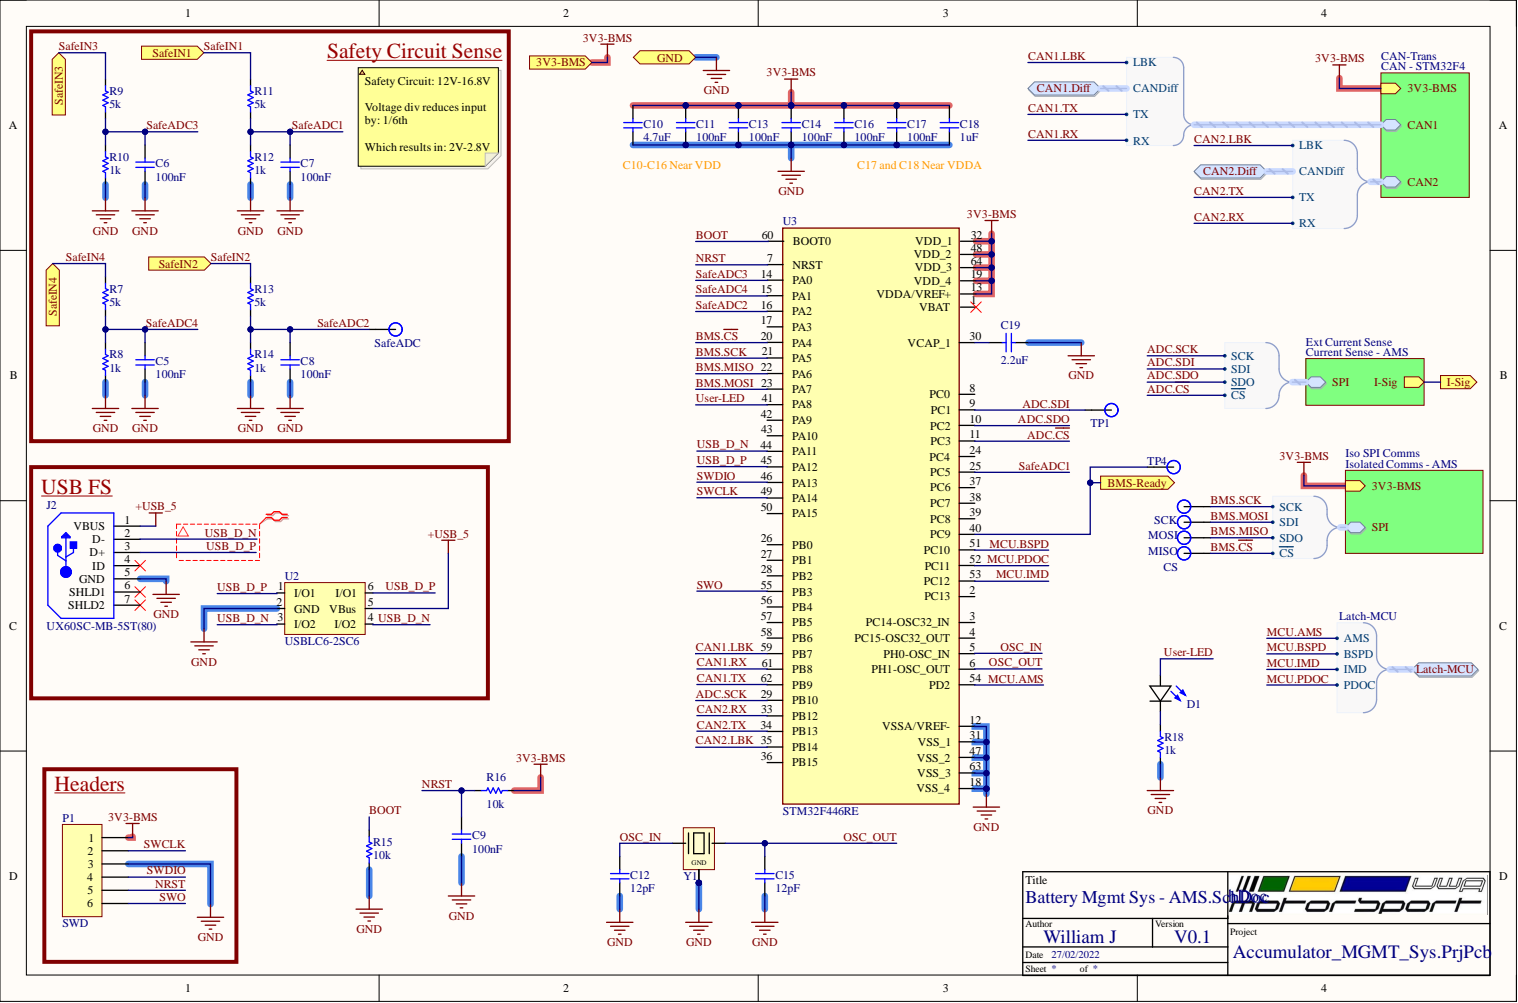
[picture p87: page 2]

o SPI Comms Isolated Comms-

2 | USB_ D _N
3 | USB_ D _P

gmt Sys - AMS.SchDo

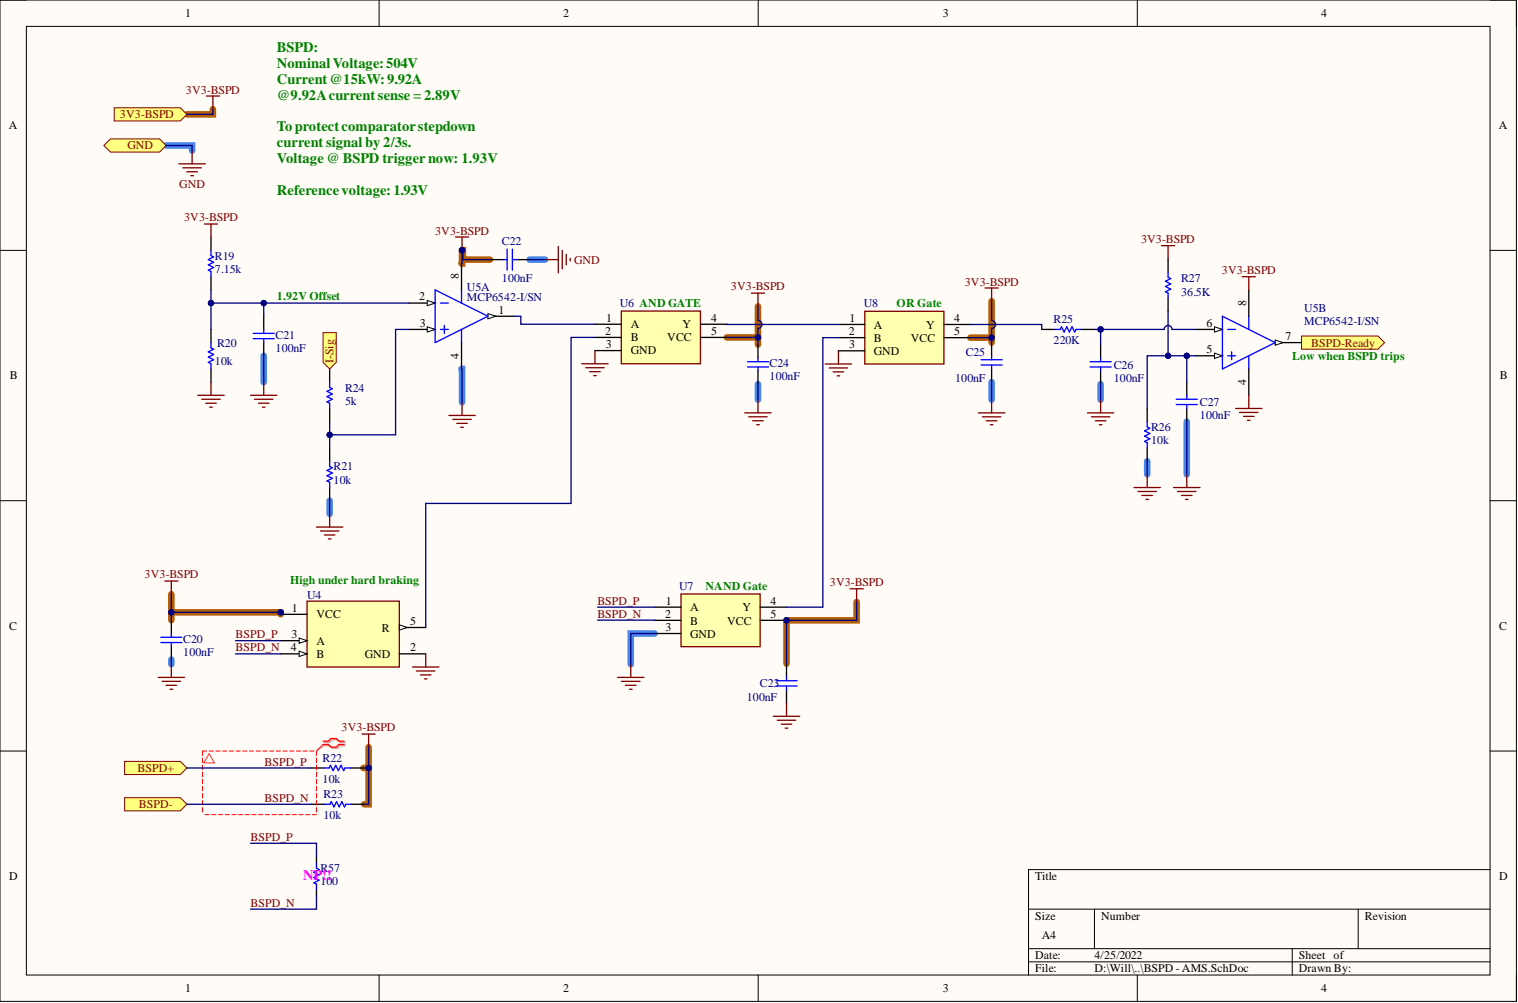
[picture p88: page 3]

To protect comparator stepdown
current signal by 2/3s.
Voltage @ BSPD trigger now: 1.93V

Low when BSPD trips 100nF

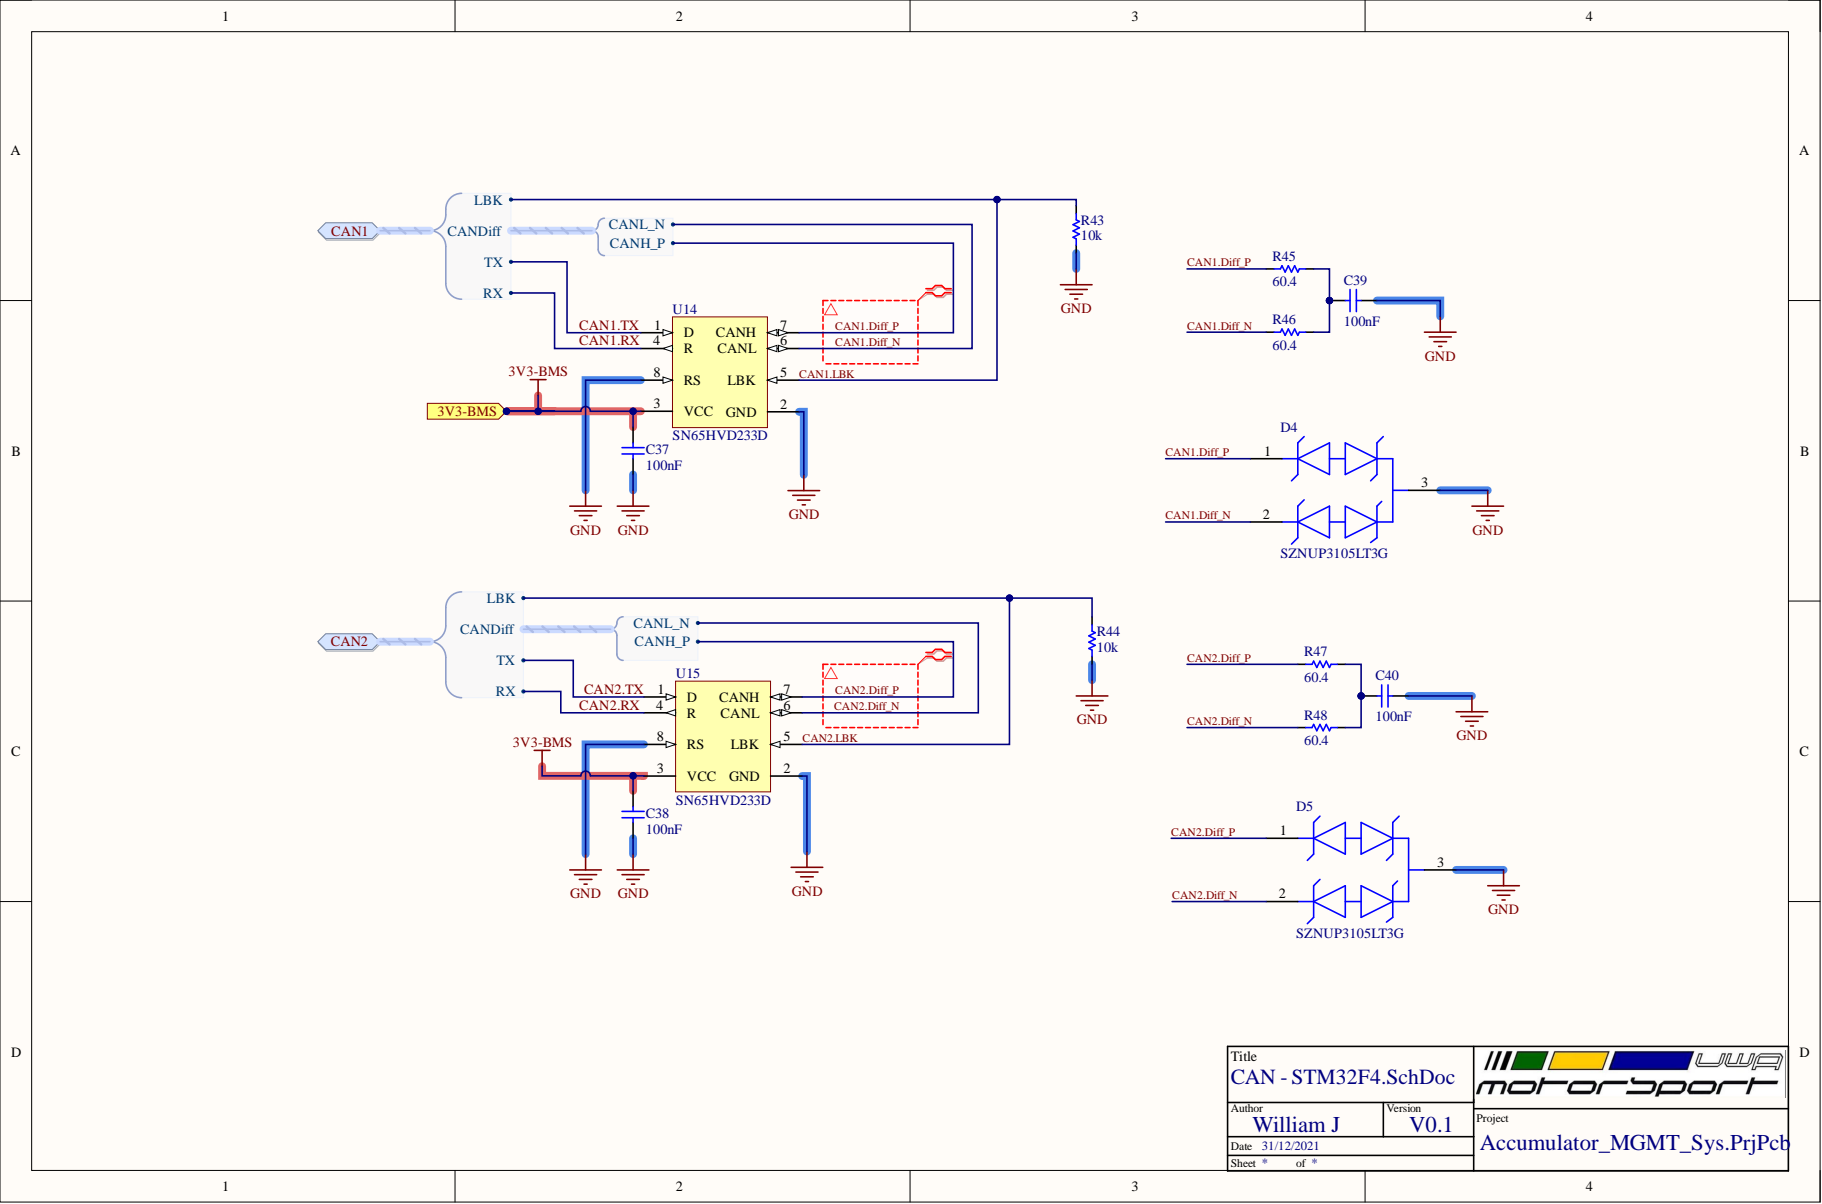
[picture p89: page 4]

3V3-BMS | RS 8

GND | 2 VCC 3

CAN2.RX | R 4 | CAN2.Diff_N

Title CAN - STM32F4.SchDoc

Author | Version

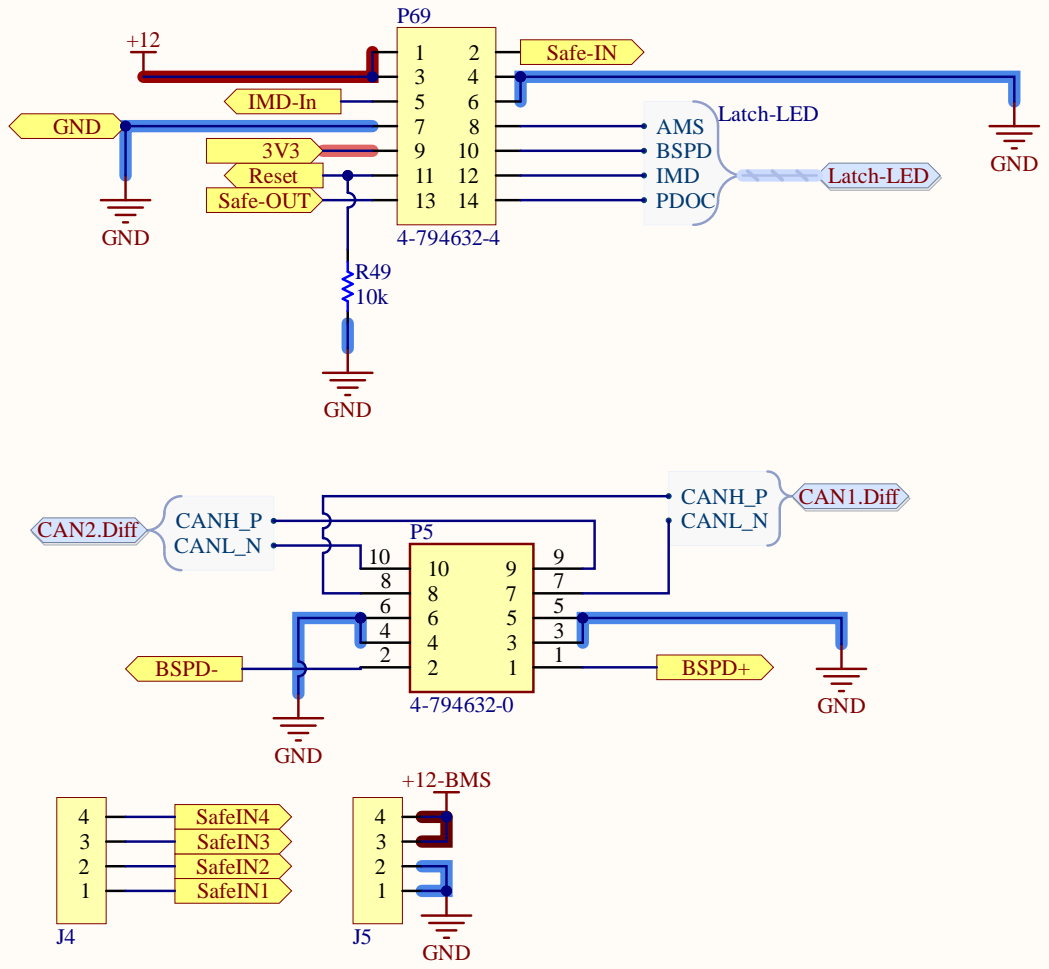
[picture p90: page 5]

Title Connectors - AMS.SchDoc

Author | Version

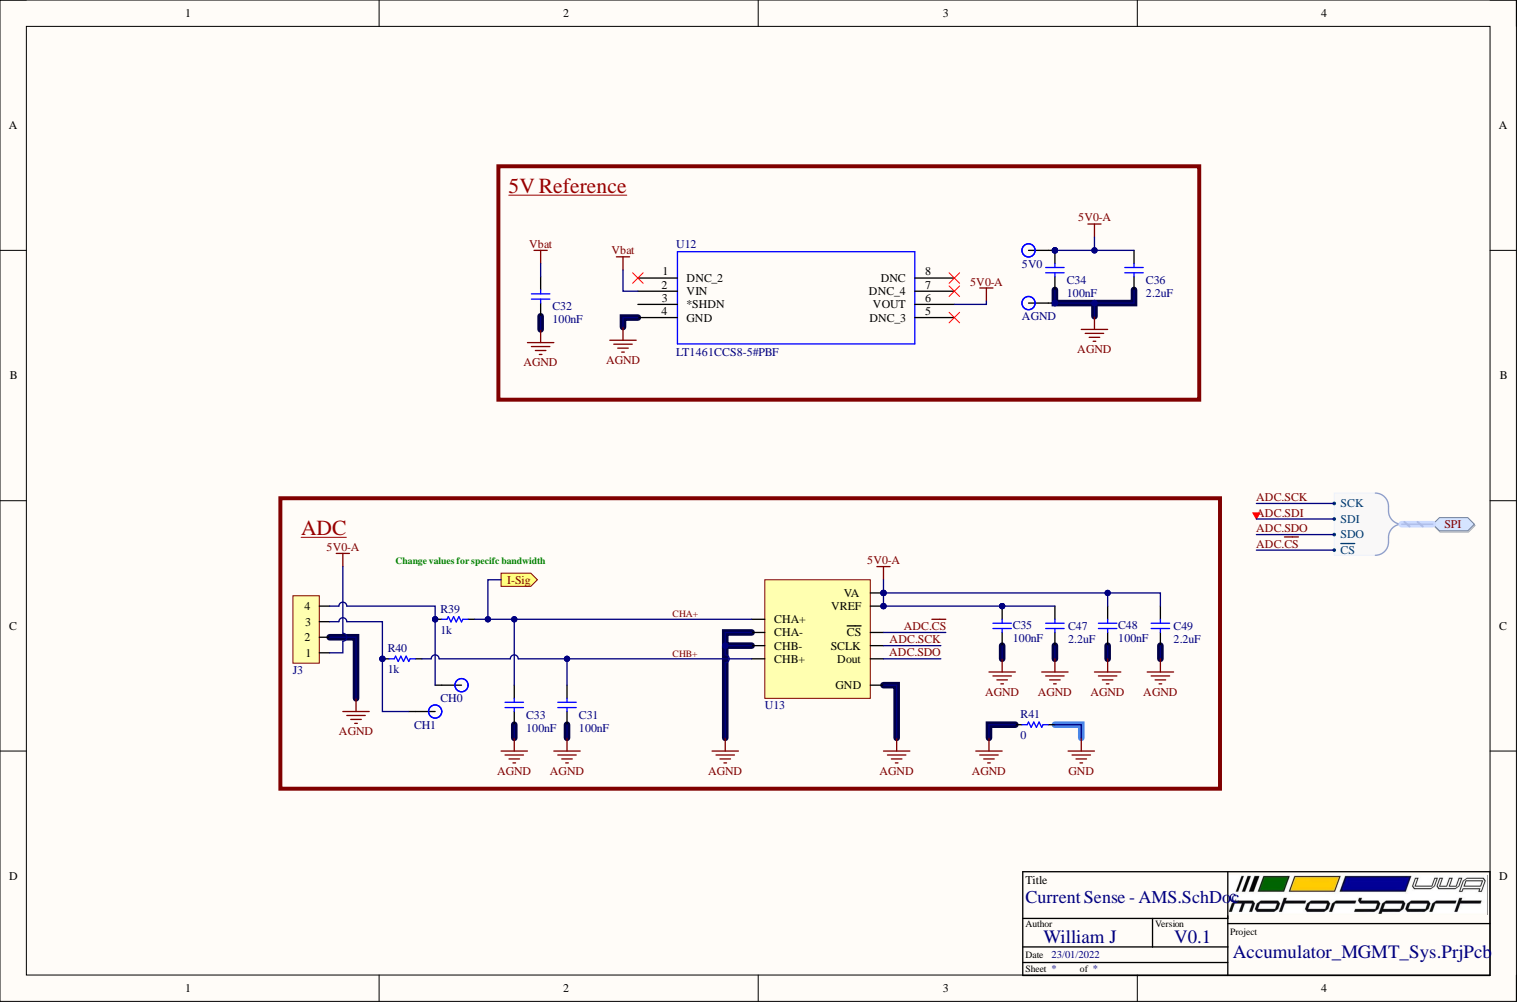
[picture p91: page 6]

Change values for specifc bandwidth

Title Current Sense - AMS.SchDoc

Author | Version

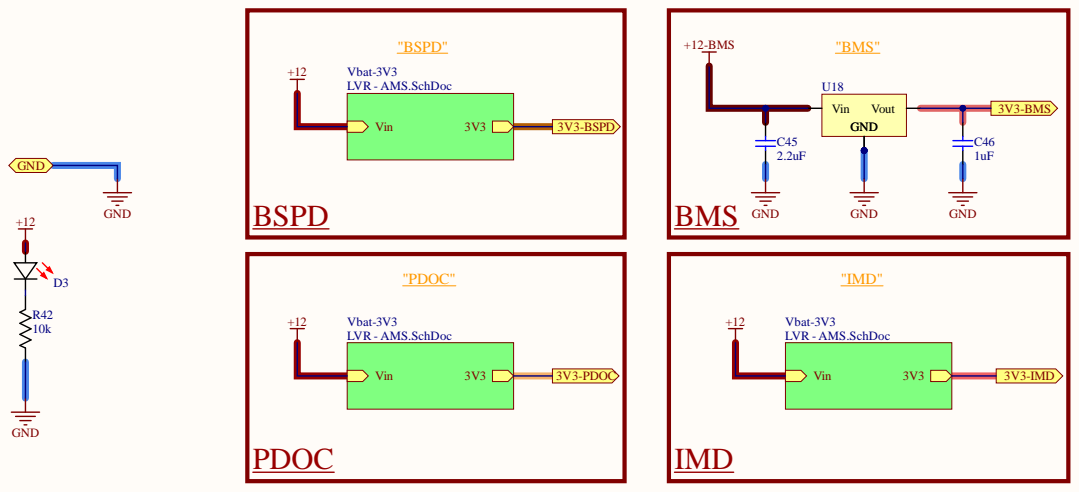
[picture p92: page 7]

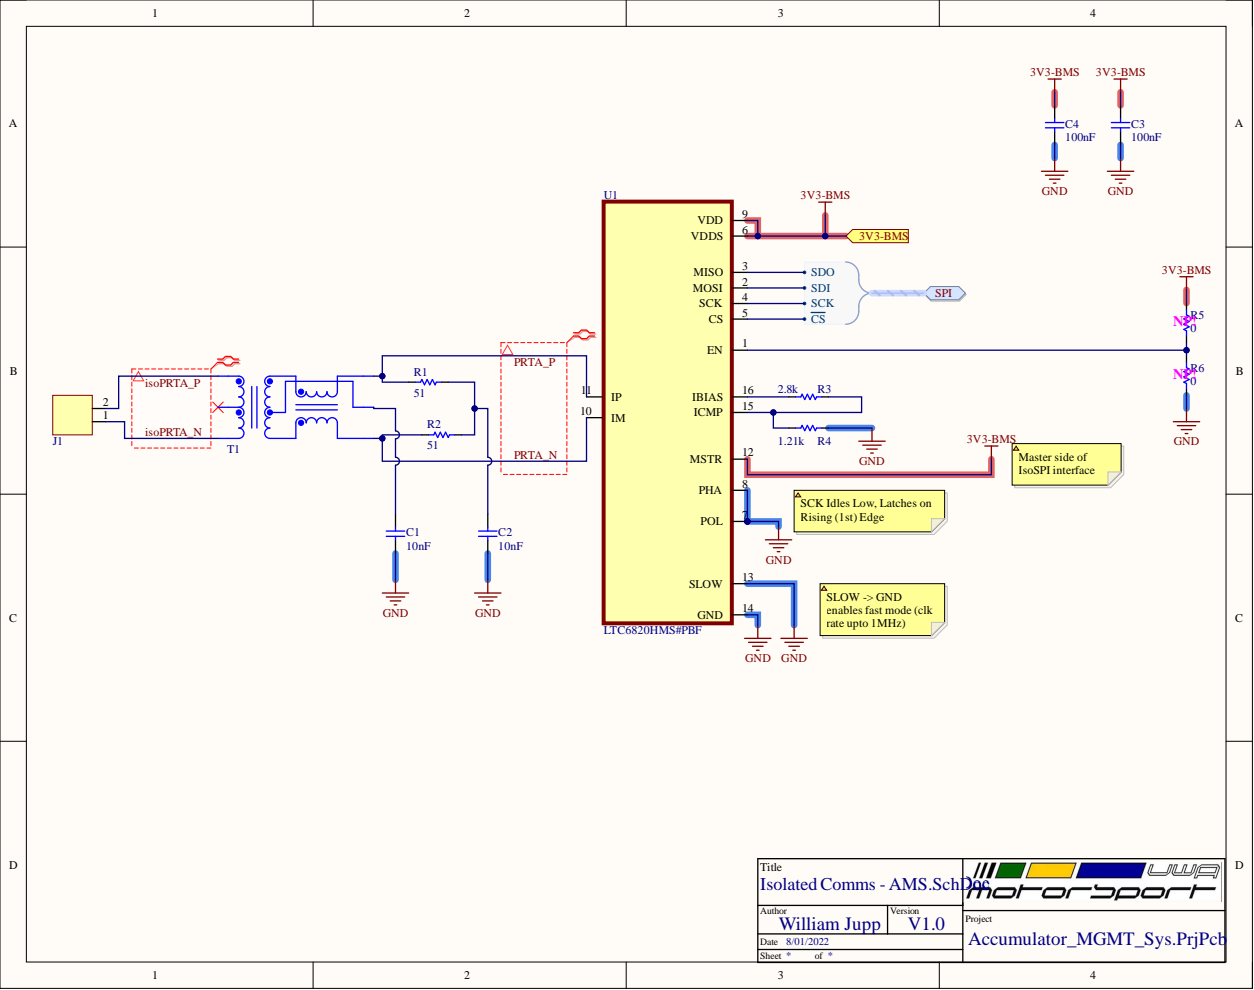
[picture p93: page 8]

R1 | PRTA _P | 1

T i tl e Isolated Comms - AMS.SchDo | c

William Ju p p

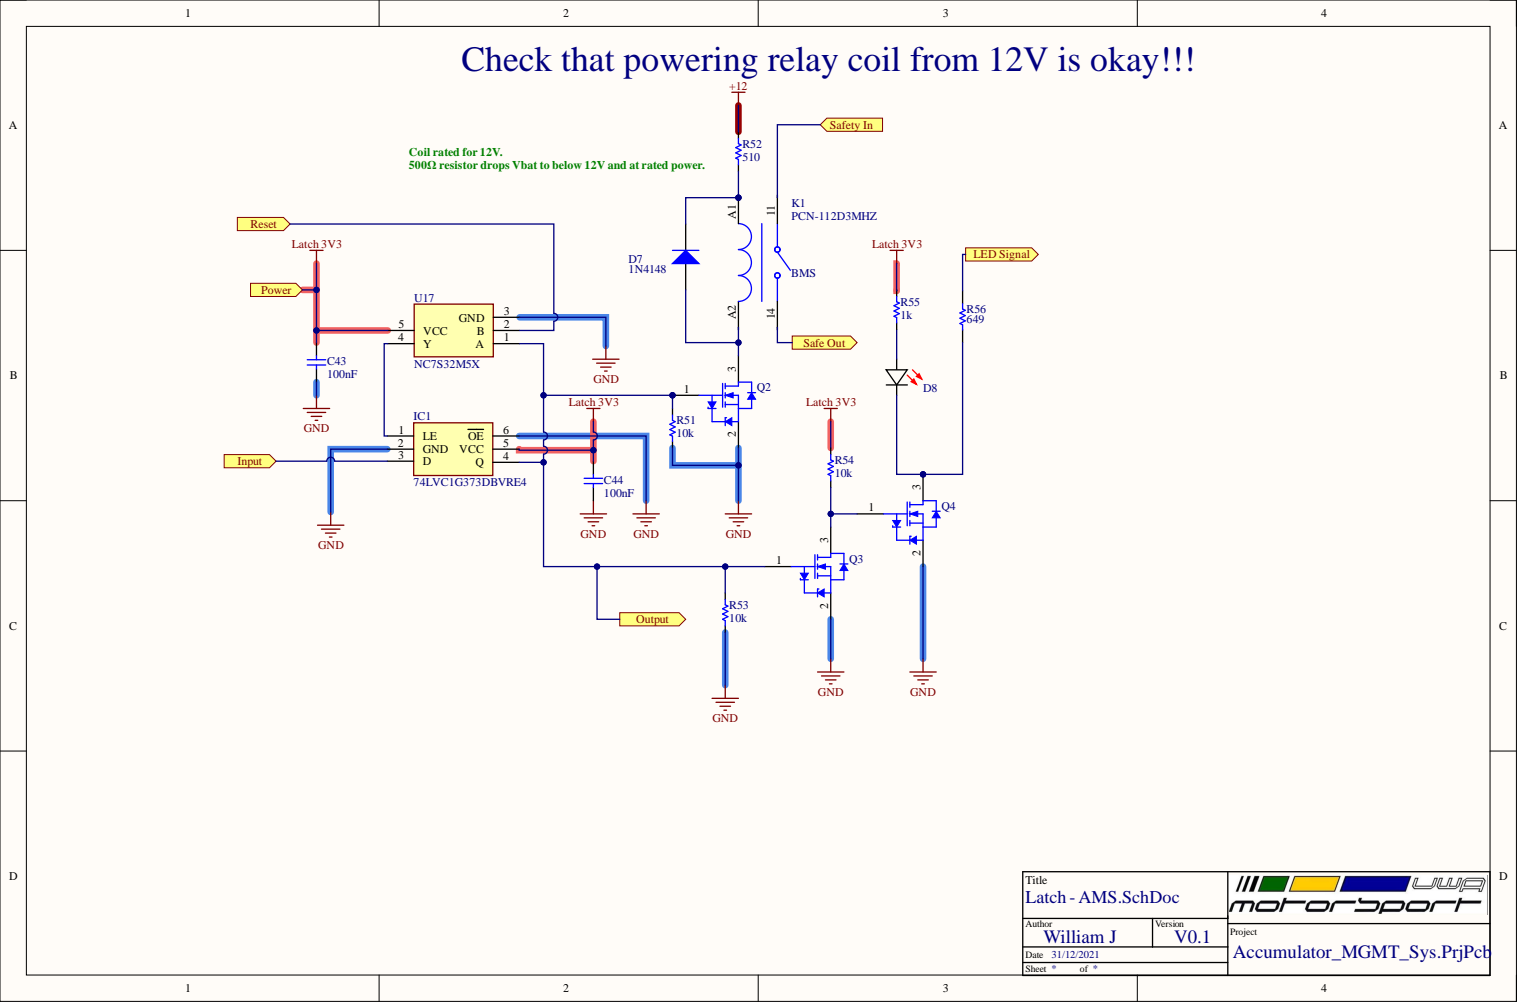
[picture p94: page 9]

Check that powering relay coil from 12V is okay!!! 100nF

Latch | 3 V 3

5 | G N D VCC B Y A | 2

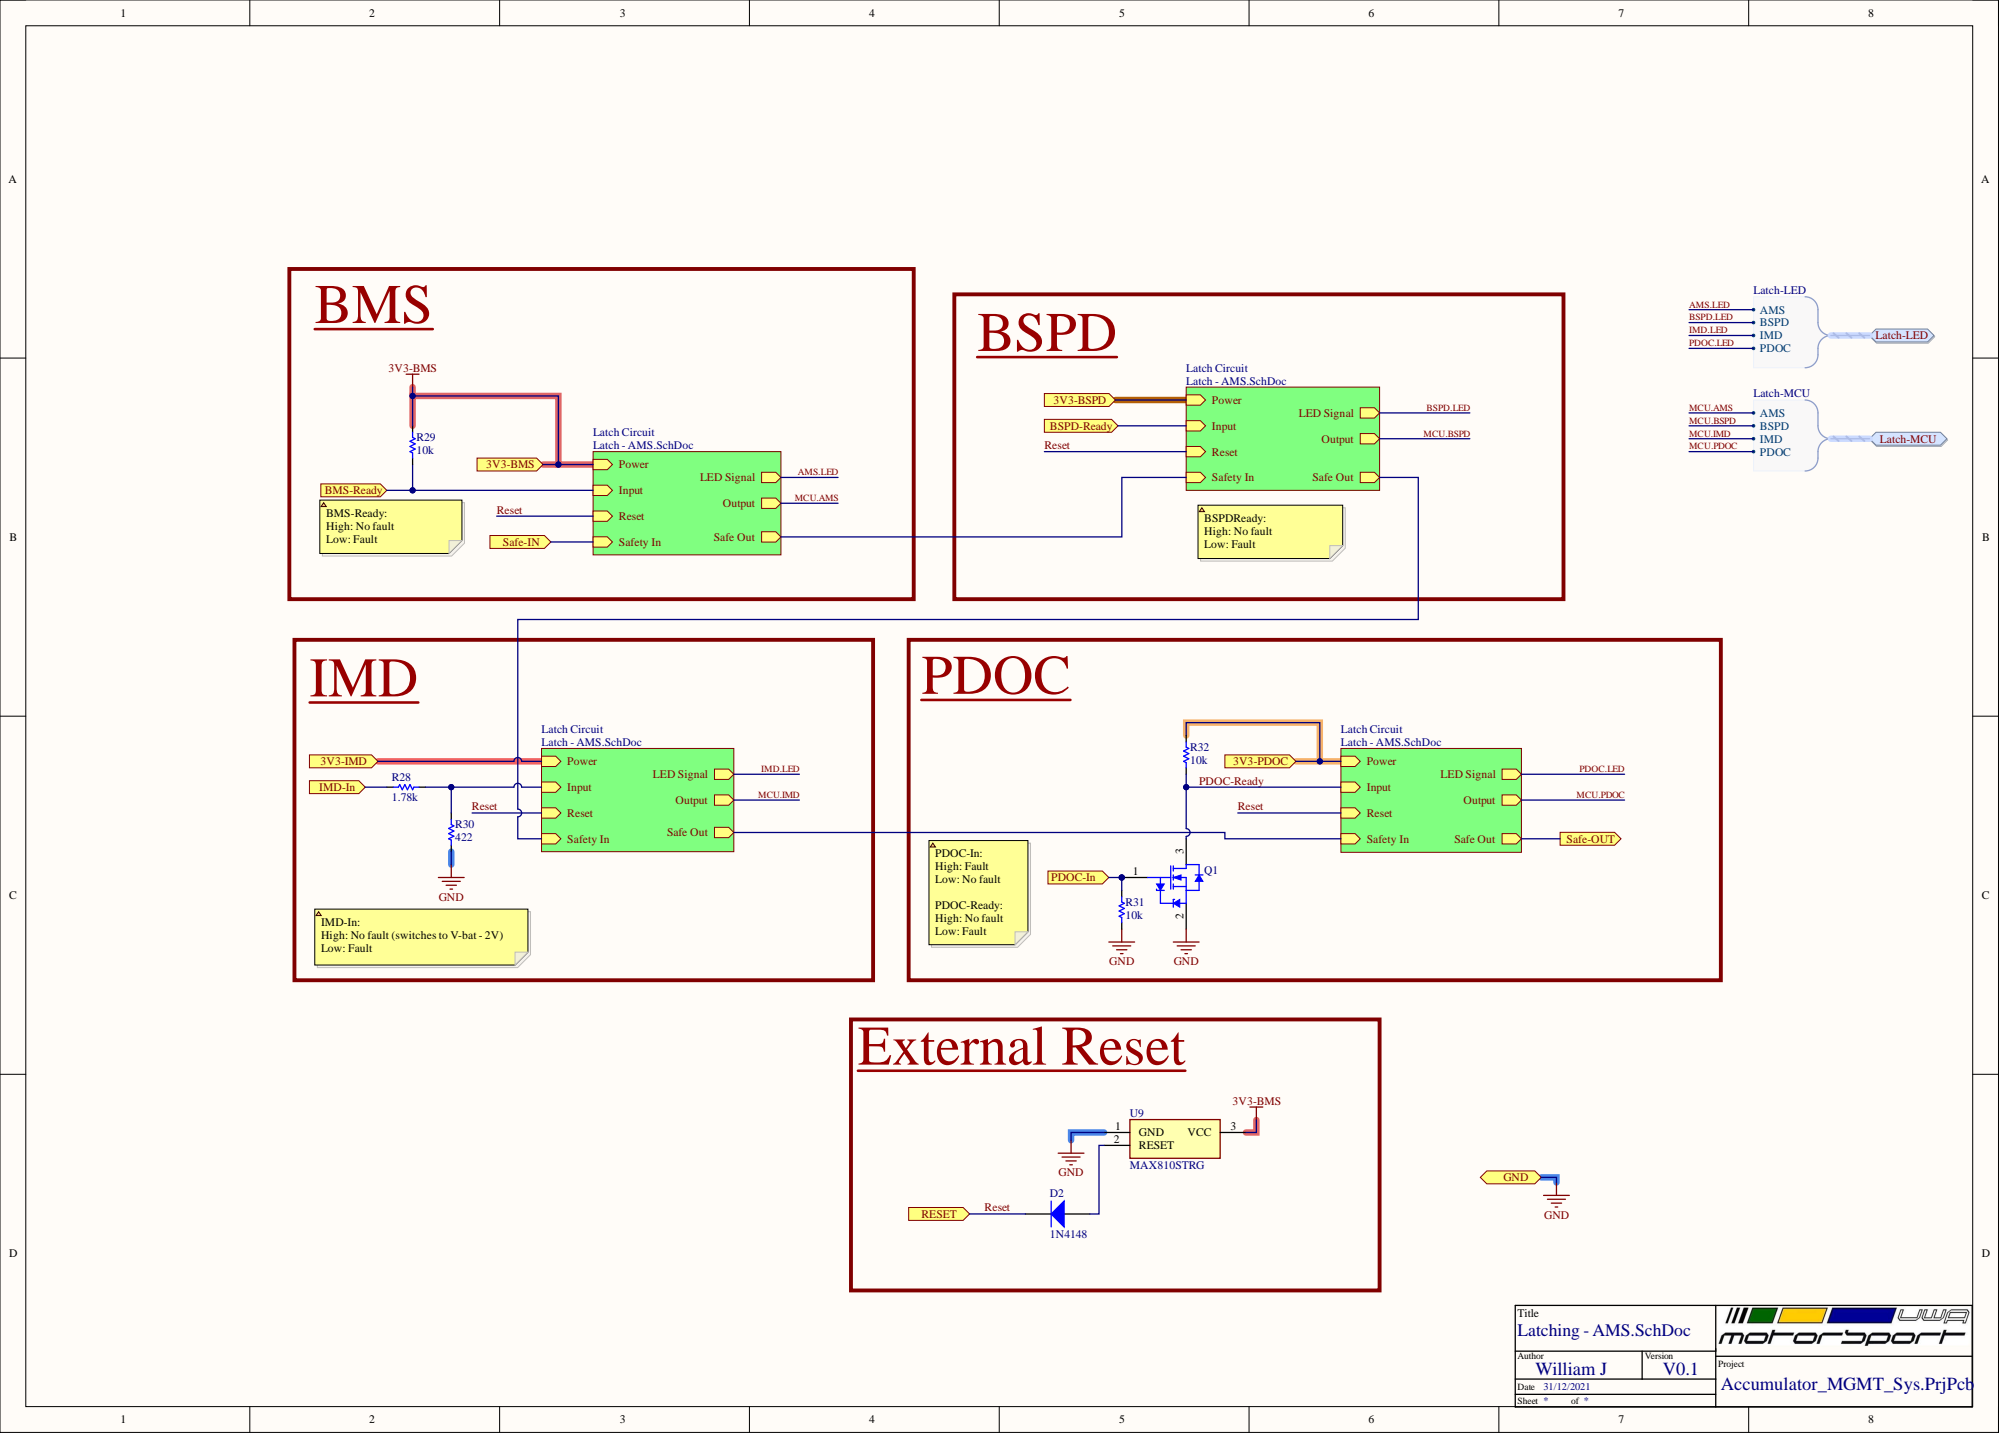
[picture p95: page 10]

IMD-In:
High: No fault (switches to V-bat - 2V)
Low: Fault

Title Latching - AMS.SchDoc

Author | Version

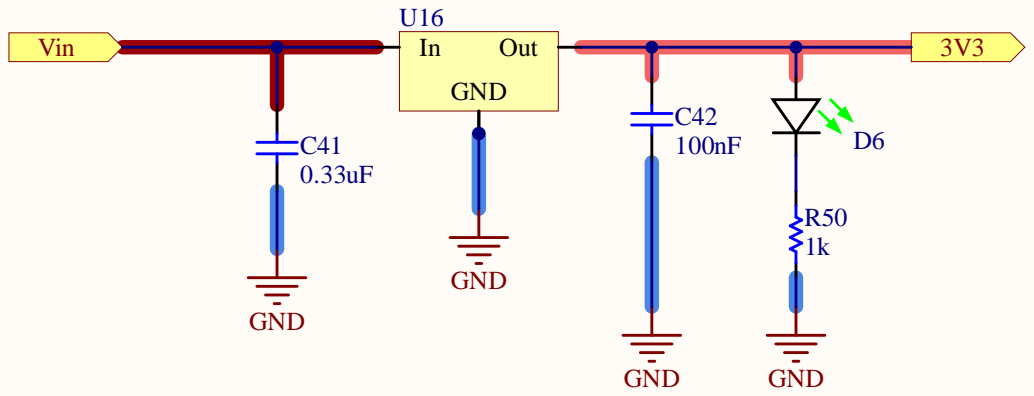
[picture p96: page 11]

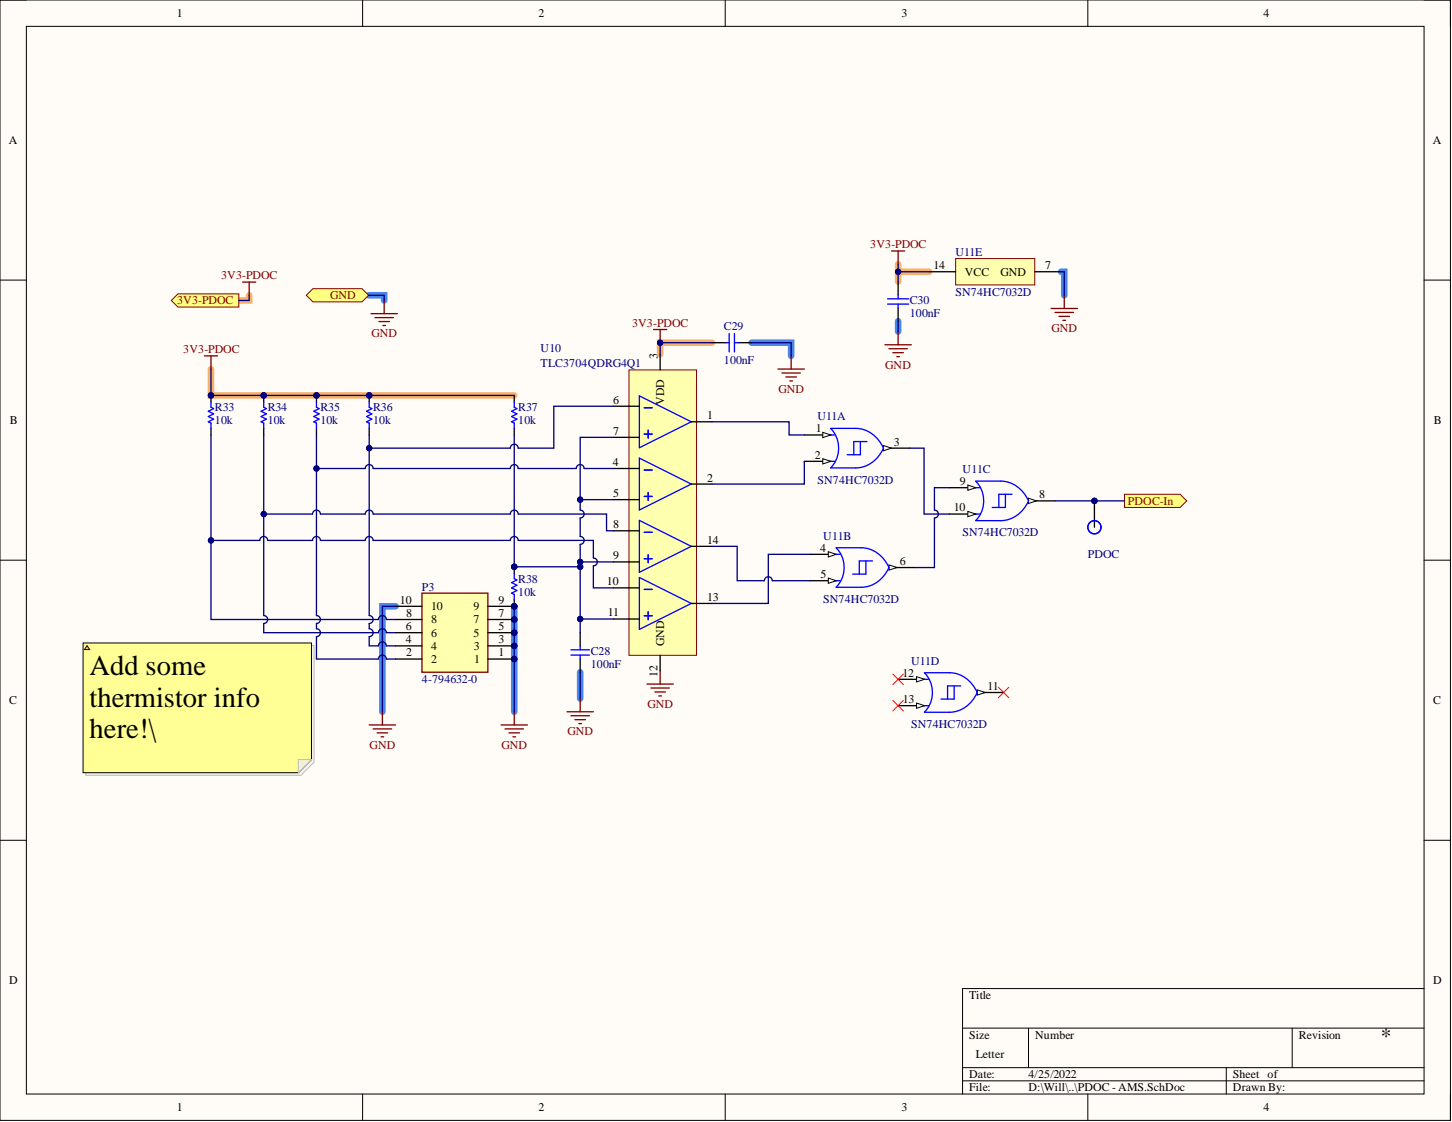
[picture p97: page 12]
