juppy10/HV_BMS/Simulations/Balance/Current Trace.pdf

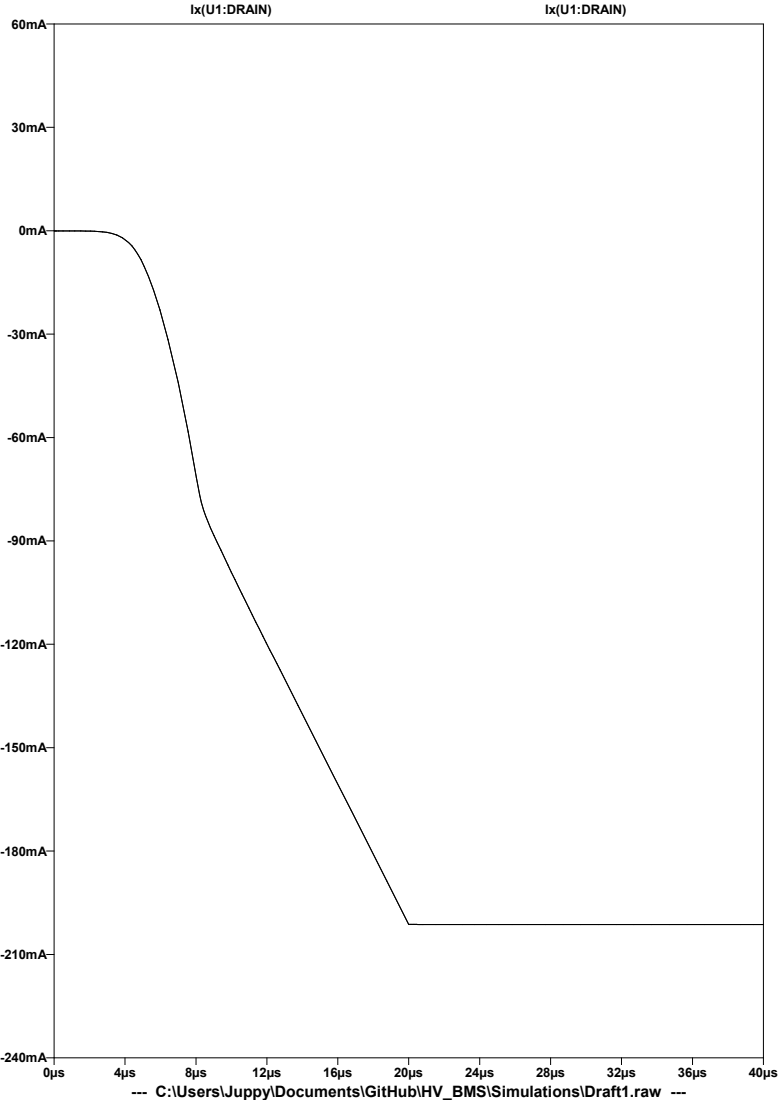
[picture p98: page 1]
Ix(U1:DRAIN)

--- C:\Users\Juppy\Documents\GitHub\HV_BMS\Simulations\Draft1.raw ---
