juppy10/HV_BMS/Simulations/Power_Supply.asc

Q1: npn; PBHV8115T
Q2: npn; MJD340
R1: res; 100
R2: res; 142
R3: res; 100
R4: res; 142
V1: voltage; 5.7
V2: voltage; 58.8
V3: voltage; 5.7
V4: voltage; 58.8
Named nets: 0
.tran 0 50u 0 0.1u startup
