juppy10/HV_BMS/Simulations/Balance/Balance.asc

R1: res; 3.3k
R2: res; 21
R3: res; 1k
U1: NX2301P
U2: 0603_150060SS55040
V2: voltage; 4.2
Named nets: 0
.tran 0 50u 0 0.1u startup
