juppy10/HV_BMS/(list of files, drawings)

Other design files:
Hardware/Accumulator Management System/Accumulator_MGMT.SchDoc
Hardware/Accumulator Management System/Accumulator_MGMT_Sys.PrjPcb
Hardware/Accumulator Management System/AMS.PcbDoc
Hardware/Accumulator Management System/Battery Mgmt Sys - AMS.SchDoc
Hardware/Accumulator Management System/BSPD - AMS.SchDoc
Hardware/Accumulator Management System/CAN - STM32F4.SchDoc
Hardware/Accumulator Management System/Connectors - AMS.SchDoc
Hardware/Accumulator Management System/Current Sense - AMS.SchDoc
Hardware/Accumulator Management System/Independent Power Supply - AMS.SchDoc
Hardware/Accumulator Management System/Isolated Comms - AMS.SchDoc
Hardware/Accumulator Management System/Latch - AMS.SchDoc
Hardware/Accumulator Management System/Latching - AMS.SchDoc
Hardware/Accumulator Management System/LVR - AMS.SchDoc
Hardware/Accumulator Management System/PCBLib.PcbLib
Hardware/Accumulator Management System/PCHLib.SchLib
Hardware/Accumulator Management System/PDOC - AMS.SchDoc
Hardware/Accumulator Management System/SamacSys.PcbLib
Hardware/Accumulator Management System/SamacSys.SchLib
Hardware/Accumulator Management System/SnapDocs/LT1461ACS8-3.PcbLib
Hardware/Accumulator Management System/SnapDocs/LT1461ACS8-3.SchLib
Hardware/Accumulator Management System/SnapDocs/LTC1861IMS#PBF.PcbLib
Hardware/Accumulator Management System/SnapDocs/LTC1861IMS#PBF.SchLib
Hardware/Accumulator Management System/SnapDocs/LTC6820HMS#PBF.PcbLib
Hardware/Accumulator Management System/SnapDocs/LTC6820HMS#PBF.SchLib
Hardware/Accumulator Management System/SnapDocs/UA78M33CKVURG3.PcbLib
Hardware/Accumulator Management System/SnapDocs/UA78M33CKVURG3.SchLib
Hardware/Accumulator Management System/TestPCB.PcbDoc
Hardware/BMS_Slave/Balance V0.1.SchDoc
Hardware/BMS_Slave/BMS Slave V0.1.PrjPcb
Hardware/BMS_Slave/BMS Slave V0.1.SchDoc
Hardware/BMS_Slave/BMS_Slave V0.1.PrjPcb
Hardware/BMS_Slave/Cell Monitor 8S LHS V0.1.SchDoc
Hardware/BMS_Slave/Cell Monitor 8S RHS V0.1.SchDoc
Hardware/BMS_Slave/Cell Monitor 12S V0.1.SchDoc
Hardware/BMS_Slave/FootprintLib.PcbLib
Hardware/BMS_Slave/IsoSPI V0.1.SchDoc
Hardware/BMS_Slave/NTC Sense V0.1.SchDoc
Hardware/BMS_Slave/SchematicLib.SchLib
Hardware/BMS_Slave/Temperature Sensing 8S V0.1.SchDoc
Hardware/BMS_Slave/Temperature Sensing 12S V0.1.SchDoc
Hardware/BMS_Slave_8S V0.1/Balance V0.1.SchDoc
Hardware/BMS_Slave_8S V0.1/BMS_Slave_8S V0.1.PcbDoc
Hardware/BMS_Slave_8S V0.1/BMS_Slave_8S V0.1.PrjPcb
Hardware/BMS_Slave_8S V0.1/BMS_Slave_8S V0.1.SchDoc
Hardware/BMS_Slave_8S V0.1/Cell Monitor V0.1.SchDoc
Hardware/BMS_Slave_8S V0.1/Footprints.PcbLib
Hardware/BMS_Slave_8S V0.1/IsoSPI V0.1.SchDoc
Hardware/BMS_Slave_8S V0.1/NTC Sense V0.1.SchDoc
Hardware/BMS_Slave_8S V0.1/Schematics.SchLib
Hardware/BMS_Slave_8S V0.1/Temperature Sensing V0.1.SchDoc
Hardware/BMS_Slave_12S V0.1/Balance V0.1.SchDoc
Hardware/BMS_Slave_12S V0.1/BMS_Slave_12S V0.1.PrjPcb
Hardware/BMS_Slave_12S V0.1/BMS_Slave_12S V0.1.SchDoc
Hardware/BMS_Slave_12S V0.1/Cell Monitor V0.1.SchDoc
Hardware/BMS_Slave_12S V0.1/FootprintLib.PcbLib
Hardware/BMS_Slave_12S V0.1/IsoSPI V0.1.SchDoc
Hardware/BMS_Slave_12S V0.1/NTC Sense V0.1.SchDoc
Hardware/BMS_Slave_12S V0.1/SchematicLib.SchLib
Hardware/BMS_Slave_12S V0.1/Temperature Sensing V0.1.SchDoc
Hardware/PCB_Project/AFE.SchDoc
Hardware/PCB_Project/Balance_Circuit.SchDoc
Hardware/PCB_Project/HV_BMS.PrjPcb
Hardware/PCB_Project/HV_BMS_PCB_LIB.PcbLib
Hardware/PCB_Project/HV_BMS_SCH_LIB.SchLib
Hardware/PCB_Project/HV_BMS_Slave.SchDoc
Hardware/PCB_Project/ISO_COMMS.SchDoc
Hardware/PCB_Project/LTC6811_1.SchDoc
Hardware/PCB_Project/LTC6812-1.SchDoc
Hardware/PCB_Project/Slave_LHS.PcbDoc
Hardware/PCB_Project/Temp_Sense - Copy.SchDoc
Hardware/z_Archived/BMS_Slave_8S V0.1/Balance V0.1.SchDoc
Hardware/z_Archived/BMS_Slave_8S V0.1/BMS_Slave_8S V0.1.PcbDoc
Hardware/z_Archived/BMS_Slave_8S V0.1/BMS_Slave_8S V0.1.PrjPcb
Hardware/z_Archived/BMS_Slave_8S V0.1/BMS_Slave_8S V0.1.SchDoc
Hardware/z_Archived/BMS_Slave_8S V0.1/Cell Monitor V0.1.SchDoc
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
