juppy10/HV_BMS/Firmware/SoC_Est_Test/SoC_Est_Test.ioc

Mcu.UserName=STM32F446RETx
PA13.GPIO_Label=TMS
PA13.Signal=SYS_JTMS-SWDIO
PA14.GPIO_Label=TCK
PA14.Signal=SYS_JTCK-SWCLK
PA2.GPIO_Label=USART_TX
PA2.Signal=USART2_TX
PA3.GPIO_Label=USART_RX
PA3.Signal=USART2_RX
PA5.Signal=SPI1_SCK
PA6.Signal=SPI1_MISO
PA7.Signal=SPI1_MOSI
PB3.GPIO_Label=SWO
PB3.Signal=SYS_JTDO-SWO
PB6.GPIO_Label=CS1
PB6.Signal=GPIO_Output
PC0.Signal=ADCx_IN10
PC11.Signal=GPXTI11
PC13.GPIO_Label=B1 [Blue PushButton]
PC13.Signal=GPXTI13
PC14-OSC32_IN.Signal=RCC_OSC32_IN
PC15-OSC32_OUT.Signal=RCC_OSC32_OUT
PC3.GPIO_Label=SPI2_CS
PC3.Signal=GPIO_Output
PC7.GPIO_Label=CS2
PC7.Signal=GPIO_Output
PH0-OSC_IN.Signal=RCC_OSC_IN
PH1-OSC_OUT.Signal=RCC_OSC_OUT
