juppy10/HV_BMS/Firmware/DevBoard_Test/Core/Src/main.c

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
/* Includes ------------------------------------------------------------------*/
#include "main.h"

/* USER CODE BEGIN Includes */
#include <stdio.h>
/* USER CODE END Includes */

ADC_HandleTypeDef hadc1;

SPI_HandleTypeDef hspi1;

TIM_HandleTypeDef htim11;
TIM_HandleTypeDef htim12;
TIM_HandleTypeDef htim13;
TIM_HandleTypeDef htim14;

UART_HandleTypeDef huart2;

void SystemClock_Config(void);
static void MX_GPIO_Init(void);
static void MX_USART2_UART_Init(void);
static void MX_TIM13_Init(void);
static void MX_SPI1_Init(void);
static void MX_TIM14_Init(void);
static void MX_TIM11_Init(void);
static void MX_TIM12_Init(void);
static void MX_ADC1_Init(void);
/* USER CODE BEGIN 0 */
LTC6811_2_IC ic;
ACCUMULATOR acc;
/* USER CODE END 0 */

/**
  * @brief  The application entry point.
  * @retval int
  */
int main(void)
{
  /* MCU Configuration--------------------------------------------------------*/

  /* Reset of all peripherals, Initializes the Flash interface and the Systick. */
  HAL_Init();

  /* Configure the system clock */
  SystemClock_Config();

  /* Initialize all configured peripherals */
  MX_GPIO_Init();
  MX_USART2_UART_Init();
  MX_TIM13_Init();
  MX_SPI1_Init();
  MX_TIM14_Init();
  MX_TIM11_Init();
  MX_TIM12_Init();
  MX_ADC1_Init();
  /* USER CODE BEGIN 2 */
	HAL_TIM_Base_Start(&htim11);

	HAL_GPIO_WritePin(CS1_GPIO_Port, CS1_Pin, 1);
	HAL_GPIO_WritePin(CS2_GPIO_Port, CS2_Pin, 1);
	/*uart_buf_len = sprintf(uart_buf, "Timer test\r\n");
	HAL_UART_Transmit(&huart2, (uint8_t *)uart_buf, uart_buf_len, 100);

	uart_buf2[0] = 0x41;
	uart_buf2[1] = 0x42;
	uart_buf2[2] = 0x43;
	uart_buf2[3] = 0x0D;
	uart_buf2[4] = 0x0A;

	HAL_UART_Transmit(&huart2, (uint8_t *)uart_buf2, 5, 100);*/

	//ic.address = 0b11010000;
	//ic.num_Cells = 8;
	ic.UV_OV_Flag = 0;
	ic.num_Cells = 15;
	ic.address = 0x00;
	//LTC6811_startup_new(&ic);

	LTC6811_startup(&ic);
	//get_init_SoC(&acc);


	HAL_TIM_Base_Start_IT(&htim14);
	//HAL_TIM_Base_Start_IT(&htim13);

	//TEST_dischargeCell(&ic);

	//if (chargePin == 1){						//Balance charging enable
		if(ic.UV_OV_Flag == 0){
			HAL_TIM_Base_Start_IT(&htim13);
		}
	//
	//}

  /* USER CODE END 2 */

  /* Infinite loop */
  /* USER CODE BEGIN WHILE */

  while (1)
  {

    /* USER CODE END WHILE */

    /* USER CODE BEGIN 3 */
  }
  /* USER CODE END 3 */
}

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
/* USER CODE BEGIN 4 */
void HAL_TIM_PeriodElapsedCallback(TIM_HandleTypeDef *htim){
	if(htim == &htim13){				//0.5 second timer
		//TEST_dischargeCell(&ic);
		if(ic.UV_OV_Flag == 1){
			HAL_TIM_Base_Stop_IT(&htim13);
		}else{
			chargeMODE(&ic,&acc);
		}
		//TEST_dischargeCell(&ic);
	}else if(htim == &htim14){			//100ms timer
		//updateSegmentVoltages_new(&ic);	//update segment structure cell voltages
		updateSegmentVoltages_And_Temp(&ic);
		if(check_UV_OV_flags_new(&ic)){// || check_temp(&ic)){		//check for UV/OV conditions
			//do something?????
			HAL_GPIO_WritePin(CS2_GPIO_Port, CS2_Pin, 0);
			ic.UV_OV_Flag = 1;
		}else{
			HAL_GPIO_WritePin(CS2_GPIO_Port, CS2_Pin, 1);
			ic.UV_OV_Flag = 0;
		}
		//update_Current(&acc);
		//SoC_Update(&acc);
		print_Cell_Voltages(&ic, &acc);			//print over serial
	}
	else if(htim == &htim12){
		if(ic.num_balanced_cells != -1){	//if balance timer has triggered and we are balancing cells, disable balance
			ic.CFGR[4] = 0x00;
			ic.CFGR[5] = 0x00;
			ic.CFGRB[0] &= (0b10001111);
			LTC6811_WRCFGA(ic);
			LTC6811_WRCFGB(ic);
			ic.num_balanced_cells = -1;		//-1 indicates that we are resting between discharges
		}else{
			ic.num_balanced_cells = 0;
			HAL_TIM_Base_Stop_IT(&htim12);
		}
	}
}

void delay_us(uint16_t us){
	__HAL_TIM_SET_COUNTER(&htim11,0);  // set the counter value a 0
	while (__HAL_TIM_GET_COUNTER(&htim11) < us);
}

void delay_s(uint16_t s){			//max 26seconds
	__HAL_TIM_SET_COUNTER(&htim12,0);  // set the counter value a 0
	while (__HAL_TIM_GET_COUNTER(&htim12) < s*2500);
}

/* USER CODE END 4 */
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
