juppy10/HV_BMS/(commit log)

2021-06-29 Changed cell monitoring IC
    [Balance_Circuit.SchDoc, HV_BMS.PrjPcb, HV_BMS_PCB_LIB.PcbLib, HV_BMS_SCH_LIB.SchLib, HV_BMS_Slave1.SchDoc, LTC6812-1.SchDoc, Temp_Sense.SchDoc]
2021-06-29 Removed files
    [asdasdasd.PcbDoc]
2021-06-29 Added 3D parts folder
    [User Library-LQFP64_Grid_0_5.STEP, User Library-SSOP16.step, c-1-84952-3-a-3d.stp, c-84952-6-a-3d.stp, c-84952-7-a-3d.stp]
2021-06-29 Added documents
    [LTC6812-1 Pins.xlsx]
2021-06-30 Added isoSPI hardware
    [HV_BMS.PrjPcb, HV_BMS_PCB_LIB.PcbLib, HV_BMS_SCH_LIB.SchLib, HV_BMS_Slave1.SchDoc, ISO_COMMS.SchDoc, LTC6812-1.SchDoc, SM91501ALE.STEP]
2021-07-01 Temp sense added
    [AFE.SchDoc, Balance_Circuit.SchDoc, HV_BMS.PrjPcb, HV_BMS_PCB_LIB.PcbLib, HV_BMS_SCH_LIB.SchLib, HV_BMS_Slave.SchDoc, HV_BMS_Slave1.SchDoc, ISO_COMMS.SchDoc]
2021-07-04 Started master board
    [ADC.SchDoc, BMS_Master.PrjPcb, CAN.SchDoc, MCU.SchDoc, PcbLib1.PcbLib, Power_Supply.SchDoc, Schlib1.SchLib]
2021-08-16 All comps placed
    Need to verify schematic.
    Need to double check voltage tap pins.
    [AFE.SchDoc, HV_BMS_PCB_LIB.PcbLib, HV_BMS_SCH_LIB.SchLib, HV_BMS_Slave.SchDoc, ISO_COMMS.SchDoc, LTC6812-1.SchDoc, Temp_Sense.SchDoc]
2021-08-23 Added AMS
    [ADC.SchDoc, AMS BOM.xlsx, Accumulator_MGMT_Sys.PrjPcb, BMS_Master.PrjPcb, BSPD.SchDoc, CAN.SchDoc, Isolated Power.SchDoc, LTC6812-1.SchDoc]
2021-08-23 Changed FPC connectors
    [0466.500NR.stp, Balance_Circuit.SchDoc, HV_BMS_PCB_LIB.PcbLib, HV_BMS_Slave.SchDoc, LTC6812-1.SchDoc]
2021-08-24 Added some notes
    Still need to go through all of Ben's recommendations
    [AFE.SchDoc, Balance_Circuit.SchDoc, HV_BMS_PCB_LIB.PcbLib, HV_BMS_SCH_LIB.SchLib, HV_BMS_Slave.SchDoc, ISO_COMMS.SchDoc, LTC6812-1.SchDoc, Temp_Sense.SchDoc]
2021-08-25 Iso comms on AMS
    [Accumulator_MGMT_Sys.PrjPcb, Isolated Comms.SchDoc, Isolated Power.SchDoc, LTC6820HMS#PBF.PcbLib, LTC6820HMS#PBF.SchLib, PCBLib.PcbLib, PCHLib.SchLib]
2021-08-30 Annotated schematics
    Ready for layout
    [AFE.SchDoc, Balance_Circuit.SchDoc, HV_BMS_Slave.SchDoc, ISO_COMMS.SchDoc, LTC6812-1.SchDoc, Temp_Sense.SchDoc]
2021-09-01 Started layout and adjusted title block
    [AFE.SchDoc, Balance_Circuit.SchDoc, HV_BMS.PrjPcb, HV_BMS_SCH_LIB.SchLib, HV_BMS_Slave.SchDoc, ISO_COMMS.SchDoc, LTC6812-1.SchDoc, Slave_LHS.PcbDoc]
2021-09-04 Temp sense layout V1?
    [Balance Circuit placement.xlsx, LTC6812-1.SchDoc, Slave_LHS.PcbDoc, Temp_Sense.SchDoc]
2021-09-07 Temp sensor layout
    [Balance Circuit placement.xlsx, HV_BMS.PrjPcb, HV_BMS_PCB_LIB.PcbLib, LTC6812-1.SchDoc, Slave_LHS.PcbDoc, Temp_Sense.SchDoc]
2021-09-21 Rev 1 layout
    [Balance Circuit placement.xlsx, Copy of Slave_LHS.PcbDoc, HV_BMS_PCB_LIB.PcbLib, HV_BMS_SCH_LIB.SchLib, HV_BMS_Slave.SchDoc, LTC6812-1.SchDoc, Temp_Sense.SchDoc]
2021-10-11 Added sim and other shidd
    [ISO_COMMS.SchDoc, IsoComms.SchDoc, LTC6812-1.SchDoc, LTC6820_DevBoard.PcbDoc, Master_Test_Board.PrjPcb]
2021-11-24 Neatened up schematics and added individual PS
    [ADC.SchDoc, Accumulator_MGMT_Sys.PrjPcb, BSPD.SchDoc, CAN - STM32F4.SchDoc, Current Sense - AMS.SchDoc, Independent Power Supply - AMS.SchDoc, Isolated Comms.SchDoc, Latching - AMS.SchDoc]
2021-12-11 Latching circuit done
    [Accumulator_MGMT.SchDoc, Accumulator_MGMT_Sys.PrjPcb, BSPD - AMS.SchDoc, Battery Mgmt Sys - AMS.SchDoc, CAN - STM32F4.SchDoc, Connectors - AMS.SchDoc, Current Sense - AMS.SchDoc, Independent Power Supply - AMS.SchDoc]
2021-12-11 PDOC Done
    [AMS.PcbDoc, Accumulator_MGMT.SchDoc, BSPD - AMS.SchDoc, PCBLib.PcbLib, PDOC - AMS.SchDoc]
2021-12-11 RHS of board layout mostly done
    [AMS.PcbDoc, Accumulator_MGMT.SchDoc, Accumulator_MGMT_Sys.PrjPcb, BSPD - AMS.SchDoc, Battery Mgmt Sys - AMS.SchDoc, Connectors - AMS.SchDoc, PCBLib.PcbLib, PCHLib.SchLib]
2021-12-11 More work on RHS?
    [AMS.PcbDoc, Accumulator_MGMT_Sys.PrjPcb, CAN - STM32F4.SchDoc, Connectors - AMS.SchDoc, Current Sense - AMS.SchDoc, Isolated Comms - AMS.SchDoc, LVR - AMS.SchDoc, Latching - AMS.SchDoc]
2021-12-12 RHS to external done?
    [AMS.PcbDoc, Connectors - AMS.SchDoc, Latch - AMS.SchDoc, PDOC - AMS.SchDoc]
2021-12-20 layout happening
    [Accumulator_MGMT.SchDoc, Accumulator_MGMT_Sys.PrjPcb, Battery Mgmt Sys - AMS.SchDoc, CAN - STM32F4.SchDoc, Connectors - AMS.SchDoc, Current Sense - AMS.SchDoc, Independent Power Supply - AMS.SchDoc, Isolated Comms - AMS.SchDoc]
2022-01-01 Finished AMS started slave
    [AMS BOM OLD.xlsx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]
2022-02-01 schematic bugs fixed
    [BMS Slave V0.1.PrjPcb, BMS Slave V0.1.SchDoc, Balance V0.1.SchDoc, Cell Monitor 12S V0.1.SchDoc, Cell Monitor 8S LHS V0.1.SchDoc, Cell Monitor 8S RHS V0.1.SchDoc, IsoSPI V0.1.SchDoc, NTC Sense V0.1.SchDoc]
2022-02-06 8S voltage sense layout done
    [2022 PT Segment Internal Structure Assembly.STEP, BMS Slave V0.1.PrjPcb, BMS Slave V0.1.SchDoc, BMS_Slave V0.1.step, Balance V0.1.SchDoc, Cell Monitor 12S V0.1.SchDoc, Cell Monitor 8S LHS V0.1.SchDoc, Cell Monitor 8S RHS V0.1.SchDoc]
2022-02-19 added stiching vias
    [BMS Slave V0.1.PrjPcb, FootprintLib.PcbLib, Temperature Sensing 8S V0.1.SchDoc]
2022-02-26 More edits
    [BMS Slave V0.1.PrjPcb, BMS Slave V0.1.SchDoc, Balance V0.1.SchDoc, Cell Monitor 12S V0.1.SchDoc, Cell Monitor 8S LHS V0.1.SchDoc, Cell Monitor 8S RHS V0.1.SchDoc, IsoSPI V0.1.SchDoc, NTC Sense V0.1.SchDoc]
2022-02-27 ioc setup
    [0466.500NR.stp, 2022 PT Segment Internal Structure Assembly.STEP, AFE.SchDoc, BMS_Slave V0.1.step, BMS_Slave_12S V0.1.PrjPcb, BMS_Slave_12S V0.1.SchDoc, BMS_Slave_8S V0.1.PcbDoc, BMS_Slave_8S V0.1.PrjPcb]
2022-03-15 firmware things
    [BMS Slave V0.1.GBL, BMS Slave V0.1.GBO, BMS Slave V0.1.GBP, BMS Slave V0.1.GBS, BMS Slave V0.1.GM1, BMS Slave V0.1.GTL, BMS Slave V0.1.GTO, BMS Slave V0.1.GTP]
2022-03-22 lets go
    [Alt balance.csv, both balance.csv, data.csv, data.xlsx, data1.xlsx, data2.xlsx, three balance.csv]
2022-03-23 insertion sort added
2022-03-26 balance working - needs improvement
    [data.csv]
2022-03-27 balance done - requires further testing
    [data.csv]
2022-03-29 Balance done?
    [data - Copy (2).csv, data - Copy.csv, data.csv, long.csv]
2022-04-03 Temp sensing working
    [data.csv, temperature Data.xlsx]
2022-04-03 Improved logging ability and took more logs
    [data.csv, temperature Data 2.xlsx, temperature Data 3.xlsx]
2022-04-22 Gerbers & SoC algorithm
    [1.DXF, 2.DXF, 3.DXF, 4.DXF, 5.DXF, 6.DXF, BMS Slave V0.1.SchDoc, Balance V0.1.SchDoc]
2022-04-25 Hi Roarke
    [UV-OV Fault test 2.xlsx, UV-OV Fault test.csv, data.csv]
2022-05-19 Thesis adjustments
    [Accumulator_MGMT_Sys-BOM.xlsx, Balance_Charge_preVoltage.csv, Bill of Materials-BMS Slave V0.1(Manufacture) - Thesis.xlsx, Latch - AMS.SchDoc, PDOC - AMS.SchDoc, SoC - Power supply 2.csv, SoC - Power supply 2.xlsx, UV-OV Fault test 2.xlsx]
